SigGearDrive/SigGear-product-docs/data/content/youtube/README.md

# SigGear YouTube content production

The immediate focus is the **micro / miniature / compact planetary gearbox** range (8–42 mm), not an unsupported robot-joint market-positioning claim.

## Prepared, not yet uploaded

- [8–42 mm planetary gearbox series overview — full voiceover, shooting order and metadata](8-42mm-planetary-overview-production-2026-10-14.md)
- [Gearbox Only vs Motor + Gearbox — OEM engineering explainer and follow-on videos](motor-plus-planetary-gearbox-production-2026-10-14.md)

## Truthful release steps

1. Record only real SigGear products, real mechanical details, approved engineering references and genuine manufacturing/inspection footage.
2. Confirm all visible diameter labels against the actual filmed model.
3. Do not imply that a pictured motor has already been validated with a particular gearbox unless the engineering team has confirmed that configuration.
4. Complete the video, subtitles, thumbnail and URL checks; then publish through the actual YouTube channel.
5. Add the **published YouTube video URL** to the production pack and five-channel weekly report. Do not mark scripts as released videos.

Existing GitHub assets and published specifications remain sources of truth; the content packs deliberately do not invent torque values or customer examples.
