SigGearDrive/SigGear-product-docs/data/operations/five-channel-weekly-report-2026-10-14.md

# SigGear five-channel overseas acquisition weekly report — baseline

**Prepared on:** 2026-10-14 · **Reporting week:** 2026-10-05 to 2026-10-11 (Mon–Sun) · **Comparison week:** 2026-09-28 to 2026-10-04 · **Target:** genuine overseas miniature/compact planetary gearbox Design-In inquiries

**Channel scope:** GitHub product docs, Google Search, TraceParts, YouTube, DirectIndustry. Instagram and TikTok have separate operating roles and are not included in this five-channel report.

**Reporting policy:** this channel report follows `data/sales/weekly-attribution-review-sop.yml` and `data/sales/attribution-kpi-schema.yml`. Google search appearance, website sessions, YouTube views, native CAD downloads, and real RFQs are **different funnel stages**. Do not add them as interchangeable 'leads'. Sales qualified projects require a separately verified pipeline record.

## 1. Measured comparison (connected sources)

| Metric | Prior complete week Sep 28–Oct 4 | Complete week Oct 5–11 | Interpretation |
| --- | ---: | ---: | --- |
| Google Search Console impressions (all indexed site pages) | 355 | 32 | The sample is small and site traffic is still strongly influenced by older robot-joint pages; do not infer the effect of recent planetary releases from this short period. |
| Google Search Console clicks | 6 | 4 | Click count did not track the same percentage change as impression count; small data. |
| YouTube video views (whole connected channel) | 6,174 | 821 | Lower channel exposure compared to a week with high-performing robot content; evaluate video/topic differences, not raw volume alone. |
| YouTube subscribers gained | 13 | 2 | Not a proxy for gearbox RFQs. |
| YouTube estimated minutes watched | 681 | 92 | Channel-wide, not planetaries only. |
| GA4 sessions (whole site) | 2 | 1 | Too small to infer a conversion rate. |
| GA4 engaged sessions | 1 | 1 | GA4's engaged-session rules apply; not an inquiry. |

**Source-revision note:** the existing `data/sales/weekly-attribution-review-sop.yml` was captured earlier with **31** impressions for 2026-10-05–11. The **2026-10-14** Search Console connector refresh returned **32** impressions for the same calendar week. This report preserves the latest observed value without rewriting the earlier baseline; Google Search Console can revise recent rows.

**Data connector & accounts:** Windsor.ai `searchconsole`: `https://siggeardrive.github.io/SigGear-product-docs/`; `youtube`: `51467`; `googleanalytics4`: property `547548249` (SigGear Product Documentation). Dates requested explicitly by channel. The latest displayed Search Console/YouTube daily records currently end on 2026-10-11. Data may be revised or delayed by source. The 2026-10-12 to 2026-10-14 activity is therefore not included in the completed-week numerical comparison.

## 2. Five-channel operational scorecard

| Channel | Discovery / usage measured | Acquisition / inquiry evidence | Status as of Oct 14 | Next action |
| --- | --- | --- | --- | --- |
| **GitHub product docs** | GA4 whole-site sessions: **1** in reporting week; **not** a per-product acquisition count | Real qualified gearbox inquiries through the site **not independently verified** | Twelve 8P–42P product pages, datasheets, mechanical reference and public simplified four-stage STEP available; twelve GitHub → exact TraceParts English model links deployed | Keep existing canonical pages stable, fix stale TraceParts wording, and test product-level email/brief CTAs |
| **Google Search** | 32 impressions, 4 clicks in reporting week (whole site) | GSC is discovery, not a received project | 12 planetary model pages indexed/discovered unevenly; brand and legacy robot-intent queries still dominate | Monitor 12 product canonicals and diameter/STEP/gearbox-only search queries; optimize existing pages only after evidence |
| **TraceParts** | 12/12 international English STEP AP203 generation/download **operator QA on Oct 14**, outside reporting-week window | **Native external engineer CAD download volume and identifiable leads unavailable**; do not count operator self-tests as prospects | TraceParts publishing correction email already sent; awaiting staff response for English title taxonomy, outbound GitHub UTM, RFQ/Analytics access | Wait for response, then test actual platform → model GitHub UTM and request native model-level lead report |
| **YouTube** | 821 channel views, 92 minutes and 2 subscribers gained in reporting week | No confirmed YouTube-origin qualified planetary inquiry in available connected data | Authentic gear/robot videos already published; dedicated 8–42 mm overview and motor-matching production packs drafted, **not filmed/uploaded** | Shoot genuine size-lineup overview and one existing-motor selection video; link to specific engineering pages with UTM |
| **DirectIndustry** | No published product pages or listing analytics yet | No DirectIndustry leads because listings not yet launched | Official exhibitor request successfully received Oct 14; waiting for consultant; English drafts for 10P, 20P, 32P, 42P ready | Wait for quote and confirm four-vs-twelve listings, categories, RFQ access and plan terms, without new submission |

## 3. Planetary SEO quality baseline

**Last 28 days queried:** 2026-09-16 to 2026-10-14 (latest Search Console data may lag). The returned GSC `page` rows total 19 pages, with 771 impressions and 19 clicks **among the returned rows**. Exactly three planetary-model URLs appeared in the returned rows:

| Product page | Impressions | Clicks |
| --- | ---: | ---: |
| 42P | 3 | 0 |
| 16P | 1 | 0 |
| 22P | 1 | 0 |

The three returned planetary model pages therefore represent **five observed impressions and zero clicks**. **This does not prove the other nine pages are not indexed.** The query dimension still largely surfaces robotics/joint intent; exact diameter + planetary search terms were not present in the 49 returned query rows. Do not label a missing exact query as a numeric ranking.

## 4. YouTube evidence-based content selection

- In the same 28-day connector window, the real `32mm Planetary Gearbox Internal Structure in Motion` video (`https://www.youtube.com/watch?v=KIzpRMw7r_U`) has **565 views** and **0 reported subscribers gained** in its video row.
- The existing `Inside the SG80-21 Robot Joint Module | Planetary Gear Structure` video (`https://www.youtube.com/watch?v=_gG54yuV28o`) has **3,650 views** and **11 reported subscribers gained**. This is evidence of robot audience attention, **not** evidence those viewers want miniature OEM gearboxes.
- The next video should introduce **8–42 mm miniature/compact planetary gearboxes as an engineering family** with genuine product size reference, public documents, and a clear gearbox-only vs motor-matching route, rather than only promoting a robot joint.
- **Prepared production packs:** `data/content/youtube/8-42mm-planetary-overview-production-2026-10-14.md` and `data/content/youtube/motor-plus-planetary-gearbox-production-2026-10-14.md`. Both are editorial outputs; neither implies a video was actually uploaded.

## 5. Confirmed inquiry and conversion boundaries

- GA4 website sessions, CAD link clicks, `mailto:` preparations and YouTube views **are not confirmed customer requests**.
- TraceParts operator's 12 successful CAD download tests **are not 12 leads**.
- TraceParts native CAD analytics, YouTube external link referrals, and DirectIndustry lead reports remain unverified or unavailable.
- The customer pipeline has not been audited in this report: **qualified leads by these five acquisition channels = not confirmed, not assumed to be zero**.
- Only attribute an inquiry to a channel if platform lead evidence, reliable UTM/referrer, or the customer explicitly confirms how they found SigGear, following `data/sales/attribution-kpi-schema.yml`.

## 6. Next work block (priority)

1. **Film** the real product 8–42 mm overview, prioritizing actual model identification and truthful technical selection; upload with three specified tracked links.
2. **Film** the Motor + Planetary Gearbox existing-motor engineering explainer; link to the canonical motor-matching guide and path-specific inquiry briefs.
3. **Correct** the outdated GitHub series landing-page sentence saying the twelve TraceParts model-specific URL links remain pending; they are now live.
4. **Observe** GSC product-page impressions for the twelve model pages with a consistent date window and latest-data cutoff. No keyword stuffing or duplicate SEO landing pages.
5. **Wait** for TraceParts title/UTM response and DirectIndustry consultant; record their replies once received, without sending duplicate applications.

## Data QA and next reporting run

**Next planned operating review:** after 2026-10-18, compare 2026-10-12–18 to 2026-10-05–11 once platform data has arrived. If GA4 or GSC does not yet expose the full week, mark the partial data explicitly rather than treating zeros as final. The broader formal weekly company meeting summary may use a different user-defined reporting period; this document is specifically for weekly channel metrics.
