SigGearDrive/SigGear-product-docs/docs/applications/optical-imaging-camera-module-gear-motors.md

---
title: Optical, Imaging and Camera Module Gear Motors | SigGear
description: Select compact gear motors for focus, zoom, aperture, filter-wheel, pan-tilt, scanning and sensor-positioning mechanisms by backlash, vibration, noise, speed and feedback requirements.
---

# Optical, Imaging and Camera Module Gear Motors

## Application Overview

Optical, imaging and camera module systems often use compact gear motors and precision transmission components for focus adjustment, zoom movement, aperture control, filter-wheel rotation, shutter mechanisms, pan-and-tilt axes, scanning mechanisms, sensor positioning, lens-cover movement, calibration axes and small inspection-device motion.

These applications usually require compact size, smooth low-speed motion, repeatable positioning, low backlash, low vibration, low acoustic noise and stable operation under intermittent or precision-duty cycles. In many projects, the motor and gearbox must also be reviewed together with optical sensitivity, vibration transfer, cable routing, thermal behavior, dust exposure, outdoor sealing, feedback requirements and production alignment methods.

SigGear can evaluate micro gear motors, compact planetary gearboxes, flat BLDC motors and customized motor/gearbox assemblies for camera modules, imaging instruments, machine-vision devices, inspection equipment, optical readers, sensor modules, security cameras and compact optical mechanisms. Final model selection, optical-system validation, image-quality responsibility and production approval must be confirmed case by case.

## Important Application Boundary

Optical and imaging equipment performance depends on the full optical, mechanical, electronic and software system. This page provides preliminary actuator-selection guidance only.

Unless explicitly confirmed in writing, SigGear does not assume responsibility for:

- Image quality or optical performance
- Autofocus algorithm performance
- Camera calibration accuracy
- Machine-vision inspection accuracy
- Medical imaging validation
- Security-system certification
- Outdoor camera sealing validation
- Full-machine EMC or electrical safety approval
- Full-device environmental qualification
- Final production approval for the customer system

The customer should define the optical performance target, calibration process, vibration sensitivity, operating environment and system-level validation plan before production approval.

## Key Selection Factors

| Requirement | Why it matters |
| --- | --- |
| Motion function | Focus, zoom, aperture, filter wheel, pan-tilt and scanning axes require different torque-speed profiles. |
| Backlash and repeatability | Optical positioning can be sensitive to lost motion and mechanical hysteresis. |
| Vibration and ripple | Motor vibration may affect image stability, focus accuracy or measurement repeatability. |
| Acoustic noise | Camera modules, medical instruments and office devices may require quiet operation. |
| Size and mass | Lens modules, camera heads and compact instruments often have strict envelope limits. |
| Feedback requirement | Encoder, Hall sensor, limit switch, homing switch or current-based detection may be needed. |
| Cable routing | Moving camera heads and gimbals may require controlled cable exit and strain relief. |
| Thermal behavior | Heat near lenses, sensors or optics may affect focus drift or image stability. |
| Dust and environment | Outdoor cameras, inspection stations and optical readers may need dust or moisture review. |
| Production alignment | Custom shafts, mounting tolerances and repeatable assembly affect optical calibration. |

## Common Optical, Imaging and Camera Module Use Cases

### Lens Focus Adjustment

Camera modules, optical readers, microscopes, inspection systems and imaging instruments may use miniature gear motors for lens focus adjustment. Provide lens mass, travel distance, screw pitch or cam geometry, speed, positioning accuracy, backlash target, noise target, vibration sensitivity, homing method and expected duty cycle.

### Zoom Lens Movement

Zoom lenses and variable optical modules may require gear motors to move lens groups, cams, barrels or sliding optical assemblies. Provide lens load, travel range, torque, speed, repeatability target, allowable backlash, operating orientation, cable-routing constraints and whether motion occurs during imaging.

### Aperture, Shutter and Iris Mechanisms

Optical devices may use compact motors for aperture blades, shutter movement, iris control, light blocking, exposure control or protective shutters. Provide rotation angle, required torque, response time, repeatability, noise target, power-off behavior, life-cycle requirement and jam condition.

### Filter Wheel and Optical Selector Mechanisms

Diagnostic readers, imaging instruments, spectrometry devices, inspection systems and optical measurement devices may use gear motors to rotate filter wheels, color wheels, prisms, shutters, mirrors or optical selectors. Provide wheel diameter, inertia, number of positions, indexing accuracy, allowable vibration, speed, homing method and duty cycle.

### Pan, Tilt and Gimbal Axes

Security cameras, machine-vision heads, inspection cameras, sensor pods and compact gimbals may require gearboxes for pan, tilt or limited-angle positioning. Provide camera head mass, center-of-gravity offset, rotation range, speed, acceleration, holding torque, backlash target, cable routing, outdoor exposure and power-off behavior.

### Scanning and Sensor Positioning Mechanisms

Barcode readers, document scanners, laser modules, LiDAR support mechanisms, inspection sensors and positioning devices may use small gear motors to move mirrors, sensors, carriages, sliders or scanning assemblies. Provide travel distance, load, speed profile, repeatability, vibration sensitivity, guide mechanism, feedback method and lifetime cycles.

### Lens Cover, Privacy Shutter and Protective Door Movement

Camera modules, security devices, smart hardware and instruments may use gear motors for lens covers, privacy shutters, protective doors, caps and small service mechanisms. Provide cover weight, hinge geometry, seal force, speed, jam condition, manual override, user safety requirement and power-off position.

## Torque, Speed and Positioning Review

Optical and imaging mechanisms should be reviewed under real assembly conditions. Lens friction, guide preload, cable force, seal friction, tilted operation, shock, transport vibration and temperature changes can affect the required torque and repeatability.

Provide:

- Equipment type and actuator function
- Optical mechanism type
- Required continuous torque
- Required peak torque and peak duration
- Required output speed or motion time
- Stroke length or rotation angle
- Positioning accuracy or repeatability target
- Backlash or lost-motion target
- Load mass and center of gravity
- Screw pitch, cam geometry or gear interface
- Operating orientation
- Jam, stall or end-stop condition
- Motion frequency and duty cycle
- Required lifetime cycles or service hours

When exact load data is not available, provide drawings, CAD models, prototype videos, current curves, manual-force measurements or test data from the existing mechanism.

## Voltage, Current and Control Review

Optical and camera systems may use compact DC power supplies, internal control boards, battery packs or customer-designed drivers. Current limit, position control, noise and thermal behavior should be reviewed together.

Clarify:

- Nominal operating voltage
- Minimum and maximum voltage range
- Peak current limit
- Continuous current limit
- Driver supplied by customer or by SigGear
- Control method
- Required speed control or position control
- Feedback requirement
- Homing or limit-switch method
- Stall or end-stop detection method
- Holding torque or brake requirement
- Cable length and routing limit
- Electrical noise or EMC constraints

Do not assume encoder, brake, closed-loop control, CAN, RS485 or a specific protocol unless it is included in the selected motor and driver configuration.

## Noise, Vibration and Image-Stability Review

Optical systems can be sensitive to motor vibration, torque ripple, gearbox noise, backlash and structural resonance. The acceptable level depends on whether the actuator moves during imaging, before imaging, during calibration or only during service operation.

Define:

- Whether motion occurs during image capture or measurement
- Whether vibration affects image stability or focus accuracy
- Allowable acoustic noise target
- Allowable vibration or motion ripple target
- Required repeatability
- Maximum backlash or lost motion
- Acceleration and deceleration profile
- Whether smooth motion is required
- Mounting stiffness and enclosure resonance
- Heat sensitivity near lens or sensor

Low-noise, low-vibration and image-stability performance should be confirmed by prototype testing in the customer optical system.

## Environment, Dust and Outdoor Exposure Review

Camera and optical devices may operate indoors, outdoors, inside instruments, near dust, near oil mist or in equipment with cleaning requirements. The motor location and enclosure design affect the actuator configuration.

Provide:

- Indoor, outdoor or enclosed-equipment use
- Dust, moisture, condensation or cleaning exposure
- Operating temperature range
- Storage temperature range
- Vibration and shock exposure
- Required ingress protection target
- Cable and connector exposure
- Lens or sensor heat-sensitivity requirement
- Maintenance and replacement plan

The equipment manufacturer should define optical sealing, lens protection, dust control, condensation control, thermal design and environmental validation. SigGear can review motor, gearbox, shaft, cable and connector configuration after the environment is defined.

## Output Shaft, Mounting and Load Support

Optical mechanisms often use custom shafts, pinions, lead screws, worm gears, cams, pulleys, belts, D-cut shafts, miniature flanges and compact brackets. Shaft load, alignment and assembly tolerance should be reviewed early.

Provide:

- Output shaft shape and length
- Gear, pinion, lead screw, worm, cam, pulley, flat, D-cut or custom shaft requirement
- Load direction
- Distance from load point to gearbox face
- Radial and axial load estimates
- Shock, drop or transport-load condition
- Required bearing support
- Flange and mounting hole requirement
- Cable exit direction
- Connector or wire harness requirement
- Assembly tolerance or calibration requirement

External support bearings are recommended when the mechanism creates significant radial load, axial thrust, side load, shock load or belt tension.

## Candidate SigGear Product Families

### Micro Gear Motors

[Micro Gear Motors](../products/micro-gear-motors/index.md) are a starting point for compact focus, zoom, aperture, filter-wheel, shutter, lens-cover and small sensor-positioning mechanisms. SigGear can evaluate miniature planetary gear motors, custom shafts, flanges, cable exits, connectors and optional feedback after engineering review.

### 8-42 mm Planetary Gearboxes

The [8-42 mm planetary gearbox series](../products/planetary-gearboxes/8-42mm-planetary-gear-reducer.md) can be reviewed for compact optical transmission requirements where ratio, torque, size, backlash target and mounting requirements are defined. Final performance depends on frame size, gear stage, material configuration and operating conditions.

### Flat BLDC Motors and Joint Drives

For low-profile camera heads, rotary positioning, compact gimbal axes or limited axial space, [Flat BLDC Motors and Joint Drives](../products/flat-bldc-motors/index.md) may be reviewed together with gearbox or actuator requirements.

## Prototype and Customization Support

Depending on project scope, SigGear can evaluate:

- Gear ratio selection
- Motor and gearbox matching
- Output shaft customization
- Flange and mounting customization
- Cable and connector customization
- Low-voltage motor configuration
- Feedback or sensor integration after review
- Low-noise configuration review
- Low-vibration configuration review
- Low-backlash configuration review
- Customer branding and labeling
- Prototype support before production planning

Optical and imaging projects may require additional review of assembly tolerance, calibration process, vibration transfer, cable routing, production inspection requirements and long-term supply planning.

## Information Needed for Optical, Imaging or Camera Module Review

Please provide one requirement set for each actuator position.

Provide:

- Equipment type and actuator function
- Optical mechanism type
- Prototype, test fixture or production-use target
- Required torque or force
- Peak torque and peak duration
- Required output speed or motion time
- Stroke length or rotation angle
- Positioning accuracy and repeatability target
- Backlash or lost-motion target
- Lens, camera head or sensor load
- Maximum diameter and length
- Operating voltage and current limit
- Driver or control-board responsibility
- Feedback, homing or limit-switch requirement
- Noise and vibration target
- Whether motion occurs during imaging or measurement
- Dust, moisture, outdoor or cleaning exposure
- Operating temperature range
- Shaft, flange and mounting requirements
- Cable exit and connector requirements
- Duty cycle and lifetime target
- Validation, calibration or inspection requirements
- Prototype quantity and estimated annual quantity
- Required customization or OEM branding

## Related Products and Inquiry

[Micro Gear Motors](../products/micro-gear-motors/index.md){ .md-button .md-button--primary }
[8–42 mm Planetary Gearboxes](../products/planetary-gearboxes/8-42mm-planetary-gear-reducer.md){ .md-button }
[Request CAD, Sample and Quote](../request-cad-sample-quote.md){ .md-button }

## Request an Optical, Imaging or Camera Module Gear Motor Review

Send your focus system, zoom module, aperture drive, filter wheel, shutter mechanism, camera pan-tilt axis, sensor-positioning mechanism, scanning assembly, lens-cover device or compact optical actuator requirements to SigGear for preliminary model evaluation. Early requirements can be approximate, but actuator function, torque or force, speed, size, voltage, current limit, precision target, environment, duty cycle, validation boundary and quantity are needed before a meaningful recommendation can be made.

**Wanrong Wang**  
International Sales, SigGear  
[wangwanrong@siggear.com](mailto:wangwanrong@siggear.com)

[Send Optical, Imaging or Camera Module Gear Motor Requirements](../contact.md){ .md-button .md-button--primary }
