SigGearDrive/SigGear-product-docs/docs/applications/semiconductor-electronics-inspection-equipment-gear-motors.md

---
title: Electronics and Inspection Equipment Gear Motors | SigGear
description: Select compact gear motors and planetary gearboxes for electronics manufacturing, inspection, AOI, test fixtures and small positioning mechanisms by torque, speed, backlash, vibration and duty cycle.
---

# Semiconductor, Electronics and Inspection Equipment Gear Motors

Semiconductor, electronics manufacturing and inspection equipment often uses compact gear motors for controlled feeding, indexing, focusing, fixture adjustment and small-axis positioning. These applications usually require stable motion, compact packaging, low vibration and predictable behavior during repeated production cycles.

SigGear supports engineering review for miniature planetary gear motors, precision gearboxes and compact actuator solutions used in electronics production equipment, inspection fixtures, test instruments and automated handling mechanisms. Final motor, gearbox and interface selection should be confirmed based on load, speed, accuracy, duty cycle, environmental conditions and validation requirements.

## Where Gear Motors Are Used

### PCB Handling and Conveyor Adjustment

Electronics production lines may use compact gear motors for PCB edge conveyors, guide-rail width adjustment, board transfer mechanisms, stop pins, gates, lifts and small indexing modules.

Typical selection factors include:

- Board size and weight
- Conveyor speed or transfer cycle time
- Guide-rail adjustment stroke
- Synchronization with sensors or upstream equipment
- Jam behavior during misfeed or board contact
- Duty cycle during production shifts
- Available space around the conveyor frame

For guide-rail and width adjustment, holding torque, backlash, end-stop behavior and manual adjustment requirements should be reviewed together.

### AOI, Vision Inspection and Camera Positioning

Automated optical inspection systems, vision stations and compact inspection cells may use gear motors for camera focus, lens movement, lighting angle adjustment, mirror movement, filter wheels, turntables and small pan-and-tilt axes.

Important factors include:

- Repeatability of the inspection position
- Backlash and lost motion
- Vibration during image capture
- Motor noise in laboratory or office environments
- Position feedback requirements
- Cable routing around camera or light modules
- Thermal influence on optical stability

For image-sensitive systems, the motor and gearbox should be evaluated together with the optical module, mounting stiffness and control profile.

### Probe, Test Fixture and Contact Mechanisms

Electronics test equipment may use small gear motors for fixture movement, probe height adjustment, contact pressure control, connector insertion assistance, tray clamping and test socket actuation.

Selection should consider:

- Contact force or fixture force
- Motion speed before and after contact
- Repeatable stopping behavior
- Peak load during connector engagement
- Risk of over-travel or product damage
- Whether position feedback, current sensing or torque limiting is required
- Service life under repeated test cycles

Gear motors for test fixtures should be validated with the real probe, spring, connector or clamping mechanism.

### Tray, Carrier and Pallet Movement

Compact gear motors can be used in tray loaders, carrier transfer systems, small pallet shuttles, magazine mechanisms, feeder modules and sample holders.

Key factors include:

- Tray mass and center of gravity
- Stroke length or rotation angle
- Acceleration and deceleration profile
- Guide rail friction
- Impact at mechanical stops
- Required holding force
- Position repeatability after each cycle

If the tray or pallet carries valuable parts, the system should include suitable mechanical stops, limit detection and safe recovery logic.

### Wafer, Component and Small-Part Handling Support

Some semiconductor and electronics equipment uses compact motion axes to assist non-critical handling, cover movement, shield adjustment, sensor positioning, small valves, shutters, holders or auxiliary mechanisms.

For semiconductor-adjacent projects, qualification boundaries must be clear. Cleanliness, particle generation, vacuum compatibility, chemical exposure, static electricity control and process validation are application-level responsibilities unless they are specifically defined and reviewed in the engineering specification.

### Laser, Marking and Dispensing Equipment

Laser marking, solder paste dispensing, adhesive dispensing, conformal coating and small production tools may use gear motors for shutter movement, nozzle positioning, platform indexing, cover actuation, focus adjustment and fixture rotation.

Important factors include:

- Motion smoothness during positioning
- Repeatability before process execution
- Heat exposure near the process zone
- Dust, fumes, adhesive or solvent exposure
- Speed required between process stations
- Holding torque during marking or dispensing
- Maintenance access after contamination

### Laboratory Electronics and R&D Fixtures

R&D benches, small test rigs and laboratory fixtures often need compact gear motors for repeatable motion without building a full industrial servo axis.

Typical examples include:

- Small rotary stages
- Sensor positioning fixtures
- Connector durability testers
- Miniature endurance test rigs
- Adjustable camera or light brackets
- Prototype handling mechanisms
- Compact automated measurement tools

For these cases, the first evaluation should focus on load, movement cycle, positional tolerance, required life and available mounting space.

## Gear Motor Selection Priorities

### Smooth Low-Speed Motion

Inspection and test equipment often moves slowly to protect components and improve positioning control. The gearbox ratio, motor speed range and controller profile should support stable low-speed movement without excessive vibration or stall risk.

### Backlash and Repeatability

Backlash directly affects focus adjustment, fixture position, indexing and measurement repeatability. The acceptable backlash depends on mechanism geometry and should be translated into output shaft or end-effector tolerance.

### Low Vibration

Vibration can affect camera images, laser alignment, probe contact and small-part placement. Motor mounting, gearbox precision, load inertia and acceleration profile should be reviewed as a system.

### Low Noise

Inspection equipment, desktop test devices and laboratory instruments may operate near engineers or operators. Noise expectations should be described using the actual working distance, duty cycle and enclosure conditions.

### Compact Packaging

Electronics equipment often has tight internal layouts. Selection should consider motor diameter, gearbox length, wire exit direction, connector location, mounting holes, shaft length and available service space.

### Duty Cycle and Heat

Production equipment may run continuously or with frequent indexing cycles. Thermal review should include load torque, operating speed, ambient temperature, enclosure airflow and stop-hold conditions.

### Stall, Jam and End-Stop Behavior

Small mechanisms may encounter misfed boards, stuck trays, closed covers or incorrect operator loading. The design should define stall current, current limit, timeout, torque limit and recovery behavior.

### Feedback and Control

Depending on the axis, a simple DC gear motor may be sufficient, or the system may need encoder feedback, limit switches, hall sensors, current sensing or closed-loop speed and position control.

## Product Family Mapping

### Micro and Small Planetary Gear Motors

Small planetary gear motors are commonly considered for compact electronics fixtures, inspection modules and small adjustment axes where diameter, output speed and packaging are important.

Possible review points:

- 8 mm to 42 mm gearbox diameter range
- Ratio and output speed target
- Shaft type and mounting interface
- Encoder or sensor requirement
- Expected production quantity

Relevant product pages:

- [8-42 mm planetary gear reducer series](../products/planetary-gearboxes/8-42mm-planetary-gear-reducer.md)
- [8P planetary gearbox](../products/planetary-gearboxes/8p-planetary-gearbox.md)
- [10P planetary gearbox](../products/planetary-gearboxes/10p-planetary-gearbox.md)
- [12P planetary gearbox](../products/planetary-gearboxes/12p-planetary-gearbox.md)
- [16P planetary gearbox](../products/planetary-gearboxes/16p-planetary-gearbox.md)
- [20P planetary gearbox](../products/planetary-gearboxes/20p-planetary-gearbox.md)

### Larger Planetary Gearboxes

For conveyor adjustment, tray handling, pallet movement or heavier fixture actuation, larger planetary gearboxes may be considered when higher torque or stronger shaft support is needed.

Review items include:

- Required continuous torque
- Peak torque during jam or acceleration
- Radial and axial load on the output shaft
- Output speed and duty cycle
- Gearbox mounting orientation
- Manual override or brake requirement

### Precision Gearbox and Custom Interface Options

Some inspection and electronics mechanisms need a custom shaft, flange, gear interface, pulley interface, lead-screw coupling or compact mounting arrangement. Customization should be reviewed with drawings and expected quantity.

Custom review may include:

- Output shaft diameter and flat/D-cut/keyway requirements
- Mounting hole pattern
- Gear, pulley or lead-screw interface
- Encoder mounting
- Wire harness and connector direction
- Material and surface treatment requirements
- Noise and backlash target

## Application Review Checklist

Please provide the following information for engineering review:

- Equipment type and axis function
- Required output torque
- Peak torque and peak duration
- Output speed or motion time
- Rotation angle, stroke or travel range
- Required positioning accuracy and repeatability
- Backlash tolerance at the output or end effector
- Load mass, friction and guide mechanism
- Radial and axial load on the output shaft
- Duty cycle and expected service life
- Operating voltage and available current
- Encoder, sensor or limit switch requirements
- Controller type and communication requirements
- Ambient temperature and enclosure conditions
- Exposure to dust, flux, adhesive, solvent, heat or process fumes
- Maximum motor diameter, length and weight
- Prototype quantity and estimated annual volume

## Semiconductor and Clean-Process Boundary

If the gear motor will be used near semiconductor process equipment, please specify the process location and environmental requirements. Cleanroom grade, particle generation, outgassing, vacuum compatibility, ESD control, chemical resistance and process safety requirements must be reviewed explicitly.

SigGear can support mechanical and transmission selection, but final qualification for semiconductor or clean-process equipment must be completed by the equipment manufacturer according to the full system requirements.

## Common RFQ Examples

### PCB Conveyor Width Adjustment

A customer may need a compact motorized guide-rail adjustment module for different PCB widths. The key information is rail load, screw pitch, required adjustment speed, holding requirement, limit switch design and available motor space.

### AOI Camera Focus Adjustment

A customer may need a small low-vibration gear motor for camera focus or lens positioning. The key information is travel range, repeatability, backlash tolerance, speed, noise target and whether encoder feedback is required.

### Test Fixture Clamp Actuation

A customer may need a motorized clamp or probe contact mechanism. The key information is clamping force, contact stroke, peak load, cycle time, product protection logic and required service life.

### Tray Indexing Module

A customer may need a small gear motor to rotate or move a tray between inspection positions. The key information is tray mass, inertia, indexing angle, position tolerance, acceleration profile and holding torque.

## Related Application Pages

- [Industrial automation servo planetary gearboxes](./industrial-automation-servo-planetary-gearboxes.md)
- [Precision instruments and optical mechanisms](./precision-instruments-optical-mechanisms.md)
- [Optical, imaging and camera module gear motors](./optical-imaging-camera-module-gear-motors.md)
- [Laboratory automation and diagnostic equipment gear motors](./laboratory-automation-diagnostic-equipment-gear-motors.md)
- [Packaging, labeling and conveyor gear motors](./packaging-labeling-conveyor-gear-motors.md)
- [Micro robotics gear motors](./micro-robotics-gear-motors.md)

## Contact

For semiconductor, electronics manufacturing and inspection equipment gear motor selection, please send your drawings, load requirements, target speed, accuracy requirements and expected quantity to [Wanrong Wang](../contact.md).

You can also include the axis function, available space, duty cycle, environmental exposure and validation requirements so that the engineering review can match the motor, gearbox, shaft and mounting interface more accurately.
