SigGearDrive/SigGear-product-docs/docs/applications/precision-instruments-optical-mechanisms.md

---
title: Precision Instrument Gear Motors and Optical Mechanism Drives | SigGear
description: Select gear motors and compact planetary gearboxes for precision instruments and optical mechanisms by torque, speed, backlash, repeatability, vibration, feedback and shaft-load requirements.
---

# Gear Motors for Precision Instruments and Optical Mechanisms

## Application Overview

Precision instruments, optical systems, inspection equipment and laboratory positioning platforms often use compact geared motion for focus adjustment, zoom mechanisms, filter wheels, rotary stages, pan-and-tilt axes, aperture control, sensor positioning and small indexing mechanisms. A precision instrument gearbox or optical adjustment actuator should be selected from the complete motion system, not from torque or size alone.

These applications often require smooth low-speed motion, repeatable positioning, low backlash, low vibration, low acoustic noise and predictable behavior after direction reversal. The completed mechanism depends on the motor, gearbox, encoder, bearings, preload, structure, calibration method and control system working together.

SigGear supplies micro gear motor, miniature planetary gearbox and flat BLDC motor solutions that can be evaluated for precision instrument and optical mechanism projects. Final motor, reduction ratio, shaft, bearing, feedback and mounting configurations are confirmed after engineering review.

This page is intended for early-stage supplier comparison, model shortlisting and engineering communication. Final selection, quotation and technical agreement require confirmation against the approved drawing, selected ratio, load condition, motion profile, feedback architecture and ordered version.

## Key Selection Factors for Precision Motion

| Requirement | Why it matters |
| --- | --- |
| Motion function | Focus, zoom, aperture, filter-wheel and rotary-stage mechanisms have different torque-speed cycles. |
| Travel range and resolution | Defines gear ratio, encoder requirement, limit strategy and control method. |
| Positioning accuracy | Depends on the complete mechanical and control stack, not only gearbox backlash. |
| Repeatability and settling | Important for imaging, inspection, optical alignment and sensor pointing. |
| Backlash and reversal | Direction changes can affect final position, focus repeatability and indexing behavior. |
| Radial, axial and overturning loads | Pulleys, belts, cams, screws and lens groups can overload output bearings. |
| Noise and vibration | Important for imaging stability, laboratory environments and human-facing instruments. |
| Duty cycle and environment | Temperature, humidity, clean conditions and operation frequency affect reliability. |
| Feedback and homing | Encoder location, limit switches and homing strategy determine completed-system behavior. |

## Common Precision Instrument and Optical Use Cases

### Lens Focus Actuators

Lens focusing mechanisms may require smooth low-speed motion, precise position control, low backlash and minimal vibration. Provide lens group mass, guide friction, preload, travel distance, focusing speed, required repeatability and whether motion is one-directional or frequently reversed.

### Zoom and Optical Adjustment Mechanisms

Zoom and optical adjustment mechanisms may use cams, lead screws, belts or gear trains. The motor and gearbox must be reviewed with the complete optical mechanism because preload, friction, sealing and cable forces can change the required torque and speed.

### Filter Wheels and Aperture Drives

Filter wheels, aperture drives and shutter-related mechanisms often require repeatable indexing, compact size, low noise and predictable stopping behavior. Provide the number of positions, indexing angle, inertia, target move time, holding requirement and homing or index detection method.

### Rotary Stages and Small Positioning Axes

Compact rotary stages and small positioning axes may require high repeatability, smooth reversal, low vibration and support for radial or axial loads. If the customer mechanism applies cantilevered load, an external bearing or support structure may be needed.

### Pan-and-Tilt and Sensor Pointing Mechanisms

Pan-and-tilt units, inspection sensors and small pointing mechanisms require a balance between torque, speed, backlash, vibration, cable routing and holding behavior. Provide payload mass, center of gravity, required pointing accuracy, wind or external load if applicable, and whether a brake or holding mode is required.

## Motion Function and Travel Range

Describe the mechanism and required motion, including rotary or linear travel, operating angle, number of turns, indexing positions, end stops and homing method. The transmission should be selected from the complete motion sequence rather than a single speed or torque value.

Useful information includes:

- Rotary angle, stroke or travel distance
- Number of indexing positions
- Required move time
- Required speed range
- Acceleration and deceleration profile
- One-way or bidirectional operation
- End-stop, limit-switch or homing method
- Required position after power cycle

## Torque, Speed and Ratio Selection

Provide continuous torque, peak torque, peak duration, rated speed, maximum speed, acceleration, deceleration and cycle time at the gearbox output. Friction, preload, seals, cable forces and external mechanisms must be included in the load estimate.

A higher reduction ratio may improve available output torque and low-speed controllability, but it can reduce output speed and may affect efficiency, backdrivability, backlash behavior and acoustic noise. Final ratio selection should be based on the complete mechanism and operating profile.

Peak torque and peak current should not be treated as continuous working ratings.

## Positioning Accuracy, Repeatability and Backlash

State the required positioning accuracy, repeatability, angular resolution and settling behavior of the completed mechanism. Gearbox backlash is only one contributor. Encoder location, structural stiffness, bearing clearance, preload, controller tuning and assembly tolerances must also be evaluated.

For direction-reversal applications, specify:

- Whether motion reverses every cycle or mainly moves in one direction
- Allowable lost motion after reversal
- Whether software backlash compensation is acceptable
- Whether the mechanism is preloaded
- Whether the encoder is placed on the motor side or output side
- Required final accuracy at the optical element, sensor or payload

Do not transfer backlash, repeatability or noise values from one gearbox size, ratio or stage configuration to another without confirmation.

## Radial, Axial and Overturning Load Review

Provide pulley, gear, belt, lead-screw, lens-group or platform loads acting on the output shaft. Radial load, axial load and overturning moment must be reviewed separately from output torque.

Important details include:

- Output shaft load direction
- Distance from load point to bearing support
- Belt or pulley tension
- Gear mesh force
- Lead-screw thrust load
- Lens group or platform weight
- Whether external bearings support the mechanism

External bearings may be required when the customer mechanism places significant cantilevered load on the gearbox output.

## Noise, Vibration and Image Stability

For imaging, sensing or laboratory systems, provide the acoustic target and any vibration or image-stability requirement. Noise and vibration depend on the motor, gearbox, ratio, speed, load, mounting structure and controller.

Important review items include:

- Target noise level or comparison reference
- Measurement distance and operating condition
- Allowed vibration or image-shift behavior
- Motor speed and gearbox output speed
- Mounting stiffness and enclosure design
- Controller tuning and current waveform
- Whether motion happens during image capture or only between measurements

Configuration-specific test data is required before a numeric noise, vibration or image-stability claim is made.

## Encoder, Limit and Homing Requirements

Confirm whether the system requires motor commutation feedback, output-position feedback, incremental or absolute position sensing, limit switches, index marks or a homing routine. Feedback options depend on the selected motor and mechanical configuration.

Clarify:

- Open-loop or closed-loop control
- Motor-side or output-side feedback
- Hall sensor, incremental encoder or absolute encoder requirement
- Home position and index requirement
- Limit switch or mechanical stop strategy
- Required behavior after power loss
- Driver or customer-side controller responsibility

Control and communication functions must be confirmed for the selected driver and firmware version when a driver is included.

## Candidate SigGear Product Families

### Micro Gear Motors

SigGear micro gear motor configurations can be evaluated for focus mechanisms, filter wheels, aperture drives, compact rotary stages, sensor positioning and small inspection mechanisms.

[Explore micro gear motors](../products/micro-gear-motors/index.md)

### 8–42 mm Planetary Gearboxes

The [8–42 mm planetary gearbox](../products/planetary-gearboxes/8-42mm-planetary-gear-reducer.md) series provides multiple frame sizes for integration with brushed DC, brushless DC, stepper, servo or customer-specified motors. Final ratios, dimensions and performance values depend on the selected size and configuration.

### Flat BLDC Motors

SigGear flat BLDC motor configurations can be evaluated for compact optical mechanisms, thin rotary stages and customer-designed gearmotor assemblies when the project requires a low-profile motor form factor.

[Explore flat BLDC motors](../products/flat-bldc-motors/index.md)

## Duty Cycle, Environment and Clean Operation

Provide operating time, rest time, start-stop frequency, ambient temperature, contamination exposure, humidity, vacuum or clean-environment requirements and the proposed cooling method.

Do not assume the following unless documented for the selected configuration and project scope:

- Vacuum compatibility
- Cleanroom suitability
- Low-particle performance
- Specific lubricant compatibility
- Special material compatibility
- High-humidity or chemical resistance
- Low-temperature or high-temperature operation outside approved limits

The equipment designer should define whether the drive is inside the sensitive optical path, enclosed in a separate compartment, or isolated from clean or vacuum zones.

## Precision-Performance Boundary

A motor or gearbox component does not by itself establish the positioning accuracy, repeatability, resolution, vibration performance or image stability of the completed instrument. The equipment designer must evaluate the complete mechanical stack, encoder arrangement, bearings, structure, calibration method, control system and operating environment.

Specifications from one gearbox diameter, ratio or stage configuration must not be transferred to another without confirmation. Detailed backlash, noise, life, efficiency and load information is supplied according to the selected configuration and available supporting data.

## Prototype and Customization Support

Depending on project requirements and engineering feasibility, SigGear can evaluate:

- Motor and planetary gearbox matching
- Flat BLDC motor and gearbox integration review
- Reduction-ratio selection
- Output-shaft and mounting-interface customization
- Encoder, brake, cable and connector options
- External-bearing and mechanical-support requirements
- Low-noise configuration review after testing
- Customer branding and labeling
- Prototype support before production planning

Customization availability depends on technical feasibility, prototype quantity, expected annual volume and the level of engineering change required.

## Information Needed for a Precision Motion Selection Review

Please provide one requirement set for each axis or optical mechanism.

Provide:

- Instrument type and target application
- Motion function: focus, zoom, filter wheel, aperture, rotary stage, pan-and-tilt or other
- Travel range, stroke, angle or number of index positions
- Continuous torque, peak torque and peak duration
- Required output speed, acceleration and move time
- Operating voltage and current limit
- Maximum diameter, length and weight
- Shaft, mounting and cable requirements
- Radial load, axial load and overturning moment
- Positioning accuracy, repeatability and resolution targets
- Backlash and reversal requirements
- Encoder, limit switch and homing requirements
- Noise, vibration or image-stability target
- Duty cycle and ambient condition
- Clean, vacuum, humidity or material restrictions
- Prototype quantity and estimated annual quantity

## Related Products and Inquiry

[Micro Gear Motors](../products/micro-gear-motors/index.md){ .md-button .md-button--primary }
[8–42 mm Planetary Gearboxes](../products/planetary-gearboxes/8-42mm-planetary-gear-reducer.md){ .md-button }
[Request CAD, Sample and Quote](../request-cad-sample-quote.md){ .md-button }

## Request a Precision Motion Selection Review

Send your precision instrument or optical mechanism requirements to SigGear for preliminary model evaluation. Early requirements can be approximate, but motion function, travel range, torque, speed, size, feedback, noise or vibration target, environment and quantity are needed before a meaningful recommendation can be made.

**Wanrong Wang**  
International Sales, SigGear  
[wangwanrong@siggear.com](mailto:wangwanrong@siggear.com)

[Send Precision Instrument Requirements](../contact.md){ .md-button .md-button--primary }
