SigGearDrive/SigGear-product-docs/docs/applications/smart-hardware-gear-motors.md

# Smart Hardware Gear Motors and Compact Device Actuators

## Application Overview

Smart hardware products often need compact gear motors for controlled movement, locking, dispensing, adjustment, lifting, rotation, gripping or small automation tasks. Typical examples include smart locks, smart cabinets, compact appliances, vending and dispensing mechanisms, camera or sensor adjustment, smart curtains or blinds, access-control devices, IoT hardware and small mechatronic modules.

A smart hardware gear motor should be selected from the complete device mechanism rather than motor diameter or voltage alone. The actuator, reducer, shaft, linkage, load direction, controller, battery, enclosure, noise requirement, duty cycle and production plan all affect whether a miniature gear motor can be used reliably.

SigGear can evaluate micro gear motors, compact planetary gearboxes, flat BLDC motors and motor-integration options for smart hardware and compact device motion. Final model selection, torque rating, speed range, shaft interface, feedback option, noise level and service-life expectation must be confirmed against the selected configuration and application review.

## Key Selection Factors

| Requirement | Why it matters |
| --- | --- |
| Device function | Locking, lifting, dispensing, rotation and adjustment mechanisms need different torque-speed profiles. |
| Size envelope | Smart devices often have strict limits for motor diameter, length, cable exit and connector space. |
| Output torque | Must be defined at the mechanism output, including friction, spring force, seal load or latch force. |
| Output speed | Determines user experience, cycle time, noise and current draw. |
| Power source | Battery-powered devices require careful voltage, current, standby and peak-load review. |
| Noise and vibration | Home, office, medical and consumer devices often require quieter operation. |
| Holding behavior | Locks, clamps, covers and lifting axes may need holding torque, self-locking design or brake review. |
| Feedback requirement | Encoders, Hall sensors, limit switches or homing sensors may be needed for position confirmation. |
| Duty cycle | Consumer devices may cycle occasionally; dispensing and automation devices may cycle repeatedly. |
| Custom interface | Output shaft, flange, keyway, cable, connector and label requirements affect feasibility and MOQ. |

## Common Smart Hardware Use Cases

### Smart Locks and Access-Control Mechanisms

Smart locks, latch drives and access-control mechanisms require enough torque to overcome latch friction, spring force, misalignment and environmental variation. Provide latch force, stroke or rotation angle, cycle time, power-off behavior, battery voltage, noise target and expected lifetime cycles.

### Smart Cabinets, Doors and Covers

Cabinet locks, electric covers, small doors and sliding mechanisms may require compact gear motors with controlled travel, holding behavior and low noise. Provide load weight, travel distance, linkage geometry, closing force, speed requirement and whether manual override is needed.

### Smart Curtains, Blinds and Adjustment Devices

Curtain, blind, vent and adjustment mechanisms require torque, speed and duty-cycle review based on load weight, friction, pulley diameter and cycle time. Provide moving mass, travel distance, drum or pulley diameter, target speed, installation direction and available voltage.

### Vending, Dispensing and Small Feed Mechanisms

Smart vending, reagent dispensing, capsule feeding, pill handling, sample feeding and small product-release mechanisms require repeatable motion and stall or jam consideration. Provide product weight, friction, feed wheel or screw geometry, required cycle time, jam condition and sensor feedback requirement.

### Camera, Sensor and Optical Adjustment

Smart devices may use small actuators for camera tilt, sensor positioning, shutter movement, lens adjustment or compact pan-and-tilt mechanisms. Backlash, repeatability, vibration and cable routing can be more important than maximum torque.

### Compact Appliances and IoT Hardware

Small household appliances, service devices and IoT hardware may use gear motors for valves, covers, stirrers, locks, lifts, rotation or adjustment axes. Define whether the motion is user-facing, silent, high-cycle, battery-powered or exposed to dust, humidity or cleaning conditions.

## Torque, Speed and Mechanism Review

Smart hardware actuator selection should begin with the mechanism requirement. Motor power alone is not enough because the real load may come from friction, spring force, seals, latch geometry, gravity, cable tension, belt tension or user interaction.

Provide:

- Device type and actuator function
- Required output torque or force
- Peak torque and peak duration
- Required output speed
- Stroke length or rotation angle
- Gear ratio if already specified
- Mechanism drawing or linkage dimensions
- Spring, latch, seal or friction load
- Battery voltage or power supply voltage
- Current limit and standby-power requirement

When torque is not known, provide drawings, estimated forces, measured current data or prototype videos so the requirement can be reviewed.

## Size, Noise and User Experience

Smart hardware often has visible or audible movement. The actuator should be checked together with the device shell, bracket, mounting screws, coupling, shaft, cable, connector, acoustic path and user-touch surface.

Provide:

- Maximum motor plus gearbox diameter
- Maximum motor plus gearbox length
- Maximum weight
- Shaft location and orientation
- Cable exit direction
- Connector size and location
- Mounting hole pattern
- Noise target and measurement distance if available
- Vibration sensitivity
- Expected user interaction distance

Noise depends on motor type, gear ratio, load, speed, mounting structure, enclosure resonance and controller method. Noise targets must be confirmed under the selected configuration and device condition.

## Battery, Current and Thermal Review

Battery-powered smart devices must balance peak torque, startup current, standby behavior, heat and battery life. A motor that can meet torque requirements may still be unsuitable if the current draw is too high for the battery or driver.

Useful information includes:

- Battery voltage and chemistry
- Driver current limit
- Peak current limit
- Allowed operating time per cycle
- Number of cycles per day
- Standby-power requirement
- Enclosed or ventilated installation
- Ambient temperature
- Thermal limit near plastic parts or batteries

Duty cycle and current limits should be reviewed before confirming a model.

## Feedback, Homing and Safety Behavior

Some smart hardware can run open-loop, while others need end-position confirmation, stall detection, position feedback or homing. This should be defined before selecting the motor and electronics.

Clarify:

- Open-loop or closed-loop control
- Encoder or Hall sensor requirement
- Limit switch or homing method
- Stall detection requirement
- Jam recovery requirement
- Power-off behavior
- Manual override requirement
- Position confirmation requirement
- Controller supplied by customer or by SigGear

Do not assume encoder, brake, closed-loop control, CAN, RS485 or another protocol unless it is included in the selected motor and driver configuration.

## Output Shaft, Mounting and Load Support

Small gear motors should not be used as structural bearings unless output-load conditions have been reviewed. Latches, cams, gears, belts, pulleys and levers can create radial load, axial load or overturning moment.

Provide:

- Output shaft shape and length
- D-cut, keyway, flat, spline or gear requirement
- Flange and mounting hole requirement
- Load direction
- Distance from load point to gearbox face
- Gear, pulley, cam or lever geometry
- External bearing or support method
- Shock, jam or impact condition

External support bearings are recommended when the mechanism creates significant radial, axial or cantilevered load.

## Candidate SigGear Product Families

### Micro Gear Motors

[Micro Gear Motors](../products/micro-gear-motors/index.md) are a primary starting point for smart locks, dispensing systems, compact appliances, adjustment devices and IoT hardware actuators. SigGear can evaluate miniature planetary gear motors, compact reduction motors, motor and gearbox integration, custom output shafts, flanges and mounting interfaces, and optional encoder or cable integration after engineering review.

### 8–42 mm Planetary Gearboxes

The [8–42 mm planetary gearbox series](../products/planetary-gearboxes/8-42mm-planetary-gear-reducer.md) provides compact reducer options for different frame sizes. Final ratio, torque, efficiency, backlash and dimensions depend on the selected frame size, gear stage and configuration.

### Flat BLDC Motors and Joint Drives

For low-profile smart devices, thin rotary mechanisms or compact axial packaging, [Flat BLDC Motors and Joint Drives](../products/flat-bldc-motors/index.md) may be reviewed together with gearbox or actuator requirements when the application needs a slim drive envelope.

## Prototype and Customization Support

Depending on the project scope, SigGear can evaluate:

- Gear ratio selection
- Motor and gearbox matching
- Output shaft customization
- Flange and mounting customization
- Cable and connector customization
- Encoder or sensor integration after review
- Low-noise configuration review
- Customer branding and labeling
- Prototype support before production planning

Customization availability depends on engineering feasibility, prototype quantity, estimated annual volume and tooling or process requirements.

## Information Needed for a Smart Hardware Gear Motor Review

Please provide one requirement set for each actuator position.

Provide:

- Device type and actuator function
- Required output torque or force
- Peak torque and peak duration
- Required output speed
- Stroke length or rotation angle
- Gear ratio if known
- Maximum diameter and length
- Operating voltage and current limit
- Battery information if applicable
- Motor type preference
- Shaft, flange and mounting requirements
- Feedback, homing or limit-switch requirements
- Noise and vibration target
- Duty cycle and daily operating time
- Power-off and manual-override requirements
- Prototype quantity and estimated annual quantity
- Required customization or OEM branding

## Request a Smart Hardware Gear Motor Review

Send your smart hardware actuator requirements to SigGear for preliminary model evaluation. Early requirements can be approximate, but torque or force estimate, speed, size, voltage, duty cycle, shaft interface, control requirement, environment and quantity are needed before a meaningful recommendation can be made.

**Wanrong Wang**  
International Sales, SigGear  
[wangwanrong@siggear.com](mailto:wangwanrong@siggear.com)

[Send Smart Hardware Gear Motor Requirements](../contact.md){ .md-button .md-button--primary }
