SigGearDrive/SigGear-product-docs/index.md

## Products

SigGear provides compact precision reducers, planetary gearboxes, cycloidal robotic joint modules, and micro gear motor solutions for robotics, automation, medical devices, lab automation, optical equipment, and compact motion systems.

| Product | Type | Suitable Applications |
| --- | --- | --- |
| [6-42mm Planetary Gear Reducer](6-42mm-planetary-gear-reducer.md) | Miniature and compact planetary gear reducer series | Micro robotics, medical devices, lab automation, optical equipment, servo drives, compact automation |
| [CPM100-25](CPM100-25.md) | Compact cycloidal robotic joint module | Humanoid robot joints, quadruped robot joints, robot arms, high-torque compact actuators |
| [CPM80-25](CPM80-25.md) | Compact cycloidal robotic joint module | Smaller robot joints, quadruped robot joints, compact robotic actuators |
| [SG6010C](SG6010C.md) | Compact precision drive solution | Compact motion systems, robotic mechanisms, automation equipment |
| [SG8021](SG8021.md) | Precision drive solution | Robot joints, automation equipment, compact motion systems |

## Featured Product: 6-42mm Planetary Gear Reducer

SigGear 6-42mm planetary gear reducers are designed for compact motion systems that require small size, stable output torque, low noise, flexible reduction ratios, and easy motor integration.

The series includes miniature and compact planetary gearbox options such as 6P, 8P, 10P, 12P, 14P, 16P, 20P, 22P, 24P, 28P, 32P, 36P, and 42P.

Typical applications include:

* Micro robotics
* Small robotic grippers
* Medical devices
* Laboratory automation
* Optical adjustment systems
* Precision instruments
* Smart hardware
* Compact actuators
* Servo drive modules
* Industrial automation mechanisms

[View 6-42mm Planetary Gear Reducer](6-42mm-planetary-gear-reducer.md)

## Applications

SigGear provides compact precision drive solutions for robotic joints, micro motion systems, mobile robots, and industrial automation.

| Application | Recommended Solutions |
| --- | --- |
| [6mm Micro Gear Motor for Micro Robotics](Applications/micro-robotics-gear-motor.md) | 6-42mm planetary gear reducers, miniature gear motors, compact drive solutions |
| [AGV / AMR Wheel Drive Gearbox](Applications/agv-amr-wheel-drive-gearbox.md) | Planetary gearboxes, compact drive modules, customized wheel drive solutions |
| [Robot Arm Joint Gearbox](Applications/robot-arm-joint-gearbox.md) | Compact cycloidal reducers, robotic joint modules, precision drive solutions |
| [Quadruped Robot Joint Gearbox](Applications/quadruped-robot-joint-gearbox.md) | Compact cycloidal robotic joint modules, high-torque robotic actuators |
| [Cycloidal Reducer for Humanoid Robot Joints](Applications/humanoid-robot-joint-reducer.md) | CPM100-25, CPM80-25, compact robotic joint drive solutions |
- [Micro Gear Motor for Medical Devices](Applications/medical-device-micro-gear-motor.md)
- [Robot Gripper Gear Motor](Applications/robot-gripper-gear-motor.md)
- [Servo Motor Planetary Gearbox](Applications/servo-motor-planetary-gearbox.md)

## Selection Guides

- [Robot Joint Gearbox Selection Guide](Selection-Guides/robot-joint-gearbox-selection-guide.md)
- [Micro Gear Motor Selection Guide](Selection-Guides/micro-gear-motor-selection-guide.md)
- [Planetary Gearbox Selection Guide](Selection-Guides/planetary-gearbox-selection-guide.md)

##  Comparisons:
 - [Cycloidal Reducer vs Harmonic Drive](Comparisons/cycloidal-vs-harmonic-drive.md)

## Engineering Resources

SigGear supports engineers with product documentation, CAD models, and developer resources for faster evaluation and prototype development.

* [CAD Models](https://github.com/SigGearDrive/SigGear-cad-models)
* [Product Documents](https://github.com/SigGearDrive/SigGear-product-docs)
* [Robot Joint SDK](https://github.com/SigGearDrive/SigGear-robot-joint-sdk)
* [ROS2 Resources](https://github.com/SigGearDrive/SigGear-ros2)

## Request CAD, Datasheet, or Sample

If you are developing robotics, automation equipment, compact actuators, medical devices, lab automation systems, or precision motion products, contact SigGear to request drawings, datasheets, CAD models, or sample support.

Please include your application, reducer size, gear ratio, torque, speed, motor type, shaft design, mounting method, and estimated annual quantity.

**Email:** [wangwanrong984@gmail.com](mailto:wangwanrong984@gmail.com)
