SigGearDrive/SigGear-product-docs/SG8021.md

# SG8021 Planetary Robotic Joint Module

SG8021

## Overview

SG8021 is a high-performance robotic joint actuator designed for humanoid robots, quadruped robots and industrial robotic systems.

The module combines:

* Planetary Gear Transmission
* High Torque BLDC Motor
* Integrated Driver
* Absolute Encoder
* Rich Communication Interfaces

---

## Key Specifications

| Parameter | Value |
| --- | --- |
| Transmission Type | Planetary |
| Diameter | 100 mm |
| Thickness | 42.6 mm |
| Reduction Ratio | 9.25:1 |
| Rated Torque | 10 Nm |
| Peak Torque | 30 Nm |
| Rated Speed | 160 rpm |
| Motor Power | 213 W |
| Voltage | 24-48V |
| Weight | 671 g |

---

## Supported Protocols

* CAN Bus
* MIT Protocol
* ODrive Protocol
* USB Communication

---

## Features

* Integrated Driver
* High Torque Density
* Compact Design
* Low Backlash
* Easy Integration

---

## Applications

* Humanoid Robot Arms
* Humanoid Robot Legs
* Quadruped Robot Joints
* Robot Research Platforms

---

## Advantages

✓ Compact

✓ Lightweight

✓ Integrated Electronics

✓ Fast Integration

✓ Suitable for Mass Production

---

## Contact

Website:

https://www.siggear.com

Email:

[wwang109@163.com](mailto:wwang109@163.com)
## Related Applications

- [AGV / AMR Wheel Drive Gearbox](Applications/agv-amr-wheel-drive-gearbox.md)
- [Robot Arm Joint Gearbox](Applications/robot-arm-joint-gearbox.md)
- [Quadruped Robot Joint Gearbox](Applications/quadruped-robot-joint-gearbox.md)
- [Cycloidal Reducer for Humanoid Robot Joints](Applications/humanoid-robot-joint-reducer.md)
