SigGearDrive/SigGear-product-docs/CPM80-25.md

# CPM80-25 Cycloidal Robotic Joint Module

CPM80-25

## Overview

CPM80-25 is a compact cycloidal robotic joint module designed for robotic joints requiring low backlash and high torque density.

The module integrates:

* Cycloidal Reducer
* BLDC Motor
* Encoder Interface
* Driver Integration Option

---

## Key Specifications

| Parameter | Value |
| --- | --- |
| Transmission Type | Cycloidal Pinwheel |
| Diameter | 80 mm |
| Thickness | 29.7 mm |
| Rated Torque | 10 Nm |
| Peak Torque | 50 Nm |
| Rated Speed | 120 rpm |
| Motor Power | 500 W |
| Voltage | 24-48V |

---

## Features

* Compact Design
* High Torque Density
* Impact Resistant
* Low Backlash
* Hollow Structure Support

---

## Applications

* Exoskeleton Systems
* Humanoid Robots
* Robot Arms
* Service Robots

---

## Available Versions

### Standard Version

Reducer + Motor

### Integrated Version

Reducer + Motor + Driver

---

## OEM & ODM

Custom mechanical interfaces and communication protocols are supported.
## Related Application

- [Cycloidal Reducer for Humanoid Robot Joints](Applications/humanoid-robot-joint-reducer.md)
- [Quadruped Robot Joint Gearbox](Applications/quadruped-robot-joint-gearbox.md)
- [Robot Arm Joint Gearbox](Applications/robot-arm-joint-gearbox.md)
