SigGearDrive/SigGear-product-docs/CPM100-25.md

# CPM100-25 Cycloidal Robotic Joint Module

CPM100-25 Cycloidal Robotic Joint Module

## Overview

CPM100-25 is a high-torque cycloidal robotic joint module optimized for humanoid robot hip joints, knee joints and industrial robotic applications.

Designed specifically for robotics, CPM100-25 offers low backlash, compact dimensions and high torque density.

---

## Key Specifications

| Parameter | Value |
| --- | --- |
| Transmission Type | Cycloidal |
| Diameter | 100 mm |
| Thickness | 29.5 mm |
| Rated Torque | 25 Nm |
| Peak Torque | 75 Nm |
| Rated Speed | 60 rpm |
| Voltage | 24-48V |
| Backlash | 0.05° |

---

## Features

* High Torque Density
* Compact Structure
* Low Backlash
* High Shock Resistance
* Robot Ready Design

---

## Applications

### Humanoid Robots

* Hip Joint
* Knee Joint
* Shoulder Joint

### Industrial Robots

* Collaborative Robots
* Service Robots
* Automation Systems

### Research Platforms

* Universities
* Robotics Laboratories
* Robot Startups

---

## Advantages

✓ 25 Nm Rated Torque

✓ 75 Nm Peak Torque

✓ 0.05° Backlash

✓ Compact 100 mm Diameter

✓ Designed for Robotics

---

## Contact

Website:

https://www.siggear.com

Email:

[wwang109@163.com](mailto:wwang109@163.com)
## Related Application

- [Cycloidal Reducer for Humanoid Robot Joints](Applications/humanoid-robot-joint-reducer.md)
- [Quadruped Robot Joint Gearbox](Applications/quadruped-robot-joint-gearbox.md)
- [Robot Arm Joint Gearbox](Applications/robot-arm-joint-gearbox.md)
