SigGearDrive/SigGear-product-docs/SG6010C.md

# SG6010C Planetary Robotic Joint Module

SG6010C

## Overview

SG6010C is a compact planetary robotic joint module designed for humanoid robots, exoskeleton systems and lightweight robotic manipulators.

The module integrates:

* Planetary Reducer
* High Performance BLDC Motor
* Absolute Encoder
* Driver Electronics
* CAN Communication

Compact dimensions and high torque density make it suitable for next-generation robotic systems.

---

## Key Specifications

| Parameter | Value |
| --- | --- |
| Transmission Type | Planetary |
| Outer Diameter | 80 mm |
| Thickness | 34.07 mm |
| Reduction Ratio | 9.67:1 |
| Rated Torque | 6 Nm |
| Peak Torque | 18 Nm |
| Rated Speed | 310 rpm |
| No-load Speed | 400 rpm |
| Motor Power | 328 W |
| Rated Voltage | 24-48V |
| Weight | 377 g |
| Backlash | 15-20 arcmin |

---

## Communication

* CAN Bus
* USB Type-C
* MIT Motion Control
* ODrive Compatible Interface

---

## Features

* Compact Structure
* Integrated Drive Electronics
* Lightweight Design
* Low Power Consumption
* Robot Ready

---

## Typical Applications

* Exoskeleton Joints
* Humanoid Robot Arms
* Service Robots
* Educational Robots
* Research Platforms

---

## OEM & ODM

Custom communication protocols, mechanical interfaces and gear ratios are available.

For customization inquiries:

[wwang109@163.com](mailto:wwang109@163.com)
