SigGearDrive/SigGear-product-docs/docs/contact.md

# Contact SigGear

## Sales Contact

**Wanrong Wang**

International Sales, SigGear

- Email: [wangwanrong@siggear.com](mailto:wangwanrong@siggear.com)

## Social Channels

- YouTube: [@siggeardrive](https://www.youtube.com/@siggeardrive)
- Instagram: [@luffywan.robotics](https://www.instagram.com/luffywan.robotics/)
- TikTok: [@robotactuator.engineer](https://www.tiktok.com/@robotactuator.engineer)

Telephone and WhatsApp details are available upon request.

## Product Inquiry

For miniature and compact planetary gearbox projects, start with the route that matches your project.

### I Already Have a Motor — Gearbox Only

For a first review, send:

- Motor model or drawing
- Motor speed
- Required output speed or ratio
- Maximum gearbox / assembly diameter and length
- Load or torque, if known

[Start Gearbox-Only Review](mailto:wangwanrong@siggear.com?subject=Gearbox%20Only%20Review%20-%20Existing%20Motor&body=Existing%20motor%20model%20%2F%20drawing%3A%20%0AMotor%20speed%3A%20%0ARequired%20output%20speed%20or%20ratio%3A%20%0AMaximum%20gearbox%20%2F%20assembly%20size%3A%20%0ALoad%20or%20torque%20if%20known%3A%20%0APrototype%20quantity%20%2F%20annual%20volume%3A%20){ .md-button .md-button--primary }

### I Need a Complete Motor + Gearbox Assembly

For a first review, send:

- Application / what needs to move
- Required output speed
- Load or torque, if known
- Maximum diameter and total length
- Operating voltage

[Start Motor + Gearbox Review](mailto:wangwanrong@siggear.com?subject=Motor%20%2B%20Gearbox%20Engineering%20Review&body=Application%20%2F%20what%20needs%20to%20move%3A%20%0ARequired%20output%20speed%3A%20%0ALoad%20or%20torque%20if%20known%3A%20%0AMaximum%20diameter%20and%20total%20length%3A%20%0AOperating%20voltage%3A%20%0APrototype%20quantity%20%2F%20annual%20volume%3A%20){ .md-button .md-button--primary }

A complete specification is not required for the first review. If you have a mechanism sketch, motor drawing or CAD screenshot, attach it to the email.

Useful project information when available includes company and country, project stage, prototype quantity, annual volume and delivery destination.

[Browse 8–42 mm Planetary Gearboxes](products/planetary-gearboxes/8-42mm-planetary-gear-reducer.md){ .md-button }
[Request CAD, Sample and Quote](request-cad-sample-quote.md){ .md-button }

## Technical Files Policy

Selected products have public Engineering Packs with released CAD / STEP and interface resources that can be used before contacting SigGear.

[Open the Engineering Center](engineering-center/index.md)

Controlled production drawings, configuration-specific wiring / communication documents, and noise, thermal or service-life information are supplied according to the selected product and application review.
