SigGearDrive/SigGear-product-docs/Comparisons/cycloidal-vs-harmonic-drive.md

---

title: Cycloidal Reducer vs Harmonic Drive
description: Compare cycloidal reducers and harmonic drives for robot joints, humanoid robots, quadruped robots, robot arms, compact actuators, torque density, backlash, shock resistance, and gearbox selection.
------------------------------------------------------------------------------------------------------------------------------------------------------------------------------------------------------------------

# Cycloidal Reducer vs Harmonic Drive

Cycloidal reducers and harmonic drives are both widely used in robotic joints, precision automation, compact actuators, and high-torque motion systems. Both reducer types can provide high reduction ratios in compact spaces, but they have different mechanical structures, load characteristics, stiffness, backlash behavior, shock resistance, lifetime considerations, and application strengths.

For robotics engineers developing humanoid robots, quadruped robots, robot arms, collaborative robots, compact actuators, or precision automation systems, choosing between a cycloidal reducer and a harmonic drive depends on torque requirement, impact load, backlash, size, weight, stiffness, speed, lifetime, and cost target.

SigGear focuses on compact cycloidal robotic joint modules, 6-42mm planetary gear reducers, micro gear motors, and customized precision drive solutions for robotics and automation applications.

## Quick Comparison

| Item | Cycloidal Reducer | Harmonic Drive / Strain Wave Gear |
| --- | --- | --- |
| Basic structure | Cycloidal disc, eccentric bearing, pins, output mechanism | Wave generator, flexspline, circular spline |
| Torque density | High | High |
| Shock resistance | Strong | Moderate to good, depending on design |
| Stiffness | Good for high-load joints | Good precision performance |
| Backlash | Low backlash possible | Very low backlash possible |
| Compactness | Compact, especially for high-torque joints | Very compact, especially for high reduction ratios |
| Typical reduction ratio | Medium to high | High |
| Overload capability | Often strong | Depends on flexspline fatigue and structure |
| Lifetime concern | Bearing, pins, lubrication, load condition | Flexspline fatigue, tooth engagement, load condition |
| Typical applications | Humanoid joints, quadruped joints, robot arms, heavy compact actuators | Precision robot joints, collaborative robots, compact precision mechanisms |
| Selection focus | Torque, shock load, stiffness, durability | Precision, compactness, low backlash, high ratio |

Both technologies can be suitable for robot joints. The best choice depends on the actual application requirements.

## What Is a Cycloidal Reducer?

A cycloidal reducer is a precision gearbox that uses an eccentric motion and cycloidal disc profile to reduce speed and increase torque. The motion is transmitted through rolling or sliding contact between the cycloidal disc, pins, bearings, and output mechanism.

Cycloidal reducers are often used when engineers need:

* High torque density
* Compact high-load transmission
* Good shock resistance
* Strong overload capability
* Stable robotic joint output
* Durable structure for dynamic loads
* Compact actuator design

Cycloidal reducers are commonly used in humanoid robot joints, quadruped robot joints, robot arms, industrial automation, compact actuators, and heavy-duty precision motion systems.

## What Is a Harmonic Drive?

A harmonic drive, also known as a strain wave gear, uses elastic deformation of a flexspline to create gear reduction. It usually includes a wave generator, flexspline, and circular spline.

Harmonic drives are often used when engineers need:

* Very compact gearbox structure
* High reduction ratio
* Very low backlash
* Precision positioning
* Lightweight robotic joint design
* Compact robotic arm joints
* Smooth precision motion

Harmonic drives are commonly used in precision robot joints, collaborative robots, robotic arms, aerospace mechanisms, automation equipment, and compact positioning systems.

## Key Differences Between Cycloidal Reducers and Harmonic Drives

Although both reducer types are used in robotics, their design logic is different.

| Comparison Factor | Cycloidal Reducer | Harmonic Drive |
| --- | --- | --- |
| Torque transmission | Through cycloidal disc and pin engagement | Through elastic flexspline deformation |
| Load handling | Strong for impact and high-load conditions | Strong precision output but sensitive to overload and fatigue conditions |
| Precision | Low backlash design possible | Very low backlash design possible |
| Structural behavior | Rigid mechanical structure | Elastic deformation is part of operation |
| Dynamic robot suitability | Strong for walking robots and high-impact joints | Suitable for precision robotic joints and compact mechanisms |
| Failure risk focus | Bearing load, pin load, lubrication, wear | Flexspline fatigue, tooth stress, overload |
| Application style | High-torque compact robotic joints | Compact precision positioning joints |

## Torque Density

Torque density is critical for robot joints because the actuator must deliver high output torque in limited space.

| Reducer Type | Torque Density Characteristics |
| --- | --- |
| Cycloidal reducer | Strong choice for compact high-torque output and impact-loaded joints |
| Harmonic drive | Strong choice for compact precision joints with high reduction ratio  |

For humanoid robots and quadruped robots, torque density is especially important because the joints must remain compact and lightweight while still supporting walking, balancing, lifting, and impact loads.

## Backlash and Positioning Accuracy

Backlash affects joint positioning accuracy, repeatability, and control performance.

| Reducer Type | Backlash Characteristics |
| --- | --- |
| Cycloidal reducer | Low backlash possible depending on design, manufacturing, preload, and assembly  |
| Harmonic drive | Very low backlash possible and widely used in precision positioning applications |

If the main goal is extremely low backlash in a compact precision joint, harmonic drives are often considered. If the joint also requires strong impact resistance and high overload capacity, cycloidal reducers may be more suitable.

## Shock Resistance and Impact Load

Shock resistance is important for dynamic robots.

| Application | Shock Load Requirement |
| --- | --- |
| Humanoid robot knee or ankle joint | High |
| Quadruped robot hip, knee, or leg joint | High |
| Robot arm shoulder or elbow | Medium to high |
| Collaborative robot joint | Medium |
| Precision positioning system | Low to medium |

Cycloidal reducers are often selected for applications that may experience shock, impact, sudden load changes, or high peak torque. Harmonic drives can perform well in precision systems, but engineers should carefully evaluate overload and fatigue conditions.

## Stiffness and Control Response

Robot joint stiffness affects vibration, control response, and motion stability.

| Reducer Type | Stiffness Consideration |
| --- | --- |
| Cycloidal reducer | Good stiffness for high-load robotic joints when properly designed |
| Harmonic drive | Good precision performance, but elastic deformation is part of the mechanism |

For dynamic robots, stiffness affects how the joint responds during walking, jumping, lifting, or sudden acceleration. For robot arms, stiffness affects path accuracy, vibration, and repeatability.

## Size and Weight

Both cycloidal reducers and harmonic drives can be compact, but their size advantage depends on the specific torque, ratio, and joint design.

| Requirement | Often Considered Option |
| --- | --- |
| Very compact high-ratio precision joint | Harmonic drive |
| Compact high-torque impact-resistant joint | Cycloidal reducer |
| Lightweight small robot arm joint | Harmonic drive or compact cycloidal design |
| Heavy-load compact robotic actuator | Cycloidal reducer |

The final choice should be based on actual torque, speed, ratio, weight, installation space, and duty cycle.

## Lifetime and Reliability

Lifetime depends on design, materials, manufacturing quality, lubrication, load condition, temperature, duty cycle, and overload history.

| Reducer Type | Main Lifetime Considerations |
| --- | --- |
| Cycloidal reducer | Bearing load, pin contact, lubrication, wear, overload, impact load |
| Harmonic drive | Flexspline fatigue, tooth stress, lubrication, overload, repeated elastic deformation |

For robots that face frequent impact or high peak loads, engineers should carefully evaluate the reducer’s allowable torque, momentary overload capacity, shock resistance, and safety factor.

## Efficiency

Efficiency affects motor sizing, heat generation, battery life, and continuous operation.

| Reducer Type | Efficiency Consideration |
| --- | --- |
| Cycloidal reducer | Efficiency depends on ratio, bearing structure, lubrication, load, and design |
| Harmonic drive | Efficiency depends on ratio, flexspline deformation, load, lubrication, and design |

For battery-powered robots, efficiency affects working time and thermal behavior. Engineers should evaluate efficiency under actual load and speed, not only catalog values.

## Noise and Smoothness

Noise and smoothness matter in collaborative robots, service robots, medical devices, lab automation, and indoor automation systems.

| Reducer Type | Noise / Smoothness Consideration |
| --- | --- |
| Cycloidal reducer | Can provide stable output, but design and manufacturing quality affect vibration and noise |
| Harmonic drive | Often used in smooth precision applications, but load and speed still affect noise |

Noise should be tested in the final actuator assembly because motor, gearbox, controller, housing, bearing support, and mechanical load all affect final sound performance.

## Cost and Manufacturing Complexity

Cost depends on reducer size, precision level, material, production process, tolerance requirement, volume, and customization.

| Reducer Type | Cost Consideration |
| --- | --- |
| Cycloidal reducer | Cost depends on precision machining, bearing structure, pins, assembly, and testing |
| Harmonic drive | Cost depends on flexspline manufacturing, precision tooth profile, material, and assembly |

For early-stage robotics projects, sample testing is often more important than choosing only by theoretical comparison.

## Which Reducer Is Better for Humanoid Robot Joints?

Humanoid robot joints require compact size, high torque density, low backlash, impact resistance, stiffness, and reliable repeated operation.

Cycloidal reducers are often considered for humanoid joints where high torque, shock load, and compact high-load transmission are important. Harmonic drives are often considered for compact precision joints where low backlash and high reduction ratio are key requirements.

For humanoid robot development, engineers should compare:

* Joint torque requirement
* Peak torque
* Impact load
* Output speed
* Backlash requirement
* Joint size limit
* Weight target
* Control method
* Duty cycle
* Lifetime target
* Cost target
* Prototype testing results

## Which Reducer Is Better for Quadruped Robot Joints?

Quadruped robot joints experience repeated impact during walking, running, jumping, and landing. Shock resistance, torque density, stiffness, and durability are very important.

Cycloidal reducers can be a strong option for quadruped joints because they can support compact high-torque transmission and impact-loaded applications. Harmonic drives may also be used in certain quadruped designs, but overload and fatigue conditions should be carefully evaluated.

For quadruped robot joints, engineers should focus on:

* Leg joint peak torque
* Landing impact load
* Joint speed
* Weight
* Gearbox stiffness
* Backlash
* Heat generation
* Duty cycle
* Lifetime under repeated impact

## Which Reducer Is Better for Robot Arms?

Robot arms need positioning accuracy, stiffness, smooth motion, and reliable torque output.

| Robot Arm Joint | Common Requirement |
| --- | --- |
| Shoulder joint  | High torque, stiffness, compact size |
| Elbow joint | Torque, repeatability, stable motion |
| Wrist joint | Compact size, low backlash, smooth precision control |
| End effector | Small size, low-speed motion, stable torque |

Cycloidal reducers may be suitable for larger robot arm joints requiring higher torque and stiffness. Harmonic drives may be suitable for compact precision joints, especially wrist joints and lightweight collaborative robot joints.

## Cycloidal Reducer vs Harmonic Drive: Application Guide

| Application | Recommended Evaluation |
| --- | --- |
| Humanoid robot joint | Compare cycloidal reducer and harmonic drive based on torque, shock load, backlash, size, and weight |
| Quadruped robot leg joint | Focus on shock resistance, peak torque, stiffness, and lifetime |
| Robot arm shoulder joint  | Focus on torque, stiffness, backlash, and compactness |
| Robot arm wrist joint | Focus on compactness, low backlash, and smooth precision motion |
| Collaborative robot joint | Focus on low noise, smoothness, safety, backlash, and integration |
| Robotic gripper | Planetary gearbox or micro gear motor may also be practical |
| Micro robot | Miniature planetary gearbox or micro gear motor may be more suitable |
| AGV / AMR wheel drive | Planetary gearbox or custom wheel drive solution may be more practical |

## SigGear Product Recommendations

SigGear focuses on compact robotic drive solutions, including cycloidal robotic joint modules, planetary gear reducers, micro gear motors, and custom actuator solutions.

| Requirement | Recommended SigGear Solution |
| --- | --- |
| Humanoid robot joint | [CPM100-25 Compact Cycloidal Robotic Joint Module](../CPM100-25.md) |
| Compact humanoid or quadruped joint | [CPM80-25 Compact Cycloidal Robotic Joint Module](../CPM80-25.md) |
| Robot arm joint | [CPM100-25](../CPM100-25.md), [CPM80-25](../CPM80-25.md), or custom drive solution |
| Servo motor gearbox | [6-42mm Planetary Gear Reducer](../Applications/6-42mm-planetary-gear-reducer.md) |
| Robotic gripper | [Robot Gripper Gear Motor](../Applications/robot-gripper-gear-motor.md) |
| Micro robotics | [6mm Micro Gear Motor for Micro Robotics](../Applications/micro-robotics-gear-motor.md) |
| Medical or lab automation | [Micro Gear Motor for Medical Devices](../Applications/medical-device-micro-gear-motor.md) |

## When to Choose a Cycloidal Reducer

A cycloidal reducer may be a suitable choice when your application requires:

* High torque density
* Compact high-load transmission
* Strong shock resistance
* High peak torque capability
* Good stiffness
* Robot joint integration
* Humanoid or quadruped robot actuator design
* Robot arm joint drive
* Industrial robotic mechanism
* Custom compact actuator solution

Cycloidal reducers are especially worth evaluating for dynamic robot joints that experience high torque and impact loads.

## When to Choose a Harmonic Drive

A harmonic drive may be a suitable choice when your application requires:

* Very compact size
* Very low backlash
* High reduction ratio
* Precision positioning
* Lightweight robot joint design
* Smooth motion
* Compact robotic arm joint
* Precision automation mechanism

Harmonic drives are especially worth evaluating for compact precision joints where low backlash and high ratio are the main priorities.

## When to Consider a Planetary Gearbox Instead

Not every robotic application needs a cycloidal reducer or harmonic drive. For many compact motor-driven mechanisms, a planetary gearbox may be more practical.

Planetary gearboxes can be suitable for:

* Servo motor integration
* Stepper motor systems
* DC motor gearboxes
* Brushless motor drive systems
* Robotic grippers
* Micro robotics
* Medical devices
* Lab automation
* Optical equipment
* AGV / AMR auxiliary mechanisms
* Compact actuators
* Small automation modules

For these applications, SigGear provides [6-42mm planetary gear reducers](../Applications/6-42mm-planetary-gear-reducer.md) and custom compact gearbox solutions.

## Selection Checklist

Before choosing between a cycloidal reducer and harmonic drive, confirm the following:

| Selection Item | What to Confirm |
| --- | --- |
| Application | Humanoid, quadruped, robot arm, gripper, actuator, automation |
| Output torque  | Continuous torque and peak torque |
| Output speed | Required joint or mechanism speed |
| Gear ratio | Required speed reduction and torque multiplication |
| Backlash | Required positioning accuracy and repeatability |
| Shock load | Impact, landing, collision, sudden load change |
| Size limit | Diameter, length, joint layout, motor space |
| Weight target  | Important for legged robots and robot arms |
| Stiffness | Required for motion stability and control response |
| Duty cycle | Walking, holding, lifting, repeated motion |
| Lifetime | Load profile and expected operating hours |
| Noise | Important for indoor, collaborative, medical, and service robots |
| Cost target | Prototype, small batch, or mass production |
| Customization  | Shaft, flange, motor, encoder, brake, housing, connector |

## Recommended SigGear Resources

Application pages:

* [Cycloidal Reducer for Humanoid Robot Joints](../Applications/humanoid-robot-joint-reducer.md)
* [Quadruped Robot Joint Gearbox](../Applications/quadruped-robot-joint-gearbox.md)
* [Robot Arm Joint Gearbox](../Applications/robot-arm-joint-gearbox.md)
* [Servo Motor Planetary Gearbox](../Applications/servo-motor-planetary-gearbox.md)
* [Robot Gripper Gear Motor](../Applications/robot-gripper-gear-motor.md)
* [6-42mm Planetary Gear Reducer](../Applications/6-42mm-planetary-gear-reducer.md)

Selection guides:

* [Robot Joint Gearbox Selection Guide](../Selection-Guides/robot-joint-gearbox-selection-guide.md)
* [Planetary Gearbox Selection Guide](../Selection-Guides/planetary-gearbox-selection-guide.md)
* [Micro Gear Motor Selection Guide](../Selection-Guides/micro-gear-motor-selection-guide.md)

Related comparison pages:

* [Planetary vs Cycloidal Gearbox](planetary-vs-cycloidal-gearbox.md)
* [Integrated Robot Joint vs Separate Motor Gearbox](integrated-robot-joint-vs-separate-motor-gearbox.md)

## FAQ

### What is the difference between a cycloidal reducer and a harmonic drive?

A cycloidal reducer uses a cycloidal disc and eccentric motion to reduce speed and increase torque. A harmonic drive uses elastic deformation of a flexspline through a wave generator and circular spline. Cycloidal reducers are often considered for high-torque and impact-loaded joints, while harmonic drives are often considered for compact precision joints with very low backlash.

### Which is better for humanoid robot joints?

It depends on the joint torque, speed, backlash, impact load, size, weight, and lifetime requirements. Cycloidal reducers can be strong candidates for high-torque, shock-resistant humanoid joints. Harmonic drives can be strong candidates for compact precision joints with very low backlash.

### Which is better for quadruped robot joints?

Quadruped robot joints often experience impact loads during walking, running, jumping, and landing. Cycloidal reducers are often worth evaluating because of their shock resistance and high torque density. The final choice still depends on torque, speed, size, weight, backlash, and lifetime testing.

### Is a harmonic drive more precise than a cycloidal reducer?

Harmonic drives are widely known for very low backlash and precision positioning. However, precision also depends on design, manufacturing quality, assembly, control system, load, and application conditions. Cycloidal reducers can also be designed for low backlash robotic applications.

### Is a cycloidal reducer stronger than a harmonic drive?

Cycloidal reducers are often selected for high-load and shock-resistant applications. Harmonic drives can also provide high torque density, but flexspline fatigue and overload conditions must be considered carefully. The best choice depends on the actual load profile and design requirements.

### Can a planetary gearbox replace a cycloidal reducer or harmonic drive?

In some applications, yes. Planetary gearboxes can be suitable for servo motor integration, robotic grippers, micro robotics, medical devices, automation equipment, and compact actuators. For high-torque precision robot joints, cycloidal reducers or harmonic drives may be more suitable.

### Can SigGear help choose a reducer for robot joints?

Yes. SigGear can help evaluate compact cycloidal robotic joint modules, 6-42mm planetary gear reducers, micro gear motors, and custom drive solutions based on application, torque, speed, backlash, size, motor type, duty cycle, and expected quantity.

## Request Reducer Selection Support

If you are developing humanoid robot joints, quadruped robot joints, robot arms, robotic grippers, compact actuators, servo drive modules, or precision automation systems, contact SigGear for reducer selection support.

Please include the following information:

* Application
* Required output torque
* Required output speed
* Target gear ratio
* Backlash requirement
* Shock load or impact load
* Installation space
* Weight target
* Motor type
* Encoder or brake requirement
* Duty cycle
* Lifetime requirement
* Estimated annual quantity

**Email:** [wangwanrong984@gmail.com](mailto:wangwanrong984@gmail.com)
**Application:** Humanoid robot / quadruped robot / robot arm / robotic actuator / servo drive / compact automation
**Response:** SigGear can help recommend a suitable cycloidal reducer, planetary gearbox, robotic joint module, or customized drive solution based on your application requirements.
