SigGearDrive/SigGear-product-docs/Applications/medical-device-micro-gear-motor.md

---

title: Micro Gear Motor for Medical Devices
description: SigGear provides miniature gear motors, 6-42mm planetary gear reducers, and compact precision drive solutions for medical devices, diagnostic equipment, lab automation, pumps, valves, and precision instruments.
-------------------------------------------------------------------------------------------------------------------------------------------------------------------------------------------------------------------------------

# Micro Gear Motor for Medical Devices

SigGear provides miniature gear motors, compact planetary gear reducers, and precision drive solutions for medical devices, diagnostic equipment, laboratory automation, optical instruments, pumps, valves, and compact precision mechanisms.

For medical device applications, engineers often need compact drive components that can deliver stable motion, low noise, reliable output torque, and easy integration in limited installation space. SigGear supports micro drive solutions as small as 6mm, as well as 6-42mm planetary gear reducers for compact medical and precision motion systems.

## Why Medical Devices Need Compact Micro Gear Motors

Medical devices often have limited internal space but require reliable and controlled motion. A suitable micro gear motor or miniature planetary gearbox helps engineers reduce device size while maintaining stable torque output, smooth low-speed motion, and repeatable operation.

Micro gear motors and compact gear reducers can be used in medical equipment where the drive system needs to move, adjust, clamp, pump, open, close, rotate, or position small mechanical structures.

A suitable micro drive solution helps improve:

* Compact device design
* Stable low-speed movement
* Controlled output torque
* Low noise operation
* Smooth motion
* Mechanical integration speed
* Precision mechanism performance
* Prototype development efficiency
* Long-term device reliability

## Key Requirements for Medical Device Gear Motors

| Requirement | Why It Matters |
| --- | --- |
| Compact size | Medical devices often have limited internal installation space. |
| Stable output torque | Helps ensure reliable operation of pumps, valves, clamps, and adjustment mechanisms. |
| Smooth low-speed motion | Important for precision movement and controlled medical mechanisms. |
| Low noise | Useful for diagnostic equipment, portable devices, laboratory systems, and indoor medical environments. |
| Reliable transmission | Supports repeated operation and long service life. |
| Custom shaft design | Helps match special medical mechanism interfaces. |
| Flexible gear ratio | Balances speed, torque, efficiency, and control response. |
| Easy integration | Drawings, samples, and engineering support reduce development time. |

## Recommended SigGear Solutions

SigGear supports miniature and compact precision drive solutions for medical and laboratory equipment. For medical device applications, the following solutions can be evaluated:

| Solution | Type | Suitable Applications |
| --- | --- | --- |
| 6mm Micro Gear Motor | Ultra-miniature geared motor solution | Compact medical mechanisms, small pumps, valves, and miniature instruments |
| [6-42mm Planetary Gear Reducer](6-42mm-planetary-gear-reducer.md) | Miniature and compact planetary gearbox series | Medical devices, lab automation, optical equipment, precision instruments  |
| Custom Micro Gear Motor | Customized miniature drive solution | Application-specific medical mechanisms and compact motion modules |
| Compact Planetary Gearbox | Precision compact gearbox | Diagnostic equipment, dosing systems, small automation modules |
| [SG6010C](../SG6010C.md) | Compact precision drive solution | Compact motion systems, robotic mechanisms, and automation applications |
| [SG8021](../SG8021.md) | Precision drive solution | Robot joints, automation equipment, and compact motion systems |

If your medical device has special requirements for size, voltage, output speed, torque, gear ratio, shaft design, mounting interface, noise level, or lifetime, SigGear can help evaluate a suitable standard product or customized drive solution.

## Typical Medical Device Applications

SigGear miniature gear motors and compact planetary gear reducers can be used in:

* Medical pumps
* Small valve control systems
* Diagnostic equipment
* Portable medical devices
* Drug delivery mechanisms
* Sample handling systems
* Laboratory automation equipment
* Optical adjustment systems
* Medical imaging adjustment mechanisms
* Dental equipment
* Surgical tool adjustment mechanisms
* Rehabilitation devices
* Compact linear motion modules
* Precision dosing systems
* Small robotic medical mechanisms
* Medical research instruments

## Selection Parameters

When selecting a micro gear motor or compact planetary gearbox for medical devices, engineers should evaluate both mechanical and electrical requirements.

| Parameter | Notes |
| --- | --- |
| Size limit | Confirm outer diameter, length, wire outlet direction, and installation space. |
| Output torque | Match continuous torque and peak torque requirements. |
| Output speed | Confirm the target motion speed under real working conditions. |
| Gear ratio | Balance speed, torque, efficiency, noise, and response. |
| Voltage | Confirm compatibility with the device power system. |
| Shaft design | Check shaft diameter, length, D-shaft, flat, thread, gear, or custom interface. |
| Mounting method | Check screw holes, bracket, housing, flange, or custom mounting structure. |
| Noise requirement | Important for medical, diagnostic, laboratory, and portable devices. |
| Duty cycle | Evaluate working time, start-stop frequency, load profile, and heat conditions. |
| Lifetime requirement | Consider repeated operation, load, speed, temperature, and working environment. |
| Control method | Confirm DC control, encoder feedback, brushless motor control, or custom control requirements. |
| Quantity plan | Helps evaluate standard sample, custom sample, or production solution. |

## Medical Device Design Considerations

Medical device drive selection is different from general industrial reducer selection. Engineers should consider the complete device structure, expected motion profile, and operating environment.

| Design Factor | Typical Consideration |
| --- | --- |
| Miniaturization | Select a motor or gearbox size that fits the device layout without increasing product volume. |
| Motion stability | Smooth and predictable movement is important for precision medical mechanisms. |
| Noise control | Low-noise operation improves user experience in medical and laboratory environments. |
| Heat generation | Compact devices may have limited heat dissipation space. |
| Material and structure | Confirm whether the gearbox structure matches the device environment and mechanical load. |
| Output interface | Custom shaft or mounting design can reduce extra adapters and simplify assembly. |
| Reliability | Repeated operation requires stable transmission and suitable load margin. |
| Sample validation | Prototype testing is important because compact medical mechanisms are sensitive to friction, alignment, and load changes. |

## 6-42mm Planetary Gear Reducers for Medical Devices

SigGear 6-42mm planetary gear reducers can support different medical and precision motion requirements, from ultra-compact mechanisms to higher torque compact drive systems.

| Diameter Range | Typical Medical Device Use |
| --- | --- |
| 6-10mm | Ultra-compact medical mechanisms, small instruments, micro pumps, and compact valves |
| 12-16mm | Diagnostic equipment, lab automation, optical adjustment, and small dosing mechanisms  |
| 20-24mm | Compact medical modules, portable equipment, and stronger precision motion systems |
| 28-42mm | Higher torque medical automation, laboratory equipment, and industrial medical devices |

The final selection depends on installation space, torque, speed, ratio, duty cycle, noise requirement, motor type, and expected lifetime.

## Engineering Support

SigGear provides engineering support and resources to help customers evaluate medical device drive solutions faster:

* Product consultation
* Sample recommendation
* 2D drawing support
* CAD support when available
* Gear ratio selection support
* Shaft and mounting customization
* Motor matching support
* Noise optimization support
* Application review
* Prototype sample support
* Custom production support

These resources help engineers reduce supplier evaluation time, check installation space, and accelerate medical device prototype development.

## CAD Models and Product Resources

For medical devices and compact precision systems, engineers often need small-size drive components with clear drawings, stable communication, and fast sample support.

Useful resources include:

* [SigGear CAD Models](https://github.com/SigGearDrive/SigGear-cad-models)
* [SigGear Product Documents](https://github.com/SigGearDrive/SigGear-product-docs)
* [6-42mm Planetary Gear Reducer](6-42mm-planetary-gear-reducer.md)
* [6mm Micro Gear Motor for Micro Robotics](micro-robotics-gear-motor.md)

These resources help engineers check installation space, evaluate product compatibility, and reduce prototype development time.

## Customization Options

SigGear can support custom requirements for medical device micro drive applications, including:

* Custom outer diameter
* Custom gear ratio
* Custom output speed
* Custom output torque
* Custom output shaft
* Custom shaft length
* Custom wire length
* Custom connector
* Custom mounting interface
* Custom voltage
* Encoder option
* Brushless motor matching
* Low-noise optimization
* Compact mechanism integration
* Application-specific drive solution
* OEM / ODM production support

If your medical device, diagnostic equipment, laboratory system, or compact precision mechanism has strict size, torque, speed, noise, or lifetime requirements, SigGear can help evaluate a suitable standard or customized drive solution.

## Related Applications

Medical device micro gear motor applications are closely related to compact precision motion systems:

* [6mm Micro Gear Motor for Micro Robotics](micro-robotics-gear-motor.md)
* [6-42mm Planetary Gear Reducer](6-42mm-planetary-gear-reducer.md)
* [Robot Gripper Gear Motor](robot-gripper-gear-motor.md)
* [Servo Motor Planetary Gearbox](servo-motor-planetary-gearbox.md)
* [AGV / AMR Wheel Drive Gearbox](agv-amr-wheel-drive-gearbox.md)
- [Micro Gear Motor for Medical Devices](medical-device-micro-gear-motor.md)
- [Robot Gripper Gear Motor](robot-gripper-gear-motor.md)
## FAQ

### What type of gear motor is used in medical devices?

Medical devices may use micro gear motors, miniature planetary gearboxes, compact DC gear motors, brushless gear motors, or custom drive assemblies depending on size, torque, speed, noise, duty cycle, and lifetime requirements.

### Can SigGear provide small gear motors for medical devices?

Yes. SigGear can support micro gear motor solutions as small as 6mm and compact planetary gear reducers from 6mm to 42mm for medical devices, laboratory automation, optical systems, and precision instruments.

### What information is needed to select a micro gear motor for a medical device?

Typical selection information includes application, size limit, voltage, output speed, output torque, gear ratio, shaft design, mounting method, duty cycle, noise requirement, lifetime requirement, control method, and estimated annual quantity.

### Can SigGear customize micro gear motors for medical equipment?

Yes. SigGear can support custom gear ratio, output shaft, mounting interface, voltage, wire length, connector, encoder option, motor matching, and compact mechanism integration.

### Can SigGear support prototype and sample testing?

Yes. SigGear can support sample evaluation for medical devices, diagnostic equipment, lab automation, optical equipment, compact mechanisms, and precision motion systems.

## Request Drawing, Datasheet, or Sample

If you are developing medical devices, diagnostic equipment, laboratory automation systems, optical instruments, pumps, valves, or compact precision mechanisms, contact SigGear to request drawings, datasheets, and sample support.

Please include the following information when contacting us:

* Application
* Size limit
* Required outer diameter
* Required output torque
* Required output speed
* Target gear ratio
* Voltage
* Motor type
* Shaft design
* Mounting method
* Noise requirement
* Duty cycle
* Lifetime requirement
* Encoder requirement
* Estimated annual quantity

**Email:** [wangwanrong984@gmail.com](mailto:wangwanrong984@gmail.com)
**Application:** Medical device / diagnostic equipment / lab automation / optical equipment / pump / valve / compact precision mechanism
**Response:** SigGear can help recommend a suitable micro gear motor, 6-42mm planetary gear reducer, or customized miniature drive solution based on your application requirements.
