SigGearDrive/SigGear-product-docs/Applications/robot-gripper-gear-motor.md

---

title: Robot Gripper Gear Motor
description: SigGear provides micro gear motors, 6-42mm planetary gear reducers, and compact precision drive solutions for robotic grippers, end effectors, small actuators, automation tools, and compact motion systems.
--------------------------------------------------------------------------------------------------------------------------------------------------------------------------------------------------------------------------

# Robot Gripper Gear Motor

SigGear provides micro gear motors, miniature planetary gear reducers, and compact precision drive solutions for robotic grippers, end effectors, small actuators, automation tools, and compact motion systems.

Robotic grippers require compact size, stable output torque, smooth low-speed motion, low noise, and reliable operation in repeated opening and closing cycles. SigGear supports micro drive solutions as small as 6mm, as well as 6-42mm planetary gear reducers for compact gripper and end-effector applications.

## Why Robotic Grippers Need Compact Gear Motors

A robotic gripper often has limited installation space but needs enough torque to clamp, hold, release, rotate, or position objects reliably. A suitable micro gear motor or compact planetary gearbox helps convert motor speed into usable gripping torque while keeping the gripper structure compact and lightweight.

For automation and robotics engineers, the right gear motor can help improve:

* Gripping force
* Low-speed control
* Compact gripper design
* Repeatable opening and closing motion
* Smooth operation
* Low noise
* Motor matching flexibility
* Prototype development speed
* Long-term reliability

## Key Requirements for Robot Gripper Gear Motors

| Requirement | Why It Matters |
| --- | --- |
| Compact size | Grippers and end effectors often have limited internal space. |
| Stable output torque | Helps the gripper hold objects reliably. |
| Smooth low-speed motion | Supports controlled opening, closing, and positioning. |
| Low backlash | Helps improve repeatability and motion accuracy. |
| Low noise | Useful for collaborative robots, service robots, lab automation, and indoor systems. |
| Lightweight design | Reduces load on the robot arm or actuator module. |
| Custom shaft design | Helps match gripper fingers, gears, pulleys, lead screws, or custom mechanisms. |
| Flexible gear ratio | Balances speed, torque, efficiency, and control response. |
| Easy integration | Drawings, samples, and engineering support reduce development time. |

## Recommended SigGear Solutions

SigGear supports miniature and compact drive solutions for robotic grippers and end effectors.

| Solution | Type | Suitable Applications |
| --- | --- | --- |
| 6mm Micro Gear Motor | Ultra-miniature geared motor solution | Micro grippers, small automation tools, compact end effectors |
| [6-42mm Planetary Gear Reducer](6-42mm-planetary-gear-reducer.md) | Miniature and compact planetary gearbox series | Robotic grippers, small actuators, precision automation, end effectors  |
| Custom Micro Gear Motor | Customized miniature drive solution | Application-specific gripper mechanisms and compact motion modules |
| Compact Planetary Gearbox | Precision compact gearbox | Electric grippers, small robotic arms, automation modules |
| [SG6010C](../SG6010C.md) | Compact precision drive solution | Compact motion systems, robotic mechanisms, and automation applications |
| [SG8021](../SG8021.md) | Precision drive solution | Robot joints, automation equipment, and compact motion systems |

If your robotic gripper has special requirements for size, gripping force, output torque, speed, gear ratio, shaft design, mounting interface, or noise level, SigGear can help evaluate a suitable standard product or customized drive solution.

## Typical Applications

SigGear micro gear motors and compact planetary gear reducers can be used in:

* Robotic grippers
* Electric grippers
* Micro grippers
* Collaborative robot end effectors
* Robot arm end effectors
* Laboratory automation grippers
* Pick-and-place mechanisms
* Small clamping devices
* Compact actuators
* Miniature robotic hands
* Service robot grippers
* Inspection robot tools
* Medical automation grippers
* Packaging automation tools
* Custom automation end effectors

## Selection Parameters

When selecting a gear motor or planetary gearbox for robotic grippers, engineers should evaluate both mechanical and electrical requirements.

| Parameter | Notes |
| --- | --- |
| Gripping force | Determine the required clamping or holding force. |
| Object weight | Check the maximum object weight and safety margin. |
| Output torque | Match continuous torque and peak torque requirements. |
| Output speed | Confirm opening and closing speed. |
| Gear ratio | Balance gripping force, speed, efficiency, and control response. |
| Backlash requirement | Lower backlash helps improve repeatability and positioning. |
| Size limit | Confirm motor diameter, gearbox length, shaft length, and installation space. |
| Shaft design | Check shaft diameter, length, D-shaft, flat, thread, gear, or custom interface. |
| Mounting method | Check screw holes, flange, bracket, housing, or custom mounting structure. |
| Duty cycle | Evaluate repeated opening and closing cycles, holding time, and load profile. |
| Noise requirement | Important for collaborative robots, service robots, laboratories, and indoor systems. |
| Control method | Confirm DC control, encoder feedback, brushless motor control, or custom control needs. |
| Quantity plan | Helps evaluate standard sample, custom sample, or production solution. |

## Gripper Design Considerations

Robotic gripper drive selection depends on the complete mechanism, not only the motor or gearbox size.

| Design Factor | Typical Consideration |
| --- | --- |
| Gripper mechanism | Rack and pinion, lead screw, linkage, belt, worm gear, or custom mechanism. |
| Holding condition | Check whether the gripper needs to hold load continuously. |
| Speed vs force | Higher gear ratio usually increases torque but reduces output speed. |
| Backlash | Important for repeatable gripping position and precise finger movement. |
| Heat generation | Compact grippers may have limited heat dissipation space. |
| Noise | Low-noise operation improves user experience in collaborative and service robot environments. |
| Output interface  | Custom shaft or gear design can reduce extra adapters. |
| Sample testing | Prototype validation is important because gripper friction and alignment affect performance.  |

## 6-42mm Planetary Gear Reducers for Robotic Grippers

SigGear 6-42mm planetary gear reducers can support different gripper sizes and torque requirements.

| Diameter Range | Typical Gripper Use |
| --- | --- |
| 6-10mm | Micro grippers, miniature robotic hands, compact precision mechanisms |
| 12-16mm | Small electric grippers, lab automation grippers, optical or medical automation tools |
| 20-24mm | Compact robotic grippers, collaborative robot end effectors, small automation modules |
| 28-42mm | Higher torque grippers, industrial end effectors, stronger automation tools |

The final selection depends on gripping force, speed, ratio, backlash, installation space, duty cycle, motor type, noise requirement, and expected lifetime.

## Engineering Support

SigGear provides engineering support to help customers evaluate robotic gripper drive solutions faster:

* Product consultation
* Sample recommendation
* 2D drawing support
* CAD support when available
* Gear ratio selection support
* Motor matching support
* Shaft and mounting customization
* Noise optimization support
* Application review
* Prototype sample support
* Custom production support

These resources help engineers reduce supplier evaluation time, check installation space, and accelerate robotic gripper prototype development.

## CAD Models and Product Resources

For robotic grippers and end effectors, engineers often need compact drive components with clear drawings, stable communication, and fast sample support.

Useful resources include:

* [SigGear CAD Models](https://github.com/SigGearDrive/SigGear-cad-models)
* [SigGear Product Documents](https://github.com/SigGearDrive/SigGear-product-docs)
* [6-42mm Planetary Gear Reducer](6-42mm-planetary-gear-reducer.md)
* [6mm Micro Gear Motor for Micro Robotics](micro-robotics-gear-motor.md)
* [Micro Gear Motor for Medical Devices](medical-device-micro-gear-motor.md)

These resources help engineers check installation space, evaluate product compatibility, and reduce prototype development time.

## Customization Options

SigGear can support custom requirements for robotic gripper gear motor applications, including:

* Custom outer diameter
* Custom gear ratio
* Custom output speed
* Custom output torque
* Custom output shaft
* Custom shaft length
* Custom wire length
* Custom connector
* Custom mounting interface
* Custom voltage
* Encoder option
* Brushless motor matching
* Low-noise optimization
* Compact mechanism integration
* Application-specific drive solution
* OEM / ODM production support

If your robotic gripper, end effector, automation tool, or compact actuator has strict size, torque, speed, backlash, noise, or lifetime requirements, SigGear can help evaluate a suitable standard or customized drive solution.

## Related Applications

Robot gripper gear motor applications are closely related to compact robotics and precision automation:

* [6mm Micro Gear Motor for Micro Robotics](micro-robotics-gear-motor.md)
* [Micro Gear Motor for Medical Devices](medical-device-micro-gear-motor.md)
* [6-42mm Planetary Gear Reducer](6-42mm-planetary-gear-reducer.md)
* [Robot Arm Joint Gearbox](robot-arm-joint-gearbox.md)
* [Servo Motor Planetary Gearbox](servo-motor-planetary-gearbox.md)

## FAQ

### What type of gear motor is suitable for robotic grippers?

Robotic grippers may use micro gear motors, miniature planetary gearboxes, compact DC gear motors, brushless gear motors, or customized drive assemblies depending on gripping force, size, speed, backlash, noise, duty cycle, and lifetime requirements.

### Can SigGear provide small gear motors for robotic grippers?

Yes. SigGear can support micro gear motor solutions as small as 6mm and compact planetary gear reducers from 6mm to 42mm for robotic grippers, end effectors, automation tools, and compact actuators.

### What information is needed to select a gear motor for a robotic gripper?

Typical selection information includes gripping force, object weight, size limit, voltage, output speed, output torque, gear ratio, shaft design, mounting method, duty cycle, backlash requirement, noise requirement, lifetime requirement, control method, and estimated annual quantity.

### Can SigGear customize gear motors for gripper mechanisms?

Yes. SigGear can support custom gear ratio, output shaft, mounting interface, voltage, wire length, connector, encoder option, motor matching, and compact mechanism integration.

### Can SigGear support prototype and sample testing?

Yes. SigGear can support sample evaluation for robotic grippers, end effectors, compact actuators, laboratory automation, medical automation, and precision motion systems.

## Request Drawing, Datasheet, or Sample

If you are developing robotic grippers, end effectors, compact actuators, automation tools, laboratory automation systems, or precision motion products, contact SigGear to request drawings, datasheets, and sample support.

Please include the following information when contacting us:

* Application
* Gripper mechanism type
* Required gripping force
* Object weight
* Size limit
* Required outer diameter
* Required output torque
* Required output speed
* Target gear ratio
* Backlash requirement
* Voltage
* Motor type
* Shaft design
* Mounting method
* Noise requirement
* Duty cycle
* Lifetime requirement
* Encoder requirement
* Estimated annual quantity

**Email:** [wangwanrong984@gmail.com](mailto:wangwanrong984@gmail.com)
**Application:** Robotic gripper / end effector / compact actuator / lab automation / medical automation / precision motion system
**Response:** SigGear can help recommend a suitable micro gear motor, 6-42mm planetary gear reducer, or customized miniature drive solution based on your application requirements.
