SigGearDrive/SigGear-product-docs/Applications/agv-amr-wheel-drive-gearbox.md

---

title: AGV / AMR Wheel Drive Gearbox
description: SigGear precision gearboxes and compact drive solutions for AGV, AMR, mobile robots, wheel drive modules, and industrial automation systems.
---------------------------------------------------------------------------------------------------------------------------------------------------------

# AGV / AMR Wheel Drive Gearbox

SigGear provides precision gearboxes and compact drive solutions for AGV, AMR, mobile robots, wheel drive modules, and industrial automation systems.

AGV and AMR wheel drive systems require reliable torque output, compact size, stable motion, long service life, and easy integration with motors, wheels, encoders, brakes, and control systems. SigGear supports robotic and automation customers with precision reducers, CAD models, product documentation, and engineering resources for fast evaluation and prototype development.

## Why AGV and AMR Wheel Drives Need Reliable Gearboxes

AGV and AMR robots are widely used in warehouses, factories, logistics centers, hospitals, laboratories, and automated production lines. The wheel drive gearbox plays an important role in converting motor speed into usable wheel torque while supporting smooth movement, load carrying, acceleration, braking, and repeated operation.

A suitable gearbox helps improve:

* Wheel torque output
* Driving stability
* Low-speed control
* Load carrying capability
* Service life
* Compact drive module design
* Motor matching
* Prototype development speed
* Overall mobile robot reliability

For AGV and AMR applications, the gearbox should be selected according to payload, wheel diameter, speed, torque, duty cycle, installation space, motor type, brake requirement, and operating environment.

## Key Requirements for AGV / AMR Wheel Drive Gearboxes

| Requirement | Why It Matters |
| --- | --- |
| Reliable torque output  | Supports robot movement under load, acceleration, and slope conditions. |
| Compact size | Helps reduce wheel drive module size and improve layout flexibility. |
| High efficiency | Improves energy use and supports longer battery runtime. |
| Stable low-speed motion | Helps AGV and AMR robots move smoothly in warehouses and factories. |
| Long service life | Important for continuous operation in logistics and industrial environments. |
| Low noise | Useful for hospitals, laboratories, commercial spaces, and indoor applications. |
| Easy motor integration  | Reduces design time when matching motors, encoders, brakes, and wheels. |
| Customization | Supports different ratios, shaft types, mounting interfaces, and drive module designs. |

## Recommended SigGear Solutions

SigGear provides precision drive solutions for mobile robots, automation systems, and compact motion modules. For AGV and AMR wheel drive applications, the following products can be evaluated:

| Product | Type | Suitable Applications |
| --- | --- | --- |
| [SG8021](../SG8021.md) | Precision drive solution | AGV, AMR, mobile robots, wheel drive systems, and automation equipment |
| [SG6010C](../SG6010C.md) | Compact precision drive solution | Compact mobile robots, automation modules, and small wheel drive systems |
| [CPM80-25](../CPM80-25.md) | Compact cycloidal robotic joint module | Compact robotic actuators and special mobile robot mechanisms |
| [CPM100-25](../CPM100-25.md) | Compact cycloidal robotic joint module | High-torque robotic mechanisms and custom actuator systems |

If your AGV or AMR project has special requirements for torque, speed, ratio, installation space, wheel interface, motor integration, or brake design, SigGear can help evaluate a suitable standard product or customized drive solution.

## Typical Applications

SigGear precision gearboxes and compact drive solutions can be used in:

* AGV wheel drive modules
* AMR wheel drive modules
* Warehouse mobile robots
* Factory logistics robots
* Autonomous delivery robots
* Indoor service robots
* Hospital transport robots
* Laboratory automation robots
* Industrial mobile platforms
* Compact mobile robot drive systems
* Automated production line transport systems
* Custom wheel drive assemblies

## Selection Parameters

When selecting a gearbox for AGV and AMR wheel drive systems, engineers should evaluate both mechanical and operating requirements.

| Parameter | Notes |
| --- | --- |
| Robot payload | Check the maximum load carried by the AGV or AMR. |
| Wheel diameter | Affects required torque, speed, and drive module layout. |
| Output torque | Match starting torque, continuous torque, and peak torque requirements. |
| Output speed | Confirm target robot speed and wheel speed. |
| Gear ratio | Balance torque, speed, efficiency, and motor operating range. |
| Duty cycle | Evaluate continuous operation, start-stop frequency, and working hours. |
| Slope requirement | Consider ramp climbing, floor conditions, and load changes. |
| Noise requirement | Important for indoor, hospital, laboratory, and commercial environments. |
| Installation space | Check drive module diameter, axial length, and mounting space. |
| Motor compatibility  | Confirm motor size, shaft design, encoder, brake, and integration method. |
| Wheel interface | Confirm output shaft, flange, hub, and wheel mounting design. |
| Lifetime requirement | Consider operating environment, daily working time, and maintenance expectations. |

## AGV / AMR Drive System Considerations

AGV and AMR drive systems may use different structures depending on payload, cost, speed, and space requirements.

| Drive Design | Typical Consideration |
| --- | --- |
| Integrated wheel drive module | Compact design, faster assembly, and easier replacement. |
| Motor + gearbox + wheel assembly | Flexible design for custom mobile robot platforms. |
| Dual-wheel differential drive | Common for AGV and AMR platforms requiring simple steering. |
| Steering wheel drive module | Useful for omnidirectional or advanced mobile robot movement. |
| Low-noise indoor drive | Important for hospitals, offices, laboratories, and commercial environments. |
| Heavy-load AGV drive | Requires higher torque, stronger bearings, and reliable long-term operation. |

## Engineering Resources

SigGear provides engineering resources to help customers evaluate and integrate our drive solutions faster:

* CAD models for mechanical design
* Product datasheets
* 2D installation drawings
* Selection guides
* Gearbox and reducer documentation
* Motor integration support
* Sample testing support
* Custom drive solution support

These resources help AGV and AMR engineers check installation space, compare reducer options, reduce supplier evaluation time, and accelerate prototype development.

## CAD Models and Product Resources

For AGV and AMR development, engineers often need more than a simple product brochure. SigGear provides technical resources to support mechanical design, supplier comparison, and prototype testing.

Useful resources include:

* [SigGear CAD Models](https://github.com/SigGearDrive/SigGear-cad-models)
* [SigGear Product Documents](https://github.com/SigGearDrive/SigGear-product-docs)
* [SigGear Robot Joint SDK](https://github.com/SigGearDrive/SigGear-robot-joint-sdk)
* [SigGear ROS2 Resources](https://github.com/SigGearDrive/SigGear-ros2)

These resources help engineers check installation space, evaluate product compatibility, and reduce AGV / AMR prototype development time.

## Customization Options

SigGear can support custom requirements for AGV and AMR wheel drive applications, including:

* Custom gear ratio
* Custom output shaft
* Custom output flange
* Custom wheel mounting interface
* Compact drive module design
* Motor integration
* Encoder integration
* Brake integration
* Low-noise optimization
* Application-specific gearbox design

If your AGV or AMR wheel drive system has strict requirements for size, torque, speed, noise, lifetime, or mounting interface, SigGear can help evaluate a suitable standard product or customized solution.

## Related Applications

AGV and AMR wheel drive gearboxes are closely related to other robotic and automation motion applications:

* [Robot Arm Joint Gearbox](robot-arm-joint-gearbox.md)
* [Quadruped Robot Joint Gearbox](quadruped-robot-joint-gearbox.md)
* [Cycloidal Reducer for Humanoid Robot Joints](humanoid-robot-joint-reducer.md)
* [SG8021 Precision Drive Solution](../SG8021.md)
* [SG6010C Compact Precision Drive Solution](../SG6010C.md)

## FAQ

### What gearbox is suitable for AGV and AMR wheel drive systems?

AGV and AMR wheel drive systems usually require reliable torque output, compact size, high efficiency, stable low-speed motion, long service life, and easy integration with motors, encoders, brakes, and wheels. The final selection depends on payload, speed, wheel diameter, duty cycle, installation space, and operating environment.

### What is important when selecting an AGV wheel drive gearbox?

Important factors include robot payload, wheel diameter, output torque, output speed, gear ratio, efficiency, noise, duty cycle, slope requirement, motor compatibility, brake requirement, and lifetime requirement.

### Can SigGear support custom wheel drive gearbox designs?

Yes. SigGear can support custom ratio, output shaft, output flange, wheel mounting interface, motor integration, encoder integration, brake integration, and compact drive module design.

### Can SigGear provide CAD models?

Yes. SigGear provides CAD models and mechanical documentation to help engineers evaluate installation space and speed up prototype development.

### Can SigGear support prototype and sample testing?

Yes. SigGear can support sample evaluation for AGV, AMR, mobile robot, automation equipment, and custom wheel drive applications.

## Request CAD, Datasheet, or Sample

If you are developing AGV, AMR, mobile robot drive modules, or industrial automation motion systems, contact SigGear to request CAD models, datasheets, and sample support.

Please include the following information when contacting us:

* Application
* Robot payload
* Wheel diameter
* Required output torque
* Required output speed
* Target gear ratio
* Installation space
* Noise requirement
* Duty cycle
* Slope requirement
* Motor type
* Encoder or brake requirement
* Wheel mounting interface
* Estimated annual quantity

**Email:** [wangwanrong984@gmail.com](mailto:wangwanrong984@gmail.com)
**Application:** AGV / AMR / mobile robot / wheel drive module / automation motion system
**Response:** SigGear can help recommend a suitable gearbox or customized drive solution based on your application requirements.
