SigGearDrive/SigGear-product-docs/Case-Studies/How-SigGear-Reduces-Robot-Development-Time.md

# How SigGear Reduces Robot Development Time

## Overview

Developing a new robot often requires significant engineering effort in mechanical design, actuator selection, integration, testing and optimization.

Many robotics startups spend months developing custom joint systems before reaching a functional prototype.

SigGear helps reduce development time by providing ready-to-integrate robotic transmission and joint module solutions.

---

## Common Development Challenges

### Custom Actuator Development

Many robotics companies initially attempt to develop:

* Custom Gearboxes
* Custom Motors
* Custom Drivers
* Custom Encoders

This approach increases:

* Development Cost
* Engineering Risk
* Time to Market

---

### Mechanical Integration

Engineers often spend considerable time solving:

* Mounting Interface Design
* Packaging Constraints
* Weight Optimization
* Thermal Management

---

### Motion Control Integration

Developers must integrate:

* Communication Protocols
* Motion Control Algorithms
* Position Feedback
* Error Handling

This can significantly extend project timelines.

---

## How SigGear Helps

### Ready-to-Integrate Joint Modules

SigGear robotic joint modules combine:

* Precision Reducer
* Motor
* Encoder
* Drive Electronics

Reducing the number of components required in a robot design.

---

### Standard Communication Interfaces

Supported interfaces include:

* CAN Bus
* MIT Motion Control
* ODrive-Compatible Integration

This allows engineers to begin testing quickly.

---

### Compact Mechanical Design

Benefits include:

* Reduced Packaging Effort
* Faster Mechanical Integration
* Lower System Weight

---

### Custom Development Support

SigGear can assist with:

* Custom Gear Ratios
* Mechanical Interfaces
* Communication Interfaces
* Joint Configuration Optimization

---

## Example Development Workflow

### Traditional Approach

1. Design Reducer
2. Select Motor
3. Design Driver
4. Integrate Encoder
5. Develop Control System
6. Test and Optimize

Typical Timeline:

```text
6-12 Months
```

---

### Using SigGear Joint Modules

1. Select Joint Module
2. Integrate Mechanically
3. Connect Communication Interface
4. Begin Motion Testing

Typical Timeline:

```text
2-8 Weeks
```

---

## Recommended Products

### SG6010C

Suitable for:

* Educational Robots
* Research Platforms
* Lightweight Robotic Systems

---

### SG8021

Suitable for:

* Service Robots
* Collaborative Robots
* Mobile Robots

---

### CPM80-25

Suitable for:

* Exoskeleton Systems
* Robot Arms
* Quadruped Robots

---

### CPM100-25

Suitable for:

* Humanoid Robots
* Industrial Robot Joints
* High Torque Applications

---

## Benefits

* Faster Prototyping
* Reduced Engineering Risk
* Lower Development Cost
* Faster Time to Market
* Scalable Manufacturing Support

---

## Ideal Customers

### Robotics Startups

Reduce development complexity and accelerate product launch.

### Universities & Research Labs

Focus on algorithms and applications instead of hardware development.

### Industrial Automation Companies

Shorten development cycles and improve integration efficiency.

### Humanoid Robot Developers

Access compact, high-torque joint solutions without developing custom actuators.

---

## Contact

Website:

https://www.siggear.com

Email:

[wwang109@163.com](mailto:wwang109@163.com)

---

## Learn More

Explore additional resources:

* Product Documentation
* CAD Models
* SDK Documentation
* Application Guides
* Industry Solutions
