SigGearDrive/SigGear-product-docs/Industries/Service-Robotics.md

# Service Robotics

## Overview

Service robots require lightweight, compact and efficient transmission systems to achieve reliable mobility, interaction and manipulation.

SigGear robotic joint modules help developers reduce system size while maintaining high torque output and precise motion control.

---

## Recommended Products

### SG6010C

Suitable for:

* Service Robot Arms
* Reception Robots
* Educational Robots
* Mobile Service Platforms

Key Advantages:

* Compact Design
* Lightweight Structure
* Integrated Electronics
* Easy Integration

---

### SG8021

Suitable for:

* Heavy-Duty Service Robots
* Delivery Robots
* Autonomous Service Platforms

Key Advantages:

* High Torque Density
* Stable Performance
* Compact Footprint

---

### CPM80-25

Suitable for:

* Robotic Manipulators
* Interactive Robots
* Research Platforms

Key Advantages:

* Low Backlash
* Smooth Motion
* High Torque Output

---

## Benefits for Service Robotics

* Lightweight Design
* Compact Dimensions
* Reliable Motion Control
* CAN Communication Support
* Fast Integration

---

## Typical Applications

### Hospitality Robots

Used in hotels, restaurants and public service environments.

### Delivery Robots

Designed for autonomous indoor and outdoor delivery systems.

### Educational Robots

Supports robotics education, competitions and research projects.

### Reception Robots

Provides interactive services in offices, hospitals and public facilities.

---

## Why Choose SigGear

* Robotics-Focused Product Development
* Flexible Customization
* Fast Prototyping
* Reliable Manufacturing
* Global Delivery Capability

---

## Related Products

| Product  | Recommended Application |
| --- | --- |
| SG6010C  | Reception Robots |
| SG8021 | Delivery Robots |
| CPM80-25 | Robotic Manipulators |

---

## Contact

Website:

https://www.siggear.com

Email:

[wwang109@163.com](mailto:wwang109@163.com)
