SigGearDrive/SigGear-product-docs/Industries/Medical-Robotics.md

Medical Robotics
Overview

Medical robots require compact, precise and reliable motion transmission systems.

SigGear robotic joint modules provide smooth motion, low backlash and compact integration for medical applications.

Recommended Products
SG6010C

Suitable for:

Rehabilitation Robots
Therapy Equipment
Medical Training Systems
CPM80-25

Suitable for:

Assistive Robotics
Wearable Medical Devices
Benefits
Compact Structure
Smooth Motion
Low Noise
High Reliability
Typical Applications
Rehabilitation Robots
Surgical Assistance Systems
Medical Training Equipment
Assistive Robotics
Contact

https://www.siggear.com

wwang109@163.com
