SigGearDrive/SigGear-product-docs/Applications/Robot-Arms.md

# Robotic Arm Solutions

## Overview

Modern robotic arms require compact transmission systems with high positioning accuracy and reliable torque output.

SigGear robotic joint modules provide an integrated solution for collaborative robots and service robots.

---

## Recommended Products

### CPM100-25

Suitable for:

* Shoulder Joint
* Large Payload Robot Arms

### CPM80-25

Suitable for:

* Elbow Joint
* Mid-size Robot Arms

### SG8021

Suitable for:

* Lightweight Collaborative Robots

### SG6010C

Suitable for:

* Educational Robot Arms
* Research Platforms

---

## Features

* Compact Structure
* Low Backlash
* High Torque Density
* Easy Integration

---

## Applications

* Collaborative Robots
* Service Robots
* Educational Robots
* Research Platforms

---

## Contact

https://www.siggear.com

[wwang109@163.com](mailto:wwang109@163.com)
