SigGearDrive/SigGear-product-docs/Applications/Humanoid-Robots.md

# Humanoid Robot Solutions

## Overview

Humanoid robots require compact, lightweight and high-torque transmission systems for joints such as hips, knees, ankles, shoulders and elbows.

SigGear provides planetary and cycloidal robotic joint modules optimized for humanoid robot applications.

---

## Recommended Products

### CPM100-25

High Torque Cycloidal Joint Module

Applications:

* Hip Joint
* Knee Joint
* Shoulder Joint

Key Features:

* 25 Nm Rated Torque
* 75 Nm Peak Torque
* 0.05° Backlash
* Compact Structure

---

### CPM80-25

Compact Cycloidal Joint Module

Applications:

* Elbow Joint
* Wrist Joint
* Upper Body Actuation

---

### SG8021

Planetary Joint Module

Applications:

* Shoulder Joint
* Elbow Joint

---

### SG6010C

Compact Planetary Joint Module

Applications:

* Hand Joint
* Neck Joint
* Small Humanoid Platforms

---

## Why SigGear

* Compact Design
* High Torque Density
* Low Backlash
* OEM & ODM Support
* Fast Prototyping

---

## Contact

https://www.siggear.com

[wwang109@163.com](mailto:wwang109@163.com)
