SigGearDrive/SigGear-product-docs/docs/applications/electric-curtain-blind-window-opener-gear-motors.md

---
title: Planetary Gearheads for Motorized Curtains and Blinds | SigGear
description: "SigGear planetary gearheads for motorized curtains and roller blinds. Compare 16P–28P frames, pulley torque, quiet motion, holding and STEP CAD."
---

# Planetary Gearheads for Motorized Curtains, Blinds and Window Openers

## Application Overview

Electric curtain, blind and window opener systems use compact gear motors and transmission components to move curtains, roller blinds, Venetian blinds, shades, skylights, small windows, ventilation openings, sunshade systems and building-automation mechanisms.

These applications usually require quiet motion, compact packaging, reliable start-up torque, stable holding behavior, controlled end-stop behavior, low current consumption and long service life under repeated open-close cycles. In smart-home and building-automation projects, the motor and gearbox must also be reviewed together with track friction, fabric weight, pulley size, rope or belt tension, window load, wind force, battery current, control board limits, obstacle detection, installation tolerance and safety boundaries.

SigGear's **8–42 mm precision planetary gearheads (planetary gearboxes)** can be evaluated for electric curtain tracks, roller blinds, smart blinds, window openers and other compact building-automation mechanisms. Projects can start with **Gearhead Only** for a selected motor or a reviewed **Motor + Gearhead Assembly**. Other motor technologies may be more suitable where the device architecture calls for them. Final model selection, safety validation, installation approval and product certification remain the responsibility of the equipment manufacturer.

## Motorized Curtain Planetary Gearhead: Fast Engineering Answers

### How do I size a gearhead for a motorized curtain track?

Start from the **installed belt or rail pull force**, drive-pulley radius, required travel speed, start-up friction and obstruction load. For tangential pull force `F_pull` in newtons at the pulley and radius `r` in metres, a first-pass pulley-shaft torque is `T_pulley ≈ F_pull × r` in N·m. Include changing friction, acceleration and losses that have not already been measured in `F_pull`. The result is an **application load**, not a statement of any SigGear model's rated output.

For a belt moving at speed `v` in m/s without slip on a pulley of radius `r` in metres, estimated pulley speed is `n_pulley [rpm] ≈ 60 × v / (2π × r)`. Then screen a published planetary gearhead ratio using **loaded motor rpm / required gearhead output rpm**, followed by a real test at the target noise and cycle time.

### Which SigGear gearhead diameters should a curtain or blind OEM compare?

- **[16P 16 mm](../products/planetary-gearboxes/16p-planetary-gearbox.md):** begin with narrow tilt, latch or compact shade envelopes.
- **[20P 20 mm](../products/planetary-gearboxes/20p-planetary-gearbox.md) and [22P 22 mm](../products/planetary-gearboxes/22p-planetary-gearbox.md):** compare distinct Miniature-class frames for curtain tracks and blind mechanisms requiring a motor-interface review.
- **[28P 28 mm](../products/planetary-gearboxes/28p-planetary-gearbox.md):** compare if the working load and installation envelope point toward a larger frame.

These are **potential OEM starting points only**; actual allowable torque, output bearing load, ratio, stage-dependent length and noise must be confirmed on the selected configuration. An outdoor window or skylight mechanism introduces separate wind, sealing and safety requirements.

### Can a planetary gearhead hold a roller blind without power?

Do **not** assume a planetary gearhead is self-locking. Define whether the load must remain stationary during power loss and whether the device needs a brake, counterbalance, clutch or other complete-system holding arrangement. Consider manual override and pinch-point protection separately.

### How can I make an electric curtain drive quieter?

Measure sound and vibration **with the motor, gearhead, bracket, rail/tube and enclosure assembled**. Loaded speed, ratio, stage count, shaft alignment, resonance and start/stop control can affect perceived noise. SigGear does not publish one guaranteed noise value for every curtain mechanism.

### Where can I download CAD before asking for a quote?

Start with [model-specific datasheets and mechanical interfaces](../engineering-resources/planetary-gearboxes/index.md) and the [8P–42P public simplified STEP CAD library](../engineering-resources/planetary-gearboxes/public-cad-release-v1.md). Public STEP files are **4-stage reference shapes**, not a verified production drawing for another ratio or stage. Provide an existing motor drawing and the installation envelope to request configuration-specific CAD.

[Find a Gearhead for Curtain and Blind Applications](../selection-guides/miniature-planetary-gearbox-selection-guide.md?app=electric_curtain_blind#preliminary-ratio-stage-finder){ .md-button .md-button--primary }
[Send an OEM Curtain / Blind Engineering Brief](../request-cad-sample-quote.md?app=electric_curtain_blind){ .md-button }

## Electric Curtain Drive: Gearhead Only or Motor + Gearhead Assembly?

For OEM electric curtain tracks and compact smart-home mechanisms, **miniature planetary gearhead selection** begins with the motor operating point, curtain mechanism and available installation envelope.

**I already have a motor; I need Gearhead Only.** Provide the motor drawing, loaded shaft speed, shaft and pilot dimensions, mounting-hole pattern, available axial space, curtain travel speed and pulley or belt-drive geometry. SigGear can review the mechanical interface and ratio options.

**I need a Motor + Gearhead Assembly.** Provide the required output motion, curtain track friction or pulling load if known, supply voltage, start/stop cycle, expected acoustic target and maximum motorized-unit dimensions. Motor matching and complete assembly performance are confirmed for the selected configuration.

The approximate ratio may be estimated from **motor operating speed / target gearbox output speed**, then checked against actual available gearbox ratios and pulley travel. Do not assume a planetary gearbox is self-locking: holding torque, manual override, obstacle detection, end stops and user safety must be evaluated as a complete device.

[Find Published Gearhead Candidates](../selection-guides/miniature-planetary-gearbox-selection-guide.md?app=electric_curtain_blind#preliminary-ratio-stage-finder){ .md-button .md-button--primary }
[Compare SigGear 8–42 mm Planetary Gearheads](../products/planetary-gearboxes/8-42mm-planetary-gear-reducer.md){ .md-button .md-button--primary }
[Read the Planetary Gearhead Selection Guide](../selection-guides/miniature-planetary-gearbox-selection-guide.md?app=electric_curtain_blind#preliminary-ratio-stage-finder){ .md-button }
[Download Public 4-Stage STEP References](../engineering-resources/planetary-gearboxes/public-cad-release-v1.md){ .md-button }
[Start Curtain / Blind Project Brief](../request-cad-sample-quote.md?app=electric_curtain_blind){ .md-button }

Public simplified STEP files represent **4-stage reference geometry only**. Confirm the actual ratio, stage length and mechanical interface with a configuration-specific drawing. This guide covers **potential uses**; it does not claim validated SigGear customer installations.

## Compare Published SigGear Gearhead Models

For motorized curtains, roller blinds and window actuators, compare these **published gearhead frames** before committing to a motor-matched assembly. Noise and hold-position behavior require testing on the final mechanism.

| Frame and specification page | Example mechanism for evaluation | Engineering checks |
| --- | --- | --- |
| [16P 16 mm Gearhead](../products/planetary-gearboxes/16p-planetary-gearbox.md) | Slim tilt or compact shade axis | Review track load, installation length and low-noise target |
| [20P 20 mm Gearhead](../products/planetary-gearboxes/20p-planetary-gearbox.md) | Curtain or blind drive candidate | Check loaded speed, belt friction and output torque |
| [22P 22 mm Gearhead](../products/planetary-gearboxes/22p-planetary-gearbox.md) | Alternative miniature motor interface | Check motor shaft fit, allowable load and cycle time |
| [28P 28 mm Gearhead](../products/planetary-gearboxes/28p-planetary-gearbox.md) | Larger window or roller mechanism | Review opening force, shaft support and manual override |

These are **potential candidates for initial engineering comparison**, not claims of suitability, certification or production deployment. Consult each model's rated torque, stage-dependent ratio and length, output load limit, motor interface and simplified 4-stage STEP reference before design freeze.

[Browse All 12 Precision Planetary Gearheads](../products/planetary-gearboxes/index.md){ .md-button }

## Candidate Frame Orientation for Smart Curtain and Blind OEMs

Use this table only to narrow the first mechanical review. Actual selection depends on loaded motor speed, ratio, curtain / blind mechanics, current limit, noise target and duty cycle.

| Starting frame group | Typical mechanism direction | First engineering checks |
| --- | --- | --- |
| **16P-20P** | slim curtain-track drives, blind tilt mechanisms and compact battery-operated mechanisms | installation diameter, low-noise target, motor speed and available length |
| **20P-28P** | curtain tracks, roller blinds, shades, compact window / vent mechanisms and higher-load smart-home actuators | start-up torque, holding behavior, pulley / tube geometry, current and cycle life |
| **32P+** | larger window, skylight or compact building mechanisms only when load requires the larger frame | output load, wind / seal force, duty cycle, shock / stall behavior and packaging |

The commercial goal is not to force one standard gearbox into every curtain product. For OEM projects, SigGear can review **gearbox-only matching around the customer's existing motor**, including input interface, ratio, output shaft and mounting adaptation.

[See the 3 Planetary Application Families](planetary-gearbox-application-families.md){ .md-button }

## Important Application Boundary

Curtain, blind and window opener devices interact with building structures, moving fabric, ropes, rails, glass panels, user access areas and outdoor conditions. This page provides preliminary actuator-selection guidance only.

Unless explicitly confirmed in writing, SigGear does not assume responsibility for:

- Full curtain, blind, window or sunshade system design
- User safety certification
- Pinch-point or anti-entrapment validation
- Fire, building-code or electrical-code compliance
- Smart-home wireless protocol certification
- Weather sealing or window-structure approval
- Battery-pack approval
- Complete control-board design
- Installation-site reliability
- Final production approval for the customer system

The customer should define system-level safety requirements, obstacle detection, manual override, installation tolerance, end-stop logic, environmental exposure and regulatory obligations before production approval.

## Key Selection Factors

| Requirement | Why it matters |
| --- | --- |
| Load and friction | Curtain weight, blind fabric, rail friction, rope tension and window force define the starting torque. |
| Speed and motion time | Opening and closing time affects ratio, motor speed, current and noise. |
| Holding behavior | Curtains, blinds and windows may need to stay in position without slipping. |
| End-stop behavior | Mechanical end stops, current limit and stall protection affect gearbox life and safety. |
| Noise level | Smart-home and office devices usually require quiet operation. |
| Battery current | Battery-powered blinds and shades need low standby current and controlled peak current. |
| Installation tolerance | Track alignment, fabric load and wall or frame tolerance can change torque demand. |
| Obstacle detection | Safety logic may rely on current sensing, encoder feedback or external sensors. |
| Manual override | Some devices require manual pull, clutch, release, or back-driving behavior. |
| Environment | Indoor, outdoor, humid, dusty or sun-exposed environments affect sealing and material choices. |

## Common Electric Curtain, Blind and Window Opener Use Cases

### Electric Curtain Track Drives

Motorized curtain tracks may use gear motors to drive belt, rope or pulley mechanisms for straight or curved curtains. Provide curtain weight, track length, pulley diameter, target opening time, starting torque, track friction, installation orientation, power supply, noise target and expected daily cycles.

### Roller Blind and Shade Drives

Roller blinds, shades, projection screens and fabric rollers may require compact gear motors inside or near a roller tube. Provide tube diameter, fabric width, fabric weight, roller diameter, lift torque, holding requirement, speed, current limit, duty cycle and whether battery power is used.

### Venetian Blind Tilt Mechanisms

Venetian blinds and louver-style shading devices may need low-torque gear motors to rotate slats or adjust light direction. Provide slat size, number of slats, rotation angle, torque requirement, speed, stop positions, backlash tolerance, noise requirement and end-stop method.

### Smart Blind and Smart Shade Battery Systems

Battery-powered smart blinds require careful motor selection because peak current, stall current and standby consumption affect battery life. Provide battery voltage, current limit, controller limit, motor run time per cycle, daily cycle estimate, charging method and acceptable battery replacement interval.

### Window Opener and Skylight Actuators

Small window openers, skylight actuators, ventilation windows and greenhouse-style opening devices may use gear motors with screw, rack, chain or linkage mechanisms. Provide window mass, hinge position, opening angle, wind load, seal force, required push or pull force, speed, self-locking requirement, outdoor exposure and manual override requirement.

### Sunshade and Awning Adjustment Mechanisms

Sunshade devices, small awnings, shading flaps and façade adjustment systems may use gear motors to move fabric, frames or tilt mechanisms. Provide arm geometry, torque, wind load, operating angle, speed, holding requirement, outdoor exposure, ingress protection target and safety stop behavior.

### Air Opening, Vent Cover and Small Building Automation Mechanisms

Compact building devices may use gear motors for vent covers, service flaps, small access doors, grille movement and air-opening mechanisms. Provide door or flap weight, hinge geometry, seal friction, wind or pressure load, speed, end-stop logic, feedback requirement and installation environment.

## Torque, Speed and Holding Review

Curtain, blind and window opener mechanisms should be reviewed under realistic installed conditions. Rail friction, fabric sagging, rope tension, pulley misalignment, dust, frame distortion, seal friction, wind load and temperature changes can significantly increase the required torque.

Provide:

- Product type and actuator function
- Curtain, blind, shade, louver, window or flap mechanism type
- Required continuous torque
- Required peak torque and peak duration
- Required output speed or opening time
- Travel distance or rotation angle
- Load weight and force direction
- Pulley, drum, screw, gear, rack, chain or linkage geometry
- Holding torque or self-locking requirement
- Back-driving or manual override requirement
- End-stop condition and stall protection method
- Noise target
- Duty cycle and daily open-close cycles
- Required lifetime cycles or service hours

When exact torque is not known, provide drawings, prototype photos, rail friction measurements, manual pull-force measurements, current curves, test videos or installation samples.

## Voltage, Current and Control Review

Smart curtains, blinds and window openers may use battery packs, low-voltage DC supplies, smart-home control boards or customer-designed drivers. Current limit and stall behavior should be defined early because end-stop and obstacle detection often depend on current or position monitoring.

Clarify:

- Nominal operating voltage
- Minimum and maximum voltage range
- Battery-powered or wired power supply
- Peak current limit
- Continuous current limit
- Driver supplied by customer or by SigGear
- Control method
- Open-loop or closed-loop requirement
- Encoder, Hall sensor, limit switch or current-sensing requirement
- Homing method
- End-stop detection method
- Obstacle detection method
- Soft-start or speed-ramp requirement
- Communication interface requirement
- Cable length and connector requirement

Do not assume encoder, brake, clutch, CAN, RS485, wireless protocol or a specific closed-loop control method unless it is included in the selected configuration.

## Noise, Smoothness and User Experience

Curtain, blind and window opener products are often used in bedrooms, offices, hotels, meeting rooms and smart-home environments. Acoustic noise, vibration, motion smoothness and end-stop impact strongly affect user experience.

Define:

- Acceptable operating noise target
- Whether the device is used in bedrooms or quiet rooms
- Smooth start and stop requirement
- End-stop impact requirement
- Gearbox whine sensitivity
- Rail, tube or frame resonance risk
- Allowable speed variation
- Low-speed control requirement
- Required repeatable stop position
- User perception of vibration or clicking

Low-noise performance should be confirmed in the complete customer assembly, because rails, tubes, frames, covers, brackets and hollow building structures can amplify noise.

## Safety, End-Stop and Obstacle Review

Curtain, blind and window opener devices can create pinch points, rope movement, fabric movement, glass movement or outdoor-force conditions. Safety logic should be defined by the customer system design.

Review:

- Pinch-point or entrapment risk
- Maximum allowable force
- Obstacle detection strategy
- Current-limit strategy
- Mechanical clutch or release requirement
- Manual override requirement
- Power-off behavior
- End-stop position and mechanical stop strength
- Gearbox stall duration limit
- Restart after obstruction
- Child-safety or user-safety requirements
- Relevant product or building regulations

SigGear can review actuator configuration, but the customer remains responsible for complete safety validation and certification.

## Environment and Installation Review

Curtain and blind systems are often installed indoors, while window openers, skylights, sunshades and façade mechanisms may face humidity, condensation, temperature change, UV exposure, dust or outdoor weather. Installation variation should be considered during selection.

Provide:

- Indoor or outdoor use
- Wall, ceiling, frame, tube or track installation
- Operating temperature range
- Storage temperature range
- Humidity or condensation exposure
- Dust, lint or fabric-fiber exposure
- UV or sunlight exposure
- Rain, splash or cleaning exposure
- Required ingress protection target
- Wind-load condition
- Installation tolerance range
- Maintenance and replacement plan

Outdoor or semi-outdoor systems require additional review of sealing, cable exit, connector type, shaft corrosion risk and customer enclosure design.

## Output Shaft, Mounting and Mechanism Interface

Curtain, blind and window mechanisms may use custom shafts, D-cut shafts, splines, worm gears, pinions, pulleys, drums, lead screws, brackets or compact flanges. Interface design affects torque transfer, noise, wear and installation stability.

Provide:

- Output shaft shape and length
- D-cut, flat, spline, gear, pinion, pulley, worm, drum or lead-screw requirement
- Shaft load direction
- Radial and axial load estimate
- Distance from load point to gearbox face
- Mounting hole pattern
- Flange or bracket requirement
- Cable exit direction
- Connector or wire harness requirement
- Gearbox orientation
- External bearing support requirement
- Assembly tolerance

External support bearings are recommended when the mechanism creates side load, belt tension, rope tension, screw thrust, chain force, shock load or long overhung loads.

## Candidate SigGear Product Families

### Micro Gear Motors

[Micro Gear Motors](../products/micro-gear-motors/index.md) are a starting point for compact curtain tracks, smart blinds, louver tilt mechanisms, small shades, vent covers and compact window-related actuators. SigGear can evaluate gear ratio, motor voltage, output shaft, cable exit, connector and optional feedback after engineering review.

### 8–42 mm Precision Planetary Gearheads

The [8–42 mm precision planetary gearhead series](../products/planetary-gearboxes/8-42mm-planetary-gear-reducer.md) can be reviewed for compact transmission requirements where ratio, torque, size, backlash target, shaft interface and mounting requirements are defined.

### Flat BLDC Motors and Joint Drives

For slim smart-home devices, low-profile sunshade mechanisms, compact rotary axes or limited axial space, [Flat BLDC Motors and Joint Drives](../products/flat-bldc-motors/index.md) may be reviewed together with gearbox or actuator requirements.

## Prototype and Customization Support

Depending on project scope, SigGear can evaluate:

- Gear ratio selection
- Motor and gearbox matching
- Output shaft customization
- Pulley, gear, pinion or D-cut shaft configuration
- Flange and mounting customization
- Cable and connector customization
- Low-voltage motor configuration
- Low-noise configuration review
- Low-current configuration review
- Feedback or limit-sensor integration after review
- Custom labeling and OEM support
- Prototype support before production planning

Curtain, blind and window opener projects may require several prototype iterations because installation friction, fabric load, track design, rail quality, end-stop logic and customer control-board limits strongly affect final performance.

## Information Needed for Electric Curtain, Blind or Window Opener Review

Please provide one requirement set for each actuator position.

Provide:

- Product type and actuator function
- Curtain, blind, shade, louver, window or flap mechanism type
- Prototype, sample or production-use target
- Load weight or required force
- Required continuous torque
- Peak torque and peak duration
- Required output speed or opening time
- Travel distance or rotation angle
- Pulley, drum, screw, gear, chain or linkage geometry
- Holding torque or self-locking requirement
- Manual override or back-driving requirement
- Maximum diameter and length
- Operating voltage and current limit
- Battery-powered or wired-power design
- Driver or control-board responsibility
- Feedback, homing or limit-switch requirement
- End-stop and obstacle-detection method
- Noise target
- Indoor or outdoor environment
- Dust, humidity, condensation or UV exposure
- Shaft, flange and mounting requirements
- Cable exit and connector requirements
- Duty cycle and lifetime target
- Prototype quantity and estimated annual quantity
- Required customization or OEM branding

## Request a Motorized Curtain, Blind or Window Gearhead Review

Send your electric curtain track, smart blind, roller shade, Venetian blind tilt mechanism, skylight actuator, small window opener, sunshade system or building-automation actuator requirements to SigGear for preliminary model evaluation. Early requirements can be approximate, but actuator function, load or torque, speed, size, voltage, current limit, holding requirement, end-stop logic, environment, duty cycle and quantity are needed before a meaningful recommendation can be made.

**Wanrong Wang**  
International Sales / Sales Engineer, SigGear  
[wangwanrong@siggear.com](mailto:wangwanrong@siggear.com)

[Email Electric Curtain / Blind Requirements](mailto:wangwanrong@siggear.com?subject=Electric%20Curtain%20Blind%20Planetary%20Gear%20Motor%20Review&body=Application%3A%20Electric%20curtain%20%2F%20blind%20%2F%20window%20opener%0AExisting%20motor%20or%20complete%20drive%3A%20%0ALoad%20or%20required%20torque%3A%20%0ARequired%20output%20speed%20or%20opening%20time%3A%20%0AMaximum%20diameter%20and%20length%3A%20%0AOperating%20voltage%3A%20%0APrototype%20quantity%20%2F%20annual%20volume%3A%20%0A%0APlease%20attach%20a%20mechanism%20or%20motor%20drawing%20if%20available.){ .md-button .md-button--primary }
[Start Curtain / Blind Project Brief](../request-cad-sample-quote.md?app=electric_curtain_blind){ .md-button }
