SigGearDrive/SigGear-product-docs/docs/applications/medical-device-micro-gear-motors.md

---
title: Medical Device Micro Gear Motors and Planetary Gearboxes | SigGear
description: Select micro gear motors and planetary gearboxes for medical-device mechanisms by torque, speed, size, noise, feedback, duty cycle, cleaning boundary and service-life requirements.
---

# Micro Gear Motors for Medical and Laboratory Equipment

## Application Overview

Medical devices, dental equipment, diagnostic instruments and laboratory automation systems often use compact motor-and-gearbox assemblies for pumps, valves, dosing systems, sample handling, positioning mechanisms, optical adjustment and small automation axes. A medical device micro gear motor should be selected from the complete motion, load, environment, acoustic, service-life and verification requirement, not from diameter or motor power alone.

SigGear supplies micro gear motor and planetary gearbox solutions that can be evaluated as motion components for medical-device development and laboratory automation. Depending on the selected configuration, the solution may include a motor, reducer, shaft, feedback option, cable, connector and mounting interface after engineering review.

This page is intended for early-stage supplier comparison, model shortlisting and engineering communication. Final motor and gearbox selection, quotation and technical agreement require confirmation against the approved drawing, motor matching, shaft load, duty cycle, environmental condition and ordered version.

## Compare Published SigGear Gearhead Models

These Micro-class gearheads are **potential component-level starting points** for diagnostic and small medical mechanisms. The OEM remains responsible for device safety, cleaning, approvals and complete-system validation.

| Frame and specification page | Example mechanism for evaluation | Engineering checks |
| --- | --- | --- |
| [8P 8 mm Gearhead](../products/planetary-gearboxes/8p-planetary-gearbox.md) | Very small instrument adjustment | Check travel, precision and envelope |
| [10P 10 mm Gearhead](../products/planetary-gearboxes/10p-planetary-gearbox.md) | Compact diagnostic positioning | Review noise, duty and motor integration |
| [12P 12 mm Gearhead](../products/planetary-gearboxes/12p-planetary-gearbox.md) | Auxiliary micro dosing or valve mechanism | Check load cycle, cleaning boundary and shaft load |

These are **potential candidates for initial engineering comparison**, not claims of suitability, certification or production deployment. Consult each model's rated torque, stage-dependent ratio and length, output load limit, motor interface and simplified 4-stage STEP reference before design freeze.

[Browse All 12 Precision Planetary Gearheads](../products/planetary-gearboxes/index.md){ .md-button }

## Key Selection Factors for Medical and Laboratory Motion

| Requirement | Why it matters |
| --- | --- |
| Motion function | Pumping, valve actuation, dosing, indexing and positioning create different torque-speed cycles. |
| Output torque and speed | Determines gearbox ratio, motor operating point, current, heat and motion response. |
| Installation envelope | Medical and lab equipment often has strict diameter, length, shaft and cable-routing limits. |
| Noise and vibration | Important for dental devices, bedside equipment, diagnostic instruments and laboratory environments. |
| Positioning and feedback | Affects repeatability, dosing accuracy, sample handling and closed-loop control. |
| Duty cycle and thermal behavior | Determines whether the selected motor can operate repeatedly without overheating. |
| Cleaning and environment | Chemicals, humidity, contamination control and enclosure design affect material and sealing review. |
| Service life and reliability | Cycle count, load spectrum and maintenance concept affect motor and gearbox selection. |
| Compliance boundary | Component selection does not automatically establish medical-device certification. |

## Common Medical and Laboratory Use Cases

### Pumps and Dosing Mechanisms

Pump and dosing applications should define required flow rate, pressure, stroke, torque, speed, duty cycle and expected fluid-path resistance. The motor and gearbox must be reviewed together with the pump mechanism, seals, tubing, valves and controller current limit.

### Valve Actuation

Valve actuation may require short motion, holding torque, precise stop position or high cycle life. Provide valve torque, operating angle, actuation time, holding condition, stall protection strategy and whether position feedback is required.

### Sample Handling and Laboratory Automation

Sample handling systems may use micro gear motors for small linear axes, rotary indexing, rack movement, pipetting mechanisms, carousel motion and compact pick-and-place mechanisms. Positioning accuracy, repeatability, backlash and control method should be defined early.

### Dental and Handheld Instruments

Dental and handheld instruments often prioritize compact size, low noise, low vibration, weight, thermal comfort and service life. Do not evaluate the drive only by rated power. Confirm the actual load, speed, run time, duty cycle, housing, cooling path and user-facing acoustic requirement.

### Optical, Diagnostic and Precision Adjustment Axes

Diagnostic instruments, optical devices and precision adjustment mechanisms may require smooth low-speed motion, repeatable positioning and low vibration. Encoder location, gearbox backlash, structure stiffness and controller tuning all influence final system performance.

## Motion Function and Load Definition

Describe the mechanism and its operating function, such as linear positioning, rotary indexing, valve actuation, pumping, sample transfer, focusing or optical adjustment. Provide:

- Continuous load
- Peak load and peak duration
- Holding requirement
- Friction or preload condition
- Motion angle, stroke or travel distance
- Full motion sequence
- Expected abnormal load or stall condition

A compact motor that works in one mechanism may be unsuitable in another if load direction, friction, duty cycle or heat dissipation changes.

## Output Torque, Speed and Ratio Selection

State the required continuous and peak output torque, rated speed, maximum speed, acceleration and cycle time at the gearbox output. A higher reduction ratio may increase available output torque, but it normally reduces output speed and can affect efficiency, backdrivability, noise and positioning response.

Useful information includes:

- Required output speed under load
- Maximum speed during fast motion
- Acceleration and deceleration profile
- Continuous torque during motion or holding
- Peak torque and allowed duration
- Available voltage and current limit
- Required reduction ratio if already defined

Peak torque and peak current should not be treated as continuous working ratings.

## Installation Envelope and Mechanical Interface

Provide the maximum motor and gearbox diameter, total length, shaft extension, mounting interface, cable-routing space and connector location. Encoders, brakes, connectors, housings, customer-side bearings and covers must be included in the available envelope.

Important mechanical details include:

- Maximum diameter and total length
- Shaft diameter, shaft length and shaft shape
- Output shaft load direction
- Radial load, axial load and distance from bearing support
- Mounting holes, flange or housing interface
- Cable exit direction and connector requirement
- Whether the customer mechanism includes external bearing support

Radial and axial loads must be reviewed separately from output torque, especially when cams, pulleys, belts, screws or offset mechanisms are used.

## Noise, Vibration and Human-Facing Equipment

Provide the acoustic target, measurement distance, operating load, speed and installation condition. Noise and vibration depend on the selected motor, gearbox, ratio, mounting structure, control method, duty cycle and operating point.

Important review items include:

- Target noise level or comparison reference
- Measurement distance and test environment
- Operating speed and load during measurement
- Mounting stiffness and enclosure design
- Required low-vibration behavior
- Whether the equipment is handheld, desktop, bedside or enclosed

Published noise values must not be assumed without configuration-specific test data.

## Positioning, Feedback and Control

Specify positioning accuracy, repeatability, allowable backlash and feedback requirements. Encoder location, gearbox backlash, structural stiffness, controller tuning and assembly tolerance all influence completed-system performance.

Confirm:

- Open-loop or closed-loop control
- Hall sensor, encoder or no feedback
- Motor-side or output-side feedback requirement
- Position, speed or current-control mode
- Homing method and end-stop strategy
- Stall detection or overload protection
- Required communication interface if a driver is included

Driver, encoder and communication functions vary by selected configuration and quotation.

## Cleaning, Materials and Environmental Conditions

State any requirements related to cleaning agents, contamination control, humidity, ingress protection, material restrictions, lubricants or sterilization exposure. Compatibility must be reviewed for the selected configuration.

Do not assume the following unless documented for the selected model and project scope:

- Sterilization compatibility
- Biocompatibility
- Medical-grade material approval
- Specific cleaning-chemical resistance
- Ingress protection rating
- Low-particle or cleanroom suitability
- Food-contact or fluid-contact suitability

If the drive is outside the fluid path or patient-contact area, define the separation boundary clearly.

## Duty Cycle, Thermal Behavior and Service Life

Provide operating time, rest time, start-stop frequency, load spectrum, ambient temperature and cooling method. Medical and laboratory equipment may require long cycle life, quiet operation and stable performance over repeated use.

Useful information includes:

- Cycle time and rest time
- Number of cycles per day
- Expected total service-life cycle count
- Daily operating hours
- Ambient temperature
- Enclosed or ventilated installation
- Load spectrum and worst-case condition
- Maintenance or replacement concept

Service-life estimates are configuration-specific and require an approved load profile and supporting test or calculation data.

## Candidate SigGear Product Families

### Micro Gear Motors

SigGear micro gear motor configurations can be evaluated for compact pumps, valves, sample-handling mechanisms, dosing systems, dental equipment mechanisms, diagnostic instruments and laboratory automation.

[Explore micro gear motors](../products/micro-gear-motors/index.md)

### 8–42 mm Planetary Gearboxes

The [8–42 mm planetary gearbox](../products/planetary-gearboxes/8-42mm-planetary-gear-reducer.md) series provides multiple frame sizes for integration with brushed DC, brushless DC, stepper or servo motors. Final ratios, dimensions and performance values depend on the selected configuration.

## Medical-Device Integration Boundary

SigGear products described on this site are motion components. Selection of a motor or gearbox does not by itself establish compliance of the completed medical or laboratory device.

The equipment manufacturer is responsible for completed-system requirements, including applicable risk management, electrical and mechanical safety, EMC, software and control validation, cleaning or sterilization validation, material and biocompatibility review, traceability, labeling and regulatory approval.

Component documentation is supplied according to the selected model and agreed project scope. Do not infer medical-device certification, sterilization compatibility, cleanroom suitability, fluid-contact suitability or biocompatibility from general company or quality-management certificates.

## Prototype and Customization Support

Depending on project requirements and engineering feasibility, SigGear can evaluate:

- Motor and planetary gearbox matching
- Reduction-ratio selection
- Output-shaft and mounting-interface customization
- Encoder, brake, cable and connector options
- Housing and mechanical-integration requirements
- Low-noise configuration review after testing
- Customer branding and labeling
- Prototype support before production planning

Customization availability depends on technical feasibility, prototype quantity, expected annual volume and the level of engineering change required.

## Information Needed for a Medical or Laboratory Motion Review

Please provide one requirement set for each axis or mechanism.

Provide:

- Equipment type and application
- Motion function: pump, valve, dosing, positioning, sample handling or other
- Required continuous and peak load
- Output torque and speed
- Operating voltage and current limit
- Motion stroke, angle or travel distance
- Maximum diameter and total length
- Shaft, mounting and cable requirements
- Radial and axial load conditions
- Positioning, backlash and feedback requirements
- Noise and vibration target
- Duty cycle and ambient condition
- Cleaning, material, fluid-path or sterilization boundary
- Expected service life or cycle count
- Prototype quantity and estimated annual quantity

## Related Products and Inquiry

[Micro Gear Motors](../products/micro-gear-motors/index.md){ .md-button .md-button--primary }
[8–42 mm Planetary Gearboxes](../products/planetary-gearboxes/8-42mm-planetary-gear-reducer.md){ .md-button }
[Request CAD, Sample and Quote](../request-cad-sample-quote.md){ .md-button }

## Request a Medical or Laboratory Motion Review

Send your medical device or laboratory automation motion requirements to SigGear for preliminary model evaluation. Early requirements can be approximate, but motion function, load, speed, size, voltage, noise target, duty cycle and quantity are needed before a meaningful recommendation can be made.

**Wanrong Wang**  
International Sales, SigGear  
[wangwanrong@siggear.com](mailto:wangwanrong@siggear.com)

[Send Medical or Laboratory Equipment Requirements](../contact.md){ .md-button .md-button--primary }
