SigGearDrive/SigGear-product-docs/docs/applications/robot-gripper-gear-motors.md

---
title: Planetary Gearboxes & Gear Motors for Dexterous Hands and Robot Grippers | SigGear
description: Select 8–42 mm planetary gearboxes and motor-matched gear drives for dexterous hands and robot grippers by finger force, tendon geometry, torque, speed, shaft loads, backlash and packaging.
---

# Planetary Gearboxes and Gear Motors for Dexterous Hands and Robot Grippers

## Application Overview

Dexterous robotic hands, robot grippers and compact end effectors often need small geared drives for finger joints, tendon spools, rotary jaws, lead screws and other precision mechanisms.

For SigGear's current overseas focus, the primary starting point is the **8–42 mm miniature and compact planetary gearbox range**, either as gearbox-only supply for an existing motor or as a motor-matched gearbox assembly after engineering review.

A suitable drive must still be selected from the complete mechanism requirement, including force, speed, geometry, shaft load, backlash, noise, duty cycle, feedback and installation space.

[Find Published Gearbox Candidates](../selection-guides/miniature-planetary-gearbox-selection-guide.md?app=dexterous_hand_gripper#preliminary-ratio-stage-finder){ .md-button .md-button--primary }
[Compare 8–42 mm Planetary Gearboxes](../products/planetary-gearboxes/8-42mm-planetary-gear-reducer.md){ .md-button .md-button--primary }
[Download Public STEP CAD](../engineering-resources/planetary-gearboxes/public-cad-release-v1.md){ .md-button }
[Start Dexterous Hand / Gripper Project Brief](../request-cad-sample-quote.md?app=dexterous_hand_gripper){ .md-button }

## Compare Published SigGear Gearhead Models

Finger joints, tendon spools and rotary grippers require different mechanical calculations. Choose from **published gearhead frame candidates** only after assessing gripping force, geometry, shaft loading and allowable envelope.

| Frame and specification page | Example mechanism for evaluation | Engineering checks |
| --- | --- | --- |
| [8P 8 mm Gearhead](../products/planetary-gearboxes/8p-planetary-gearbox.md) | Very small finger or auxiliary axis | Check tendon load, radial force and overall length |
| [14P 14 mm Gearhead](../products/planetary-gearboxes/14p-planetary-gearbox.md) | Compact finger/tendon integration | Review required ratio, backdrivability and backlash |
| [20P 20 mm Gearhead](../products/planetary-gearboxes/20p-planetary-gearbox.md) | Small gripper rotary mechanism | Check continuous torque and output support |
| [32P 32 mm Gearhead](../products/planetary-gearboxes/32p-planetary-gearbox.md) | Higher-load compact gripper | Verify shock load, diameter and bearing support |

These are **potential candidates for initial engineering comparison**, not claims of suitability, certification or production deployment. Consult each model's rated torque, stage-dependent ratio and length, output load limit, motor interface and simplified 4-stage STEP reference before design freeze.

[Browse All 12 Precision Planetary Gearheads](../products/planetary-gearboxes/index.md){ .md-button }

## Where to Start by Gearbox Size

Use this only as an early packaging filter. Final selection must use the exact model's rated torque, ratio, length, shaft-load and motor-interface data.

| Starting frame group | Typical mechanism direction | What to verify first |
| --- | --- | --- |
| **8P-16P — Micro Precision** | finger joints, tendon spools, miniature auxiliary axes and highly space-constrained mechanisms | torque margin, radial load, gearbox length and motor interface |
| **20P-28P — Compact OEM** | larger finger mechanisms, compact jaws, rotary grippers and end effectors | continuous torque, speed, backlash, spool / jaw geometry and duty cycle |
| **32P-42P — Higher-load grippers** | larger grippers or compact mechanisms with higher torque demand | whether the larger diameter is acceptable, output bearing load, shock / jam load and motor power |

For a dexterous-hand program, the target should normally be the **smallest frame that passes the complete load and life requirement**, not simply the smallest available diameter.

[See the 3 Planetary Application Families](planetary-gearbox-application-families.md){ .md-button }

## Main Selection Factors

### Gripping Force and Mechanism Geometry

Provide fingertip force, jaw force, lever arm, pulley radius, tendon spool radius, screw lead or linkage geometry. The required gearbox output torque depends on the complete mechanical transmission path.

### Output Torque and Speed

Define continuous torque, peak torque, peak duration, closing speed, opening speed and complete motion cycle. A higher reduction ratio can increase torque capability but usually reduces output speed.

### Tendon Spool and Shaft Loads

Tendon-driven hands can generate radial load on the output shaft and bearing system. Provide tendon force, spool diameter, load direction and distance from bearing support. Radial and axial loads must be reviewed separately from output torque.

### Compact Size and Weight

Dexterous hands and small grippers often have strict packaging requirements. Confirm:

- Maximum diameter
- Total length
- Shaft extension
- Mounting interface
- Cable routing
- Encoder and connector space
- Weight limit

### Backdrivability and Manual Motion

If the finger or gripper must move when power is removed, specify the required backdrivability behavior. Backdrivability depends on motor selection, gearbox ratio, friction, mechanism and controller configuration.

### Backlash and Positioning

Specify backlash, repeatability, positioning accuracy and force-control requirements. Complete-system performance depends on gearbox backlash, structure stiffness, tendon elasticity, encoder position and controller tuning.

## Candidate SigGear Product Families

### 8–42 mm Miniature and Compact Planetary Gearboxes

Use the standard planetary series as the first reference when the project needs a compact gearbox-only solution or a motor-matched assembly.

Possible mechanism types include:

- Finger joints
- Tendon spools
- Compact rotary jaws
- Small end effectors
- Sensor or auxiliary positioning axes

Selection still depends on the required torque, speed, ratio, stage count, shaft load and installation envelope.

[Compare 8–42 mm Planetary Gearboxes](../products/planetary-gearboxes/8-42mm-planetary-gear-reducer.md){ .md-button .md-button--primary }
[Planetary Gearbox Selection Guide](../selection-guides/miniature-planetary-gearbox-selection-guide.md?app=dexterous_hand_gripper#preliminary-ratio-stage-finder){ .md-button }

### Micro Gear Motors and Motor-Matched Assemblies

Where the motor has not yet been fixed, SigGear can review a compact motor + planetary gearbox combination.

If a motor is already selected, send its drawing, loaded speed, shaft dimensions and mounting interface for gearbox matching.

[Explore micro gear motors](../products/micro-gear-motors/index.md)

## Dexterous Hand and Gripper Integration Review

For tendon-spool and cantilever-load applications, the output shaft and bearing arrangement must be reviewed carefully. External bearings or additional support structures may be required when radial load is significant.

Important engineering questions:

- Is the mechanism tendon-driven or direct-drive?
- What is the required gripping force?
- What is the tendon or spool diameter?
- Is manual movement required when power is off?
- Is force control required?
- What encoder and driver functions are needed?
- What noise and service-life targets apply?

## Noise and Service Life

Noise performance and service life depend on the selected motor, gearbox ratio, load spectrum, lubrication, assembly condition and operating environment. Use measured data from the selected configuration rather than assuming a product-family value.

## Prototype and Customization Support

SigGear can evaluate:

- Motor and planetary gearbox matching
- Reduction-ratio selection
- Output shaft and spool interface customization
- Mounting structure customization
- Encoder, cable and connector options
- Customer branding and labeling

Customization availability depends on technical feasibility, prototype quantity and production requirements.

## Information Required for Selection Review

Please provide:

- Gripper or hand type
- Required fingertip or jaw force
- Mechanism geometry
- Tendon or spool dimensions
- Continuous and peak output torque
- Output speed
- Operating voltage
- Diameter and length limits
- Radial and axial loads
- Backlash and positioning requirements
- Backdrivability requirement
- Encoder and driver requirements
- Duty cycle
- Prototype quantity and annual forecast

## Related Products and Inquiry

[Micro Gear Motors](../products/micro-gear-motors/index.md){ .md-button .md-button--primary }
[8–42 mm Planetary Gearboxes](../products/planetary-gearboxes/8-42mm-planetary-gear-reducer.md){ .md-button }
[Miniature Planetary Gearbox Selection Guide](../selection-guides/miniature-planetary-gearbox-selection-guide.md?app=dexterous_hand_gripper#preliminary-ratio-stage-finder){ .md-button }
[Micro Robotics Gear Motors](micro-robotics-gear-motors.md){ .md-button }
[Start Dexterous Hand / Gripper Project Brief](../request-cad-sample-quote.md?app=dexterous_hand_gripper){ .md-button }

## Request a Gripper Drive Selection Review

Send your gripper requirements to SigGear for a preliminary model review.

**Wanrong Wang**  
International Sales, SigGear  
[wangwanrong@siggear.com](mailto:wangwanrong@siggear.com)

[Email Dexterous Hand / Gripper Requirements](mailto:wangwanrong@siggear.com?subject=Dexterous%20Hand%20Robot%20Gripper%20Planetary%20Gearbox%20Review&body=Application%3A%20Dexterous%20hand%20%2F%20robot%20gripper%0AMechanism%3A%20finger%20joint%20%2F%20tendon%20spool%20%2F%20rotary%20jaw%20%2F%20other%0ARequired%20gripping%20force%20or%20output%20torque%3A%20%0ARequired%20output%20speed%3A%20%0AMaximum%20diameter%20and%20length%3A%20%0AExisting%20motor%20or%20complete%20drive%3A%20%0APrototype%20quantity%20%2F%20annual%20volume%3A%20%0A%0APlease%20attach%20a%20mechanism%20or%20motor%20drawing%20if%20available.){ .md-button .md-button--primary }
[Start Dexterous Hand / Gripper Project Brief](../request-cad-sample-quote.md?app=dexterous_hand_gripper){ .md-button }
