SigGearDrive/SigGear-product-docs/docs/company/about-siggear.md

---
title: About SigGear | Precision Gear Drives and Robot Joint Actuators
description: Learn about SigGear precision transmission products, in-house machining, assembly, testing and OEM/ODM engineering support for robotics and automation.
---

# About SigGear

Guangdong SigGear Drive Intelligent Technology Co., Ltd. specializes in compact precision gear transmission products and engineering support for robotics, smart hardware, automation and other products that require small motors, gearboxes or integrated drive solutions.

## Company Website and Technical Resources

- [SigGear official commercial website](https://www.siggear.com/) — company profile and general product catalog.
- [8–42 mm micro, miniature and compact planetary gearboxes](../products/planetary-gearboxes/8-42mm-planetary-gear-reducer.md) — published mechanical gearbox models, Datasheets and CAD entry points.
- [Planetary gearbox ratio and stage selector](../selection-guides/miniature-planetary-gearbox-selection-guide.md#preliminary-ratio-stage-finder) — preliminary selection using verified model and stage data.
- [Contact SigGear engineering](../request-cad-sample-quote.md) — send a configuration and manufacturing review request.

The commercial website and the public engineering documentation serve different purposes. The gearbox-only specification, motor-matched assembly and configuration-dependent engineering limits should not be treated as interchangeable.

## Product Categories

- Integrated robot joint actuators
- Cycloidal reducers
- Planetary gearboxes
- Micro planetary gearboxes and gear motors
- Motor + gearbox integration
- Hub gear motors

## Manufacturing Capability

SigGear provides OEM and ODM customization services, including mechanical customization, size customization, logo customization and packaging customization.

The company operates its own production lines covering precision machining, assembly and testing processes.

A separate evidence page publishes reviewed real photographs from SigGear's machining, gear-processing, assembly and quality-inspection environment. These images are used as manufacturing evidence without turning them into unsupported product-performance claims.

[View Manufacturing & Quality Evidence](manufacturing-and-quality-evidence.md){ .md-button .md-button--primary }

## Engineering and Project Support

For applicable projects, SigGear can start from a customer's concept, drawing, existing motor or installation constraints and review the transmission approach with the engineering team.

The review may include motor, reducer, encoder and driver integration, mechanical interfaces, reduction ratios, output shafts, housings, cable arrangements and other configuration details supported by the selected product family.

Prototype manufacturing, testing and design refinement can be used where required before the configuration is prepared for production. Final feasibility and specifications depend on the application requirements, selected structure, quantity and engineering review.

[Prototype to Design-In and Production](../custom-engineering/prototype-to-production.md){ .md-button }

Some custom development projects are confidential and cannot be shown publicly. SigGear therefore uses reviewed standard products, engineering resources, manufacturing information and test data to make its capabilities visible without exposing customer designs.

[Custom Transmission Engineering](../custom-engineering/index.md){ .md-button .md-button--primary }
[View Robot Joint Actuators](../products/robot-joint-actuators/index.md){ .md-button }
[Browse Precision Gearbox Products](../products/index.md){ .md-button }
[Request CAD, Sample and Quote](../request-cad-sample-quote.md){ .md-button }
