SigGearDrive/SigGear-product-docs/docs/applications/laboratory-automation-diagnostic-equipment-gear-motors.md

---
title: Laboratory Automation and Diagnostic Equipment Gear Motors | SigGear
description: Select compact gear motors and planetary gearboxes for laboratory automation and diagnostic equipment by motion function, positioning, noise, vibration, duty cycle and environmental requirements.
---

# Laboratory Automation and Diagnostic Equipment Gear Motors

## Application Overview

Laboratory automation and diagnostic equipment often uses compact gear motors and precision transmission components for sample handling, reagent dispensing, valve movement, pump assistance, tube positioning, carousel rotation, rack movement, tray loading, optical-module adjustment, cap handling, mixing, stirring and small inspection mechanisms.

These systems usually require precise low-speed motion, repeatable positioning, low vibration, controlled current, compact size, stable service life and predictable behavior during frequent start-stop operation. In many projects, the motor and gearbox must also be reviewed together with acoustic noise, contamination control, cleaning conditions, liquid exposure, thermal behavior, cable routing and machine-level validation requirements.

SigGear can evaluate micro gear motors, compact planetary gearboxes, flat BLDC motors and customized motor/gearbox assemblies for laboratory automation, diagnostic analyzers, sample-preparation systems, reagent systems, compact pumps, valve mechanisms and inspection-device motion axes. Final model selection, medical or laboratory compliance boundary, validation responsibility and production approval must be confirmed case by case.

[Find Published Gearbox Candidates](../selection-guides/miniature-planetary-gearbox-selection-guide.md#preliminary-ratio-stage-finder){ .md-button .md-button--primary }
[Compare 8–42 mm Planetary Gearboxes](../products/planetary-gearboxes/8-42mm-planetary-gear-reducer.md){ .md-button .md-button--primary }
[Download Public STEP CAD](../engineering-resources/planetary-gearboxes/public-cad-release-v1.md){ .md-button }
[Start Laboratory Automation Project Brief](../request-cad-sample-quote.md?app=laboratory_automation){ .md-button }

## Planetary Gearbox Starting Point for Laboratory Automation

For many small laboratory mechanisms, the first Design-In question is packaging: how much diameter and axial length are available near the sample, reagent or motion axis?

| Starting frame group | Typical laboratory mechanism direction | First engineering checks |
| --- | --- | --- |
| **8P–16P — Micro Precision** | miniature valves, optical adjustments, small dosing mechanisms, compact covers and micro positioning axes | size, backlash, output load, motor interface, noise and cycle life |
| **20P–24P — Compact OEM** | sample trays, small carousels, reagent mechanisms, cap handling, compact pumps and higher-load axes | continuous torque, cycle time, output shaft support, vibration and thermal behavior |
| **28P+** | use only when the mechanism genuinely requires the larger frame or higher torque | packaging, load support, inertia, duty cycle and whether a smaller mechanism redesign is preferable |

For laboratory and diagnostic equipment, the commercial target is usually **the smallest gearbox that passes the complete load, precision and life requirement**, not simply the largest available torque class.

If the equipment team already has a motor, SigGear can review the gearbox around the existing motor drawing and loaded speed instead of replacing the complete drive.

[See the 3 Planetary Application Families](planetary-gearbox-application-families.md){ .md-button }
[Motor + Gearbox Integration](../custom-engineering/motor-gearbox-integration.md){ .md-button }

## Important Application Boundary

Laboratory automation and diagnostic equipment may be used in regulated environments. The actuator is only one component inside the full machine. This page provides preliminary selection guidance for motor and transmission review only.

Unless explicitly confirmed in writing, SigGear does not assume responsibility for:

- Diagnostic accuracy or clinical performance
- Medical-device certification
- Laboratory-equipment certification
- Biocompatibility approval
- Sterilization validation
- Chemical compatibility validation
- Liquid-path validation
- Sample contamination validation
- Safety interlock design
- Full-machine electrical safety approval
- Final equipment validation or market approval

For diagnostic, laboratory or medical-adjacent projects, the customer should define the equipment-level requirements, applicable standards, validation plan and regulatory responsibilities before production approval.

## Key Selection Factors

| Requirement | Why it matters |
| --- | --- |
| Motion function | Sample racks, valves, pumps, optical modules and reagent mechanisms require different torque-speed profiles. |
| Positioning accuracy | Diagnostic and laboratory equipment often needs repeatable positioning, homing and low backlash. |
| Low vibration | Optical, liquid-handling and measurement systems may be sensitive to vibration and torque ripple. |
| Noise target | Laboratory, hospital and desktop instruments often require quiet operation. |
| Duty cycle | Frequent start-stop cycles require thermal and lifetime review. |
| Liquid exposure | Reagents, cleaning fluids and condensation affect motor, gearbox, cable and connector choices. |
| Chemical exposure | Solvents, disinfectants and cleaning agents may require additional material review. |
| Contamination control | Sample, reagent and powder areas may require separated actuator placement and enclosure design. |
| Feedback requirement | Encoder, limit switch, Hall sensor, homing switch or current feedback may be required. |
| Validation boundary | The customer must define whether the actuator is used in regulated or non-regulated equipment. |

## Common Laboratory and Diagnostic Equipment Use Cases

### Sample Rack and Tray Movement

Sample analyzers, preparation systems and compact automation platforms may use gear motors to move racks, trays, slides, cartridges or small carriers. Provide sample load, travel distance, speed, stopping accuracy, duty cycle, vibration target, homing method, jam condition and available space.

### Reagent Dispensing and Dosing Mechanisms

Diagnostic equipment and lab instruments may use gear motors to drive dosing wheels, reagent pumps, syringe drives, peristaltic mechanisms, plungers, metering cams or compact dispensing mechanisms. Provide volume target, flow rate, pressure, viscosity, speed, torque, duty cycle, cleaning exposure and liquid-path boundary.

### Valve, Diverter and Fluid-Control Motion

Rotary valves, selector valves, pinch valves, diverters and manifold mechanisms may require compact gear motors with controlled torque and repeatable position. Provide rotation angle, required torque, sealing force, fluid pressure, medium type, cleaning method, duty cycle, homing method and fail-safe requirement.

### Carousel, Indexing and Tube Positioning

Sample carousels, reagent carousels, tube holders, cartridge wheels, cuvette systems and indexing platforms may use gearboxes for low-speed rotation and repeatable indexing. Provide inertia, load mass, diameter, speed, acceleration, stop accuracy, backlash target, radial load and expected lifetime cycles.

### Optical Module and Sensor Adjustment

Diagnostic readers, imaging instruments and compact inspection devices may require gear motors for focus adjustment, filter wheels, aperture drives, mirror adjustment, sample-stage movement, camera positioning or sensor-alignment axes. Provide positioning accuracy, backlash target, vibration sensitivity, speed, load, homing method and allowable noise.

### Cap Handling, Door and Cover Mechanisms

Lab automation and diagnostic machines may require compact actuators for cap opening, cap closing, cover movement, reagent-door operation, waste-bin covers, cartridge doors or service doors. Provide required force, hinge geometry, speed, jam condition, safety interlock requirement, manual override and power-off behavior.

### Mixing, Stirring and Agitation

Sample preparation, reagent preparation and compact lab devices may use gear motors for small stirrers, mixers, shakers, agitation mechanisms or magnetic-coupling assistance. Provide fluid viscosity, mixing speed, start torque, continuous duty time, noise target, cleaning method and lifetime target.

## Torque, Speed and Motion Review

Laboratory and diagnostic equipment should be reviewed under realistic load and motion conditions. Short movements, frequent starts, small positioning errors, fluid resistance, cap friction, tube misalignment and jam conditions can affect the actual motor requirement.

Provide:

- Equipment type and actuator location
- Motion function
- Mechanism type
- Required continuous torque
- Required peak torque and peak duration
- Required output speed or cycle time
- Stroke length or rotation angle
- Required positioning accuracy
- Backlash or lost-motion target
- Load mass and mechanism geometry
- Jam, stall or overload condition
- Operating direction and duty cycle
- Required lifetime cycles or service hours

When exact torque data is not available, provide drawings, prototype videos, force measurements, current curves or test data from the existing mechanism.

## Voltage, Current and Control Review

Laboratory instruments may use internal DC power supplies, control boards, motion controllers or customer-designed drivers. Current limit, acoustic noise and thermal behavior should be reviewed together.

Clarify:

- Nominal operating voltage
- Minimum and maximum voltage range
- Peak current limit
- Continuous current limit
- Driver supplied by customer or by SigGear
- Control method
- Required speed control or position control
- Feedback requirement
- Homing or limit-switch method
- Stall detection or jam detection method
- Brake or holding requirement
- Cable length and routing limit
- Electrical noise or EMC constraints

Do not assume encoder, brake, closed-loop control, CAN, RS485 or a specific protocol unless it is included in the selected motor and driver configuration.

## Noise, Vibration and Precision Review

Many laboratory and diagnostic systems are sensitive to audible noise, vibration, motion ripple and backlash. The acceptable level depends on where the actuator is mounted and whether the motion affects optical reading, liquid handling, sample positioning or user experience.

Define:

- Whether the actuator runs during measurement
- Whether vibration affects optical or sensor readings
- Allowable acoustic noise target
- Maximum backlash or lost motion
- Required repeatability
- Acceleration and deceleration profile
- Whether smooth motion is required
- Whether motion is intermittent or continuous
- Mounting stiffness and enclosure resonance

Low-noise and low-vibration performance should be confirmed by prototype testing in the customer mechanism.

## Liquid, Cleaning and Chemical Exposure Review

Motor location is critical. An actuator behind a sealed enclosure has different requirements from a motor near reagents, samples, cleaning fluids or condensation.

Provide:

- Whether the actuator is inside or outside the wet area
- Reagent, sample or cleaning-fluid exposure
- Condensation or humidity condition
- Cleaning method
- Chemical agents or disinfectants used
- Operating temperature range
- Storage temperature range
- Required ingress protection target
- Cable and connector exposure
- Maintenance and replacement plan

The equipment manufacturer should define liquid-path isolation, contamination control, enclosure sealing, cleaning validation and chemical compatibility requirements. SigGear can review motor, gearbox, shaft, cable and connector configuration after the environment is defined.

## Output Shaft, Mounting and Load Support

Laboratory mechanisms often use custom shafts, gears, screws, cams, pulleys, belts, lead-screw couplings, D-cut shafts, miniature flanges and compact brackets. Shaft load and alignment should be reviewed early, especially for small gearboxes.

Provide:

- Output shaft shape and length
- D-cut, keyway, flat, thread, gear, pulley, cam, lead screw or custom shaft requirement
- Load direction
- Distance from load point to gearbox face
- Radial and axial load estimates
- Jam or shock condition
- Required bearing support
- Flange and mounting hole requirement
- Cable exit direction
- Connector or wire harness requirement
- Installation orientation

External support bearings are recommended when the mechanism creates significant radial load, axial thrust, side load, jam load or impact load.

## Candidate SigGear Product Families

### Micro Gear Motors

[Micro Gear Motors](../products/micro-gear-motors/index.md) are a starting point for compact sample handling, reagent mechanisms, small pumps, valves, covers, flaps, tray movement and precision adjustment axes. SigGear can evaluate miniature planetary gear motors, custom shafts, flanges, cable exits, connectors and optional feedback after engineering review.

### 8-42 mm Planetary Gearboxes

The [8-42 mm planetary gearbox series](../products/planetary-gearboxes/8-42mm-planetary-gear-reducer.md) can be reviewed for compact transmission requirements where ratio, torque, size, backlash target and mounting requirements are defined. Final performance depends on frame size, gear stage, material configuration and operating conditions.

### Flat BLDC Motors and Joint Drives

For low-profile rotary positioning, compact indexing, optical adjustment or limited axial space, [Flat BLDC Motors and Joint Drives](../products/flat-bldc-motors/index.md) may be reviewed together with gearbox or actuator requirements.

## Prototype and Customization Support

Depending on project scope, SigGear can evaluate:

- Gear ratio selection
- Motor and gearbox matching
- Output shaft customization
- Flange and mounting customization
- Cable and connector customization
- Low-voltage motor configuration
- Feedback or sensor integration after review
- Low-noise configuration review
- Low-vibration configuration review
- Moisture-aware configuration review
- Customer branding and labeling
- Prototype support before production planning

Laboratory and diagnostic equipment projects may require additional review of validation boundaries, documentation, traceability, material requirements, inspection requirements and long-term supply planning.

## Information Needed for Laboratory or Diagnostic Equipment Review

Please provide one requirement set for each actuator position.

Provide:

- Equipment type and actuator function
- Whether the equipment is diagnostic, laboratory, research or non-regulated use
- Mechanism type
- Prototype, test fixture or production-use target
- Required torque or force
- Peak torque and peak duration
- Required output speed or cycle time
- Stroke length or rotation angle
- Positioning accuracy and repeatability target
- Backlash target if applicable
- Maximum diameter and length
- Operating voltage and current limit
- Driver or control-board responsibility
- Feedback, homing or limit-switch requirement
- Noise and vibration target
- Liquid, reagent, cleaning or chemical exposure
- Operating temperature range
- Shaft, flange and mounting requirements
- Jam or stall-protection requirement
- Duty cycle and lifetime target
- Validation, documentation or inspection requirements
- Prototype quantity and estimated annual quantity
- Required customization or OEM branding

## Related Products and Inquiry

[Micro Gear Motors](../products/micro-gear-motors/index.md){ .md-button .md-button--primary }
[8–42 mm Planetary Gearboxes](../products/planetary-gearboxes/8-42mm-planetary-gear-reducer.md){ .md-button }
[Flat BLDC Motors](../products/flat-bldc-motors/index.md){ .md-button }
[Request CAD, Sample and Quote](../request-cad-sample-quote.md){ .md-button }

## Request a Laboratory Automation or Diagnostic Equipment Gear Motor Review

Send your sample-handling system, reagent mechanism, compact pump, valve mechanism, carousel, optical-adjustment axis, cap-handling mechanism, tray movement system, diagnostic analyzer or laboratory automation actuator requirements to SigGear for preliminary model evaluation. Early requirements can be approximate, but actuator function, torque or force, speed, size, voltage, current limit, precision target, environment, duty cycle, validation boundary and quantity are needed before a meaningful recommendation can be made.

**Wanrong Wang**  
International Sales, SigGear  
[wangwanrong@siggear.com](mailto:wangwanrong@siggear.com)

[Send Laboratory or Diagnostic Equipment Gear Motor Requirements](../contact.md){ .md-button .md-button--primary }
