SigGearDrive/SigGear-product-docs/docs/applications/pump-valve-fluid-control-gear-motors.md

---
title: Miniature Planetary Gear Motors for Pumps, Valves & Dosing | SigGear
description: Engineering guide for compact planetary gearboxes and gear motors in pumps, valve actuators and dosing mechanisms, covering torque, speed, pressure, duty cycle, feedback and integration.
---

# Miniature Planetary Gear Motors for Pumps, Valves and Dosing Systems

[Find Published Gearbox Candidates](../selection-guides/miniature-planetary-gearbox-selection-guide.md#preliminary-ratio-stage-finder){ .md-button .md-button--primary }
[Compare 8–42 mm Planetary Gearboxes](../products/planetary-gearboxes/8-42mm-planetary-gear-reducer.md){ .md-button .md-button--primary }
[Download Public STEP CAD](../engineering-resources/planetary-gearboxes/public-cad-release-v1.md){ .md-button }
[Start Pump / Valve Project Brief](../request-cad-sample-quote.md?app=pump_valve_fluid){ .md-button }

## Where to Start by Gearbox Size

The fluid mechanism determines the torque; the gearbox diameter is only the first packaging filter.

| Starting frame group | Typical mechanism direction | First engineering checks |
| --- | --- | --- |
| **8P–16P — Micro Precision** | miniature selector valves, micro pumps, compact dosing mechanisms and instrument fluid-control axes | seal / tube friction, output speed, shaft load, noise and available length |
| **20P–28P — Compact OEM** | rotary valves, peristaltic pump heads, syringe / plunger drives, pinch mechanisms and commercial dosing equipment | pressure-related torque, duty cycle, holding behavior, motor power and output interface |
| **32P+** | higher-load compact industrial valve or pumping mechanisms only when smaller frames cannot meet the load requirement | rated torque, peak load, bearing support, thermal behavior and installation envelope |

A valve or pump project should be selected from **pressure, friction, mechanism geometry, duty cycle and required motion**, not from valve diameter or flow rate alone.

If the customer already has a qualified motor or pump head, SigGear can evaluate a gearbox-only solution around that existing architecture.

[See the 3 Planetary Application Families](planetary-gearbox-application-families.md){ .md-button }
[Motor + Gearbox Integration](../custom-engineering/motor-gearbox-integration.md){ .md-button }

## Application Overview

Miniature pumps, dosing systems, valve actuators and fluid-control mechanisms often need compact gear motors with controlled speed, repeatable positioning, stable torque, low noise and reliable duty-cycle performance. These systems appear in laboratory automation, medical equipment, diagnostic instruments, cleaning devices, analytical machines, compact industrial equipment and smart hardware.

A pump or valve gear motor should be selected from the complete mechanism and fluid-control requirement. The motor, gearbox, pump head, valve type, sealing friction, fluid viscosity, required flow rate, required pressure, duty cycle, environment and controller all affect whether a compact actuator can perform reliably.

SigGear can evaluate micro gear motors, compact planetary gearboxes and motor-integration options for pump, valve and dosing mechanisms. Final model selection, torque rating, speed range, shaft interface, encoder or driver option, noise level and service-life expectation must be confirmed against the selected configuration and application review.

## Key Selection Factors

| Requirement | Why it matters |
| --- | --- |
| Pump or valve type | Peristaltic pumps, diaphragm pumps, syringe drives, rotary valves and pinch valves require different torque-speed behavior. |
| Required flow or motion | Flow rate, dosing volume, stroke length, opening angle or valve travel defines motor speed and ratio. |
| Pressure and sealing load | Back pressure, seal friction and fluid viscosity can increase required torque. |
| Duty cycle | Continuous pumping and repeated valve actuation create different thermal and wear conditions. |
| Size limit | Medical, laboratory and compact devices often restrict diameter, length, cable exit and connector space. |
| Noise and vibration | Human-facing devices and laboratory equipment may require quieter motion. |
| Feedback requirement | Some dosing or valve systems need encoder, Hall sensor, limit switch or homing reference. |
| Holding behavior | Valves, clamps and syringe mechanisms may require holding torque, brake or self-locking mechanism review. |
| Environment | Fluid exposure, cleaning agents, humidity, temperature and contamination risk must be reviewed. |
| Compliance boundary | Medical, food, laboratory and safety compliance are system-level responsibilities unless explicitly confirmed. |

## Common Fluid-Control Use Cases

### Peristaltic Pump Drives

Peristaltic pump drives require the motor and gearbox to overcome tube compression, roller friction and fluid back pressure. Provide tube material, tube diameter, roller count, pump head diameter, target flow rate, continuous operating time, back pressure and noise requirement.

### Diaphragm and Miniature Pump Mechanisms

Diaphragm and compact pump mechanisms may create cyclic load, vibration and peak torque during each stroke. Provide stroke profile, required flow rate, pressure, cam or crank geometry, operating speed, duty cycle and expected service life.

### Syringe, Plunger and Dosing Systems

Dosing systems often require repeatable linear motion through a screw, cam, rack or plunger mechanism. Provide target volume, dosing accuracy target, screw pitch or mechanism geometry, required force, speed, stroke length, feedback requirement and cleaning condition.

### Rotary Valve Actuators

Rotary valves require controlled angle, repeatable end positions, enough torque to overcome seal friction and sometimes position feedback. Provide valve diameter, rotation angle, seal friction, pressure, fluid type, cycle time, required repeatability and homing method.

### Pinch Valve and Clamp Mechanisms

Pinch valves and tubing clamps may require controlled closing force, holding behavior and compact packaging. Provide tube material, tube size, required closing force, stroke distance, holding time, duty cycle and power-off behavior requirement.

### Laboratory Sample Handling

Laboratory automation systems often combine pumps, valves, sample movement, reagent handling and small positioning axes. Define which axis controls fluid movement and which axis controls mechanical positioning, because each may require a different motor and reducer configuration.

## Torque, Speed, Flow and Pressure Review

Fluid-control mechanisms should not be selected from motor power alone. The required torque depends on pump or valve structure, friction, pressure, viscosity, seal condition and mechanism geometry.

Provide:

- Pump or valve type
- Required flow rate, dose volume or valve motion
- Required pressure or back pressure
- Fluid viscosity and temperature
- Continuous torque or estimated force
- Peak torque and peak duration
- Required motor or output speed
- Gear ratio if already specified
- Stroke length or rotation angle
- Acceleration, deceleration and cycle time

When torque is not known, provide drawings, pump-head dimensions, valve drawings, tube data or force test results so the requirement can be reviewed.

## Size, Noise and Integration Constraints

Compact fluid-control devices often have limited internal space and acoustic requirements. The actuator should be checked with motor length, gearbox length, shaft, coupling, bracket, wiring, connector, pump head and service access included.

Provide:

- Maximum diameter and length
- Maximum weight
- Shaft location and shaft type
- Mounting hole pattern
- Cable exit direction
- Connector size and location
- Available bracket or housing space
- Noise target and measurement distance if available
- Vibration sensitivity

Noise depends on motor type, gearbox ratio, load, speed, mounting structure and controller method. Noise targets must be confirmed under the selected configuration and operating condition.

## Feedback, Homing and Control

Fluid-control mechanisms may require speed control, position control, end-stop detection, homing or closed-loop dosing verification. The required control method should be defined before selecting a motor.

Clarify:

- Speed control or position control
- Encoder or Hall sensor requirement
- Limit switch or homing method
- Open-loop or closed-loop control
- Controller supplied by customer or by SigGear
- Communication interface requirement
- Stall detection or overload response
- Power-off position behavior

Do not assume encoder, brake, closed-loop control, CAN, RS485 or another protocol unless it is included in the selected motor and driver configuration.

## Duty Cycle, Heat and Service Life

Pumps and dosing systems may run continuously, while valves may cycle intermittently but require high starting torque. Both conditions should be reviewed separately.

Useful information includes:

- Continuous operating time
- Cycles per minute or hour
- Daily operating hours
- Rest time between cycles
- Peak load events
- Stall or blockage condition
- Ambient temperature
- Enclosed or ventilated installation
- Expected service-life target
- Maintenance or replacement interval

Service-life estimates are configuration-specific and require confirmed load and cycle data.

## Environment and Compliance Boundary

Fluid systems may involve humidity, cleaning agents, disinfectants, reagents, biological samples, temperature changes or splash risk. State whether the actuator is isolated from fluid or exposed to the environment.

Confirm:

- Fluid type and chemical exposure risk
- Cleaning method
- Humidity and condensation risk
- Operating temperature
- Storage temperature
- Splash or leakage possibility
- Medical, laboratory, food or safety compliance requirements

SigGear can support component-level motor and reducer review, but final equipment compliance, fluid-contact material validation, sterilization validation, dosing accuracy validation and safety certification are system-level responsibilities unless specifically agreed in writing.

## Candidate SigGear Product Families

### Micro Gear Motors

[Micro Gear Motors](../products/micro-gear-motors/index.md) are a primary starting point for miniature pumps, valves, dosing mechanisms and compact fluid-control actuators. SigGear can evaluate miniature planetary gear motors, compact reduction motors, motor and gearbox integration, custom output shafts, flanges and mounting interfaces, and optional encoder or cable integration after engineering review.

### 8–42 mm Planetary Gearboxes

The [8–42 mm planetary gearbox series](../products/planetary-gearboxes/8-42mm-planetary-gear-reducer.md) provides compact reducer options for different frame sizes. Final ratio, torque, efficiency, backlash and dimensions depend on the selected frame size, gear stage and configuration.

### Flat BLDC Motors and Joint Drives

For low-profile fluid-control devices, compact pump drives or thin rotary valve mechanisms, [Flat BLDC Motors and Joint Drives](../products/flat-bldc-motors/index.md) may be reviewed together with gearbox or actuator requirements when the axial packaging is limited.

## Prototype and Customization Support

Depending on the project scope, SigGear can evaluate:

- Gear ratio selection
- Motor and gearbox matching
- Output shaft customization
- Flange and mounting customization
- Cable and connector customization
- Encoder or sensor integration after review
- Low-noise configuration review
- Customer branding and labeling
- Prototype support before production planning

Customization availability depends on engineering feasibility, prototype quantity, estimated annual volume and tooling or process requirements.

## Information Needed for a Pump or Valve Gear Motor Review

Please provide one requirement set for each pump, valve or dosing axis.

Provide:

- Pump, valve or dosing mechanism type
- Required flow rate, volume, pressure or motion angle
- Required output torque, force or estimated load
- Peak torque and peak duration
- Required output speed
- Gear ratio if known
- Maximum diameter and length
- Operating voltage and current limit
- Motor type preference
- Shaft, flange and mounting requirements
- Feedback, homing or limit-switch requirements
- Noise and vibration target
- Duty cycle and daily operating time
- Fluid type and environmental condition
- Prototype quantity and estimated annual quantity
- Required customization or OEM branding

## Request a Pump or Valve Gear Motor Review

Send your pump, valve or dosing mechanism requirements to SigGear for preliminary model evaluation. Early requirements can be approximate, but flow or motion requirement, torque or force estimate, pressure, speed, size, voltage, duty cycle, environment and quantity are needed before a meaningful recommendation can be made.

**Wanrong Wang**  
International Sales, SigGear  
[wangwanrong@siggear.com](mailto:wangwanrong@siggear.com)

[Send Pump or Valve Gear Motor Requirements](../contact.md){ .md-button .md-button--primary }

[Start Pump / Valve Project Brief](../request-cad-sample-quote.md?app=pump_valve_fluid){ .md-button .md-button--primary }
