SigGearDrive/SigGear-product-docs/docs/knowledge-base/product-model-index.md

---
title: SigGear Product Model Reference | 8P–42P Planetary Gearboxes
description: Locate real SigGear 8P–42P micro, miniature and compact planetary gearbox model pages, as well as published robot actuators and other product references.
---

# SigGear Product Model Index

Use this page to locate the canonical public page for a SigGear product model or published series. Specifications must be read from the linked canonical page and confirmed for the quoted configuration.

## Robot Joint Actuators

| Model | Public page |
| --- | --- |
| SG-6010C | [SG-6010C](../products/robot-joint-actuators/sg6010c.md) |
| SG-6010HB | [SG-6010HB](../products/robot-joint-actuators/sg6010hb.md) |
| SG-6010D | [SG-6010D](../products/robot-joint-actuators/sg6010d.md) |
| SG-8021 | [SG-8021](../products/robot-joint-actuators/sg8021.md) |

## Cycloidal Joint Modules

| Model | Public page |
| --- | --- |
| CPM-100-25 | [CPM-100-25](../products/cycloidal-joint-modules/cpm100-25.md) |
| CPM-80-25 | [CPM-80-25](../products/cycloidal-joint-modules/cpm80-25.md) |
| CPM-78-39 | [CPM-78-39](../products/cycloidal-joint-modules/cpm78-39.md) |

## 8P–42P Planetary Gearboxes (8–42 mm)

The 12 published nominal frame sizes cover **Micro (8–16 mm)**, **Miniature (20–32 mm)** and **Compact (36–42 mm)** planetary gearboxes. Follow each model link for its own datasheet, stage/ratio table and simplified four-stage STEP reference; dimensions and motor matching are configuration-dependent.

| Model | Public page |
| --- | --- |
| 8P | [8 mm Micro Planetary Gearbox](../products/planetary-gearboxes/8p-planetary-gearbox.md) |
| 10P | [10 mm Micro Planetary Gearbox](../products/planetary-gearboxes/10p-planetary-gearbox.md) |
| 12P | [12 mm Micro Planetary Gearbox](../products/planetary-gearboxes/12p-planetary-gearbox.md) |
| 14P | [14 mm Micro Planetary Gearbox](../products/planetary-gearboxes/14p-planetary-gearbox.md) |
| 16P | [16 mm Micro Planetary Gearbox](../products/planetary-gearboxes/16p-planetary-gearbox.md) |
| 20P | [20 mm Miniature Planetary Gearbox](../products/planetary-gearboxes/20p-planetary-gearbox.md) |
| 22P | [22 mm Miniature Planetary Gearbox](../products/planetary-gearboxes/22p-planetary-gearbox.md) |
| 24P | [24 mm Miniature Planetary Gearbox](../products/planetary-gearboxes/24p-planetary-gearbox.md) |
| 28P | [28 mm Miniature Planetary Gearbox](../products/planetary-gearboxes/28p-planetary-gearbox.md) |
| 32P | [32 mm Miniature Planetary Gearbox](../products/planetary-gearboxes/32p-planetary-gearbox.md) |
| 36P | [36 mm Compact Planetary Gearbox](../products/planetary-gearboxes/36p-planetary-gearbox.md) |
| 42P | [42 mm Compact Planetary Gearbox](../products/planetary-gearboxes/42p-planetary-gearbox.md) |
| 8–42 mm Series | [Series](../products/planetary-gearboxes/8-42mm-planetary-gear-reducer.md) |

## Hub Gear Motors

| Model | Public page |
| --- | --- |
| SG-2877 | [SG-2877](../products/hub-gear-motors/sg2877.md) |
| SG-2878 | [SG-2878](../products/hub-gear-motors/sg2878.md) |

## Product Families

- [Micro gear motors](../products/micro-gear-motors/index.md)
- [Flat BLDC motors and joint drives](../products/flat-bldc-motors/index.md)

## Model Naming Rules

- Preserve official capitalization and punctuation.
- Do not transfer torque, ratio or interface values between different frame sizes.
- Confirm final configuration against the approved specification.
