SigGearDrive/SigGear-product-docs/docs/applications/index.md

---
title: SigGear Applications | Miniature Planetary Gearboxes, Gear Motors & Precision Drives
description: Explore SigGear engineering application guides for 8–42 mm miniature planetary gearboxes, motor-matched gear drives, dexterous hands, smart hardware, medical equipment and other compact OEM mechanisms.
---

# Applications

SigGear's current overseas focus is **miniature and compact planetary gearboxes from 8 mm to 42 mm**, supplied either as gearbox-only units or reviewed together with a matched motor for an OEM mechanism.

These application pages explain **how to select a drive**, not where SigGear claims to have a completed customer case.

!!! note
    Unless a page explicitly states otherwise, an application is a potential engineering use case rather than a published production reference.

[Compare 8–42 mm Planetary Gearboxes](../products/planetary-gearboxes/8-42mm-planetary-gear-reducer.md){ .md-button .md-button--primary }
[Planetary Gearbox Selection Guide](../selection-guides/miniature-planetary-gearbox-selection-guide.md){ .md-button }
[Download Public STEP CAD](../engineering-resources/planetary-gearboxes/public-cad-release-v1.md){ .md-button }

## Start With an Application Family

Before choosing an exact diameter, use the application-led grouping to decide whether the project is primarily **Micro Precision (8P-16P)**, **Compact OEM (20P-28P)** or **High-Torque Compact (32P-42P)**. This does not replace model-level engineering review; it makes the first search and Design-In step faster.

[Planetary Gearbox Application Families](../products/planetary-gearboxes/application-families.md){ .md-button .md-button--primary }

## Featured Miniature Planetary Gearbox Applications

These are the application paths most closely aligned with the current SigGear overseas focus.

### Electric Pruning Shears

Review blade force, lever geometry, cutting peaks, output speed, motor matching, shaft interface and outdoor duty.

[Electric Pruning Shears Planetary Gearbox Guide](electric-pruning-shears-planetary-gearbox.md){ .md-button .md-button--primary }

### Electric Screwdrivers and Fastening Tools

Review normal fastening torque, peak / jam load, output speed, loaded motor speed, battery or supply limits, shaft interface and repeated fastening duty.

[Powered Screwdriver & Fastening Tool Planetary Gearbox Guide](powered-screwdriver-planetary-gearbox.md){ .md-button }

### Electric Curtains, Blinds and Window Openers

Review loaded motor speed, pulley travel, track friction, low-noise requirements, holding behavior, shaft interface and gearbox-only versus motor + gearbox supply.

[Electric Curtain / Blind Gear Motor Guide](electric-curtain-blind-window-opener-gear-motors.md){ .md-button }

### Smart Toilet and Bidet Mechanisms

Review lid / seat / nozzle / flap mechanisms, compact packaging, low noise, jam behavior, holding, humidity, cleaning exposure and motor matching.

[Smart Toilet & Bidet Planetary Gear Motor Guide](smart-toilet-bidet-planetary-gear-motors.md){ .md-button }

### Dexterous Hands and Robot Grippers

Review finger-joint or tendon-spool geometry, gripping force, output torque, speed, radial load, backdrivability, backlash, feedback and packaging.

[Dexterous Hand & Robot Gripper Gear Motor Guide](robot-gripper-gear-motors.md){ .md-button }

### Precision Instruments and Optical Mechanisms

Review compact motion axes for focus, filter wheels, rotary stages, sensor positioning and similar mechanisms where packaging, repeatability, backlash and vibration matter.

[Precision Instrument Gear Motor Guide](precision-instruments-optical-mechanisms.md){ .md-button }

### Medical and Laboratory Equipment

Review compact pumps, valves, dosing, sample handling and positioning mechanisms with attention to speed, noise, duty cycle, cleaning environment and integration boundaries.

[Medical Device Micro Gear Motor Guide](medical-device-micro-gear-motors.md){ .md-button }
[Laboratory Automation Gear Motor Guide](laboratory-automation-diagnostic-equipment-gear-motors.md){ .md-button }

Laboratory automation is a priority **Micro Precision** Design-In route for 8P–24P when packaging, low vibration and repeatable low-speed motion matter.

### Smart Locks and Access Control

Review bolt, latch, cam and release mechanisms by force, stroke, battery current, jam behavior, holding requirement and compact packaging.

[Smart Lock & Access-Control Gear Motor Guide](access-control-smart-lock-security-gear-motors.md){ .md-button }

### Pump, Valve and Dosing Mechanisms

Review peristaltic pumps, syringe / plunger drives, rotary valves and compact dosing mechanisms by pressure, flow, torque, speed, duty cycle and feedback.

[Pump / Valve / Dosing Gear Motor Guide](pump-valve-fluid-control-gear-motors.md){ .md-button }

Pump, valve and dosing projects are a priority **Micro Precision / Compact OEM** route where the customer may already have a qualified motor or pump / valve mechanism.

### Camera Modules, Focus and Zoom Mechanisms

Review focus, zoom, pan-tilt and sensor-positioning axes by backlash, vibration, speed, feedback, packaging and load support.

[Camera Module & Optical Positioning Gear Motor Guide](optical-imaging-camera-module-gear-motors.md){ .md-button }

### Coffee, Beverage and Dispensing Equipment

Review metering, grinder adjustment, valve movement, dosing, cup handling and compact service mechanisms by load, speed, jam condition, noise and cleaning boundary.

[Coffee / Dosing / Dispensing Gear Motor Guide](food-beverage-coffee-equipment-gear-motors.md){ .md-button }

## Robotics and Joint-Drive Applications

These existing pages remain available for relevant projects, but they are no longer the primary overseas growth path for the site.

- [Humanoid Robot Joint Actuators](humanoid-robot-joint-actuators.md) — shoulder, elbow, wrist, hip, knee and ankle actuator selection.
- [Robotic Arm Joint Actuators](robotic-arm-joint-actuators.md) — payload, reach, inertia, torque, brake and control requirements.
- [Exoskeleton Joint Actuators](exoskeleton-joint-actuators.md) — wearable packaging, torque-speed cycle, mass, thermal and power-off behavior.
- [Quadruped Robot Joint Gearboxes](quadruped-robot-joint-gearboxes.md) — gait cycle, peak loads, packaging and thermal review.
- [AGV / AMR Wheel Drive Gearboxes](agv-amr-wheel-drive-gearboxes.md) — vehicle mass, wheel size, speed, slope, traction and braking.
- [Micro Robotics Gear Motors](micro-robotics-gear-motors.md) — compact joints, small mobile robots and miniature mechanisms.

## Automation and Precision Equipment

- [Industrial Automation Servo Planetary Gearboxes](industrial-automation-servo-planetary-gearboxes.md)
- [Packaging, Labeling and Conveyor Gear Motors](packaging-labeling-conveyor-gear-motors.md)
- [Semiconductor, Electronics and Inspection Equipment](semiconductor-electronics-inspection-equipment-gear-motors.md)
- [Optical, Imaging and Camera Module Gear Motors](optical-imaging-camera-module-gear-motors.md)
- [Pump, Valve and Fluid Control Gear Motors](pump-valve-fluid-control-gear-motors.md)

## Smart Home, Building and Consumer Mechanisms

- [Access Control, Smart Lock and Security Gear Motors](access-control-smart-lock-security-gear-motors.md)
- [Consumer Appliance and Home Device Gear Motors](consumer-appliance-home-device-gear-motors.md)
- [HVAC, Smart Vent and Damper Gear Motors](hvac-smart-vent-damper-gear-motors.md)
- [Furniture, Seating and Adjustable Mechanism Gear Motors](furniture-seating-adjustable-mechanism-gear-motors.md)

## Commercial and Device Mechanisms

- [Office Automation and Business Equipment Gear Motors](office-automation-business-equipment-gear-motors.md)
- [Vending, Dispensing and Kiosk Gear Motors](vending-dispensing-kiosk-gear-motors.md)
- [Food, Beverage and Coffee Equipment Gear Motors](food-beverage-coffee-equipment-gear-motors.md)
- [Stage Lighting, Display and Signage Gear Motors](stage-lighting-display-signage-gear-motors.md)

## Mobility, Energy and Outdoor Equipment

- [Automotive and Vehicle Small-Motion Gear Motors](automotive-vehicle-small-motion-gear-motors.md)
- [Energy, Battery and Charging Equipment Actuators](energy-battery-charging-equipment-actuators.md)
- [Agriculture and Outdoor Equipment Gear Motors](agriculture-outdoor-equipment-gear-motors.md)

## What to Send for an Application Review

You do not need a complete specification to start. Send the information already known:

- Application and mechanism
- Required output speed or motion time
- Continuous torque / force or mechanism geometry
- Peak load, jam or impact event if relevant
- Supply voltage
- Maximum diameter and total length
- Existing motor model / drawing if already selected
- Output shaft and mounting requirements
- Duty cycle and environment
- Prototype quantity and expected annual volume

For a gearbox-only project, a motor drawing is usually the fastest starting point.

[Request CAD, Sample and Quote](../request-cad-sample-quote.md){ .md-button .md-button--primary }
[Open the Engineering Center](../engineering-center/index.md){ .md-button }

## Engineering Contact

**Wanrong Wang**  
International Sales / Sales Engineer, SigGear  
[wangwanrong@siggear.com](mailto:wangwanrong@siggear.com)
