SigGearDrive/SigGear-product-docs/docs/engineering-center/production-release-review.md

---
title: Production Release Review | Pilot Result & Change Control | SigGear
description: A structured production-release readiness review after pilot build, covering pilot result, configuration changes, inspection evidence, deviations, final revisions, packaging, forecast and change control.
---

# Production Release Review

Use this review **after a pilot build has been completed and reviewed by the responsible project / engineering / quality teams**.

This page does not approve a pilot result, Production Release or mass production. It organizes the information needed before a human production-release review.

<div id="sg-production-release" class="siggear-production-release" hidden>
  <p id="sg-production-release-status">Checking the candidate and pilot-preparation handoff...</p>

  <div id="sg-production-release-content" hidden>
    <div class="siggear-production-candidate-summary">
      <strong id="sg-production-candidate-name"></strong>
      <span id="sg-production-candidate-detail"></span>
    </div>

    <form id="sg-production-release-form">
      <div class="siggear-form-grid">
        <label>
          Pilot build / result confirmation
          <select id="sg-production-pilot-confirmation">
            <option value="not_confirmed">Not confirmed</option>
            <option value="confirmed_completed_by_responsible_team">Pilot build completed and result confirmed by responsible team</option>
          </select>
        </label>

        <label>
          Pilot result
          <select id="sg-production-pilot-result">
            <option value="not_recorded">Not recorded</option>
            <option value="accepted">Accepted for production-release review</option>
            <option value="accepted_with_approved_deviations">Accepted with approved deviations / concessions</option>
            <option value="issues_require_revision">Issues require engineering revision / revalidation</option>
          </select>
        </label>

        <label>
          Configuration after pilot
          <select id="sg-production-configuration-change">
            <option value="not_confirmed">Not confirmed</option>
            <option value="unchanged_from_pilot">Unchanged from accepted pilot configuration</option>
            <option value="changed_after_pilot">Changed after pilot — revalidation required</option>
          </select>
        </label>

        <label>
          Final controlled drawing revision
          <input id="sg-production-drawing-revision" type="text" placeholder="Example: DWG-XXXX Rev.C">
        </label>

        <label>
          Final configuration / BOM revision
          <input id="sg-production-bom-revision" type="text" placeholder="Final production configuration or BOM revision">
        </label>

        <label>
          Pilot inspection / acceptance evidence
          <input id="sg-production-inspection-result" type="text" placeholder="Inspection report reference, acceptance result or review record">
        </label>

        <label>
          Approved deviations / concessions
          <input id="sg-production-deviations" type="text" placeholder="Reference approved deviation / concession, or write none">
        </label>

        <label>
          Packaging / labeling freeze
          <select id="sg-production-packaging-freeze">
            <option value="not_confirmed">Not confirmed</option>
            <option value="confirmed">Confirmed / frozen for production review</option>
            <option value="standard_or_not_applicable">Standard packaging / labeling or not applicable</option>
          </select>
        </label>

        <label>
          Forecast / expected annual volume
          <input id="sg-production-forecast" type="text" placeholder="Expected annual volume, forecast range or current demand plan">
        </label>

        <label>
          Production inspection / test plan
          <input id="sg-production-test-plan" type="text" placeholder="Outgoing inspection, functional test, critical characteristics or agreed plan">
        </label>

        <label>
          Change-control agreement
          <input id="sg-production-change-control" type="text" placeholder="What production changes require notification / approval?">
        </label>
      </div>

      <label>
        Remaining risks / open items
        <textarea id="sg-production-open-items" rows="3" placeholder="Write none if all known release-blocking items are closed, or list the remaining issue / owner / next action."></textarea>
      </label>

      <label>
        Production-release documentation / traceability
        <textarea id="sg-production-documentation" rows="3" placeholder="Inspection report, traceability, material / quality documents, packaging record, or write not required."></textarea>
      </label>

      <div id="sg-production-readiness" class="siggear-production-readiness">
        <strong>Production release review status</strong>
        <p id="sg-production-readiness-status">Need Pilot Result Confirmation — the website cannot confirm pilot completion or acceptance on its own.</p>
        <ul id="sg-production-readiness-gates"></ul>
        <p class="siggear-production-note"><strong>Ready to Submit for Production Release Review</strong> means the release package is complete enough for human review. It does not mean Production Released, mass-production approved or manufacturing started.</p>
      </div>

      <div class="siggear-form-actions">
        <button type="button" id="sg-copy-production-summary" class="md-button md-button--primary">Copy Production Release Review Summary</button>
        <button type="button" id="sg-email-production-summary" class="md-button">Prepare Production Release Review Email</button>
        <a id="sg-production-datasheet" class="md-button" href="#">Open Datasheet</a>
        <a id="sg-production-interface" class="md-button" href="#">Open Mechanical Interface</a>
      </div>

    </form>
  </div>
</div>

The drawing / BOM revisions, pilot evidence, deviations, forecast, inspection plan, change-control agreement and other project-specific production details stay in the browser until you copy the summary or open your email client. They are not sent to GA4.

## Production Release Review Gates

A production-release review should be able to identify:

1. **Pilot build / result confirmation** — completed and reviewed by the responsible team, not by the website.
2. **Pilot disposition** — accepted, accepted with approved deviations, or returned for engineering revision.
3. **Configuration continuity** — whether the production-review configuration is unchanged from the accepted pilot configuration.
4. **Final controlled configuration** — final drawing revision and configuration / BOM revision.
5. **Pilot inspection / acceptance evidence** — the evidence supporting the pilot disposition.
6. **Deviation / concession disposition** — explicit approved reference or “none”.
7. **Packaging / labeling freeze** — confirmed, standard, or explicitly not applicable.
8. **Forecast / annual volume** — current demand context for manufacturing planning.
9. **Production inspection / test plan** — what will be checked in recurring production.
10. **Change control** — what production changes require notification / approval.
11. **Remaining release blockers** — explicitly closed or identified for further action.

## Manual Milestone Boundary

**Human confirmation required:** **Production Released** is a manually confirmed project / manufacturing milestone.

The website never automatically sets:

- Pilot Build Accepted
- Production Released
- Mass Production Approved
- Manufacturing Started

If the pilot configuration changes after acceptance, return the affected configuration to engineering review / revalidation before production release.

[Open Pilot Preparation Review](pilot-preparation-review.md){ .md-button }
[Prototype → Design-In → Production](../custom-engineering/prototype-to-production.md){ .md-button }

**Wanrong Wang**  
International Sales / Sales Engineer, SigGear  
[wangwanrong@siggear.com](mailto:wangwanrong@siggear.com)
