SigGearDrive/SigGear-product-docs/docs/applications/access-control-smart-lock-security-gear-motors.md

# Access Control, Smart Lock and Security Gear Motors

## Application Overview

Access-control equipment, smart locks, electronic cabinet locks and compact security mechanisms often use small gear motors to move bolts, latches, cams, hooks, release levers, flap mechanisms, turnstile components, safebox parts, service doors and controlled-access actuators. These applications require compact size, reliable locking or release motion, controlled current, repeatable end-position behavior and predictable operation after many cycles.

An access-control gear motor should be selected from the actual lock or security mechanism. Required force, bolt geometry, friction, spring load, door alignment, latch preload, manual override, power-off behavior, battery current, operating temperature, life cycle and security responsibility all affect whether a micro gear motor or compact planetary gearbox can be used reliably.

SigGear can evaluate micro gear motors, compact planetary gearboxes, flat BLDC motors and customized motor/gearbox assemblies for smart locks, access-control systems, cabinet locks, service-door mechanisms and compact security actuators. Final model selection, electrical integration, safety validation, security validation and production approval must be confirmed case by case.

## Important Security and Safety Boundary

Access-control and lock products may involve security certification, fire safety, emergency egress, anti-tamper design, battery backup, regional electrical safety, ingress protection, customer-specific reliability and regulatory approval. This page provides preliminary actuator-selection guidance only.

Unless explicitly confirmed in writing, SigGear does not assume responsibility for:

- Lock-level security certification
- Anti-tamper or forced-entry validation
- Fire-door, emergency-exit or life-safety approval
- Building-access or access-control system certification
- Full-device IP-rating or outdoor enclosure validation
- Equipment-level electrical safety certification
- Final production approval for the customer device

For lock or access-control projects, share the target standards, validation plan, installation environment, drawings, expected annual volume and approval process before quotation.

## Key Selection Factors

| Requirement | Why it matters |
| --- | --- |
| Locking mechanism | Bolt, latch, cam, hook, worm, rack, screw and lever systems need different torque-speed behavior. |
| Required force | Door preload, seal compression, spring load and friction determine motor torque. |
| Stroke or rotation angle | Defines gear ratio, output shaft design and control strategy. |
| Power-off behavior | Locks may need fail-secure, fail-safe, manual override or holding behavior. |
| Battery current | Smart locks and cabinet locks often require low peak current and low standby current. |
| End-position detection | Limit switches, Hall sensors, encoders or current sensing may be required. |
| Jam condition | Misalignment, door pressure, foreign objects and tampering can create stall loads. |
| Noise | Residential and office devices may require quiet operation. |
| Environment | Outdoor, humidity, dust, temperature and cleaning exposure affect configuration. |
| Custom interface | Shaft, flange, cable, connector and mounting details usually need device-specific review. |

## Common Access Control and Security Use Cases

### Smart Door Locks and Electronic Latches

Smart residential locks, office locks and electronic latch systems may use compact gear motors to move bolts, rotate cams, drive sliders or release spring-loaded mechanisms. Provide required bolt force, stroke, rotation angle, latch preload, manual key override, battery voltage, current limit, noise target and lifetime cycle requirement.

### Cabinet Locks and Smart Storage Doors

Smart lockers, parcel lockers, vending cabinets, retail cabinets, charging cabinets and equipment doors may require compact lock motors for release, locking, hook movement or service-door control. Provide door size, latch geometry, required holding force, release force, open/close cycle, misalignment tolerance and emergency release requirement.

### Safebox, Drawer and Asset-Control Mechanisms

Small safeboxes, drawers, medicine cabinets, tool cabinets and asset-control systems may use gear motors for bolt movement, rotary locking, cam release or controlled access. Provide security responsibility, load path, anti-tamper requirement, bolt support method, required torque or force, feedback requirement and expected lifetime cycles.

### Turnstile, Barrier and Gate Sub-Mechanisms

Access-control gates, turnstiles and compact barrier systems may use small gear motors for latch release, sensor covers, small locks, brake release or auxiliary positioning. Provide mechanism position, duty cycle, load direction, safety relevance, manual override, power-off behavior and environmental exposure.

### Security Camera, Sensor and Cover Movement

Security devices may use compact actuators for camera angle adjustment, sensor covers, shutter movement, privacy covers or small positioning axes. Provide payload, motion range, speed, backlash requirement, noise target, outdoor exposure and feedback requirement.

### Access Panels and Service Door Actuators

Industrial cabinets, kiosks, energy cabinets and medical or laboratory equipment may require controlled access panels or service-door actuators. Provide door size, latch location, required locking force, sealing force, ingress exposure, cleaning requirements and maintenance access method.

## Torque, Force and Mechanism Review

Lock and access-control mechanisms should be reviewed from the actual load path. The motor does not only move the bolt; it may also overcome door preload, seal compression, latch friction, spring force, misalignment and user interaction.

Provide:

- Device type and lock position
- Locking mechanism type
- Required output torque or linear force
- Peak torque and peak duration
- Stroke length or output rotation angle
- Required opening or closing time
- Gear ratio if already specified
- Bolt, latch, cam, screw, rack or lever dimensions
- Door preload, seal force, spring force or friction estimate
- Jam, stall, tamper or misalignment condition
- Required lifetime cycles

When torque or force is not known, provide drawings, test data, estimated forces, prototype videos or measured current curves for review.

## Voltage, Current and Control Review

Smart locks and compact access devices are often battery powered or powered from low-voltage DC electronics. The motor and gearbox should be selected together with the driver and current limit.

Clarify:

- Nominal operating voltage
- Minimum and maximum operating voltage
- Battery type or power supply type
- Peak current limit
- Continuous current limit
- Standby-power requirement
- Driver supplied by customer or by SigGear
- Control method
- End-position detection method
- Stall or jam detection method
- Manual override or emergency release requirement

Do not assume encoder, brake, closed-loop control, CAN, RS485 or another protocol unless it is included in the selected motor and driver configuration.

## Reliability, Noise and Environment Review

Access-control products often operate for many cycles over long service periods. Some are installed outdoors, in cabinets, in public spaces or in controlled environments. Reliability should be validated under representative mounting, preload, temperature and battery conditions.

Provide:

- Expected cycles per day
- Required lifetime cycles
- Operating temperature range
- Indoor or outdoor installation
- Dust, humidity, splash or cleaning exposure
- Noise target and measurement distance
- Battery-low operating requirement
- Maintenance interval
- Replacement or service-access method
- Acceptable failure mode

Noise and service life are configuration-specific and should be confirmed under representative load, speed, mounting and environmental conditions.

## Output Shaft, Mounting and Load Support

Lock mechanisms may apply high radial, axial, impact or stall loads to the gearbox output if the bolt, cam, latch, gear or lever is directly supported by the motor shaft. Output shaft and bearing support should be reviewed early.

Provide:

- Output shaft shape and length
- D-cut, spline, gear, keyway, worm, lead screw or custom shaft requirement
- Flange and mounting hole requirement
- Load direction
- Distance from load point to gearbox face
- Bolt, cam, hook, gear, rack or lever geometry
- External bearing or support method
- Shock, jam or tamper condition

External support bearings are recommended when the lock mechanism creates significant radial, axial, cantilevered or impact load.

## Candidate SigGear Product Families

### Micro Gear Motors

[Micro Gear Motors](../products/micro-gear-motors/index.md) are a starting point for smart locks, cabinet locks, small latches, service-door mechanisms, release cams, privacy covers and compact access-control actuators. SigGear can evaluate miniature planetary gear motors, compact reduction motors, motor and gearbox integration, custom output shafts, flanges and mounting interfaces, and optional encoder or cable integration after engineering review.

### 8-42 mm Planetary Gearboxes

The [8-42 mm planetary gearbox series](../products/planetary-gearboxes/8-42mm-planetary-gear-reducer.md) provides compact reducer options for different frame sizes. Final ratio, torque, efficiency, backlash and dimensions depend on the selected frame size, gear stage and configuration.

### Flat BLDC Motors and Joint Drives

For low-profile access-control modules, thin locks, compact rotary latch mechanisms or limited axial packaging, [Flat BLDC Motors and Joint Drives](../products/flat-bldc-motors/index.md) may be reviewed together with gearbox or actuator requirements when the drive envelope is constrained.

## Prototype and Customization Support

Depending on the project scope, SigGear can evaluate:

- Gear ratio selection
- Motor and gearbox matching
- Output shaft customization
- Flange and mounting customization
- Cable and connector customization
- Encoder or sensor integration after review
- Low-noise configuration review
- Customer branding and labeling
- Prototype support before production planning

Security and access-control projects may require additional review of reliability standards, anti-tamper requirements, documentation, traceability, inspection requirements and customer approval requirements. Confirm these requirements before quotation.

## Information Needed for Access-Control Gear Motor Review

Please provide one requirement set for each actuator position.

Provide:

- Device type and actuator function
- Locking mechanism type
- Prototype, test fixture or production-use target
- Required output torque or force
- Peak torque and peak duration
- Required output speed or opening time
- Stroke length or rotation angle
- Gear ratio if known
- Maximum diameter and length
- Operating voltage and current limit
- Battery or power-supply type
- Indoor, outdoor, dust, moisture or temperature requirements
- Motor type preference
- Shaft, flange and mounting requirements
- Feedback, homing or limit-switch requirements
- Manual override or emergency-release requirement
- Noise and vibration target
- Jam detection or stall-protection requirement
- Duty cycle and lifetime cycle target
- Validation, approval or documentation requirements
- Prototype quantity and estimated annual quantity
- Required customization or OEM branding

## Request an Access-Control Gear Motor Review

Send your smart lock, access-control, cabinet lock or security actuator requirements to SigGear for preliminary model evaluation. Early requirements can be approximate, but locking mechanism, torque or force estimate, stroke, speed, size, voltage, current limit, duty cycle, environment, validation target and quantity are needed before a meaningful recommendation can be made.

**Wanrong Wang**  
International Sales, SigGear  
[wangwanrong@siggear.com](mailto:wangwanrong@siggear.com)

[Send Access-Control Gear Motor Requirements](../contact.md){ .md-button .md-button--primary }
