SigGearDrive/SigGear-product-docs/docs/applications/agriculture-outdoor-equipment-gear-motors.md

# Agriculture and Outdoor Equipment Gear Motors

## Application Overview

Agriculture equipment, outdoor machines and field-service devices often use small gear motors and compact reducers for adjustment, feeding, metering, dispensing, valve actuation, cover movement, sensor positioning, latch movement, small conveyor motion and auxiliary mechanism control. These applications may require compact size, stable torque, low-voltage operation, corrosion-aware materials, dust resistance, moisture consideration and reliable performance under variable outdoor conditions.

Unlike indoor consumer devices, agriculture and outdoor equipment may operate with soil, water, fertilizer, feed, dust, vibration, impact, temperature changes and irregular duty cycles. The correct gear motor should be selected from the actual mechanism load, mounting position, environmental exposure, power supply, control method and service-life target.

SigGear can evaluate micro gear motors, compact planetary gearboxes, flat BLDC motors and customized motor/gearbox assemblies for agriculture, outdoor automation and field-device applications. Final model selection, sealing responsibility, full-device validation, environmental testing and production approval must be confirmed case by case.

## Important Application Boundary

Agriculture and outdoor equipment can involve water ingress, dust exposure, corrosion, chemical exposure, vibration, impact, animal contact, human safety, machinery safety, agricultural-machine regulations, electrical safety and customer-specific reliability standards. This page provides preliminary actuator-selection guidance only.

Unless explicitly confirmed in writing, SigGear does not assume responsibility for:

- Full-machine safety certification
- Agricultural-machine regulatory approval
- Full-device IP-rating certification
- Chemical, fertilizer or pesticide compatibility validation
- Outdoor enclosure, cable gland or connector validation
- Human-contact, animal-contact or public-use safety approval
- Equipment-level electrical safety certification
- Final production approval for the customer device

For outdoor or agriculture projects, share the installation environment, target validation standard, duty cycle, protection level, cable route, enclosure design, load data and annual quantity before quotation.

## Key Selection Factors

| Requirement | Why it matters |
| --- | --- |
| Mechanism type | Feeders, valves, shutters, gates, adjusters, covers and conveyors create different torque-speed profiles. |
| Load and friction | Soil, feed, seed, fertilizer, dust and moisture can increase friction and stall load. |
| Duty cycle | Intermittent adjustment and continuous feeding require different thermal review. |
| Outdoor exposure | Water, dust, sunlight, temperature and corrosion affect motor, gearbox, cable and connector choices. |
| Voltage and current | Battery, solar, vehicle and DC power systems need current-limit review. |
| Jam condition | Blockage, debris, frozen material, overload and mechanical misalignment can stall the actuator. |
| Shaft load | Gates, flaps, cams, screws and direct-mounted gears may create radial or axial load. |
| Feedback requirement | Position, homing, limit detection or current sensing may be required. |
| Noise and vibration | Some livestock, greenhouse and residential outdoor devices may require low-noise operation. |
| Maintenance plan | Field devices may require easy replacement, sealing review and service access. |

## Common Agriculture and Outdoor Equipment Use Cases

### Seed, Feed and Fertilizer Metering

Planters, feeders, fertilizer dispensers and dosing devices may use compact gear motors to rotate augers, metering wheels, gates, small conveyors or dispensing drums. Provide material type, required feed rate, torque, speed, duty cycle, blockage condition, cleaning method and corrosion exposure.

### Greenhouse and Irrigation Mechanisms

Greenhouse vents, shading devices, small valves, dosing pumps, damper mechanisms and irrigation adjustment systems may require compact actuators with controlled motion and environmental resistance. Provide load, travel angle, stroke, speed, voltage, outdoor exposure, humidity, condensation, cleaning and feedback requirement.

### Livestock and Feeding Equipment

Automatic feeders, waterers, gates, dosing systems and small animal-care devices may use gear motors for material release, valve movement, cover motion, latch control or small conveying. Provide feed material, animal-contact condition, cleaning environment, duty cycle, jam risk, noise target and service-life requirement.

### Outdoor Cabinets, Covers and Service Doors

Charging cabinets, battery cabinets, field-control boxes, irrigation controllers, farm equipment covers and outdoor service panels may require compact gear motors for cover movement, latch release, lock assistance or airflow damper control. Provide door size, seal force, wind exposure, latch geometry, ingress exposure and manual override requirement.

### Small Conveyors and Product Handling

Agriculture sorting devices, seed counters, compact grading systems, inspection conveyors and outdoor material-transfer equipment may use gear motors for belt, roller or feeder motion. Provide material weight, belt width, roller diameter, speed, start-stop cycle, slope, contamination exposure and jam condition.

### Sensor, Camera and Sprayer Positioning

Outdoor sensors, agricultural cameras, sprayer nozzles, light devices and monitoring equipment may use gear motors for small-angle adjustment, pan-and-tilt motion, cover movement or calibration axes. Provide payload, motion range, backlash requirement, holding requirement, vibration exposure, weather exposure and feedback need.

### Flaps, Dampers, Gates and Valves

Small outdoor machines often use compact actuators to move flaps, dampers, air-control plates, water valves, small gates, release doors or diverters. Provide torque or force requirement, rotation angle, sealing force, pressure, flow condition, environmental exposure and fail-safe or manual override requirement.

## Torque, Speed and Mechanism Review

Outdoor and agriculture mechanisms should be reviewed under worst-case load, not only under clean indoor test conditions. Soil, feed, grain, dust, moisture, corrosion, cold temperature and debris can increase friction and starting torque.

Provide:

- Equipment type and actuator position
- Mechanism type
- Required continuous torque
- Required peak torque and peak duration
- Required output speed or travel time
- Stroke length or rotation angle
- Gear ratio if already specified
- Load material and estimated resistance
- Jam, blockage or overload condition
- Operating direction and duty cycle
- Required lifetime cycles or service hours

When load data is not available, provide drawings, prototype videos, measured current curves, manual force measurements or test data from the existing mechanism.

## Voltage, Current and Control Review

Agriculture and outdoor equipment may be powered by batteries, solar systems, vehicle power, DC adapters or control cabinets. Current limit and starting torque should be reviewed together.

Clarify:

- Nominal operating voltage
- Minimum and maximum voltage range
- Power source type
- Peak current limit
- Continuous current limit
- Driver supplied by customer or by SigGear
- Control method
- Feedback, limit switch or homing requirement
- Stall or jam detection method
- Reverse operation requirement
- Power-off holding requirement

Do not assume encoder, brake, closed-loop control, CAN, RS485 or another protocol unless it is included in the selected motor and driver configuration.

## Environmental and Reliability Review

Outdoor and agriculture devices need realistic validation. The same motor may perform differently when exposed to dust, moisture, cleaning, fertilizer, vibration, shock, temperature changes or long idle periods.

Provide:

- Indoor, greenhouse, outdoor or vehicle-mounted use
- Dust, soil, sand or feed-powder exposure
- Splash, rain, humidity or condensation exposure
- Cleaning method
- Fertilizer, pesticide, salt, oil or chemical exposure
- Operating temperature range
- Storage temperature range
- Vibration or impact exposure
- Expected cycles per day or operating hours
- Required service life
- Maintenance and replacement plan

Full-device sealing and outdoor validation should be confirmed by the equipment manufacturer. Motor, gearbox, cable and connector configuration can be reviewed after the environment is defined.

## Output Shaft, Mounting and Load Support

Outdoor mechanisms may impose heavy radial, axial or impact loads on a small gearbox if the output shaft directly supports a gate, flap, pulley, sprocket, cam, screw, auger or lever. External support should be considered early.

Provide:

- Output shaft shape and length
- D-cut, spline, keyway, gear, pulley, sprocket, worm, screw or custom shaft requirement
- Load direction
- Distance from load point to gearbox face
- Radial and axial load estimates
- Shock, jam or impact condition
- Flange and mounting hole requirement
- Cable exit direction
- Connector or wire harness requirement
- External bearing or support method

External support bearings are recommended when the mechanism creates significant cantilevered load, shock load, axial thrust or jam load.

## Electric Pruning Shears: Focused Planetary Gearbox Selection

An electric pruning-shear drive must be evaluated from the blade and linkage geometry, movement torque, brief cutting peaks, output speed and duty cycle. **No SigGear frame size is automatically approved for this application.**

[Read the Electric Pruning Shears Planetary Gearbox Guide](electric-pruning-shears-planetary-gearbox.md){ .md-button .md-button--primary }
[Compare 8–42 mm Planetary Gearbox Models](../products/planetary-gearboxes/8-42mm-planetary-gear-reducer.md){ .md-button }

## Candidate SigGear Product Families

### Micro Gear Motors

[Micro Gear Motors](../products/micro-gear-motors/index.md) are a starting point for small agriculture devices, feeders, valves, gates, covers, sensor adjustment, compact conveyors and low-voltage outdoor mechanisms. SigGear can evaluate miniature planetary gear motors, custom shafts, flanges, cable exits, connectors and optional feedback after engineering review.

### 8-42 mm Planetary Gearboxes

The [8-42 mm planetary gearbox series](../products/planetary-gearboxes/8-42mm-planetary-gear-reducer.md) can be reviewed for compact transmission needs when ratio, torque, size and mounting requirements are defined. Final performance depends on frame size, gear stage, material configuration and operating conditions.

### Flat BLDC Motors and Joint Drives

For low-profile equipment, sensor positioning, compact rotary actuators or limited axial space, [Flat BLDC Motors and Joint Drives](../products/flat-bldc-motors/index.md) may be reviewed together with gearbox or actuator requirements.

## Prototype and Customization Support

Depending on project scope, SigGear can evaluate:

- Gear ratio selection
- Motor and gearbox matching
- Output shaft customization
- Flange and mounting customization
- Cable and connector customization
- Low-voltage motor configuration
- Feedback or sensor integration after review
- Low-noise configuration review
- Outdoor-use configuration review
- Customer branding and labeling
- Prototype support before production planning

Outdoor and agriculture projects may require additional review of sealing expectations, materials, cable routing, connector selection, vibration, corrosion, cleaning exposure, inspection requirements and long-term supply planning.

## Information Needed for Agriculture or Outdoor Equipment Review

Please provide one requirement set for each actuator position.

Provide:

- Equipment type and actuator function
- Mechanism type
- Prototype, test fixture or production-use target
- Required torque or force
- Peak torque and peak duration
- Required output speed or travel time
- Stroke length or rotation angle
- Gear ratio if known
- Maximum diameter and length
- Operating voltage and current limit
- Power source type
- Indoor, greenhouse, outdoor or vehicle-mounted environment
- Dust, water, fertilizer, pesticide, salt or cleaning exposure
- Operating temperature range
- Motor type preference
- Shaft, flange and mounting requirements
- Feedback, homing or limit-switch requirement
- Jam or stall-protection requirement
- Duty cycle and lifetime target
- Validation, documentation or inspection requirements
- Prototype quantity and estimated annual quantity
- Required customization or OEM branding

## Request an Agriculture or Outdoor Equipment Gear Motor Review

Send your agriculture, outdoor equipment, feeder, valve, cover, gate, conveyor or sensor-positioning actuator requirements to SigGear for preliminary model evaluation. Early requirements can be approximate, but load, torque or force, speed, size, voltage, current limit, environment, duty cycle, validation target and quantity are needed before a meaningful recommendation can be made.

**Wanrong Wang**  
International Sales, SigGear  
[wangwanrong@siggear.com](mailto:wangwanrong@siggear.com)

[Send Agriculture or Outdoor Equipment Gear Motor Requirements](../contact.md){ .md-button .md-button--primary }
