SigGearDrive/SigGear-product-docs/docs/applications/consumer-appliance-home-device-gear-motors.md

# Consumer Appliance and Home Device Gear Motors

Consumer appliances and smart home devices often need compact gear motors for intermittent movement, quiet operation, low-voltage power and reliable end-stop behavior.

SigGear supports customized micro gear motors, planetary gear motors and compact actuator solutions for consumer appliance mechanisms where the final motor, gearbox, shaft, wiring and mounting design must match the customer's housing and motion structure.

This page gives selection guidance for consumer appliance engineers, smart home product teams and OEM/ODM buyers who need a compact gear motor for household automation, small appliance motion or home device mechanisms.

Final model selection should be confirmed after engineering review of the mechanism, duty cycle, load condition and installation drawings.

## Typical Consumer Appliance Applications

### Pet Feeder and Smart Pet Device Mechanisms

Automatic pet feeders and smart pet devices may use a gear motor for:

- food dispensing wheels
- screw augers
- rotating bowls
- portion-control doors
- anti-jam feeding mechanisms
- camera or sensor angle adjustment
- small locking covers

Important selection factors include low-speed torque, jam behavior, low current, low noise, start-stop reliability and food-dust exposure.

For pet feeder projects, it is helpful to provide the food type, particle size, dispenser geometry, expected portion size and whether the motor must reverse during a jam condition.

### Smart Trash Can and Automatic Lid Mechanisms

Smart trash cans and automatic lid systems may use a gear motor for:

- lid opening and closing
- inner flap movement
- soft-close mechanisms
- bag-sealing assistance
- drawer or cartridge movement
- compact lock or latch movement

The motor should be selected according to lid weight, opening angle, required opening time, holding requirement, noise target, power supply and stall or obstruction behavior.

In battery-powered products, standby current and peak current during lid movement should be reviewed carefully.

### Kitchen Appliance Small Motion Mechanisms

Kitchen appliances may use small gear motors for:

- valve or flap movement
- ingredient dispensing
- cup or tray movement
- door latch assistance
- cleaning mechanism adjustment
- grinder or dosing adjustment
- compact pump or valve drive assistance

For food and beverage equipment with stronger moisture, cleaning or food-contact requirements, also review the more focused page on [food, beverage and coffee equipment gear motors](./food-beverage-coffee-equipment-gear-motors.md).

### Home Cleaning Device Mechanisms

Cleaning products and home service devices may use gear motors for:

- brush height adjustment
- mop plate lifting
- water-valve or liquid-dosing movement
- dust-bin latch movement
- station door movement
- nozzle or flap adjustment
- small lifting or tilting modules

The motor should be checked for dust, hair, water mist, detergent exposure, intermittent load and jam recovery behavior.

### Personal Care and Wellness Device Motion

Personal care and wellness devices may use compact gear motors for:

- massage rollers
- kneading modules
- adjustable heads
- beauty device positioning
- small pump or dosing mechanisms
- sliding, lifting or cover movement

Selection should consider noise, vibration, surface temperature, duty cycle, expected lifetime and user-contact safety boundaries.

Where the application is a medical or laboratory product rather than a consumer wellness device, review the relevant validation boundaries on [medical and laboratory micro gear motors](./medical-device-micro-gear-motors.md).

### Smart Home Accessories and Small Automatic Devices

Smart home products may use gear motors for:

- compact door or lid movement
- dispenser mechanisms
- small drawer movement
- sensor angle adjustment
- curtain accessory modules
- cabinet or storage mechanisms
- smart switch or knob actuation

For electric curtains, blinds and window-opening systems, review the dedicated page on [electric curtain, blind and window opener gear motors](./electric-curtain-blind-window-opener-gear-motors.md).

## Common Mechanism Types

### Rotary Output Mechanisms

Rotary gear motor output is suitable for:

- rotating dispensing wheels
- cams
- flaps
- knobs
- small covers
- indexing discs
- shutter or guide mechanisms

Key information includes output torque, output speed, shaft direction, rotation angle, whether continuous rotation is needed and whether the mechanism hits a hard stop.

### Cam, Crank and Linkage Mechanisms

Many appliance mechanisms convert motor rotation into short linear or angular movement using cams, cranks or linkages.

For these systems, the peak torque may be much higher than the average torque because the load changes across the motion cycle.

Please provide:

- cam radius or linkage geometry
- highest-load angle
- required movement time
- whether the motor must hold position
- expected stop position accuracy
- end-stop or limit-switch method

### Screw, Auger and Dispensing Mechanisms

Screw or auger mechanisms are common in pet feeders, powder dispensers and ingredient-feeding systems.

Important factors include:

- material type
- particle size
- friction condition
- jam risk
- reverse requirement
- output shaft load
- cleaning exposure

A motor that works well in an empty mechanism may stall or overheat when the mechanism is filled with real material, so real-load testing is important.

### Lid, Cover and Flap Movement

Lid and cover movement often requires smooth start, controlled closing and safe stall behavior.

Key questions include:

- lid weight
- hinge geometry
- opening angle
- desired opening time
- soft-close requirement
- obstruction detection
- whether the motor must hold the lid open

The gearbox should be selected to avoid excessive speed, high noise or high impact at the end stop.

### Small Locking, Latching and Release Mechanisms

Appliances and smart home devices may use gear motors for small locking or release actions.

Selection should consider:

- locking force
- release torque
- fail-safe or power-off behavior
- jam condition
- feedback signal
- security boundary
- manual override requirement

For stronger security-related mechanisms, see [access control, smart lock and security gear motors](./access-control-smart-lock-security-gear-motors.md).

## Key Selection Factors

### Torque and Safety Margin

Consumer appliance loads are often small, but friction, dust, material accumulation and mechanical tolerance can increase required torque.

Please provide the normal operating torque and the estimated maximum torque under worst-case conditions.

If the exact torque is unknown, a video, drawing and description of the moving part can help us estimate a starting range for prototype review.

### Output Speed and Motion Time

Many appliance mechanisms do not require high speed. They require controlled motion within a certain time.

Examples:

- lid opens in 1 to 3 seconds
- dispenser rotates one portion per cycle
- flap moves from closed to open within a defined angle
- tray or small lift completes one stroke per command

Please provide the required output speed, movement angle or travel distance, and time per cycle.

### Noise and User Experience

Home products are often used near people, so noise and vibration are important.

Noise depends on motor type, gearbox ratio, load, mounting stiffness, housing resonance and control method.

For low-noise projects, share the target sound level if available and describe where the product will be used, such as bedroom, kitchen, living room, office or pet area.

### Low Current and Battery Operation

Battery-powered appliances need careful current review.

Please provide:

- battery voltage
- maximum allowed peak current
- expected current during normal operation
- standby current requirements
- number of cycles per charge
- battery capacity if available

Gear ratio, motor size and control method should be selected together to balance torque, speed and battery life.

### Jam, Stall and End-Stop Behavior

Consumer appliance mechanisms often hit end stops or experience material jams.

The system should define how the motor behaves when:

- food particles block an auger
- a lid is obstructed
- a flap reaches the end stop
- a drawer is pushed by hand
- a mechanism becomes dirty or misaligned

The motor and controller may need current limiting, reverse motion, time-out logic, position feedback or mechanical protection.

### Duty Cycle and Lifetime

Some appliances move only a few times per day, while others run many cycles.

Please provide:

- cycles per day
- movement time per cycle
- rest time between cycles
- expected product lifetime
- continuous run requirement if any
- ambient temperature range

These details affect motor winding, gear material, lubrication, bearing structure and gearbox ratio.

### Shaft Load and Installation Direction

Small gear motors can be damaged by excessive radial or axial load on the output shaft.

Please provide the shaft load direction and whether the gear motor output shaft directly carries the load, pulley, gear, cam, auger or linkage.

Where external loads are high, additional bearings or mechanical support may be required in the customer's mechanism.

### Feedback and Position Control

Some appliance mechanisms only need open-loop timing, while others need position confirmation.

Possible feedback options include:

- limit switch
- Hall signal
- encoder
- current sensing
- mechanical end-stop detection
- external sensor in the customer's system

Please confirm whether the gear motor only needs to rotate for a set time or whether the control system must know the exact position.

### Environment, Cleaning and Material Exposure

Consumer appliance environments may include:

- food dust
- pet food particles
- hair
- moisture
- detergent
- oil mist
- household dust
- temperature changes

The motor does not automatically meet food-contact, waterproof, cleaning or safety certification requirements. These requirements must be reviewed with the full device structure and the customer's compliance plan.

## Product Mapping Guidance

The final motor depends on torque, speed, voltage, size, noise and interface requirements.

Typical starting points include:

- micro gear motors for compact dispensing, latching, cover and small rotary mechanisms
- small planetary gear motors for higher torque and stronger shaft support
- customized shaft, cable, connector and mounting interface for appliance housings
- feedback versions when position confirmation is required
- low-noise and low-current tuning when user experience is critical

For compact planetary gearbox options, see the [8-42 mm planetary gearbox series](../products/planetary-gearboxes/8-42mm-planetary-gear-reducer.md).

For smart device mechanisms that overlap with cabinets, locks, curtains or dispensing equipment, also review [smart hardware gear motors](./smart-hardware-gear-motors.md).

## RFQ Information to Share

For a faster engineering review, please provide:

- appliance type and moving mechanism
- required output torque or load description
- required output speed or movement time
- movement angle, travel distance or cycle pattern
- operating voltage and power supply type
- maximum motor diameter, length and weight
- noise target if available
- expected cycles per day and lifetime target
- normal and worst-case load condition
- jam or stall behavior requirement
- required shaft type and mounting interface
- feedback or position confirmation requirement
- environmental exposure such as dust, moisture or cleaning
- prototype quantity and estimated annual volume

Drawings, photos, videos and mechanism sketches are especially useful for appliance projects because small changes in friction, alignment and housing structure can change the motor requirement.

## Related Application Pages

- [Smart toilet and bidet planetary gear motor guide](./smart-toilet-bidet-planetary-gear-motors.md)
- [Smart hardware gear motors](./smart-hardware-gear-motors.md)
- [Food, beverage and coffee equipment gear motors](./food-beverage-coffee-equipment-gear-motors.md)
- [Pump, valve and fluid control gear motors](./pump-valve-fluid-control-gear-motors.md)
- [Electric curtain, blind and window opener gear motors](./electric-curtain-blind-window-opener-gear-motors.md)
- [Access control, smart lock and security gear motors](./access-control-smart-lock-security-gear-motors.md)
- [Office automation and business equipment gear motors](./office-automation-business-equipment-gear-motors.md)

## Contact

For consumer appliance and smart home device gear motor selection, please send your mechanism drawings, target torque, speed, voltage, size limit and prototype quantity to [Wanrong Wang](../contact.md).

Email: wangwanrong@siggear.com
