SigGearDrive/SigGear-product-docs/docs/applications/energy-battery-charging-equipment-actuators.md

# Energy, Battery and Charging Equipment Actuators

## Application Overview

Energy storage equipment, battery systems, charging devices and power-management hardware often need compact gear motors or small actuators for locking, latching, opening, closing, positioning, ventilation, valve movement, pump assistance or small mechanical adjustment. These applications may appear in charging stations, battery swap equipment, portable energy devices, battery test fixtures, storage cabinets, smart power equipment and auxiliary mechanisms around renewable-energy systems.

A small actuator for energy, battery or charging equipment should be selected from the complete mechanism and operating environment. Torque, force, speed, voltage, current limit, temperature, humidity, dust, outdoor exposure, vibration, duty cycle, safety boundary and validation responsibility all affect whether a micro gear motor, planetary gearbox or integrated motor assembly can be used reliably.

SigGear can evaluate micro gear motors, compact planetary gearboxes, flat BLDC motors and customized motor/gearbox assemblies for energy-related small motion mechanisms. Final model selection, electrical safety requirements, environmental validation, reliability testing, production approval and equipment-level compliance must be confirmed case by case.

## Important Safety and Compliance Boundary

Battery and charging equipment may involve electrical safety, fire safety, thermal management, ingress protection, regulatory compliance and customer-specific validation. This page provides preliminary actuator-selection guidance only.

Unless explicitly confirmed in writing, SigGear does not assume responsibility for:

- Equipment-level electrical safety validation
- Battery-system safety validation
- Charging-station certification
- Fire-safety or thermal-runaway validation
- Outdoor enclosure or IP-rating validation of the full device
- System-level reliability validation
- Final approval for safety-critical production use

For energy storage, battery or charging equipment projects, share the target standards, validation plan, drawings, installation environment, expected annual volume and approval process before quotation.

## Key Selection Factors

| Requirement | Why it matters |
| --- | --- |
| Equipment function | Locking, latching, valve movement, vent adjustment, cover movement and positioning axes need different torque-speed behavior. |
| Safety relevance | Safety-related interlocks or battery mechanisms require additional customer validation and may be outside standard quotation scope. |
| Torque and force | Springs, seals, door loads, latch friction and cable forces can increase peak torque. |
| Output speed | Affects cycle time, acoustic behavior, current draw and user experience. |
| Voltage and current | Battery-powered and charging equipment require careful voltage range, current limit and protection review. |
| Temperature range | Battery systems and outdoor devices may operate across wider temperature ranges. |
| Dust and moisture exposure | Outdoor cabinets, chargers and storage devices may require enclosure-level protection review. |
| Feedback requirement | Position confirmation, end-stop detection, Hall sensors or encoders may be needed. |
| Duty cycle | Some axes operate rarely; others may cycle frequently in swapping, testing or automated equipment. |
| Validation boundary | Equipment-level safety, IP rating, certification and reliability validation must be defined early. |

## Common Energy and Charging Equipment Use Cases

### Charging Port Locks and Connector Latches

Charging devices and energy equipment may require compact motors for connector locking, charging-port covers, latch release or access control. Provide latch force, travel distance or rotation angle, cycle time, voltage range, manual override requirement, ingress exposure and lifetime cycle target.

### Battery Cabinet Locks and Access Doors

Battery cabinets, energy-storage enclosures and smart power cabinets may use small actuators for door locks, compartment locks, cover movement or inspection access. Provide door or latch geometry, required locking force, spring force, safety relevance, power-off behavior, environment and expected cycle count.

### Battery Swap and Test Fixture Mechanisms

Battery swap equipment, production fixtures and test benches may use gear motors for positioning, clamping, latch release, sliding covers, connector alignment or small auxiliary axes. Provide payload, travel distance, alignment accuracy, speed, cycle frequency, vibration condition and whether external bearings support the load.

### Ventilation, Damper and Thermal-Management Adjustment

Energy storage and power electronics systems may require air-flow flaps, dampers, louvers or ventilation adjustment. Provide flap size, shaft torque, rotation angle, airflow condition, temperature range, cycle time and feedback requirement.

### Small Pump, Valve and Fluid-Control Drives

Some energy or charging systems may include cooling, drainage, fluid-control or auxiliary pump and valve mechanisms. Provide fluid type, pressure, flow or motion requirement, seal friction, duty cycle, temperature, ingress exposure and whether the motor is isolated from fluid.

### Portable Power and Smart Energy Devices

Portable power stations, smart energy devices and compact power-management hardware may use small motors for covers, locks, cable reels, display movement, docking mechanisms or compact user-facing motion. Provide battery voltage, peak current limit, noise target, duty cycle and packaging constraints.

## Torque, Speed and Mechanism Review

Actuator selection should start from the mechanism output requirement. Motor rated power alone is not enough because real loads may come from spring force, sealing friction, latch geometry, cable tension, gravity, environmental resistance or user interaction.

Provide:

- Equipment type and actuator function
- Required output torque or force
- Peak torque and peak duration
- Required output speed
- Stroke length or rotation angle
- Gear ratio if already specified
- Mechanism drawing or linkage dimensions
- Spring, latch, seal, door or friction load
- Shock, jam or obstruction condition
- Required lifetime cycles

When torque is not known, provide drawings, test data, estimated forces, prototype videos or measured current curves for review.

## Voltage, Current and Control Review

Energy and charging equipment may have DC bus voltage, battery voltage, low-voltage auxiliary supply or customer-specific electronics. The motor, gearbox and driver should be reviewed together.

Clarify:

- Nominal operating voltage
- Minimum and maximum operating voltage
- Peak current limit
- Continuous current limit
- Driver supplied by customer or by SigGear
- Control method
- Stall protection method
- Reverse polarity or transient protection responsibility
- Battery or auxiliary power source
- Standby-power requirement if battery powered

Do not assume encoder, brake, closed-loop control, CAN, RS485 or another protocol unless it is included in the selected motor and driver configuration.

## Environment, Ingress and Reliability Review

Energy-related equipment may face outdoor exposure, temperature change, humidity, dust, condensation, vibration, cable strain, cleaning operations or enclosure-level protection requirements. The actuator should be reviewed based on the real installation environment.

Provide:

- Indoor or outdoor installation
- Operating temperature range
- Storage temperature range
- Dust, splash or water exposure
- Humidity and condensation condition
- Vibration and shock requirement
- Enclosure or IP-rating target at equipment level
- Noise target and measurement distance
- Expected lifetime cycles
- Duty cycle and cycles per day
- Maintenance or replacement expectation

Noise and service life are configuration-specific and should be confirmed under representative load, speed, mounting and environmental conditions.

## Output Shaft, Mounting and Load Support

Battery and charging equipment mechanisms may use levers, cams, gears, cables, pulleys, sliding parts, spring-loaded latches or sealed doors. These can generate radial load, axial load, impact load or overturning moment on the gearbox output.

Provide:

- Output shaft shape and length
- D-cut, spline, gear, keyway or custom shaft requirement
- Flange and mounting hole requirement
- Load direction
- Distance from load point to gearbox face
- Gear, pulley, cam, lever or cable geometry
- External bearing or support method
- Shock, vibration, obstruction or jam condition

External support bearings are recommended when the mechanism creates significant radial, axial or cantilevered load.

## Candidate SigGear Product Families

### Micro Gear Motors

[Micro Gear Motors](../products/micro-gear-motors/index.md) are a starting point for small latch, cover, lock, adjustment, valve and auxiliary mechanisms in energy and charging equipment. SigGear can evaluate miniature planetary gear motors, compact reduction motors, motor and gearbox integration, custom output shafts, flanges and mounting interfaces, and optional encoder or cable integration after engineering review.

### 8–42 mm Planetary Gearboxes

The [8–42 mm planetary gearbox series](../products/planetary-gearboxes/8-42mm-planetary-gear-reducer.md) provides compact reducer options for different frame sizes. Final ratio, torque, efficiency, backlash and dimensions depend on the selected frame size, gear stage and configuration.

### Flat BLDC Motors and Joint Drives

For low-profile charging devices, thin covers, compact rotary mechanisms or limited axial packaging, [Flat BLDC Motors and Joint Drives](../products/flat-bldc-motors/index.md) may be reviewed together with gearbox or actuator requirements when the drive envelope is constrained.

## Prototype and Customization Support

Depending on the project scope, SigGear can evaluate:

- Gear ratio selection
- Motor and gearbox matching
- Output shaft customization
- Flange and mounting customization
- Cable and connector customization
- Encoder or sensor integration after review
- Low-noise configuration review
- Customer branding and labeling
- Prototype support before production planning

Energy storage, battery and charging-equipment projects may require additional review of safety standards, environmental requirements, documentation, traceability, inspection requirements or customer approval requirements. Confirm these requirements before quotation.

## Information Needed for Energy or Charging Equipment Review

Please provide one requirement set for each actuator position.

Provide:

- Equipment type and actuator function
- Prototype, test fixture or production-use target
- Safety relevance or non-safety function statement
- Required output torque or force
- Peak torque and peak duration
- Required output speed
- Stroke length or rotation angle
- Gear ratio if known
- Maximum diameter and length
- Operating voltage and current limit
- Indoor, outdoor, dust, moisture and temperature requirements
- Motor type preference
- Shaft, flange and mounting requirements
- Feedback, homing or limit-switch requirements
- Noise and vibration target
- Duty cycle and lifetime cycle target
- Validation, approval or documentation requirements
- Prototype quantity and estimated annual quantity
- Required customization or OEM branding

## Request an Energy Equipment Actuator Review

Send your battery, charging, power-equipment or energy-storage actuator requirements to SigGear for preliminary model evaluation. Early requirements can be approximate, but torque or force estimate, speed, size, voltage, duty cycle, environment, validation target and quantity are needed before a meaningful recommendation can be made.

**Wanrong Wang**  
International Sales, SigGear  
[wangwanrong@siggear.com](mailto:wangwanrong@siggear.com)

[Send Energy Equipment Actuator Requirements](../contact.md){ .md-button .md-button--primary }
