SigGearDrive/SigGear-product-docs/docs/applications/food-beverage-coffee-equipment-gear-motors.md

# Food, Beverage and Coffee Equipment Gear Motors

## Application Overview

Food, beverage and coffee equipment often uses compact gear motors and precision reducers for dosing, dispensing, mixing, valve movement, pump assistance, grinder adjustment, door and flap movement, cup handling, bean or powder metering, small conveyor motion and compact service mechanisms.

These machines usually require stable low-speed torque, compact size, controlled current, repeatable motion, low noise, long service life and reliable operation under frequent start-stop cycles. In many projects, the motor and gearbox must also be reviewed together with cleaning conditions, food-contact boundaries, moisture exposure, powder contamination, temperature, vibration and maintenance requirements.

SigGear can evaluate micro gear motors, compact planetary gearboxes, flat BLDC motors and customized motor/gearbox assemblies for coffee machines, beverage equipment, food dispensing devices, compact kiosks and commercial-service mechanisms. Final product selection, hygiene boundary, food-contact responsibility, electrical safety, cleaning validation and production approval must be confirmed case by case.

## Important Application Boundary

Food and beverage equipment may involve hygiene design, food-contact materials, cleaning agents, hot water, steam, powder contamination, moisture, electrical safety, public-use requirements and market-specific compliance. This page provides preliminary actuator-selection guidance only.

Unless explicitly confirmed in writing, SigGear does not assume responsibility for:

- Food-contact material certification
- Full-machine hygiene approval
- Full-machine electrical safety certification
- Cleaning-agent compatibility validation
- Hot-water, steam or pressure-system validation
- NSF, UL, CE, FDA, LFGB or other equipment-level compliance
- Public-use equipment safety approval
- Final production approval for the customer device

For food, beverage or coffee equipment projects, share the actuator location, whether the motor is near food-contact zones, cleaning method, temperature, moisture exposure, required lifetime cycles and target market before quotation.

## Key Selection Factors

| Requirement | Why it matters |
| --- | --- |
| Actuator function | Dosing, stirring, valve movement, grinder adjustment and cup handling require different torque-speed profiles. |
| Food-contact boundary | Motor and gearbox location must be separated from direct food-contact unless otherwise validated. |
| Moisture and cleaning | Water, steam, cleaning agents and condensation affect motor, gearbox, cable and connector choices. |
| Powder and particles | Coffee powder, milk powder, sugar, tea powder and food particles can increase friction and contamination risk. |
| Duty cycle | Commercial equipment may run frequent start-stop cycles and requires thermal review. |
| Noise target | Coffee, office, hotel and vending devices often require low-noise operation. |
| Jam condition | Powder clogging, stuck cups, blocked valves and product jams can stall the motor. |
| Feedback requirement | Position control, homing, limit switches or current detection may be required. |
| Maintenance plan | Service access, replacement method and expected field life affect the mechanical design. |
| Production quantity | Custom shaft, connector and mounting design should match prototype and annual volume plans. |

## Common Food, Beverage and Coffee Equipment Use Cases

### Coffee Bean and Powder Metering

Coffee machines, bean dispensers and powder dosing devices may use compact gear motors to rotate metering wheels, augers, small drums, gate mechanisms or dosage-control mechanisms. Provide bean type, powder type, dose amount, cycle time, torque, jam risk, cleaning method, noise target and expected daily cycles.

### Grinder Adjustment and Compact Adjustment Axes

Automatic coffee grinders and beverage machines may need small gear motors for burr adjustment, recipe adjustment, valve-position adjustment, nozzle alignment or internal calibration. Provide adjustment range, torque, speed, backlash target, positioning accuracy, homing method, vibration exposure and service-life requirement.

### Beverage Valves, Diverters and Flaps

Beverage dispensers, coffee machines, tea machines, milk systems, syrup equipment and water-control devices may use gear motors for valve rotation, diverter movement, flap movement or cover control. Provide required torque, rotation angle, sealing force, fluid pressure, temperature, moisture exposure, cleaning method and fail-safe requirement.

### Pump and Dosing Assistance

Some machines use gear motors to drive small peristaltic pumps, dosing pumps, syrup pumps, milk-powder dosing mechanisms or liquid-transfer mechanisms. Provide flow rate, pressure, viscosity, temperature, duty cycle, tube or pump geometry, torque, speed and cleaning exposure.

### Cup, Lid and Product Handling

Vending machines, coffee kiosks and food-service devices may use small gear motors to move cups, lids, trays, release mechanisms, small conveyors, pusher systems or dispensing doors. Provide product weight, motion path, speed, duty cycle, jam condition, feedback requirement and available space.

### Mixing, Stirring and Agitation Mechanisms

Beverage, sauce, powder and compact food-preparation devices may use gear motors for small mixers, stirrers, agitators or blending assistance. Provide material viscosity, mixing speed, start torque, duty cycle, temperature, cleaning method and expected service life.

### Door, Cover and Service Mechanisms

Commercial food and beverage machines often require motors for service doors, ingredient-bin covers, waste-bin covers, ice doors, access panels, locks or internal flaps. Provide door size, hinge geometry, seal force, latch force, user safety requirement, manual override and power-off behavior.

## Torque, Speed and Jam Review

Food and beverage equipment should be reviewed under realistic operating conditions. Powder, syrup, milk residue, beans, cups, lids, ice, moisture and cleaning residue can change friction and cause short-term overload.

Provide:

- Equipment type and actuator function
- Mechanism type
- Required continuous torque
- Required peak torque and peak duration
- Required output speed or cycle time
- Stroke length or rotation angle
- Gear ratio if already specified
- Material being moved or controlled
- Jam, clogging or overload condition
- Operating direction and duty cycle
- Required lifetime cycles or service hours

When load data is not available, provide drawings, prototype videos, measured current curves, manual force measurements or test data from the current mechanism.

## Voltage, Current and Control Review

Food and beverage machines may use DC adapters, internal power boards, battery systems or control cabinets. Current limit, noise and thermal behavior should be reviewed together.

Clarify:

- Nominal operating voltage
- Minimum and maximum voltage range
- Power source type
- Peak current limit
- Continuous current limit
- Driver supplied by customer or by SigGear
- Control method
- Feedback, homing or limit-switch requirement
- Stall or jam detection method
- Reverse operation requirement
- Power-off holding requirement

Do not assume encoder, brake, closed-loop control, CAN, RS485 or a specific protocol unless it is included in the selected motor and driver configuration.

## Moisture, Cleaning and Hygiene Review

The motor location matters. A motor installed behind an enclosure wall has different requirements from a motor installed near steam, hot water, powder or cleaning spray.

Provide:

- Whether the actuator is inside or outside the wet area
- Whether there is direct food contact
- Water, steam, humidity or condensation exposure
- Cleaning method
- Cleaning agent exposure
- Coffee powder, milk powder, sugar, tea powder or food-particle exposure
- Operating temperature range
- Storage temperature range
- Required ingress protection target
- Required material or surface requirements
- Maintenance and replacement plan

The equipment manufacturer should define hygiene zoning, food-contact boundaries, sealing design and cleaning validation. SigGear can review motor, gearbox, shaft, cable and connector configuration after the environment is defined.

## Output Shaft, Mounting and Load Support

Food and beverage mechanisms often need customized shafts, gears, screws, cams, auger couplings, D-cut shafts, flats, threads, pulleys or compact flanges. Shaft load should be reviewed early to avoid excessive cantilevered load on small gearboxes.

Provide:

- Output shaft shape and length
- D-cut, spline, keyway, flat, thread, worm, screw, auger, gear, pulley or custom shaft requirement
- Load direction
- Distance from load point to gearbox face
- Radial and axial load estimates
- Jam or shock condition
- Flange and mounting hole requirement
- Cable exit direction
- Connector or wire harness requirement
- External bearing or support method

External support bearings are recommended when the mechanism creates significant radial load, axial thrust, jam load or impact load.

## Candidate SigGear Product Families

### Micro Gear Motors

[Micro Gear Motors](../products/micro-gear-motors/index.md) are a starting point for compact coffee, beverage, dispensing, dosing, valve, cover, flap, cup-handling and service mechanisms. SigGear can evaluate miniature planetary gear motors, custom shafts, flanges, cable exits, connectors and optional feedback after engineering review.

### 8-42 mm Planetary Gearboxes

The [8-42 mm planetary gearbox series](../products/planetary-gearboxes/8-42mm-planetary-gear-reducer.md) can be reviewed for compact transmission requirements when ratio, torque, size and mounting requirements are defined. Final performance depends on frame size, gear stage, material configuration and operating conditions.

### Flat BLDC Motors and Joint Drives

For low-profile dosing, adjustment, rotary positioning or limited axial space, [Flat BLDC Motors and Joint Drives](../products/flat-bldc-motors/index.md) may be reviewed together with gearbox or actuator requirements.

## Prototype and Customization Support

Depending on project scope, SigGear can evaluate:

- Gear ratio selection
- Motor and gearbox matching
- Output shaft customization
- Flange and mounting customization
- Cable and connector customization
- Low-voltage motor configuration
- Feedback or sensor integration after review
- Low-noise configuration review
- Moisture-aware configuration review
- Customer branding and labeling
- Prototype support before production planning

Food and beverage equipment projects may require additional review of cleaning boundaries, enclosure design, cable routing, connector selection, powder protection, inspection requirements and long-term supply planning.

## Information Needed for Food, Beverage or Coffee Equipment Review

Please provide one requirement set for each actuator position.

Provide:

- Equipment type and actuator function
- Mechanism type
- Prototype, test fixture or production-use target
- Required torque or force
- Peak torque and peak duration
- Required output speed or cycle time
- Stroke length or rotation angle
- Gear ratio if known
- Maximum diameter and length
- Operating voltage and current limit
- Power source type
- Food-contact boundary
- Moisture, steam, powder or cleaning exposure
- Operating temperature range
- Motor type preference
- Shaft, flange and mounting requirements
- Feedback, homing or limit-switch requirement
- Jam or stall-protection requirement
- Duty cycle and lifetime target
- Validation, documentation or inspection requirements
- Prototype quantity and estimated annual quantity
- Required customization or OEM branding

## Request a Food, Beverage or Coffee Equipment Gear Motor Review

Send your coffee machine, beverage dispenser, food-service machine, dosing device, valve mechanism, pump mechanism, cup-handling system, vending mechanism or compact food-equipment actuator requirements to SigGear for preliminary model evaluation. Early requirements can be approximate, but actuator function, torque or force, speed, size, voltage, current limit, environment, cleaning exposure, duty cycle, validation target and quantity are needed before a meaningful recommendation can be made.

**Wanrong Wang**  
International Sales, SigGear  
[wangwanrong@siggear.com](mailto:wangwanrong@siggear.com)

[Send Food, Beverage or Coffee Equipment Gear Motor Requirements](../contact.md){ .md-button .md-button--primary }
