SigGearDrive/SigGear-product-docs/docs/applications/hvac-smart-vent-damper-gear-motors.md

# HVAC, Smart Vent and Damper Gear Motors

## Application Overview

HVAC systems, smart vents, dampers and air-control devices often use compact gear motors and precision transmission components for air flap movement, duct damper adjustment, smart vent opening and closing, louver angle control, air-direction adjustment, mixing-door movement, small valve movement and compact thermal-management mechanisms.

These applications usually require low-speed controlled motion, reliable holding torque, quiet operation, compact size, low current consumption, stable operation over many cycles and predictable behavior near end stops. In many projects, the motor and gearbox must also be reviewed together with plastic gear interfaces, lever geometry, airflow resistance, seal friction, temperature, humidity, dust, condensation, fire or building-system boundaries and control-board requirements.

SigGear can evaluate micro gear motors, compact planetary gearboxes, flat BLDC motors and customized motor/gearbox assemblies for smart vents, HVAC air doors, damper actuators, air-control modules, thermal-management devices, indoor air-quality equipment, small fans with positioning mechanisms and compact building-automation actuators. Final model selection, building-system compliance boundary and production approval must be confirmed case by case.

## Important Application Boundary

HVAC and building-system devices may be used inside equipment that has safety, fire, electrical, environmental or building-code requirements. The actuator is only one component inside the full device or system.

Unless explicitly confirmed in writing, SigGear does not assume responsibility for:

- Building-code compliance
- Fire or smoke-control certification
- HVAC system certification
- Appliance certification
- Full-machine electrical safety approval
- EMC approval
- Ingress protection validation
- Condensation or mold-control validation
- Airflow performance validation
- Damper leakage validation
- Final equipment approval or market access

The customer should define the equipment-level requirements, applicable standards, safety boundary, validation plan and production approval responsibility before mass production.

## Key Selection Factors

| Requirement | Why it matters |
| --- | --- |
| Motion function | Smart vents, dampers, louvers, flaps and mixing doors require different torque-speed profiles. |
| Holding torque | Dampers and air doors may need to resist airflow, seal friction, spring force or gravity load. |
| End-stop behavior | Many HVAC mechanisms repeatedly hit mechanical stops, so stall current and gear load must be reviewed. |
| Noise target | Residential and office HVAC devices often require quiet opening and closing. |
| Current consumption | Battery-powered or low-voltage controllers may have strict current limits. |
| Duty cycle | Seasonal operation, frequent automation cycles and long standby periods require lifetime review. |
| Temperature and humidity | HVAC environments can include heat, cold, condensation, dust and airflow changes. |
| Backlash and positioning | Airflow control may require repeatable angle positioning or multi-position control. |
| Output shaft and lever geometry | Small changes in lever arm, cam shape or flap load can significantly change required torque. |
| Validation boundary | Building-system, appliance and safety compliance remain the customer’s system-level responsibility. |

## Common HVAC, Smart Vent and Damper Use Cases

### Smart Vent Opening and Closing

Smart vents, intelligent registers and room-level airflow control devices may use compact gear motors to open, close or partially position vent blades. Provide blade size, number of blades, linkage geometry, seal friction, airflow pressure, required angle range, operating speed, noise target, current limit and feedback requirement.

### Duct Damper and Airflow Control

Duct dampers, air-distribution boxes and small air-control units may require gear motors to rotate dampers or move air doors. Provide damper diameter or blade size, shaft torque, airflow pressure, seal force, spring return requirement, angle range, speed, holding torque and expected lifetime cycles.

### HVAC Mixing Door and Flap Movement

Air conditioners, ventilation modules, small thermal-management units and HVAC subassemblies may use gear motors for mixing doors, recirculation flaps, fresh-air doors and mode-control flaps. Provide flap geometry, lever arm, torque, travel angle, end-stop design, duty cycle, ambient temperature and noise target.

### Louver and Air-Direction Adjustment

Air outlets, purifiers, dehumidifiers, heaters, smart fans and compact appliances may use gear motors to adjust louvers, swing blades or air-direction guides. Provide blade mass, quantity, linkage type, travel angle, speed, smoothness requirement, noise target, current limit and gear interface.

### Thermal-Management Dampers and Small Valves

Battery cabinets, charging equipment, electronics enclosures, energy-storage systems and industrial devices may use compact actuators for airflow dampers, vent covers, bypass flaps or small thermal-management valves. Provide operating environment, required torque, opening angle, sealing force, temperature range, dust or moisture exposure and fail-safe requirement.

### Air Purifier, Humidifier and Dehumidifier Mechanisms

Indoor air-quality devices may use small gear motors for air outlets, water-tank locks, filter doors, flow-control flaps, fragrance doors or service mechanisms. Provide required torque, mechanism geometry, noise target, humidity exposure, duty cycle, current limit and manual override requirement.

### Fireplace, Exhaust and Specialty Vent Devices

Specialty ventilation devices, exhaust controls, compact dampers and appliance-adjacent air-control mechanisms may require additional temperature, sealing, safety and compliance review. Provide heat exposure, airflow pressure, duty cycle, sealing requirement, power-off behavior and certification boundary.

## Torque, Speed and End-Stop Review

HVAC and damper mechanisms should be reviewed under realistic air pressure, seal friction, temperature and end-stop conditions. Required torque can change significantly with blade size, linkage geometry, gasket compression, dust accumulation and operating orientation.

Provide:

- Equipment type and actuator function
- Vent, damper, flap, louver or valve mechanism type
- Required continuous torque
- Required peak torque and peak duration
- Required output speed or opening time
- Rotation angle or travel distance
- Required holding torque
- Seal friction or gasket compression
- Air pressure or airflow resistance
- Spring force if applicable
- Lever arm, cam geometry or gear interface
- End-stop design
- Stall or jam condition
- Operating direction and duty cycle
- Required lifetime cycles or service hours

When exact torque data is not available, provide drawings, CAD models, prototype videos, manual-force measurements, current curves or test data from the existing mechanism.

## Voltage, Current and Control Review

Smart vents and HVAC control devices may use 5 V, 12 V, 24 V or other low-voltage supplies, battery power, thermostat controllers, appliance boards or building automation controllers. Current limit and stall behavior must be reviewed carefully.

Clarify:

- Nominal operating voltage
- Minimum and maximum voltage range
- Peak current limit
- Continuous current limit
- Driver supplied by customer or by SigGear
- Control method
- Required speed control or position control
- Feedback requirement
- Homing or limit-switch method
- Stall detection or end-stop detection method
- Holding current or self-locking requirement
- Brake or power-off holding requirement
- Cable length and routing limit
- Electrical noise or EMC constraints

Do not assume encoder, brake, closed-loop control, CAN, RS485 or a specific protocol unless it is included in the selected motor and driver configuration.

## Noise, Current and User-Experience Review

Residential and office HVAC devices are often sensitive to motor noise, gear noise, vibration and sudden end-stop impact. Smooth motion and controlled current can improve perceived quality and reduce mechanism stress.

Define:

- Whether motion occurs while users are nearby
- Allowable acoustic noise target
- Maximum current during normal movement
- Maximum current at end stop or stall
- Opening and closing time target
- Acceleration and deceleration preference
- Backlash or angle repeatability target
- Whether quiet night operation is required
- Mounting stiffness and enclosure resonance

Low-noise and low-current behavior should be confirmed by prototype testing in the customer mechanism.

## Environment, Temperature and Humidity Review

HVAC applications may face cold air, warm air, condensation, humidity, dust, lint, cleaning exposure and long standby periods. The motor location and enclosure design affect the actuator configuration.

Provide:

- Indoor, outdoor or equipment-internal use
- Operating temperature range
- Storage temperature range
- Humidity and condensation exposure
- Dust, lint or airflow contamination
- Cleaning method or chemical exposure
- Required ingress protection target
- Cable and connector exposure
- Long standby or seasonal operation requirement
- Maintenance and replacement plan

The equipment manufacturer should define condensation control, dust control, thermal design, sealing, safety and environmental validation. SigGear can review motor, gearbox, shaft, cable and connector configuration after the environment is defined.

## Output Shaft, Mounting and Load Support

HVAC and damper mechanisms often use custom shafts, D-cut shafts, splines, pinions, sector gears, cams, levers, crank arms, couplings, brackets and compact flanges. Shaft load and alignment should be reviewed early.

Provide:

- Output shaft shape and length
- D-cut, spline, gear, pinion, cam, lever, crank, coupling or custom shaft requirement
- Load direction
- Distance from load point to gearbox face
- Radial and axial load estimates
- End-stop or shock load condition
- Required bearing support
- Flange and mounting hole requirement
- Cable exit direction
- Connector or wire harness requirement
- Assembly tolerance requirement

External support bearings are recommended when the mechanism creates significant radial load, axial thrust, side load, spring force, shock load or lever load.

## Candidate SigGear Product Families

### Micro Gear Motors

[Micro Gear Motors](../products/micro-gear-motors/index.md) are a starting point for smart vents, louvers, flaps, small dampers, air purifier outlets, small valves, lock mechanisms and compact thermal-management actuators. SigGear can evaluate miniature planetary gear motors, custom shafts, flanges, cable exits, connectors and optional feedback after engineering review.

### 8-42 mm Planetary Gearboxes

The [8-42 mm planetary gearbox series](../products/planetary-gearboxes/8-42mm-planetary-gear-reducer.md) can be reviewed for compact transmission requirements where ratio, torque, size, backlash target and mounting requirements are defined. Final performance depends on frame size, gear stage, material configuration and operating conditions.

### Flat BLDC Motors and Joint Drives

For low-profile rotary positioning, compact air-control modules or limited axial space, [Flat BLDC Motors and Joint Drives](../products/flat-bldc-motors/index.md) may be reviewed together with gearbox or actuator requirements.

## Prototype and Customization Support

Depending on project scope, SigGear can evaluate:

- Gear ratio selection
- Motor and gearbox matching
- Output shaft customization
- Flange and mounting customization
- Cable and connector customization
- Low-voltage motor configuration
- Feedback or sensor integration after review
- Low-noise configuration review
- Low-current configuration review
- End-stop and stall-current review
- Humidity-aware configuration review
- Customer branding and labeling
- Prototype support before production planning

HVAC and smart-vent projects may require additional review of lifetime cycles, current limits, end-stop behavior, noise, environmental exposure, inspection requirements and long-term supply planning.

## Information Needed for HVAC, Smart Vent or Damper Review

Please provide one requirement set for each actuator position.

Provide:

- Equipment type and actuator function
- Vent, damper, louver, flap, valve or air-door mechanism type
- Prototype, test fixture or production-use target
- Required torque or force
- Peak torque and peak duration
- Required output speed or opening time
- Rotation angle or travel distance
- Holding torque requirement
- Seal friction, gasket compression or airflow pressure
- Lever arm, cam, gear or shaft interface
- Maximum diameter and length
- Operating voltage and current limit
- Driver or control-board responsibility
- Feedback, homing or limit-switch requirement
- Noise target
- End-stop and stall condition
- Temperature, humidity, dust or condensation exposure
- Shaft, flange and mounting requirements
- Cable exit and connector requirements
- Duty cycle and lifetime target
- Validation, inspection or compliance boundary
- Prototype quantity and estimated annual quantity
- Required customization or OEM branding

## Request an HVAC, Smart Vent or Damper Gear Motor Review

Send your smart vent, duct damper, HVAC flap, louver, air outlet, thermal-management damper, air purifier mechanism, humidifier mechanism, dehumidifier mechanism or compact air-control actuator requirements to SigGear for preliminary model evaluation. Early requirements can be approximate, but actuator function, torque or force, speed, size, voltage, current limit, noise target, environment, duty cycle, validation boundary and quantity are needed before a meaningful recommendation can be made.

**Wanrong Wang**  
International Sales, SigGear  
[wangwanrong@siggear.com](mailto:wangwanrong@siggear.com)

[Send HVAC, Smart Vent or Damper Gear Motor Requirements](../contact.md){ .md-button .md-button--primary }
