SigGearDrive/SigGear-product-docs/docs/applications/office-automation-business-equipment-gear-motors.md

# Office Automation and Business Equipment Gear Motors

Office automation and business equipment often use compact gear motors for paper movement, card handling, document feeding, compact locking, small lifting, scanning, dispensing and service-door mechanisms.

These applications usually require stable low-speed motion, compact size, quiet operation, controlled current, reliable start-up torque and consistent behavior across many short cycles.

SigGear supports engineering review for office automation and business equipment projects that need compact gear motors, micro planetary gearboxes or customized motor-and-gearbox assemblies.

## Application Overview

Office and business equipment mechanisms often appear simple from the outside, but the internal motion system may need careful matching between motor torque, gearbox ratio, output speed, duty cycle, current limit, noise level, shaft load and installation space.

Typical motion functions include:

- feeding paper or cards
- moving scanner or optical modules
- opening and closing covers
- driving rollers or belts
- shifting small trays
- moving cutter or release mechanisms
- locking or unlocking service doors
- positioning small guide plates
- dispensing tickets, labels or documents
- assisting compact counting or sorting mechanisms

The best gear motor depends on the real load, available voltage, required cycle time, mechanism efficiency, jam condition and expected service life.

## Important Application Boundary

SigGear can support motor and gearbox selection, mechanical customization and prototype review.

The customer or equipment manufacturer remains responsible for the final machine validation, electrical safety, EMC compliance, firmware control logic, user safety, jam detection, regulatory approval and complete equipment certification.

For business equipment used in public or high-duty environments, the complete device should be validated under real operating cycles, dust conditions, paper quality variation, card thickness variation, temperature range and user misuse scenarios.

## Common Office Automation and Business Equipment Use Cases

### Printer, Copier and Paper-Feed Mechanisms

Printers, copiers and multifunction machines often use compact geared motors for paper feed, roller drive, tray lift, guide adjustment and small internal motion axes.

Key selection factors include:

- paper feed force
- roller diameter
- required paper speed
- start-stop frequency
- jam condition
- noise during feed cycles
- gear backlash tolerance
- current limit during blocked rotation
- installation space near rollers or trays
- operating life across repeated short cycles

A gear motor for paper-feed movement should be reviewed together with the roller geometry, friction material, spring preload and paper path design.

### Scanner and Document-Feed Systems

Document scanners, automatic document feeders and compact inspection devices may use gear motors for document movement, carriage movement, tray shifting or small optical-module positioning.

Important review points include:

- smooth low-speed motion
- vibration control
- constant feed speed
- positioning repeatability
- paper thickness variation
- low acoustic noise
- compact gearbox diameter
- shaft alignment with belts, pulleys or rollers
- feedback or sensor requirements

For scanning systems, vibration and speed ripple may directly affect image quality, so the gearbox ratio and motor control method should be confirmed carefully.

### Shredder and Cutter Assistance Mechanisms

Business shredders, small cutters and document destruction devices may require motors or gearboxes for paper feed, cutter assistance, reverse movement or jam recovery.

The selection should consider:

- peak torque during cutting or jam recovery
- continuous torque during normal feed
- reverse rotation requirement
- stall current limitation
- thermal rise during repeated cycles
- overload protection
- gear strength
- noise and vibration
- expected sheet quantity or material thickness

A shredder or cutter mechanism should not be selected only by no-load speed. The blocked or overloaded condition is often the real design boundary.

### Ticket, Label and Receipt Handling Devices

Ticket printers, label dispensers, receipt modules and queue-number machines may use compact gear motors for paper feed, ticket separation, label release, cutter movement or take-up mechanisms.

Important parameters include:

- feed distance per cycle
- feed speed
- roller force
- cutter or release force
- intermittent duty cycle
- required stopping accuracy
- low noise requirement
- jam condition
- operating voltage
- available mounting space

For label and receipt mechanisms, torque margin should be checked with different paper rolls, adhesive labels and environmental humidity.

### Card Handling and Small Media Transport

Card readers, badge printers, ID-card devices, access terminals and service kiosks may use gear motors for card entry, card ejection, roller transport or gate movement.

Review points include:

- card thickness range
- roller grip force
- feed direction and reverse motion
- required card speed
- jam detection method
- current limit during blocked cards
- output shaft support
- noise level at public terminals
- long-term roller wear

The motor should be selected together with the roller, belt, sensor and control logic, especially when reverse movement or jam recovery is required.

### Cash, Coin and Counting Mechanisms

Business equipment such as counters, compact cash-handling modules, coin mechanisms and sorting devices may use gear motors for small transport, counting, diverter, release or gate movement.

Important selection factors include:

- intermittent start-stop torque
- small mechanism inertia
- load variation
- jam or blocked condition
- required motion cycle
- sensor feedback
- duty cycle
- noise level
- compact mounting interface
- gearbox durability

Cash-handling equipment usually requires the complete equipment manufacturer to validate security, counting accuracy, anti-jam behavior and user safety.

### Small Locking, Latching and Service-Door Mechanisms

Office and business equipment may include service doors, paper-tray locks, cartridge locks, cover locks, maintenance access doors and compact cabinet latches.

A gear motor for locking movement should be reviewed for:

- locking force
- release torque
- power-off state
- self-locking or backdrivability requirement
- manual override requirement
- blocked movement current
- sensor confirmation
- security boundary
- plastic or metal latch interface
- expected cycle life

Locking functions should not rely only on gearbox holding torque unless the mechanical design and safety requirements allow it.

### Compact Tray, Drawer and Lift Mechanisms

Small trays, drawers, inspection platforms, feeding shelves and sample-like business equipment modules may require compact gear motors for short-stroke movement through screws, belts, racks, cams or linkages.

Important review information includes:

- moved mass
- stroke length
- cycle time
- screw lead or pulley diameter
- friction load
- vertical or horizontal orientation
- holding requirement
- limit switch position
- output shaft radial load
- installation space

If the load is vertical, holding torque and power-off behavior should be checked carefully.

### Cover, Flap and Guide-Plate Movement

Business machines often use small motors for automatic covers, flaps, guide plates, media gates and diverter movement.

Key selection items include:

- required opening angle
- lever length
- spring preload
- required closing force
- end-stop impact
- low noise requirement
- compact gearbox length
- blocked condition
- user interaction and pinch risk

The customer should provide the mechanism drawing or motion sketch so the torque can be estimated at the output shaft.

## Key Selection Factors

### Torque and Load Margin

Torque should be calculated from the real mechanism geometry, including roller radius, belt tension, screw lead, friction, spring preload, media resistance, cover weight and any jam recovery condition.

For many business equipment devices, peak torque is more important than no-load speed because the motor must start reliably after long idle time or during a partially blocked condition.

### Output Speed and Cycle Time

The required speed depends on the motion function.

Paper-feed, card-feed and label-feed systems usually require a stable feed speed.

Latch, flap and cover mechanisms usually require a controlled motion time with low impact at the end stop.

Tray and drawer mechanisms may require slower, smoother movement to reduce noise and avoid vibration.

### Duty Cycle and Thermal Rise

Many office and business devices run in short intermittent cycles. However, peak usage in public terminals, service equipment or commercial environments can be much higher than normal office use.

Please provide:

- cycle time
- cycles per minute
- expected cycles per day
- continuous run duration
- idle time between cycles
- blocked or jam recovery frequency

Thermal review should include both normal duty and abnormal blocked conditions.

### Noise and Vibration

Office equipment is often used near people, so acoustic noise can be an important selection factor.

Noise is affected by motor type, gear material, gearbox ratio, load, mounting stiffness, housing resonance, motor control method and end-stop impact.

For low-noise projects, the mechanism should reduce hard impacts, excessive gear load, misalignment and resonance.

### Current Limit and Power Supply

Business equipment may use low-voltage DC power systems, battery backup, shared power rails or compact adapters.

The motor should be checked for:

- rated voltage
- no-load current
- loaded current
- start current
- stall current
- allowable controller current
- power supply margin
- protection behavior during jam

A motor that passes no-load testing may still exceed current limits during real paper, card, tray or latch movement.

### End-Stop, Jam and Blocked-Rotation Behavior

Many business equipment mechanisms reach a mechanical end stop or may be blocked by paper, cards, labels, coins, covers or user misuse.

The complete system should define:

- whether the motor can hit a hard stop
- whether current sensing is used
- whether limit switches or sensors are used
- how long stall current may occur
- whether reverse movement is required
- whether the user can manually clear the jam

Blocked-condition testing is important for reliability and safety.

### Output Shaft, Mounting and Load Support

Small gear motors may be connected to rollers, pulleys, cams, gears, racks, screws or custom plastic mechanisms.

The output shaft and gearbox should be reviewed for:

- radial load
- axial load
- shaft diameter
- shaft flat or D-cut requirement
- gear or pulley fixation
- bearing support
- mounting screw pattern
- allowable overhung load
- housing material and support structure

If the mechanism applies high side load, an external bearing or support may be required.

### Feedback and Control

Some office automation mechanisms can use open-loop control with end switches. Others need encoder feedback, current feedback, Hall feedback or position sensors.

Feedback requirements depend on:

- stopping accuracy
- missed-movement risk
- jam detection method
- reverse motion requirement
- safety logic
- repeatability requirement
- host controller capability

The control interface should be confirmed during engineering review.

## Candidate SigGear Product Families

### Micro Gear Motors

[Micro Gear Motors](../products/micro-gear-motors/index.md) are suitable for compact office automation and business equipment mechanisms where small size, light weight and low-voltage operation are important.

Typical uses may include card handling, small locks, guide plates, compact flaps, ticket handling, tray motion and small media transport.

### 8-42 mm Planetary Gearbox Series

The [8-42 mm planetary gearbox series](../products/planetary-gearboxes/8-42mm-planetary-gear-reducer.md) can be reviewed for compact mechanisms that need higher torque density, improved durability or customized ratio and output interface.

Typical uses may include roller drives, small lift modules, tray drives, business-device actuators and compact automation axes.

### Flat BLDC Motors and Joint Drives

[Flat BLDC Motors and Joint Drives](../products/flat-bldc-motors/index.md) may be reviewed when the equipment needs a low-profile motor package, smoother motion or a brushless motor solution.

The final selection depends on available space, torque, speed, control method and required life.

## Customization Support

SigGear can support customization after the application review, including:

- gearbox ratio review
- motor voltage review
- shaft customization
- mounting interface customization
- cable and connector review
- noise-sensitive design review
- prototype sample support
- drawing-based engineering communication

Customization feasibility depends on the target quantity, available tooling, technical requirements and mechanical boundary conditions.

## Information Needed for Selection

Please provide the following information for office automation or business equipment projects:

- equipment type
- motion function
- required output torque or load condition
- required speed or cycle time
- operating voltage
- available motor and gearbox space
- output shaft drawing
- roller, pulley, screw, cam or linkage dimensions
- radial and axial load on the output shaft
- normal duty cycle
- jam or blocked condition
- noise requirement
- feedback or sensor requirement
- first sample quantity
- estimated annual quantity

If drawings are not ready, a mechanism sketch with key dimensions is enough for the first review.

## Contact SigGear

For office automation, business equipment, printer, scanner, card-handling, ticket-handling, compact tray, locking or small actuator projects, please send the motion requirements, drawings and target quantity to SigGear for engineering review.

Email: [wangwanrong@siggear.com](mailto:wangwanrong@siggear.com)

[Send office automation gear motor requirements](../contact.md){ .md-button .md-button--primary }
