SigGearDrive/SigGear-product-docs/docs/applications/vending-dispensing-kiosk-gear-motors.md

# Vending, Dispensing and Kiosk Gear Motors

## Application Overview

Vending machines, dispensing equipment, self-service kiosks and commercial smart cabinets often use compact gear motors for product release, auger rotation, tray movement, cup handling, door locks, flap movement, pump assistance, ticket or card handling and small positioning axes. These mechanisms require reliable motion, controlled speed, repeatable positioning and predictable behavior under frequent cycles.

A vending or dispensing gear motor should be selected from the complete mechanism. Torque, output speed, gear ratio, product load, friction, stall condition, duty cycle, noise, packaging, voltage, current limit, feedback and service access all affect whether a micro gear motor or compact planetary gearbox can be used reliably.

SigGear can evaluate micro gear motors, compact planetary gearboxes, flat BLDC motors and customized motor/gearbox assemblies for vending, dispensing, kiosk and smart cabinet mechanisms. Final selection, electrical integration, equipment validation, hygiene requirements and production approval must be confirmed case by case.

## Important Application Boundary

Commercial equipment may have customer-specific reliability, electrical safety, sanitation, food-contact, payment-security, enclosure and regional compliance requirements. This page provides preliminary actuator-selection guidance only.

Unless explicitly confirmed in writing, SigGear does not assume responsibility for:

- Equipment-level safety certification
- Food-contact or sanitation compliance of the full device
- Payment-system or security validation
- Outdoor enclosure or IP-rating validation of the full device
- System-level reliability validation
- Final production approval for the customer equipment

For vending, kiosk or dispensing equipment projects, share the target standards, validation plan, installation environment, drawings, expected annual volume and approval process before quotation.

## Key Selection Factors

| Requirement | Why it matters |
| --- | --- |
| Dispensing mechanism | Auger, pusher, flap, roller, cam, pump and tray systems need different torque-speed behavior. |
| Product load | Bottle, can, snack, capsule, powder, liquid or ticket handling creates different friction and jam risks. |
| Output torque | Springs, product weight, seal friction and jams can create high peak torque. |
| Output speed | Affects dispense time, noise, current draw and user experience. |
| Duty cycle | Vending and kiosk equipment may require frequent cycles over long service periods. |
| Voltage and current | Battery, DC adapter and cabinet electronics have different current-limit requirements. |
| Feedback requirement | Position confirmation, home sensing, Hall sensors, encoders or limit switches may be needed. |
| Noise | User-facing commercial equipment often requires controlled acoustic behavior. |
| Jam behavior | Stall protection, current limit and manual service access should be defined early. |
| Custom interface | Shaft, flange, cable, connector and mounting details usually need equipment-specific review. |

## Common Vending and Dispensing Use Cases

### Spiral Auger and Product Push Mechanisms

Snack vending, capsule dispensing, parts feeders and packaged-product systems may use gear motors to rotate an auger, drive a pusher or move a release cam. Provide product size, product weight, friction condition, auger pitch, required rotation angle, dispense time, jam condition and cycle frequency.

### Door, Flap and Lock Mechanisms

Smart cabinets, pickup lockers, retail vending machines and self-service terminals may require small gear motors for door locks, release latches, flaps and access-control mechanisms. Provide locking force, latch geometry, travel distance or rotation angle, power-off behavior, manual override requirement and lifetime cycle target.

### Cup, Lid and Tray Handling

Coffee machines, beverage equipment and automated kiosks may use compact actuators for cup release, lid handling, tray movement, stirrer movement, small conveyors or rotary selection. Provide load weight, motion stroke, positioning requirement, hygiene boundary, cleaning exposure and duty cycle.

### Pump, Valve and Liquid Dispensing Assistance

Commercial dispensers may use small motors for pump assistance, valve actuation or dose-control mechanisms. Provide fluid type, pressure, flow or volume requirement, seal friction, duty cycle, cleaning condition and whether the motor is isolated from fluid.

### Ticket, Card, Paper and Label Handling

Ticket kiosks, payment terminals and label or card dispensers may need gear motors for rollers, feed wheels, cutter movement, gates or small sorting axes. Provide paper or card thickness, feed speed, roller diameter, nip force, jam detection method and feedback requirement.

### Kiosk, Display and Small Positioning Axes

Self-service kiosks and commercial smart equipment may use gear motors for display movement, camera adjustment, scanner positioning, cover movement or small service mechanisms. Provide payload, motion range, speed, backlash requirement, noise target and mounting envelope.

## Torque, Speed and Mechanism Review

Dispensing mechanisms should be reviewed from the actual load path. Motor rated power alone is not enough because real loads can come from product friction, product stacking, spring force, seal resistance, roller pressure, misalignment, jam conditions or user interaction.

Provide:

- Equipment type and dispensing function
- Product type, size and weight
- Required output torque or force
- Peak torque and peak duration
- Required output speed
- Rotation angle, stroke length or cycle time
- Gear ratio if already specified
- Mechanism drawing or linkage dimensions
- Friction, spring, seal, latch or roller load
- Jam, stall or obstruction condition
- Required lifetime cycles

When torque is not known, provide drawings, test data, estimated forces, prototype videos or measured current curves for review.

## Voltage, Current and Control Review

Vending, kiosk and commercial equipment may use 12 V, 24 V or other DC supplies depending on the cabinet electronics. The motor, gearbox and driver should be reviewed together to prevent excessive current, overheating or unreliable dispensing.

Clarify:

- Nominal operating voltage
- Minimum and maximum operating voltage
- Peak current limit
- Continuous current limit
- Driver supplied by customer or by SigGear
- Control method
- Stall protection method
- Jam detection method
- Home position or limit switch requirement
- Standby-power requirement if battery powered

Do not assume encoder, brake, closed-loop control, CAN, RS485 or another protocol unless it is included in the selected motor and driver configuration.

## Reliability, Noise and Service Review

Vending and kiosk equipment is often user-facing and may operate for long periods with limited service access. Noise, cycle life, jam recovery and replacement method should be reviewed early.

Provide:

- Expected cycles per day
- Required lifetime cycles
- Operating temperature range
- Indoor or outdoor installation
- Dust, splash, humidity or cleaning exposure
- Noise target and measurement distance
- Maintenance interval
- Replacement or service-access method
- Jam recovery method
- Acceptable failure mode

Noise and service life are configuration-specific and should be confirmed under representative load, speed, mounting and environmental conditions.

## Output Shaft, Mounting and Load Support

Dispensing equipment may use augers, cams, gears, rollers, pulleys, belts, pusher linkages or spring-loaded release mechanisms. These can create radial load, axial load, cantilevered load or shock load on the gearbox output.

Provide:

- Output shaft shape and length
- D-cut, spline, gear, keyway or custom shaft requirement
- Flange and mounting hole requirement
- Load direction
- Distance from load point to gearbox face
- Auger, roller, cam, gear, belt or linkage geometry
- External bearing or support method
- Shock, jam or obstruction condition

External support bearings are recommended when the mechanism creates significant radial, axial or cantilevered load.

## Candidate SigGear Product Families

### Micro Gear Motors

[Micro Gear Motors](../products/micro-gear-motors/index.md) are a starting point for compact dispensing, release, latch, roller, flap, pump-assist and small positioning mechanisms. SigGear can evaluate miniature planetary gear motors, compact reduction motors, motor and gearbox integration, custom output shafts, flanges and mounting interfaces, and optional encoder or cable integration after engineering review.

### 8–42 mm Planetary Gearboxes

The [8–42 mm planetary gearbox series](../products/planetary-gearboxes/8-42mm-planetary-gear-reducer.md) provides compact reducer options for different frame sizes. Final ratio, torque, efficiency, backlash and dimensions depend on the selected frame size, gear stage and configuration.

### Flat BLDC Motors and Joint Drives

For low-profile kiosks, thin covers, compact rotary mechanisms or limited axial packaging, [Flat BLDC Motors and Joint Drives](../products/flat-bldc-motors/index.md) may be reviewed together with gearbox or actuator requirements when the drive envelope is constrained.

## Prototype and Customization Support

Depending on the project scope, SigGear can evaluate:

- Gear ratio selection
- Motor and gearbox matching
- Output shaft customization
- Flange and mounting customization
- Cable and connector customization
- Encoder or sensor integration after review
- Low-noise configuration review
- Customer branding and labeling
- Prototype support before production planning

Commercial equipment projects may require additional review of reliability standards, sanitation or cleaning exposure, documentation, traceability, inspection requirements and customer approval requirements. Confirm these requirements before quotation.

## Information Needed for Vending or Dispensing Gear Motor Review

Please provide one requirement set for each actuator position.

Provide:

- Equipment type and actuator function
- Product being dispensed or handled
- Prototype, test fixture or production-use target
- Required output torque or force
- Peak torque and peak duration
- Required output speed
- Stroke length, rotation angle or cycle time
- Gear ratio if known
- Maximum diameter and length
- Operating voltage and current limit
- Indoor, outdoor, dust, moisture and cleaning requirements
- Motor type preference
- Shaft, flange and mounting requirements
- Feedback, homing or limit-switch requirements
- Noise and vibration target
- Jam detection or stall-protection requirement
- Duty cycle and lifetime cycle target
- Validation, approval or documentation requirements
- Prototype quantity and estimated annual quantity
- Required customization or OEM branding

## Request a Vending or Dispensing Gear Motor Review

Send your vending, dispensing, kiosk or smart cabinet actuator requirements to SigGear for preliminary model evaluation. Early requirements can be approximate, but product load, torque or force estimate, speed, size, voltage, duty cycle, environment, validation target and quantity are needed before a meaningful recommendation can be made.

**Wanrong Wang**  
International Sales, SigGear  
[wangwanrong@siggear.com](mailto:wangwanrong@siggear.com)

[Send Vending or Dispensing Gear Motor Requirements](../contact.md){ .md-button .md-button--primary }
