SigGearDrive/SigGear-product-docs/docs/custom-engineering/robot-joint-actuator-development.md

---
title: Custom Robot Joint Actuator Manufacturer & Engineering | SigGear
description: Custom robot joint actuator engineering and manufacturing for humanoid, quadruped, robot arm and exoskeleton projects using planetary or cycloidal transmissions.
---

# Custom Robot Joint Actuator Development

## Start From the Joint Requirement, Not From an Existing Actuator Model

A robotics project does not need to fit an existing SigGear actuator exactly.

You may already know the joint torque, speed and installation envelope. You may also have only a robot mechanism, link geometry, motor preference, CAD concept or early prototype.

SigGear develops and manufactures robot joint actuators, planetary actuator platforms and cycloidal joint modules for robotics and compact motion systems.

SigGear can review the joint as a system and evaluate the actuator gearbox or reducer, motor, sensing, driver and mechanical interfaces together.

Depending on the project, the engineering path may start from:

- an existing SigGear planetary actuator
- an existing SigGear cycloidal joint module
- a gearbox-centered solution for the customer's own motor and controller
- a motor + gearbox combination
- a modified mechanical interface
- a new compact actuator configuration based on the application requirements

[Send Your Joint Requirement](mailto:wangwanrong@siggear.com?subject=Robot%20Joint%20and%20Compact%20Actuator%20Engineering%20Review){ .md-button .md-button--primary }
[Humanoid and Bipedal Robot Joint Engineering](../applications/humanoid-robot-joint-actuators.md){ .md-button }
[Request Engineering Review](../request-cad-sample-quote.md){ .md-button }

## What Can SigGear Supply?

Depending on the project and engineering feasibility, the supply scope may include:

- gearbox / reducer only
- motor + gearbox assembly
- planetary robot joint actuator
- cycloidal joint module
- actuator with encoder
- actuator with driver where applicable
- modified mechanical interface
- project-specific joint configuration

The exact configuration depends on torque, speed, packaging, motor, sensing, controller and mechanical-interface requirements.

## Project-Specific and OEM Development

For OEM or project-specific robot joint programs, the engineering review can begin from an existing SigGear actuator platform, the customer's motor/controller architecture, or a new mechanical requirement. Final feasibility depends on the complete torque-speed requirement, packaging, interfaces, electronics configuration and production plan.

## What the Engineering Review Starts With

A meaningful robot-joint review normally needs the axis requirement rather than one isolated torque number.

Useful inputs include:

- robot type and joint position
- payload and moving-link mass
- link length and center-of-gravity location
- continuous torque
- peak torque and peak duration
- output speed and motion cycle
- maximum diameter, thickness, length and weight
- radial / axial load and overturning load where relevant
- operating voltage and controller current limits
- encoder and feedback requirement
- driver and control mode
- communication interface
- power-off behavior and brake requirement
- prototype quantity and expected production volume

If some of these are not known yet, send the mechanism, CAD, sketch or the information already available. The engineering review can identify what needs to be calculated, measured or tested before the actuator architecture is fixed.

## Planetary, Cycloidal or Another Joint Architecture?

SigGear publishes both planetary robot joint actuators and cycloidal joint modules.

Neither structure should be selected from a general rule alone.

The choice needs to consider:

- torque-speed requirement
- installation diameter and axial thickness
- motor speed and motor size
- ratio
- efficiency
- backlash
- external loads
- thermal condition
- noise target
- backdrivability or holding requirement
- encoder / driver architecture
- prototype and production constraints

For a project where the transmission structure has not been decided, send the operating requirement first.

[Custom Planetary Gearbox Engineering](custom-planetary-gearbox.md){ .md-button }
[Custom Cycloidal Transmission Engineering](custom-cycloidal-transmission.md){ .md-button }
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
