SigGearDrive/SigGear-product-docs/docs/custom-engineering/custom-cycloidal-transmission.md

---
title: Custom Cycloidal Gearbox & Reducer Engineering | SigGear
description: Custom cycloidal gearbox and reducer engineering for compact robot joints, motor integration, mechanical interfaces, prototypes and design refinement.
---

# Custom Cycloidal Transmission Engineering

## Start From the Joint Requirement, Not the Transmission Assumption

You do not need to decide in advance that the project must use a cycloidal reducer.

For a compact robot joint, actuator or rotary mechanism, the first engineering review should start from the actual requirements:
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
