SigGearDrive/SigGear-product-docs/assets/images/planetary-gearbox/6-42mm-planetary-gear-reducer-series.jpg/22mm/1.png

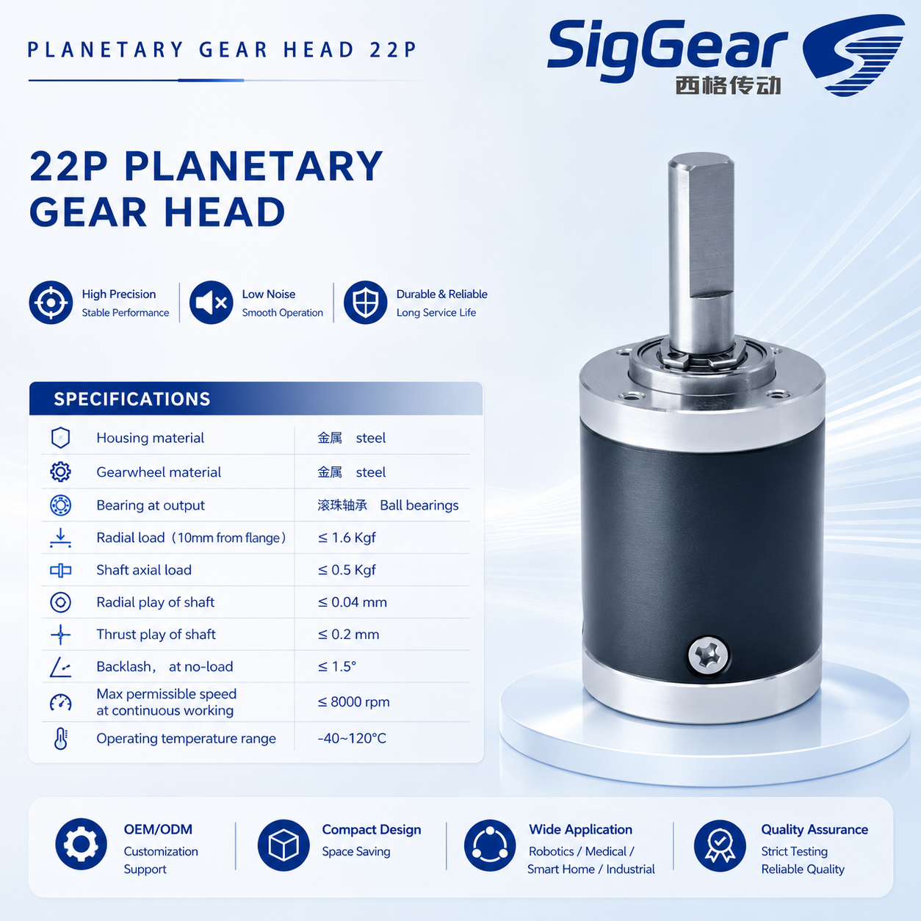
assets/images/planetary-gearbox/6-42mm-planetary-gear-reducer-series.jpg/22mm/1.png
