SigGearDrive/SigGear-product-docs/assets/images/planetary-gearbox/6-42mm-planetary-gear-reducer-series.jpg/24mm/2.png

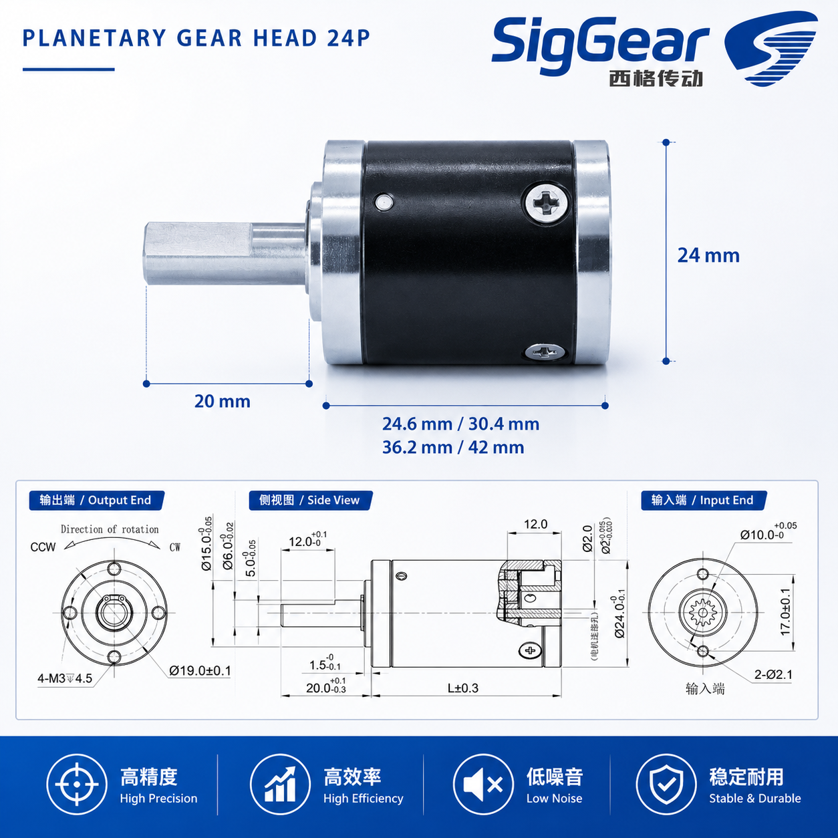
assets/images/planetary-gearbox/6-42mm-planetary-gear-reducer-series.jpg/24mm/2.png
