SigGearDrive/SigGear-product-docs/assets/images/planetary-gearbox/6-42mm-planetary-gear-reducer-series.jpg/42mm/1.jpg

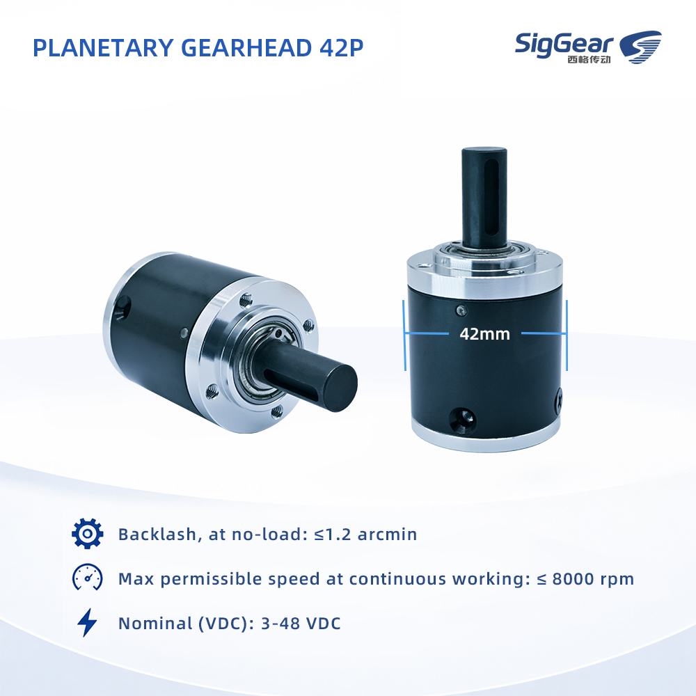
assets/images/planetary-gearbox/6-42mm-planetary-gear-reducer-series.jpg/42mm/1.jpg
