SigGearDrive/SigGear-product-docs/assets/images/planetary-gearbox/6-42mm-series/08mm-planetary-gearbox-04-structure.jpg.png

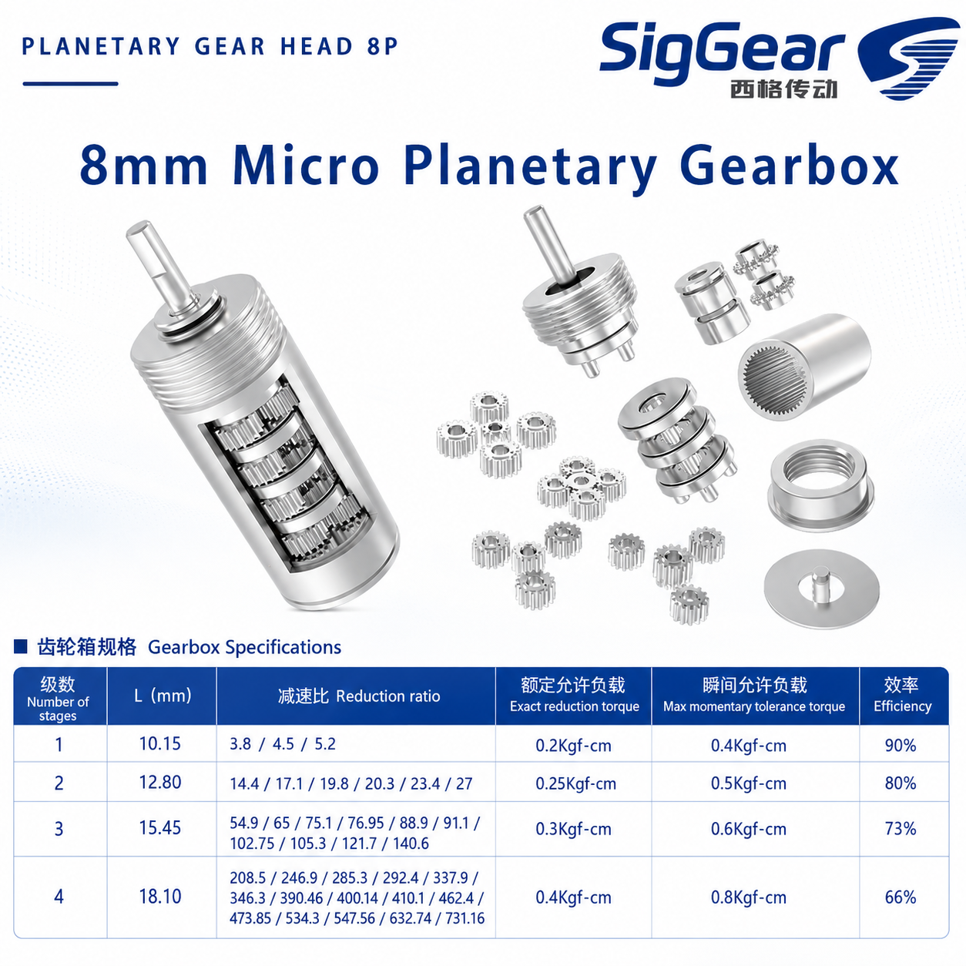
assets/images/planetary-gearbox/6-42mm-series/08mm-planetary-gearbox-04-structure.jpg.png
