SigGearDrive/SigGear-product-docs/assets/images/planetary-gearbox/6-42mm-series/12mm-planetary-gearbox-05-detail.jpg.png

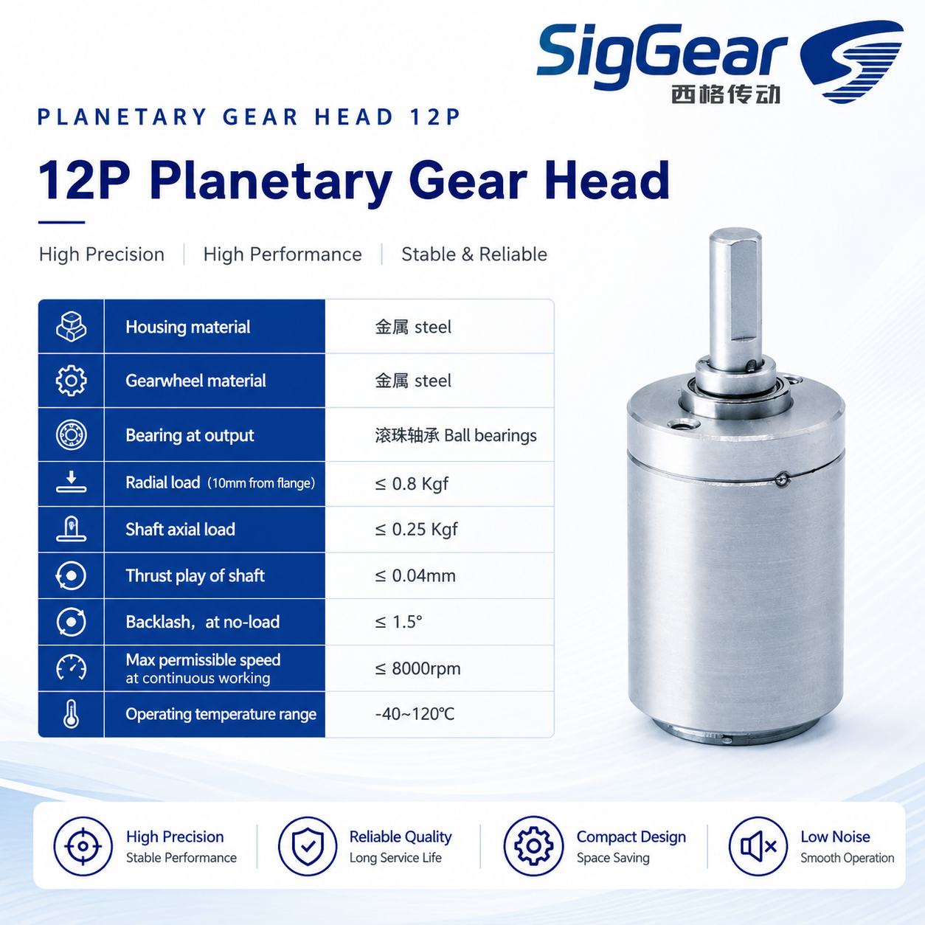
assets/images/planetary-gearbox/6-42mm-series/12mm-planetary-gearbox-05-detail.jpg.png
