SigGearDrive/SigGear-product-docs/assets/images/planetary-gearbox/6-42mm-series/14mm-planetary-gearbox-03-specifications.jpg.png

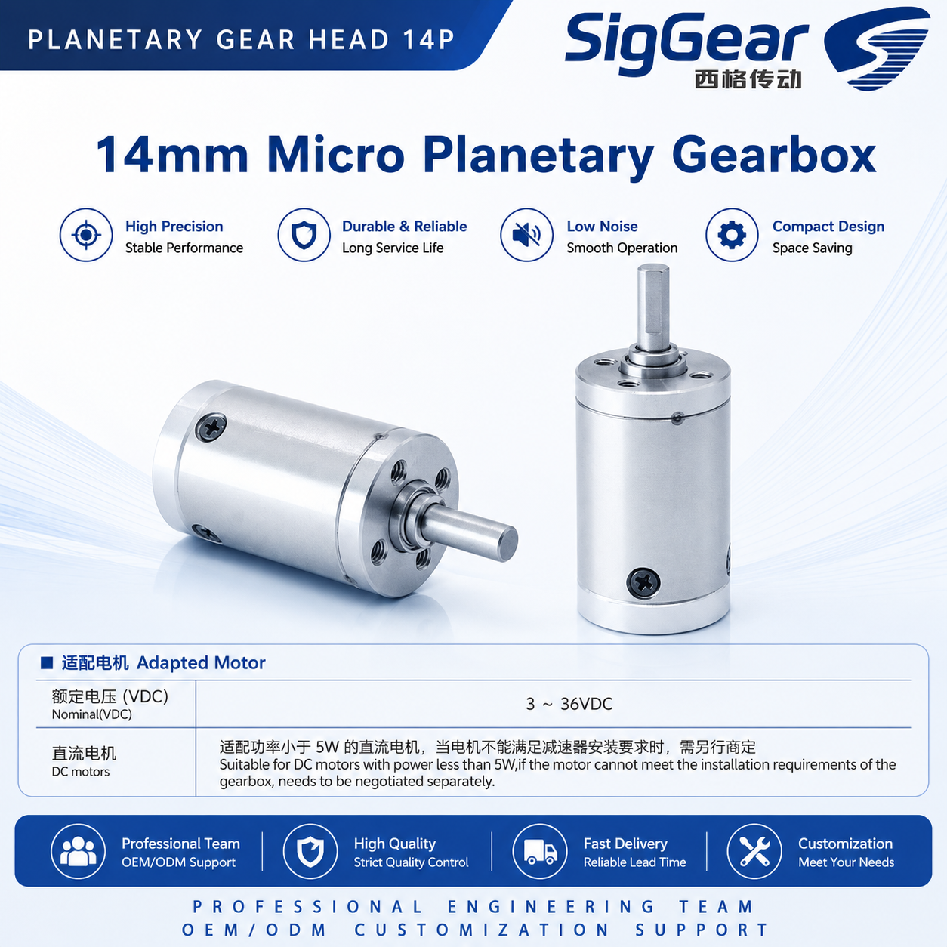
assets/images/planetary-gearbox/6-42mm-series/14mm-planetary-gearbox-03-specifications.jpg.png
