SigGearDrive/SigGear-product-docs/assets/images/planetary-gearbox/6-42mm-series/16mm-planetary-gearbox-02-dimensions.jpg.png

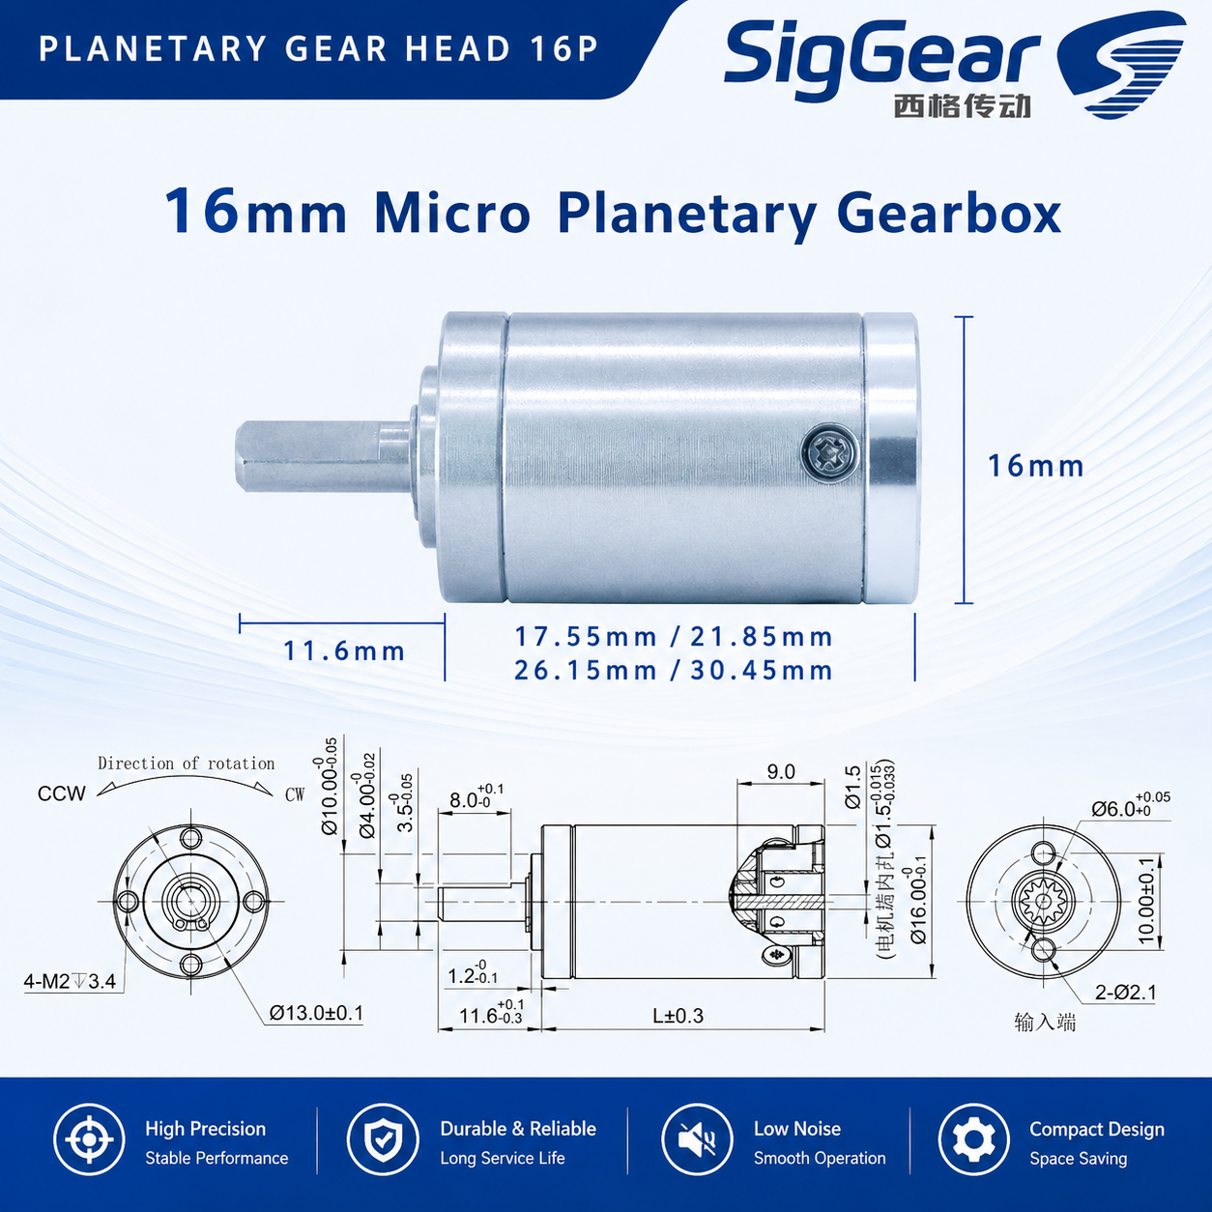
assets/images/planetary-gearbox/6-42mm-series/16mm-planetary-gearbox-02-dimensions.jpg.png
