SigGearDrive/SigGear-product-docs/assets/images/planetary-gearbox/6-42mm-series/20mm-planetary-gearbox-03-specifications.jpg.png

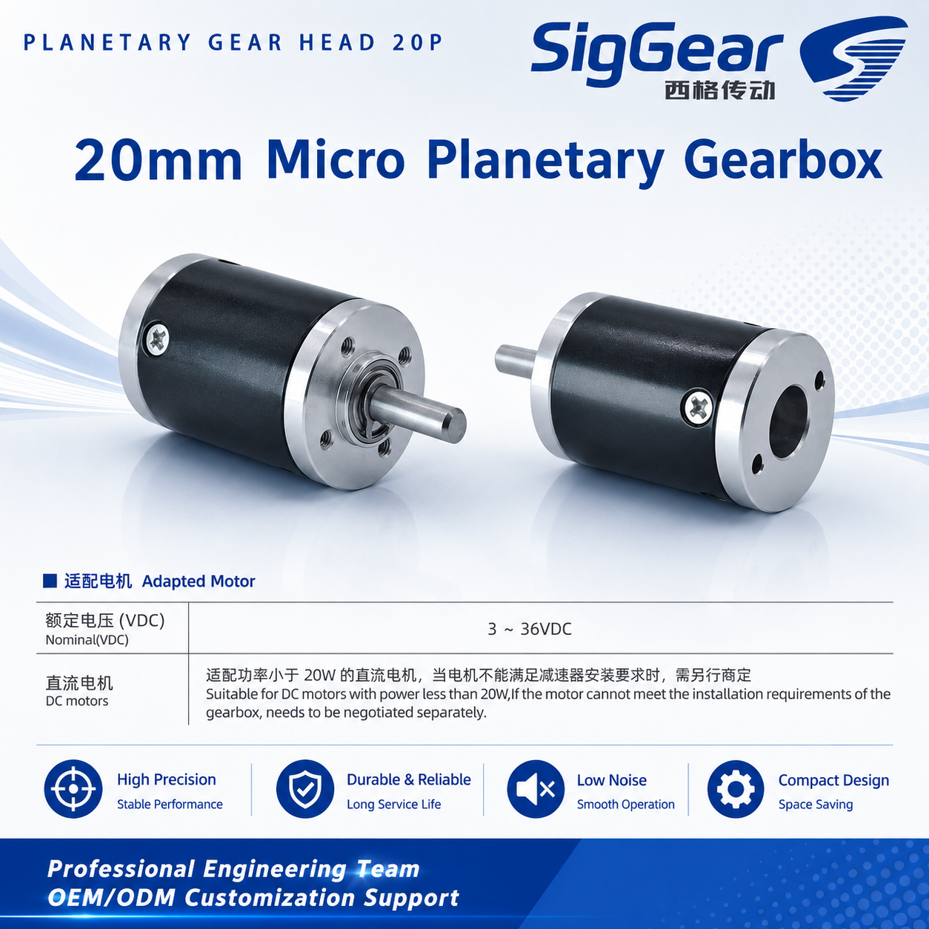
assets/images/planetary-gearbox/6-42mm-series/20mm-planetary-gearbox-03-specifications.jpg.png
