SigGearDrive/SigGear-product-docs/assets/images/planetary-gearbox/6-42mm-series/20mm-planetary-gearbox-05-detail.jpg.png

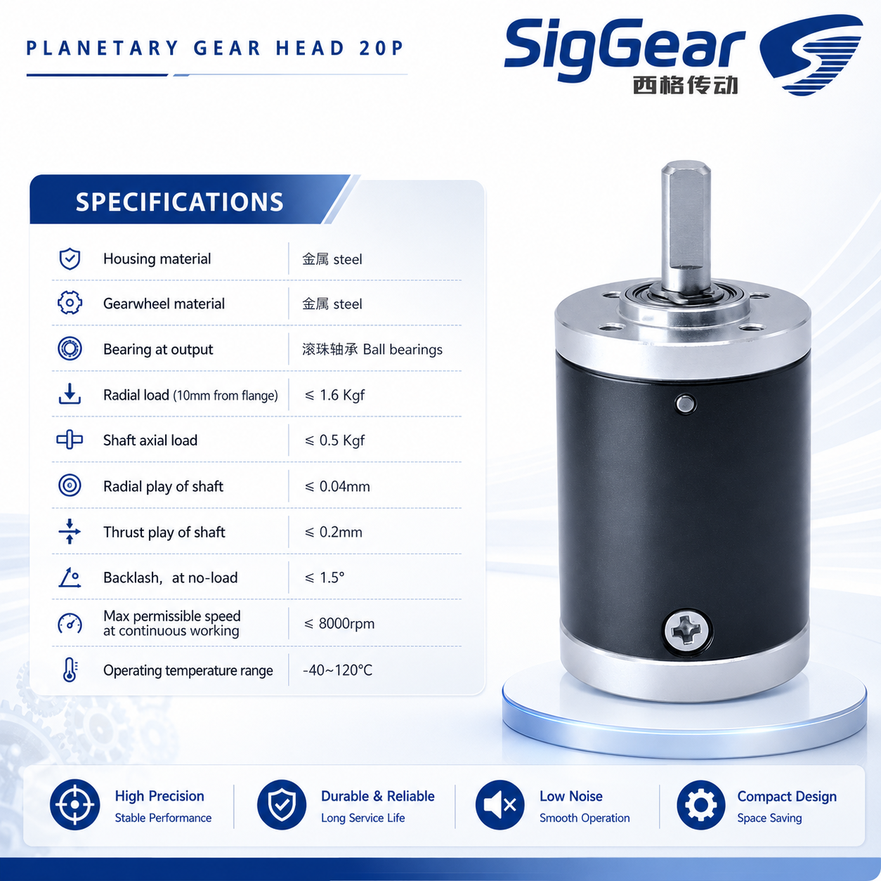
assets/images/planetary-gearbox/6-42mm-series/20mm-planetary-gearbox-05-detail.jpg.png
