SigGearDrive/SigGear-product-docs/docs/assets/images/products/planetary-gearboxes/32p/32p-real-product-main.webp

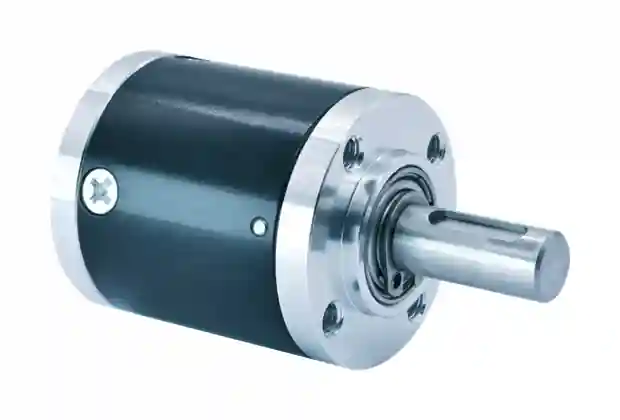
docs/assets/images/products/planetary-gearboxes/32p/32p-real-product-main.webp
