SigGearDrive/SigGear-product-docs/docs/assets/downloads/10p/10P_Public_Simplified_STEP_v1.0_4-Stage.step

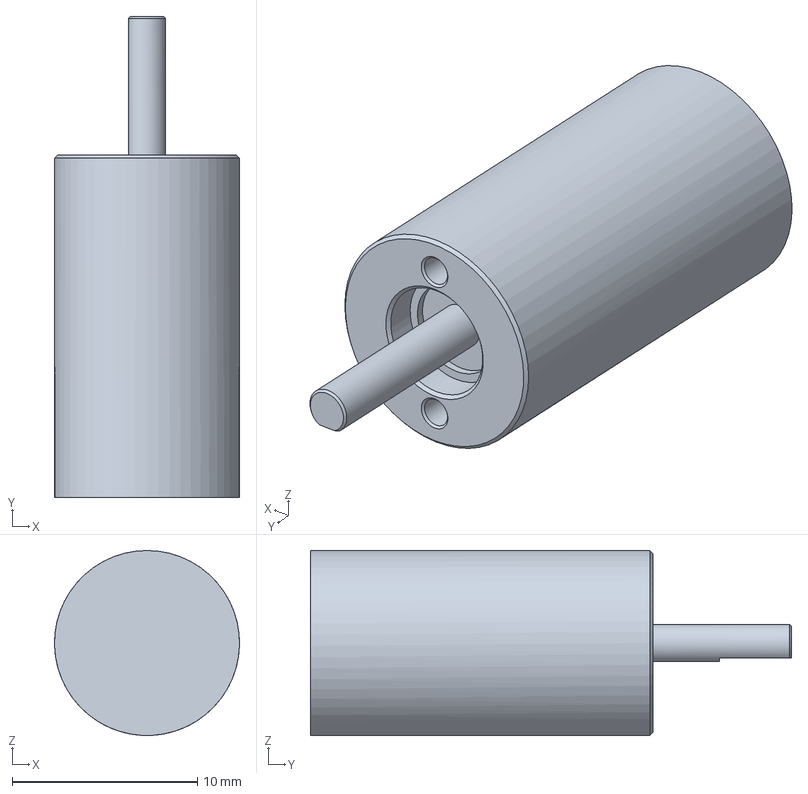
[picture p47: CAD file, 2026-10-08]
docs/assets/downloads/10p/10P_Public_Simplified_STEP_v1.0_4-Stage.step
10.0 x 26.0 x 10.0 mm
