SigGearDrive/SigGear-product-docs/docs/assets/downloads/12p/12P_Public_Simplified_STEP_v1.0_4-Stage.step

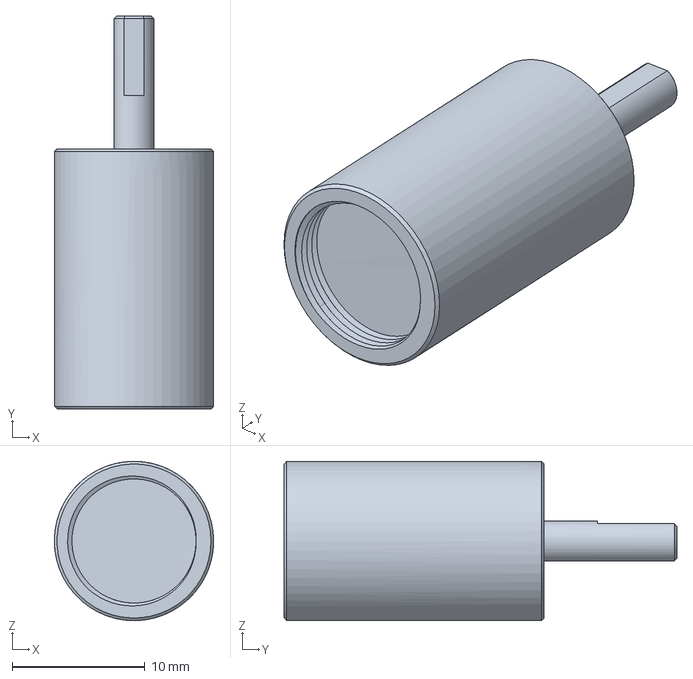
[picture p48: CAD file, 2026-10-08]
docs/assets/downloads/12p/12P_Public_Simplified_STEP_v1.0_4-Stage.step
12.0 x 29.6 x 12.0 mm
