SigGearDrive/SigGear-product-docs/docs/assets/downloads/14p/14P_Public_Simplified_STEP_v1.0_4-Stage.step

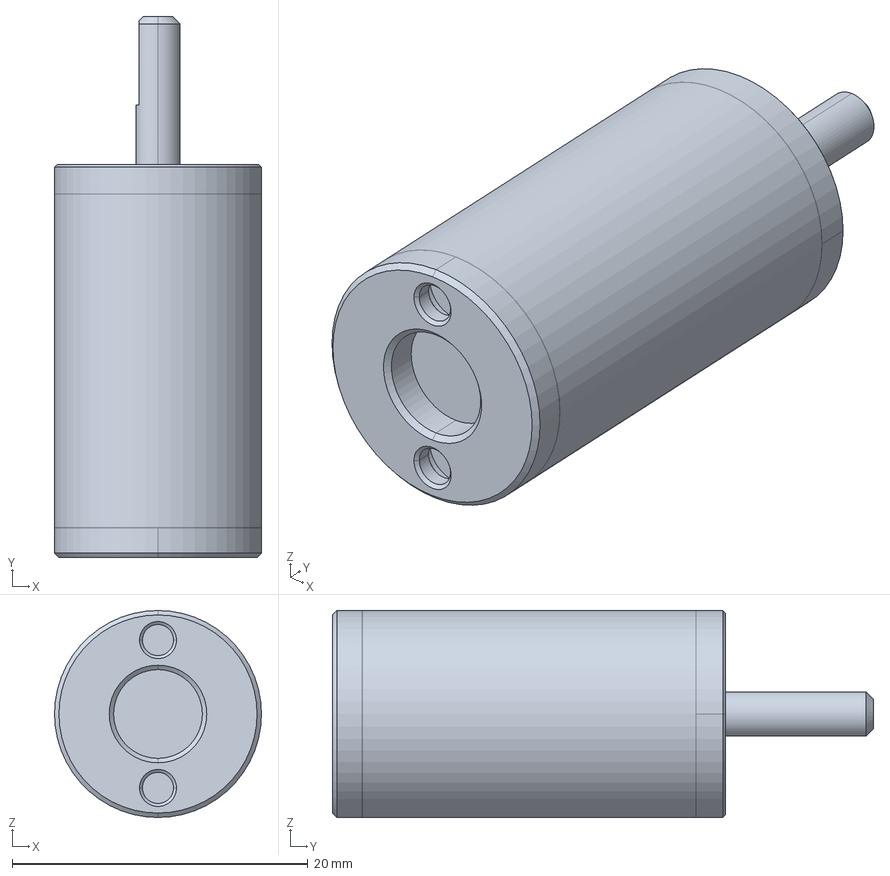
[picture p49: CAD file, 2026-10-08]
docs/assets/downloads/14p/14P_Public_Simplified_STEP_v1.0_4-Stage.step
14.0 x 36.6 x 14.0 mm
