SigGearDrive/SigGear-product-docs/docs/assets/downloads/16p/16P_Public_Simplified_STEP_v1.0_4-Stage.step

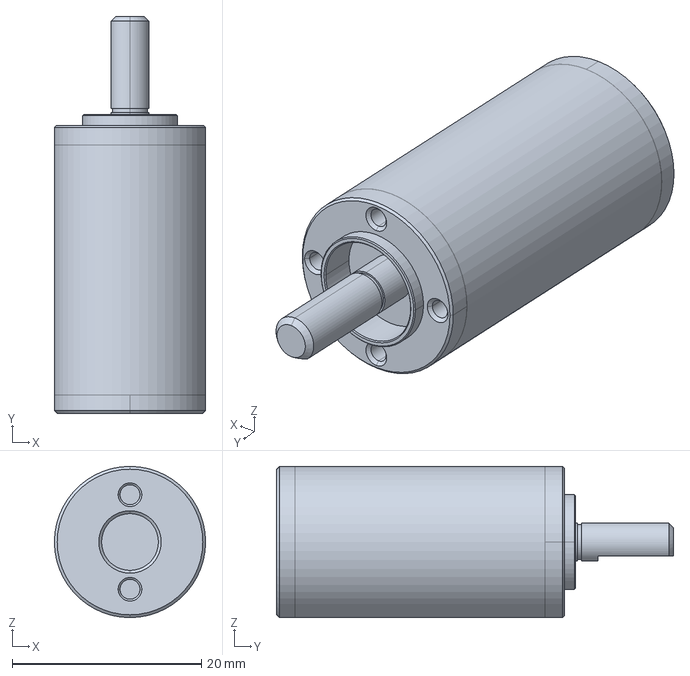
[picture p50: CAD file, 2026-10-08]
docs/assets/downloads/16p/16P_Public_Simplified_STEP_v1.0_4-Stage.step
16.0 x 42.0 x 16.0 mm
