SigGearDrive/SigGear-product-docs/docs/assets/downloads/20p/20P_Public_Simplified_STEP_v1.0_4-Stage.step

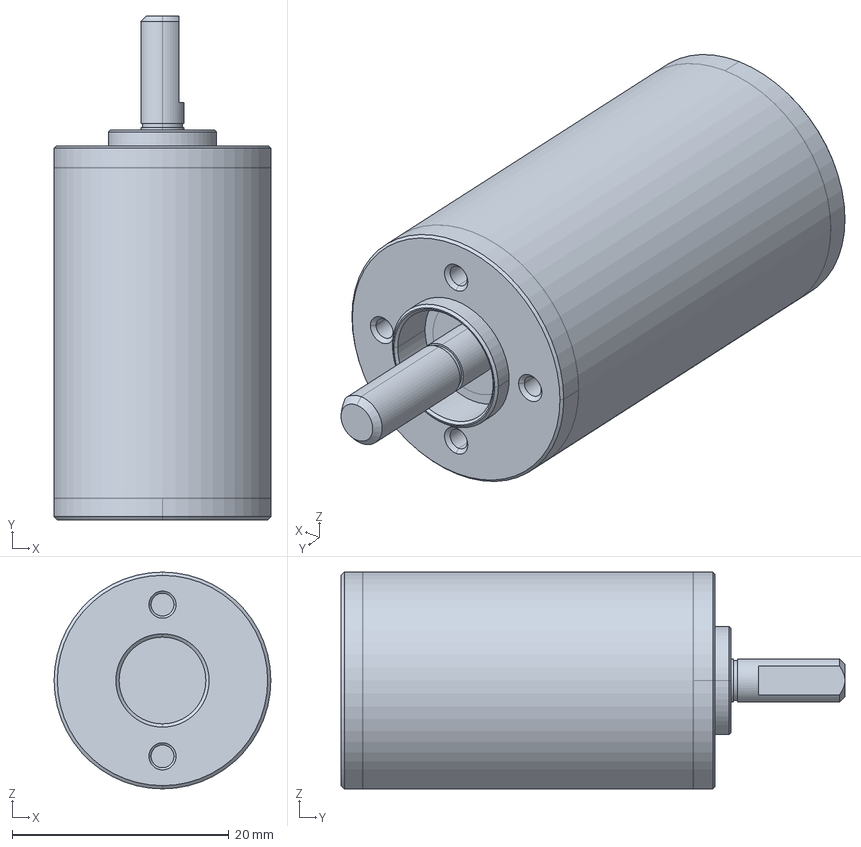
[picture p51: CAD file, 2026-10-08]
docs/assets/downloads/20p/20P_Public_Simplified_STEP_v1.0_4-Stage.step
20.0 x 46.5 x 20.0 mm
