SigGearDrive/SigGear-product-docs/docs/assets/downloads/22p/22P_Public_Simplified_STEP_v1.0_4-Stage.step

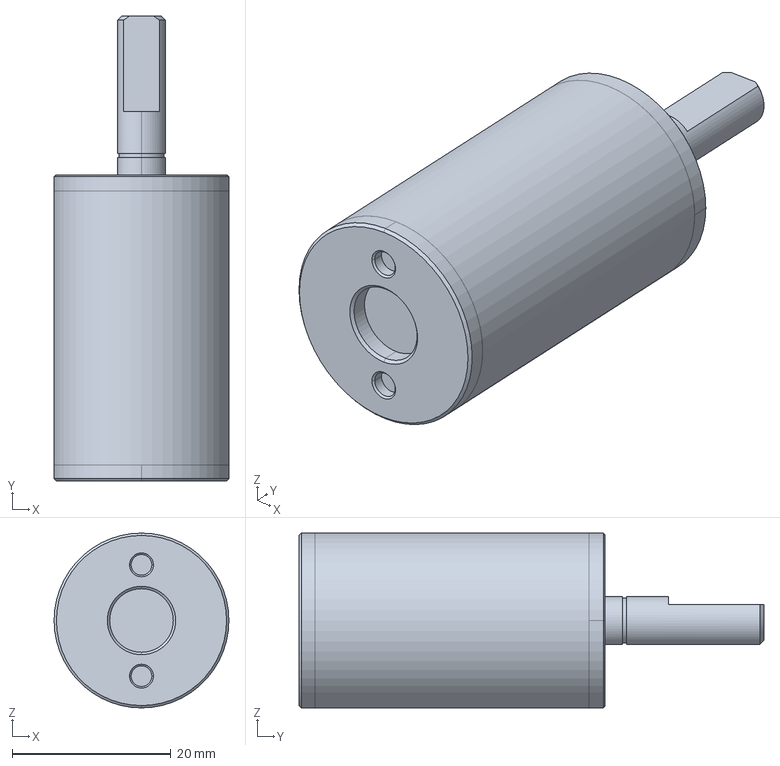
[picture p52: CAD file, 2026-10-08]
docs/assets/downloads/22p/22P_Public_Simplified_STEP_v1.0_4-Stage.step
22.0 x 58.5 x 22.0 mm
