SigGearDrive/SigGear-product-docs/docs/assets/downloads/24p/24P_Public_Simplified_STEP_v1.0_4-Stage.step

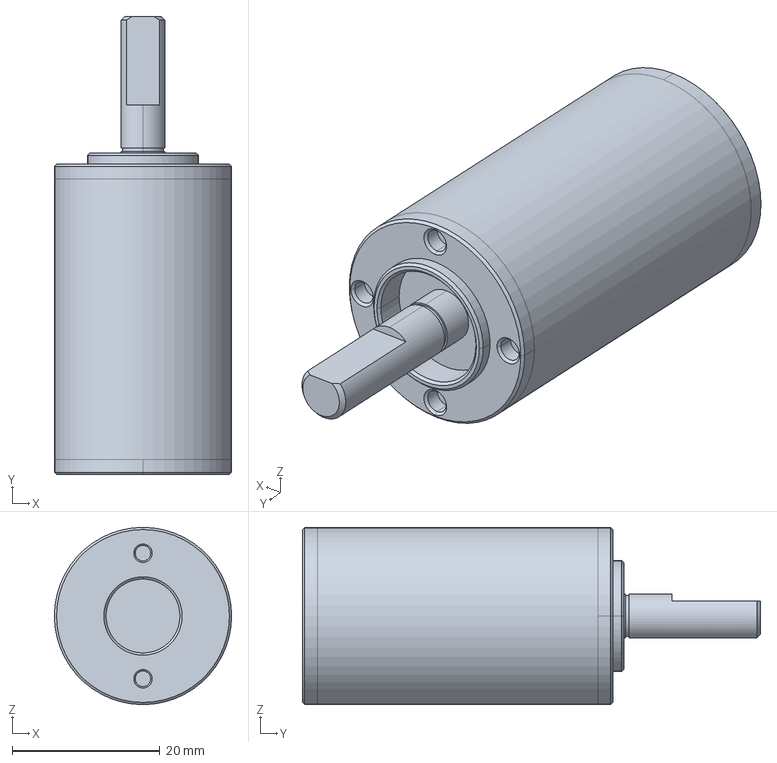
[picture p53: CAD file, 2026-10-08]
docs/assets/downloads/24p/24P_Public_Simplified_STEP_v1.0_4-Stage.step
24.0 x 62.0 x 24.0 mm
