SigGearDrive/SigGear-product-docs/docs/assets/downloads/28p/28P_Public_Simplified_STEP_v1.0_4-Stage.step

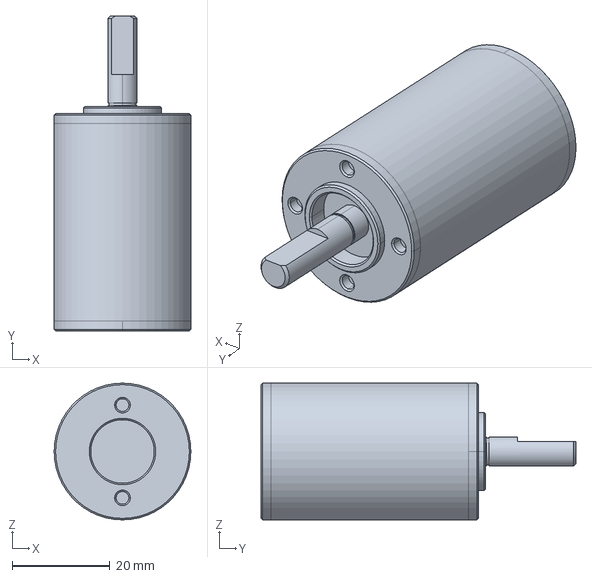
[picture p54: CAD file, 2026-10-08]
docs/assets/downloads/28p/28P_Public_Simplified_STEP_v1.0_4-Stage.step
28.0 x 64.5 x 28.0 mm
