SigGearDrive/SigGear-product-docs/docs/assets/downloads/32p/32P_Public_Simplified_STEP_v1.0_4-Stage.step

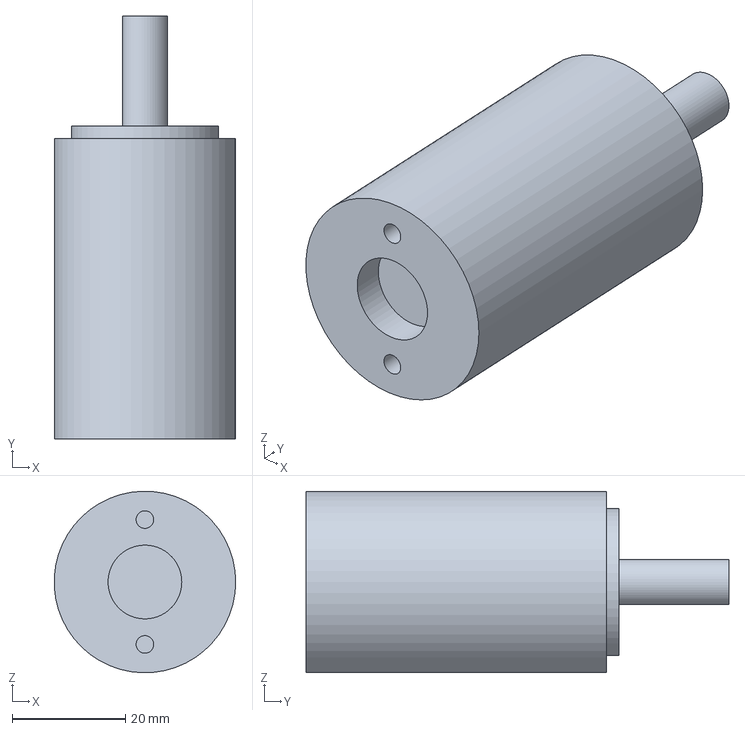
[picture p55: CAD file, 2026-09-28]
docs/assets/downloads/32p/32P_Public_Simplified_STEP_v1.0_4-Stage.step
32.0 x 74.6 x 32.0 mm
