SigGearDrive/SigGear-product-docs/docs/assets/downloads/36p/36P_Public_Simplified_STEP_v1.0_4-Stage.step

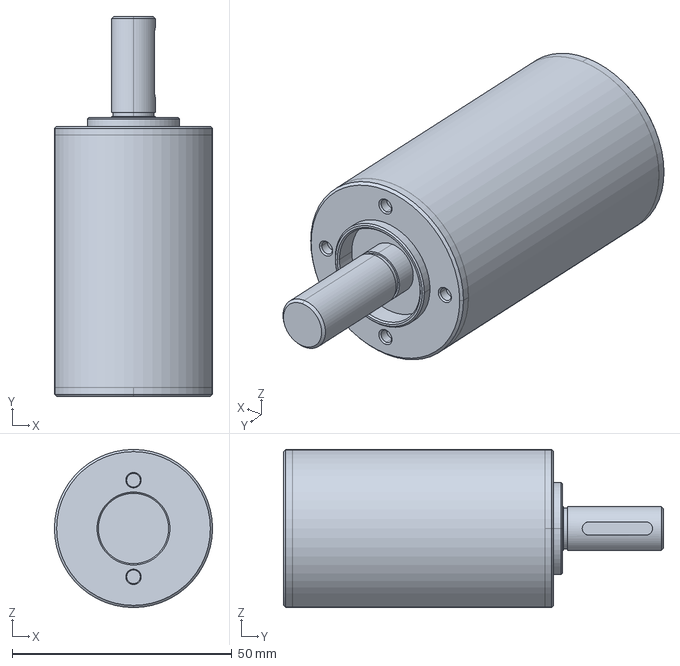
[picture p56: CAD file, 2026-10-08]
docs/assets/downloads/36p/36P_Public_Simplified_STEP_v1.0_4-Stage.step
36.0 x 86.5 x 36.0 mm
