SigGearDrive/SigGear-product-docs/docs/assets/downloads/42p/42P_Public_Simplified_STEP_v1.0_4-Stage.step

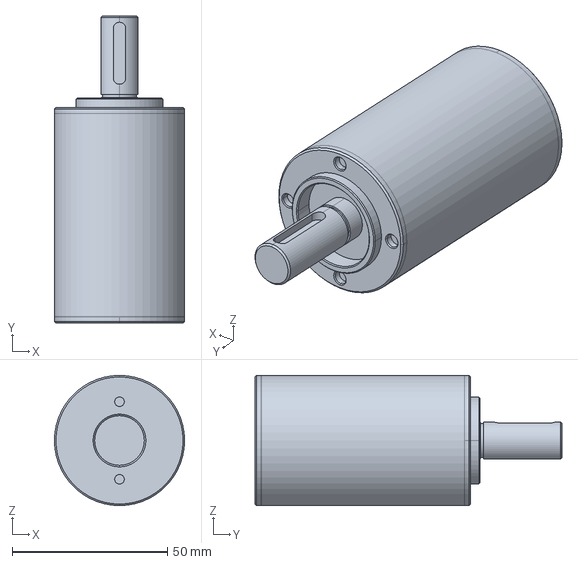
[picture p57: CAD file, 2026-10-08]
docs/assets/downloads/42p/42P_Public_Simplified_STEP_v1.0_4-Stage.step
42.0 x 99.0 x 42.0 mm
