SigGearDrive/SigGear-product-docs/docs/assets/downloads/8p/8P_Public_Simplified_STEP_v1.0_4-Stage.step

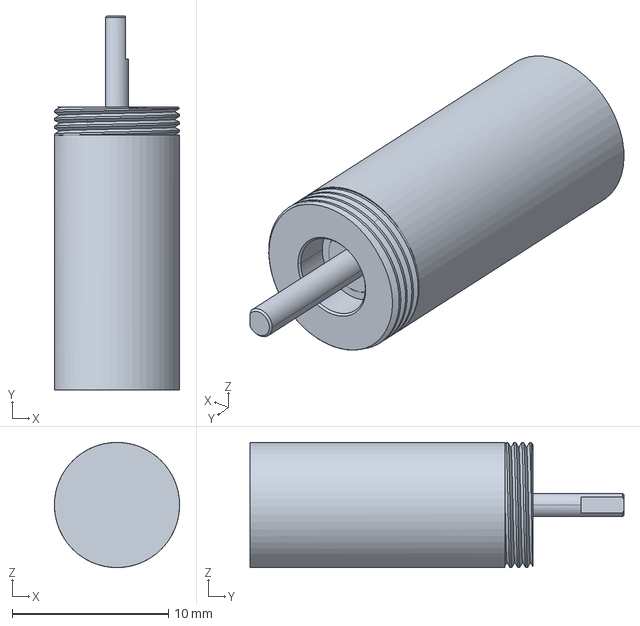
[picture p58: CAD file, 2026-10-08]
docs/assets/downloads/8p/8P_Public_Simplified_STEP_v1.0_4-Stage.step
8.00 x 23.9 x 8.00 mm
