SigGearDrive/SigGear-product-docs/docs/assets/downloads/cpm80-25/CPM-80-25_Public_Simplified_STEP_v1.0_No_Driver.step

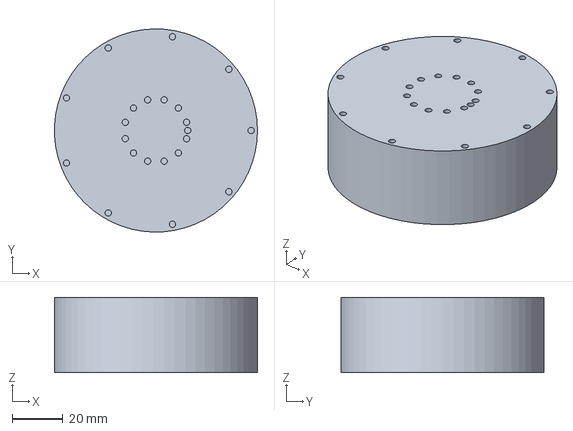
[picture p59: CAD file, 2026-09-28]
docs/assets/downloads/cpm80-25/CPM-80-25_Public_Simplified_STEP_v1.0_No_Driver.step
79.9 x 80.0 x 29.7 mm
