SigGearDrive/SigGear-product-docs/docs/assets/downloads/sg6010c/SG-6010C_Public_Simplified_STEP_v1.0.step

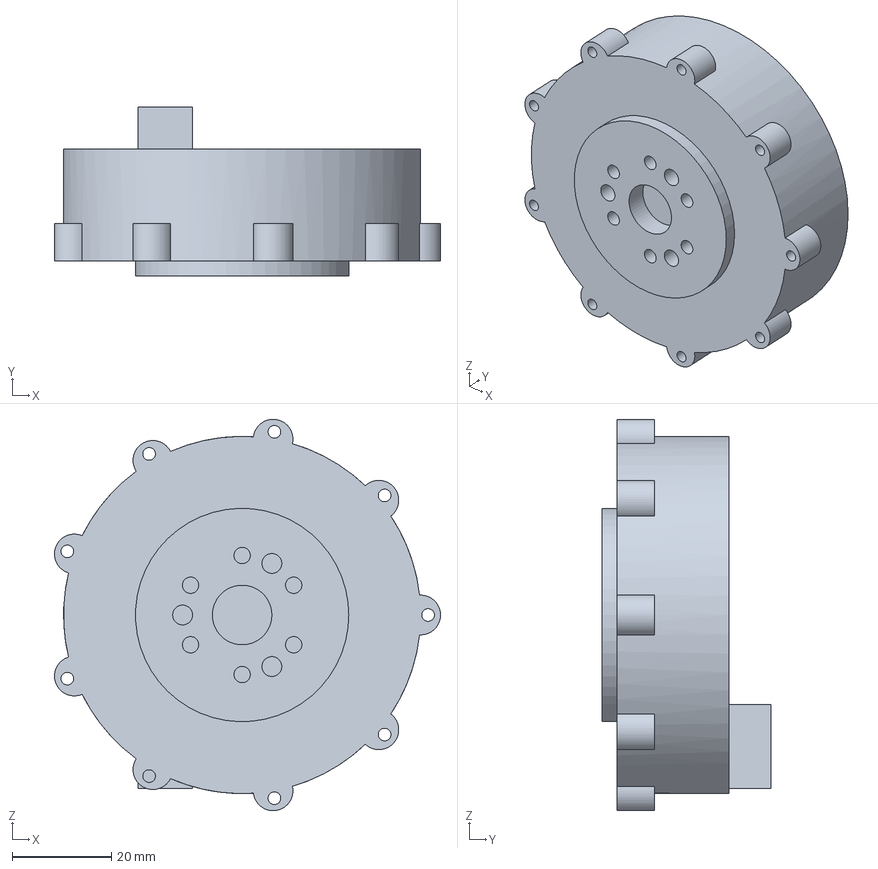
[picture p60: CAD file, 2026-09-28]
docs/assets/downloads/sg6010c/SG-6010C_Public_Simplified_STEP_v1.0.step
77.8 x 34.1 x 78.9 mm
