SigGearDrive/SigGear-product-docs/docs/assets/downloads/cpm80-25/CPM-80-25_Public_Simplified_STEP_v1.0_Integrated_Driver.step

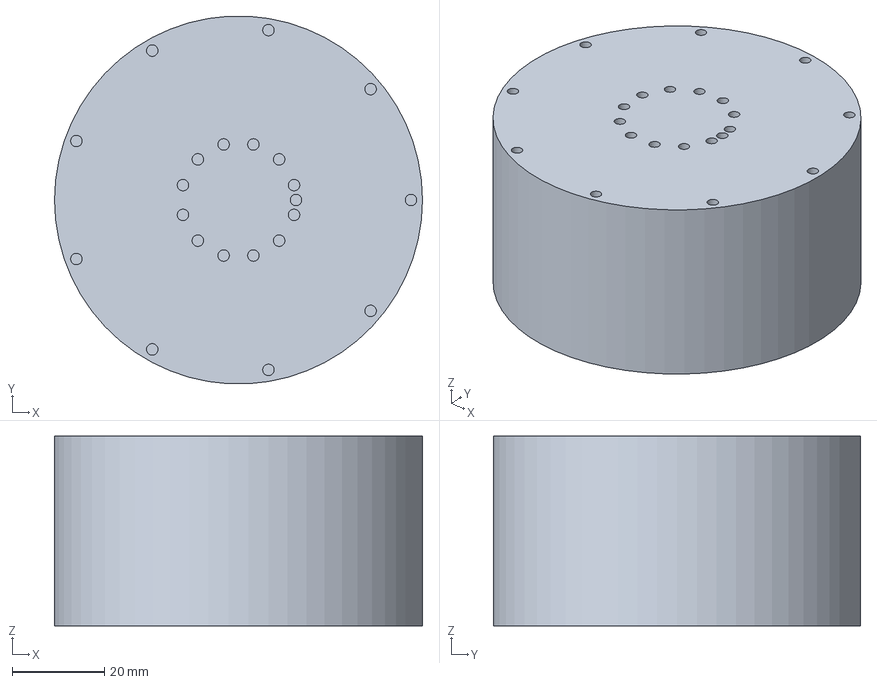
[picture p61: CAD file, 2026-09-28]
docs/assets/downloads/cpm80-25/CPM-80-25_Public_Simplified_STEP_v1.0_Integrated_Driver.step
80.0 x 79.9 x 41.2 mm
