SigGearDrive/SigGear-product-docs/data/operations/README.md

# SigGear five-channel acquisition operations

This directory holds **evidence-based operating reports**, not new marketing pages. It integrates the existing sales/attribution tracking policies instead of creating a separate conversion definition.

- [Most recent completed-week five-channel report (prepared 2026-10-14)](five-channel-weekly-report-2026-10-14.md)
- [Reusable five-channel reporting template](five-channel-weekly-report-template.md)
- [Existing weekly attribution review policy](../sales/weekly-attribution-review-sop.yml)
- [Existing qualified-acquisition evidence definitions](../sales/attribution-kpi-schema.yml)
- [Current multi-platform publication readiness](../external-catalogs/distribution-readiness.yml)

The report's five channels are **GitHub, Google Search, TraceParts, YouTube and DirectIndustry**. Keep the customer acquisition source supported by actual evidence, not inferred from a CAD click or a video view.

**As of 2026-10-14:** DirectIndustry's submitted exhibitor enquiry is waiting for a consultant; the TraceParts Publisher title/UTM request is waiting for platform support. Neither is recorded as a newly published paid catalog.

This dashboard is for a **standard complete Monday–Sunday platform performance week**. The formal management meeting recap may follow the user's different historical-reporting cutoff rule. Never overwrite earlier snapshots when GSC/GA4 revises recent data.
