SigGearDrive/SigGear-product-docs/Selection-Guides/planetary-gearbox-selection-guide.md

---

title: Planetary Gearbox Selection Guide
description: Learn how to select a planetary gearbox or planetary gear reducer for servo motors, DC motors, brushless motors, robotics, medical devices, grippers, automation, and compact motion systems.
----------------------------------------------------------------------------------------------------------------------------------------------------------------------------------------------------------

# Planetary Gearbox Selection Guide

Selecting the right planetary gearbox is important for compact motion systems that require speed reduction, torque increase, stable transmission, and reliable motor integration.

SigGear provides miniature and compact planetary gear reducers from 6mm to 42mm for micro robotics, robotic grippers, medical devices, laboratory automation, optical equipment, servo motors, stepper motors, brushless motors, DC motors, compact actuators, and industrial automation systems.

This guide helps engineers understand how to choose a suitable planetary gearbox based on size, torque, speed, gear ratio, backlash, motor type, shaft design, mounting interface, noise, duty cycle, and customization requirements.

## What Is a Planetary Gearbox?

A planetary gearbox is a compact gear reducer that uses a sun gear, planet gears, and ring gear to reduce motor speed and increase output torque.

Planetary gearboxes are widely used because they offer:

* Compact structure
* Stable torque transmission
* Flexible gear ratio options
* Good torque density
* Motor integration flexibility
* Wide size range
* Suitable structure for automation and robotics
* Custom shaft and mounting options

For compact products, a planetary gearbox helps engineers reduce speed, increase torque, and fit the drive system into limited installation space.

## Common Applications of Planetary Gearboxes

Planetary gearboxes can be used in many compact motion systems.

| Application | Typical Requirement |
| --- | --- |
| Servo motor drive modules  | Torque increase, speed reduction, low backlash |
| Stepper motor systems | Stable low-speed motion and compact integration |
| Brushless motor assemblies | Efficient compact drive and long service life |
| DC motor gearboxes | Simple control and compact mechanical output |
| Robotic grippers | Small size, gripping force, low-speed control |
| Micro robotics | Miniature size, low weight, stable torque |
| Medical devices | Low noise, compact structure, repeated motion |
| Laboratory automation | Smooth motion, repeatability, reliability |
| Optical equipment | Fine adjustment, low vibration, low backlash |
| Smart hardware | Small size, low noise, easy integration |
| AGV / AMR mechanisms | Reliable torque and long working life |
| Industrial automation | Compact torque transmission and durable operation |

## Why Planetary Gearbox Selection Matters

A planetary gearbox affects the entire motion system. If the gearbox is not selected correctly, the final product may have insufficient torque, unstable motion, excessive backlash, overheating, noise, short lifetime, or difficult mechanical integration.

A suitable planetary gearbox helps improve:

* Output torque
* Output speed control
* Low-speed stability
* Motor efficiency
* Positioning repeatability
* Compact product design
* Load capacity
* Service life
* Noise performance
* Prototype development speed

## Key Selection Parameters

When selecting a planetary gearbox, engineers should evaluate the complete motor, gearbox, and load system.

| Parameter | What to Confirm |
| --- | --- |
| Gearbox size | Outer diameter, length, shaft size, and mounting space |
| Output torque | Continuous torque, peak torque, and safety margin |
| Output speed | Required mechanism speed under actual load |
| Gear ratio | Balance torque, speed, efficiency, and control response |
| Backlash | Important for positioning accuracy and repeatability |
| Motor type | DC motor, brushless motor, stepper motor, servo motor, or custom motor |
| Input speed | Motor speed and maximum continuous gearbox input speed |
| Output shaft | Shaft diameter, length, flat, D-shaft, thread, gear, spline, or custom design |
| Mounting interface | Flange, screw holes, housing, bracket, or custom installation |
| Load direction | Radial load, axial load, and possible side load |
| Noise | Important for medical, laboratory, indoor, and service robot applications |
| Duty cycle | Working time, start-stop frequency, holding time, and load profile |
| Lifetime | Load, speed, temperature, lubrication, and operating environment |
| Customization | Ratio, shaft, flange, motor matching, encoder, brake, wire, connector |

## Step-by-Step Planetary Gearbox Selection Process

### Step 1: Define the Application

Start with the actual application.

Useful questions:

* Is it used with a servo motor?
* Is it used with a DC motor?
* Is it used with a brushless motor?
* Is it used with a stepper motor?
* Is it for a robotic gripper?
* Is it for a medical device?
* Is it for a micro robot?
* Is it for automation equipment?
* Is it for prototype testing or mass production?

Different applications may require different gearbox sizes, ratios, backlash levels, shaft designs, and noise requirements.

## Step 2: Confirm Installation Space

Planetary gearbox selection often starts with mechanical space.

Confirm:

* Maximum outer diameter
* Maximum gearbox length
* Total motor gearbox assembly length
* Output shaft length
* Output shaft diameter
* Mounting hole position
* Flange size
* Cable or wire outlet space
* Encoder or brake space
* Allowed weight

SigGear supports 6-42mm miniature and compact planetary gear reducers for different installation spaces.

## Step 3: Confirm Required Output Torque

Output torque determines whether the gearbox can drive the mechanism reliably.

Engineers should confirm:

* Continuous output torque
* Peak output torque
* Starting torque
* Holding torque
* Safety factor
* Friction load
* Load changes during operation
* Shock load or impact load
* Duty cycle

For robotic grippers, output torque affects gripping force.
For medical pumps and valves, output torque affects reliable actuation.
For servo motor systems, output torque affects load handling and motion stability.

## Step 4: Confirm Required Output Speed

The gearbox reduces motor speed to the required output speed.

Confirm:

* Required output speed
* Motor rated speed
* Motor maximum speed
* Motion cycle time
* Start-stop frequency
* Acceleration and deceleration requirements
* Low-speed smoothness requirement

A higher gear ratio usually provides higher output torque but lower output speed.

## Step 5: Choose the Gear Ratio

Gear ratio selection affects torque, speed, efficiency, noise, and control response.

| Gear Ratio Choice | Typical Result |
| --- | --- |
| Lower ratio | Higher output speed, lower torque multiplication |
| Medium ratio | Balanced speed, torque, and efficiency |
| Higher ratio | Higher output torque and lower output speed |
| Very high ratio | More torque but possibly lower efficiency and slower response |

The best gear ratio depends on motor speed, required output speed, required torque, efficiency, backlash, and duty cycle.

## Step 6: Check Backlash Requirement

Backlash is important for positioning and repeatability.

| Application | Backlash Sensitivity |
| --- | --- |
| Servo motor positioning system | High |
| Robotic gripper | Medium to high |
| Medical device mechanism | Medium to high |
| Optical adjustment system | High |
| Laboratory automation | Medium to high |
| Smart hardware | Medium |
| Pump or valve | Low to medium |
| Simple automation mechanism | Low to medium |

Lower backlash is usually better for precision motion, but the final requirement depends on the control method, mechanical structure, cost target, and product application.

## Step 7: Match the Motor Type

Planetary gearboxes can be matched with different motor types.

| Motor Type | Typical Use |
| --- | --- |
| DC motor | Smart hardware, pumps, valves, small mechanisms |
| Brushless motor | Medical devices, lab automation, long-life compact systems |
| Stepper motor | Positioning systems, instruments, automation modules |
| Servo motor | Robotics, automation, precision motion systems |
| Custom motor | Application-specific compact drive solution |

Motor matching should consider input shaft size, motor speed, flange size, mounting holes, motor power, control method, encoder, brake, and total assembly size.

## Step 8: Check Shaft and Mounting Design

The output shaft and mounting interface directly affect mechanical integration.

Common output shaft options include:

* Round shaft
* D-shaft
* Flat shaft
* Threaded shaft
* Gear shaft
* Spline shaft
* Custom shaft diameter
* Custom shaft length
* Custom output gear

Common mounting options include:

* Screw hole mounting
* Flange mounting
* Bracket mounting
* Housing integration
* Custom mounting interface

A custom shaft or custom mounting interface can reduce additional adapters and simplify final product assembly.

## Step 9: Evaluate Noise, Heat, and Lifetime

Noise, heat, and lifetime are especially important in compact products.

Check:

* Gearbox noise under load
* Motor noise
* Vibration
* Heat generation
* Continuous working time
* Repeated start-stop cycles
* Load profile
* Operating temperature
* Lubrication condition
* Required lifetime
* Working environment

Prototype testing is recommended because compact mechanisms are sensitive to friction, alignment, load variation, and assembly tolerance.

## SigGear 6-42mm Planetary Gearbox Size Selection

SigGear provides miniature and compact planetary gear reducers from 6mm to 42mm.

| Diameter Range | Typical Use |
| --- | --- |
| 6-10mm | Ultra-compact devices, micro robotics, small instruments, miniature mechanisms  |
| 12-16mm | Robotic grippers, medical devices, lab automation, optical systems |
| 20-24mm | Compact actuators, servo modules, automation systems, stronger small mechanisms |
| 28-42mm | Higher torque compact automation, robotic mechanisms, industrial equipment |

The final selection depends on installation space, output torque, output speed, gear ratio, backlash, motor type, noise requirement, duty cycle, and lifetime requirement.

## Planetary Gearbox Selection Examples

### Example 1: Micro Robot Drive

For a micro robot, engineers usually need a very small gearbox with low weight and stable torque output.

Recommended evaluation points:

* 6-10mm gearbox size
* Compact DC motor or brushless motor matching
* Custom output shaft
* Low noise
* Low current consumption
* Lightweight structure

### Example 2: Robotic Gripper

For a robotic gripper, the gearbox must support gripping force and repeated opening and closing cycles.

Recommended evaluation points:

* 6-24mm gearbox size depending on gripper size
* Torque and gripping force calculation
* Gear ratio selection for speed and force balance
* Backlash and repeatability
* Custom shaft or gear output
* Duty cycle and lifetime

### Example 3: Medical Device Mechanism

For medical devices, low noise, compact size, and reliable repeated motion are important.

Recommended evaluation points:

* 6-24mm gearbox size
* Low-noise design
* Stable low-speed motion
* Custom shaft and mounting interface
* Brushless or DC motor matching
* Lifetime and duty cycle testing

### Example 4: Servo Motor Automation Module

For servo motor systems, the gearbox must support torque increase and accurate motion control.

Recommended evaluation points:

* 20-42mm gearbox size depending on torque
* Low backlash
* Motor input interface matching
* Output shaft or flange design
* Continuous torque and peak torque
* Acceleration and deceleration conditions

## Common Selection Mistakes

Avoid these common mistakes during planetary gearbox selection:

| Mistake | Possible Result |
| --- | --- |
| Selecting only by outer diameter | Torque, shaft, speed, or lifetime may not match the application |
| Ignoring peak torque | Gearbox may fail under acceleration, impact, or overload |
| Choosing too high a gear ratio | Output speed may be too slow and efficiency may decrease |
| Ignoring backlash | Positioning accuracy and repeatability may be poor |
| Ignoring duty cycle | Heat and wear may reduce service life |
| Ignoring shaft design | Mechanical integration may require extra adapters |
| Ignoring noise requirement | Product may be unsuitable for medical, lab, or indoor use |
| Skipping prototype testing | Real load friction and assembly tolerance may cause performance issues |

## Recommended SigGear Resources

Useful product and application pages:

* [6-42mm Planetary Gear Reducer](../Applications/6-42mm-planetary-gear-reducer.md)
* [Servo Motor Planetary Gearbox](../Applications/servo-motor-planetary-gearbox.md)
* [6mm Micro Gear Motor for Micro Robotics](../Applications/micro-robotics-gear-motor.md)
* [Micro Gear Motor for Medical Devices](../Applications/medical-device-micro-gear-motor.md)
* [Robot Gripper Gear Motor](../Applications/robot-gripper-gear-motor.md)
* [AGV / AMR Wheel Drive Gearbox](../Applications/agv-amr-wheel-drive-gearbox.md)
* [Robot Arm Joint Gearbox](../Applications/robot-arm-joint-gearbox.md)

Related products:

* [SG6010C Compact Precision Drive Solution](../SG6010C.md)
* [SG8021 Precision Drive Solution](../SG8021.md)
* [CPM80-25 Compact Cycloidal Robotic Joint Module](../CPM80-25.md)
* [CPM100-25 Compact Cycloidal Robotic Joint Module](../CPM100-25.md)

Related selection guides:

* [Robot Joint Gearbox Selection Guide](robot-joint-gearbox-selection-guide.md)
* [Micro Gear Motor Selection Guide](micro-gear-motor-selection-guide.md)

## Information Needed for Planetary Gearbox Recommendation

To help SigGear recommend a suitable planetary gearbox, please provide:

| Information | Example |
| --- | --- |
| Application | Servo motor module, gripper, medical device, pump, valve, micro robot |
| Motor type | DC motor, brushless motor, stepper motor, servo motor |
| Motor speed | Rated speed and maximum speed |
| Required output speed  | Target rpm or motion time |
| Required output torque | Continuous torque and peak torque |
| Gear ratio | Known target ratio or motor speed and output speed |
| Size limit | Maximum diameter and length |
| Backlash requirement | Standard or low-backlash requirement |
| Output shaft design | Round shaft, D-shaft, thread, gear, spline, or custom shaft |
| Mounting method | Flange, screw holes, bracket, housing, or custom interface |
| Noise requirement | Standard or low-noise requirement |
| Duty cycle | Working time, repeated cycles, start-stop frequency |
| Lifetime requirement | Target lifetime or test condition |
| Quantity plan | Prototype, small batch, or mass production |

## FAQ

### What is a planetary gearbox used for?

A planetary gearbox is used to reduce motor speed and increase output torque. It is commonly used in robotics, automation, medical devices, laboratory equipment, optical systems, smart hardware, pumps, valves, grippers, and compact actuators.

### How do I choose a planetary gearbox?

Start by confirming application, installation space, motor type, motor speed, required output speed, required output torque, gear ratio, backlash, shaft design, mounting method, duty cycle, noise requirement, lifetime, and expected quantity.

### What gear ratio should I choose for a planetary gearbox?

The gear ratio depends on motor speed, required output speed, and required output torque. A higher ratio increases torque and reduces speed, while a lower ratio provides higher output speed with less torque multiplication.

### Can a planetary gearbox be used with a servo motor?

Yes. Planetary gearboxes can be used with servo motors to reduce speed, increase torque, and improve motion control in robotics, automation, and compact precision systems.

### Can a planetary gearbox be used with a DC motor or brushless motor?

Yes. Planetary gearboxes can be matched with DC motors, brushless motors, stepper motors, servo motors, or custom motor assemblies depending on application requirements.

### What planetary gearbox sizes can SigGear provide?

SigGear can support miniature and compact planetary gear reducer solutions from 6mm to 42mm, including 6P, 8P, 10P, 12P, 14P, 16P, 20P, 22P, 24P, 28P, 32P, 36P, and 42P options.

### Can SigGear customize planetary gearboxes?

Yes. SigGear can support custom gear ratio, output shaft, input interface, mounting flange, housing design, motor matching, encoder option, brake option, wire length, connector, and application-specific drive solutions.

## Request Planetary Gearbox Selection Support

If you are developing servo motor systems, DC motor gearboxes, brushless motor drive modules, robotic grippers, medical devices, laboratory automation systems, optical equipment, pumps, valves, smart hardware, compact actuators, or precision automation equipment, contact SigGear for planetary gearbox selection support.

Please include your application, motor type, motor speed, required output torque, required output speed, gear ratio, size limit, backlash requirement, shaft design, mounting method, noise requirement, duty cycle, lifetime requirement, and expected quantity.

**Email:** [wangwanrong984@gmail.com](mailto:wangwanrong984@gmail.com)
**Application:** Servo motor / DC motor / brushless motor / robotic gripper / medical device / lab automation / compact actuator
**Response:** SigGear can help recommend a suitable 6-42mm planetary gear reducer or customized compact drive solution based on your application requirements.
