SigGearDrive/SigGear-product-docs/docs/knowledge-base/sales-usage-and-technical-review-status.md

# SigGear Sales Usage and Technical Review Status

This page defines how the current public product data may be used in customer communication. It helps sales staff, distributors and AI assistants avoid wrong parameters, unsupported compatibility claims and overpromising.

## Current Review State

All current product records have a complete inventory of the claims on their canonical public pages. The records are suitable for public product summaries and preliminary selection within the boundaries below.

## Product Review Matrix

| Product | Permitted use | Must confirm before quotation or final selection |
| --- | --- | --- |
| [SG-6010HB](../products/robot-joint-actuators/sg6010hb.md) | Preliminary selection and public summary | Peak duration, duty cycle, driver, encoder, communication, brake / power-off behavior, mounting interface and thermal conditions |
| [16P](../products/planetary-gearboxes/16p-planetary-gearbox.md) | Preliminary selection and public summary | Exact ratio, stage count, motor matching, duty cycle, shaft, mounting, noise and service life |
| [20P](../products/planetary-gearboxes/20p-planetary-gearbox.md) | Preliminary selection and public summary | Exact ratio, stage count, motor matching, duty cycle, shaft, mounting, noise and service life |
| [22P](../products/planetary-gearboxes/22p-planetary-gearbox.md) | Preliminary selection and public summary | Exact ratio, stage count, motor matching, duty cycle, shaft, mounting, noise and service life |
| [24P](../products/planetary-gearboxes/24p-planetary-gearbox.md) | Preliminary selection and public summary | Exact ratio, stage count, motor matching, duty cycle, shaft, mounting, noise and service life |
| [28P](../products/planetary-gearboxes/28p-planetary-gearbox.md) | Preliminary selection and public summary | Exact ratio, stage count, motor matching, duty cycle, shaft, mounting, noise and service life |
| [32P](../products/planetary-gearboxes/32p-planetary-gearbox.md) | Preliminary selection and public summary | Exact ratio, stage count, motor matching, duty cycle, shaft, mounting, noise and service life |
| [36P](../products/planetary-gearboxes/36p-planetary-gearbox.md) | Preliminary selection and public summary | Exact ratio, stage count, motor matching, duty cycle, shaft, mounting, noise and service life |
| [42P](../products/planetary-gearboxes/42p-planetary-gearbox.md) | Preliminary selection and public summary | Exact ratio, stage count, motor matching, duty cycle, shaft, mounting, noise and service life |
| [8–42 mm planetary series](../products/planetary-gearboxes/8-42mm-planetary-gear-reducer.md) | Product-family introduction and size shortlisting | Diameter, ratio, stage count, torque, speed, shaft, backlash, noise, life and interfaces |

## Prohibited Sales Shortcuts

Never:

- Treat peak torque as continuous torque.
- Present optional electronics as standard without confirmation.
- Transfer specifications between different planetary gearbox sizes.
- Use a public product page as a substitute for quotation approval or controlled drawings.
