SigGearDrive/SigGear-product-docs/docs/engineering-resources/cpm80-25/performance-test-data.md

---
title: CPM-80-25 Measured Performance Data | 24V 36V 48V Dynamometer Results | SigGear
description: Representative measured CPM-80-25 dynamometer points at 24V, 36V and 48V for engineering evaluation.
---

# CPM-80-25 Measured Performance Data

**Status:** Public engineering reference  
**Source:** SigGear CPM-80-25 catalogue dynamometer data

The data below contains representative measured points from CPM-80-25 dynamometer testing at 24 V, 36 V and 48 V. These are test observations, not guaranteed continuous operating points.

Actual results depend on controller settings, current limit, thermal state, duty cycle, assembly configuration and test setup.

## Test Conditions

| Test | Ambient temperature |
| --- | ---: |
| 24 V data set | 28.4 C |
| 36 V data set | 28.8 C |
| 48 V data set | 28.5 C |

## Representative 24 V Points

| Speed (rpm) | Torque (Nm) | Output power (W) | Voltage (V) | Current (A) | Input power (W) | Efficiency |
| ---: | ---: | ---: | ---: | ---: | ---: | ---: |
| 127.49 | 0.0000 | 0.000 | 24.013 | 0.0000 | 0.000 | 0.00% |
| 112.99 | 1.9027 | 22.511 | 24.011 | 1.3995 | 33.598 | 67.00% |
| 58.241 | 29.385 | 179.21 | 24.002 | 20.852 | 500.56 | 35.80% |
| 0.0000 | 58.622 | 0.000 | 23.993 | 41.547 | 997.32 | 0.00% |

## Representative 36 V Points

| Speed (rpm) | Torque (Nm) | Output power (W) | Voltage (V) | Current (A) | Input power (W) | Efficiency |
| ---: | ---: | ---: | ---: | ---: | ---: | ---: |
| 191.98 | 0.0000 | 0.000 | 36.014 | 0.0000 | 0.000 | 0.00% |
| 167.51 | 2.8982 | 50.835 | 36.009 | 2.2257 | 80.133 | 63.44% |
| 87.701 | 32.946 | 302.55 | 35.991 | 24.354 | 876.73 | 34.51% |
| 0.0000 | 65.965 | 0.000 | 35.971 | 48.671 | 1752.1 | 0.00% |

## Representative 48 V Points

| Speed (rpm) | Torque (Nm) | Output power (W) | Voltage (V) | Current (A) | Input power (W) | Efficiency |
| ---: | ---: | ---: | ---: | ---: | ---: | ---: |
| 174.66 | 0.0000 | 0.000 | 47.980 | 0.0000 | 0.000 | 0.00% |
| 156.39 | 1.9679 | 32.227 | 47.973 | 0.9662 | 46.352 | 69.53% |
| 80.590 | 31.982 | 269.89 | 47.946 | 15.201 | 728.99 | 37.02% |
| 0.0000 | 63.892 | 0.000 | 47.917 | 30.336 | 1454.7 | 0.00% |

## Interpretation

Do not use stall points as continuous operating ratings. The public rated output torque remains **10 Nm** and peak output torque remains **50 Nm** for preliminary product selection. Confirm the required torque-speed cycle and peak duration for the actual project.

[CPM-80-25 Technical Datasheet](datasheet.md){ .md-button }
[Request Engineering Review](../../request-cad-sample-quote.md){ .md-button }
