SigGearDrive/SigGear-product-docs/docs/assets/images/evidence/testing/siggear-testing-inspection-equipment-real.webp

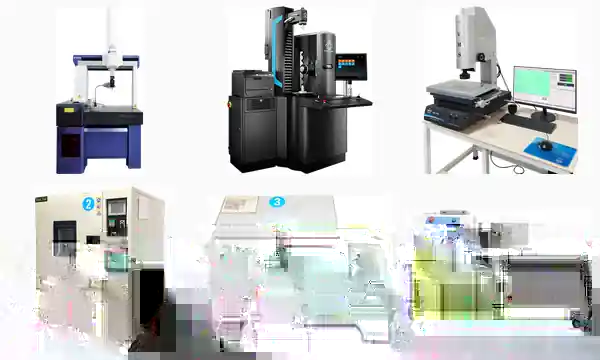
docs/assets/images/evidence/testing/siggear-testing-inspection-equipment-real.webp
