SigGearDrive/SigGear-product-docs/data/external-catalogs/platforms/traceparts-live-validation-2026-10-14.yml

schema_version: 1
checked_on: "2026-10-14"
program: siggear_traceparts_8p_42p_live_validation
latest_user_report:
  date: "2026-10-14"
  international_domain: traceparts.com/en
  tested_cad_format: STEP_AP203
  reported_success_models: [8P, 10P, 12P, 14P, 16P, 20P, 22P, 24P, 28P, 32P, 36P, 42P]
  reported_failed_models: []
  result: operator_confirmed_all_12_STEP_downloads_generated_successfully
  first_attempt_note: user_reported_clicking_before_generation_finished_for_8P_and_42P
  retry_result: 8P_and_42P_both_successful
  root_cause_platform_file_error: not_established
  independent_file_geometry_validation: not_performed
  report_source: SigGear_operator_direct_browser_testing
  english_model_detail_urls_received_from_operator: 12
  model_url_registry: data/external-catalogs/platforms/traceparts-model-urls-2026-10-14.yml
  assistant_link_fetch: not_independently_verified_due_to_interactive_TraceParts_browser
user_test_2026_10_14:
  source: first_party_siggear_operator_confirmation_and_uploaded_browser_screenshot
  testing_site: https://www.traceparts.com/en
  user_reported_downloads_success: 12
  user_reported_downloads_failed: 0
  successful_models: [8P, 10P, 12P, 14P, 16P, 20P, 22P, 24P, 28P, 32P, 36P, 42P]
  initially_incomplete_before_wait_and_retry: [8P, 42P]
  format_visible_in_42p_initial_screenshot: 3D_XML
  final_format_selected: STEP_AP203
  verification_limit: confirms_operator_download_success_not_independent_open_or_geometry_check
  chinese_portal: user_previously_reported_all_12_downloads_worked
public_evidence:
  international_supplier_index:
    page: https://www.traceparts.com/en/search/traceparts-classification-mechanical-components-power-transmission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
    observed_label: SIGGEAR
    observed_supplier_count: 12
    confidence_scope: supplier_filter_count_only_not_model_level_or_download_proof
  chinese_catalog:
    page: https://www.traceparts.cn/zh/search/siggear?CatalogPath=GUANGDONG_1991627740%3AF_SIGGEAR
    previously_observed_product_families: 12
    direct_product_urls_verified: false
    user_reports_chinese_cad_downloads_all_12: true
  interaction_limit:
    reason: TraceParts product details and CAD downloads require interactive browser actions; current search/read access cannot independently complete the CAD workflow
    not_equivalent_to: successful_step_download
validation_definition:
  product_url_verified: open_the_actual_model_detail_url_not_a_catalog_search_result
  preview_verified: load_the_model_preview_and_check_model_diameter_and_geometry
  step_download_verified: select_STEP_download_open_the_file_and_check_correspondence_to_the_selected_model
  english_verified: independently_load_the_English_product_detail_page
  configuration_guard: published_public_CAD_is_simplified_4_stage_reference_not_all_stage_or_ratio_specific_production_geometry
models:
  - model: 8P
    traceparts_en_product_url: "https://www.traceparts.com/en/product/siggear-8p-8-mm-miniature-planetary-gearbox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"
    traceparts_zh_product_url: null
    english_product_detail: user_reported_accessible
    chinese_product_detail: user_reported_accessible
    three_d_preview_this_round: not_separately_tested_by_assistant
    step_download_this_round: user_reported_success_after_generation_completed
    failure_cause_confirmed: not_applicable_after_successful_retry
    test_source: user_browser_test_2026_10_14
    historical_chinese_preview_download: user_reports_success_2026_10_14
  - model: 10P
    traceparts_en_product_url: "https://www.traceparts.com/en/product/siggear-10p-10-mm-miniature-planetary-gearbox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"
    traceparts_zh_product_url: null
    english_product_detail: user_reported_accessible
    chinese_product_detail: user_reported_accessible
    three_d_preview_this_round: not_separately_tested_by_assistant
    step_download_this_round: user_reported_success
    failure_cause_confirmed: not_applicable
    test_source: user_browser_test_2026_10_14
    historical_chinese_preview_download: user_reports_success_2026_10_14
  - model: 12P
    traceparts_en_product_url: "https://www.traceparts.com/en/product/siggear-12p-12-mm-miniature-planetary-gearbox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"
    traceparts_zh_product_url: null
    english_product_detail: user_reported_accessible
    chinese_product_detail: user_reported_accessible
    three_d_preview_this_round: not_separately_tested_by_assistant
    step_download_this_round: user_reported_success
    failure_cause_confirmed: not_applicable
    test_source: user_browser_test_2026_10_14
    historical_chinese_preview_download: user_reports_success_2026_10_14
  - model: 14P
    traceparts_en_product_url: "https://www.traceparts.com/en/product/siggear-14p-14-mm-miniature-planetary-gearbox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"
    traceparts_zh_product_url: null
    english_product_detail: user_reported_accessible
    chinese_product_detail: user_reported_accessible
    three_d_preview_this_round: not_separately_tested_by_assistant
    step_download_this_round: user_reported_success
    failure_cause_confirmed: not_applicable
    test_source: user_browser_test_2026_10_14
    historical_chinese_preview_download: user_reports_success_2026_10_14
  - model: 16P
    traceparts_en_product_url: "https://www.traceparts.com/en/product/siggear-16p-16-mm-miniature-planetary-gearbox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"
    traceparts_zh_product_url: null
    english_product_detail: user_reported_accessible
    chinese_product_detail: user_reported_accessible
    three_d_preview_this_round: not_separately_tested_by_assistant
    step_download_this_round: user_reported_success
    failure_cause_confirmed: not_applicable
    test_source: user_browser_test_2026_10_14
    historical_chinese_preview_download: user_reports_success_2026_10_14
  - model: 20P
    traceparts_en_product_url: "https://www.traceparts.com/en/product/siggear-20p-20-mm-miniature-planetary-gearbox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"
    traceparts_zh_product_url: null
    english_product_detail: user_reported_accessible
    chinese_product_detail: user_reported_accessible
    three_d_preview_this_round: not_separately_tested_by_assistant
    step_download_this_round: user_reported_success
    failure_cause_confirmed: not_applicable
    test_source: user_browser_test_2026_10_14
    historical_chinese_preview_download: user_reports_success_2026_10_14
  - model: 22P
    traceparts_en_product_url: "https://www.traceparts.com/en/product/siggear-22p-22-mm-miniature-planetary-gearbox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"
    traceparts_zh_product_url: null
    english_product_detail: user_reported_accessible
    chinese_product_detail: user_reported_accessible
    three_d_preview_this_round: not_separately_tested_by_assistant
    step_download_this_round: user_reported_success
    failure_cause_confirmed: not_applicable
    test_source: user_browser_test_2026_10_14
    historical_chinese_preview_download: user_reports_success_2026_10_14
  - model: 24P
    traceparts_en_product_url: "https://www.traceparts.com/en/product/siggear-24p-24-mm-miniature-planetary-gearbox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"
    traceparts_zh_product_url: null
    english_product_detail: user_reported_accessible
    chinese_product_detail: user_reported_accessible
    three_d_preview_this_round: not_separately_tested_by_assistant
    step_download_this_round: user_reported_success
    failure_cause_confirmed: not_applicable
    test_source: user_browser_test_2026_10_14
    historical_chinese_preview_download: user_reports_success_2026_10_14
  - model: 28P
    traceparts_en_product_url: "https://www.traceparts.com/en/product/siggear-28p-28-mm-miniature-planetary-gearbox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"
    traceparts_zh_product_url: null
    english_product_detail: user_reported_accessible
    chinese_product_detail: user_reported_accessible
    three_d_preview_this_round: not_separately_tested_by_assistant
    step_download_this_round: user_reported_success
    failure_cause_confirmed: not_applicable
    test_source: user_browser_test_2026_10_14
    historical_chinese_preview_download: user_reports_success_2026_10_14
  - model: 32P
    traceparts_en_product_url: "https://www.traceparts.com/en/product/siggear-32p-32-mm-miniature-planetary-gearbox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"
    traceparts_zh_product_url: null
    english_product_detail: user_reported_accessible
    chinese_product_detail: user_reported_accessible
    three_d_preview_this_round: not_separately_tested_by_assistant
    step_download_this_round: user_reported_success
    failure_cause_confirmed: not_applicable
    test_source: user_browser_test_2026_10_14
    historical_chinese_preview_download: user_reports_success_2026_10_14
  - model: 36P
    traceparts_en_product_url: "https://www.traceparts.com/en/product/siggear-36p-36-mm-miniature-planetary-gearbox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"
    traceparts_zh_product_url: null
    english_product_detail: user_reported_accessible
    chinese_product_detail: user_reported_accessible
    three_d_preview_this_round: not_separately_tested_by_assistant
    step_download_this_round: user_reported_success
    failure_cause_confirmed: not_applicable
    test_source: user_browser_test_2026_10_14
    historical_chinese_preview_download: user_reports_success_2026_10_14
  - model: 42P
    traceparts_en_product_url: "https://www.traceparts.com/en/product/siggear-42p-42-mm-miniature-planetary-gearbox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"
    traceparts_zh_product_url: null
    english_product_detail: user_reported_accessible
    chinese_product_detail: user_reported_accessible
    three_d_preview_this_round: not_separately_tested_by_assistant
    step_download_this_round: user_reported_success_after_generation_completed
    failure_cause_confirmed: not_applicable_after_successful_retry
    test_source: user_browser_test_2026_10_14
    historical_chinese_preview_download: reported_verified_in_prior_work
next_actions:
  - check_all_12_model_level_GitHub_to_TraceParts_links_after_Pages_deploy
  - monitor_links_after_TraceParts_English_product_title_updates_to_ensure_Product_ID_routing_remains_stable
  - confirm_TraceParts_to_GitHub_product_document_links_use_referral_UTM_and_actually_render
  - optionally_open_saved_STEP_files_and_check_model_dimensions_and_4_stage_reference_correspondence
