SigGearDrive/SigGear-product-docs/(commit log)

2026-06-10 Create AGV AMR wheel drive gearbox application page
2026-06-10 Create micro robotics gear motor application page
2026-06-10 Add micro robotics gear motor page to navigation
2026-06-10 Create 6-42mm planetary gear reducer product page
2026-06-10 Update homepage with 6-42mm planetary gear reducer
2026-06-10 Create 6mm
2026-06-12 Create robot gripper gear motor application page
2026-07-28 Complete industrial automation servo planetary gearbox application page
2026-07-28 Add industrial automation servo planetary application index entry
2026-07-28 Add industrial automation servo planetary navigation entry
2026-07-28 Add industrial automation servo planetary gearbox application page
    Add the industrial automation servo planetary gearbox application page with servo motor and gearbox matching, pick-and-place, packaging machines, rotary indexing tables, conveyor adjustment axes, inspection equipment, torque, speed, ratio, inertia matching, backlash, load, duty-cycle and customization review. Also update Applications Index, MkDocs navigation and legacy servo motor planetary redirect.
2026-07-28 Add micro robotics gear motor application page
    Add a dedicated micro robotics gear motor application page covering small robot joints, miniature grippers, sensor positioning, compact mechanisms, torque-speed selection, packaging, backlash, noise, feedback, duty cycle and customization guidance. Also update Applications Index, MkDocs navigation and the legacy micro robotics redirect.
2026-07-28 Add pump valve fluid control gear motor application page
    Add a dedicated pump, valve and fluid-control gear motor application page covering miniature pump drives, valve actuators, dosing systems, syringe and plunger mechanisms, fluid-control selection factors, torque, speed, pressure, duty-cycle review, noise, feedback, environment and compliance boundaries. Also update Applications Index, MkDocs navigation and legacy redirect mapping.
2026-07-28 Add smart hardware gear motor application page
    Add a dedicated smart hardware gear motor application page covering smart locks, access-control mechanisms, smart cabinets, curtains, blinds, vending and dispensing mechanisms, camera and sensor adjustment, compact appliance motion, torque, speed, battery, noise, feedback, shaft-load and customization guidance. Also update Applications Index, MkDocs navigation and legacy redirect mapping.
2026-07-28 Add automotive vehicle small motion gear motor application page
    Add a dedicated automotive and vehicle small-motion gear motor application page covering door lock and latch mechanisms, seat and interior adjustment, HVAC flap movement, small pump and valve drives, sensor and camera positioning, specialty vehicle and mobility applications, torque, current, thermal, vibration, environment and validation boundaries. Also update Applications Index, MkDocs navigation and legacy redirect mapping.
2026-07-28 Add energy battery charging equipment actuator application page
    Add a dedicated energy, battery and charging equipment actuator application page covering charging port locks, connector latches, battery cabinet locks, battery swap and test fixture mechanisms, thermal-management dampers, small pump and valve drives, portable power device motion, voltage, current, environment, ingress, safety and validation boundaries. Also update Applications Index, MkDocs navigation and legacy redirect mapping.
2026-07-28 Add vending dispensing kiosk gear motor application page
    Add a dedicated vending, dispensing and kiosk gear motor application page covering vending machine mechanisms, dispensing systems, auger and product release mechanisms, coffee and beverage equipment, ticket/card handling, kiosk motion systems, torque, speed, load, jam, noise, feedback and customization guidance. Also update Applications Index, MkDocs navigation and legacy redirect mapping.
2026-07-28 Add packaging labeling conveyor gear motor application page
    Add a dedicated packaging, labeling and conveyor gear motor application page covering packaging machine axes, labeling and tape application mechanisms, small belt and roller conveyors, feeders, spacing and release mechanisms, rotary indexing, guide-rail adjustment, tensioning, cutter or sealer assistance, torque, speed, product load, intermittent duty, jam, feedback, shaft load and customization guidance. Also update Applications Index, MkDocs navigation and legacy redirect mapping.
2026-07-28 Add access control smart lock security gear motor application page
    Add a dedicated access control, smart lock and security gear motor application page covering smart locks, electronic latches, cabinet locks, parcel lockers, safebox and drawer lock mechanisms, turnstile and barrier sub-mechanisms, security camera or cover movement, access panels and service-door actuators, torque, locking force, battery current, power-off behavior, jam condition, feedback, shaft load and security validation boundaries. Also update Applications Index, MkDocs navigation and legacy redirect mapping.
2026-07-29 Add agriculture outdoor equipment gear motor application page
    Add a dedicated agriculture and outdoor equipment gear motor application page covering seed, feed and fertilizer metering, greenhouse and irrigation mechanisms, livestock feeding equipment, outdoor cabinets and covers, small conveyors, sensor and sprayer positioning, flaps, dampers, gates and valves, torque, speed, jam condition, dust, water, chemical exposure, low-voltage power, shaft load, duty cycle and field reliability boundaries. Also update Applications Index, MkDocs navigation and legacy redirect mapping.
2026-07-29 Add food beverage coffee equipment gear motor application page
    Add a dedicated food, beverage and coffee equipment gear motor application page covering coffee machine mechanisms, bean and powder metering, grinder adjustment, beverage valves and diverters, pump and dosing assistance, cup and lid handling, mixing, stirring, agitation mechanisms, service-door and cover mechanisms, food-contact boundary, moisture, cleaning exposure, torque, speed, jam condition, low noise, feedback, shaft load and customization requirements. Also update Applications Index, MkDocs navigation and legacy redirect mapping.
2026-07-29 Add laboratory automation diagnostic equipment gear motor application page
    Add a dedicated laboratory automation and diagnostic equipment gear motor application page covering sample handling, reagent dispensing, valve and fluid-control motion, carousel and indexing systems, tube positioning, optical module adjustment, sensor alignment, cap handling, mixing and stirring mechanisms, precision motion, low vibration, low noise, backlash, positioning, liquid and chemical exposure, validation boundaries, shaft load, feedback and control guidance. Also update Applications Index, MkDocs navigation and legacy redirect mapping.
2026-07-29 Add optical imaging camera module gear motor application page
    Add a dedicated optical, imaging and camera module gear motor application page covering lens focus adjustment, zoom lens movement, aperture, iris and shutter mechanisms, filter wheel and optical selector mechanisms, pan, tilt and gimbal axes, scanning and sensor positioning mechanisms, lens cover, privacy shutter and protective door movement, low backlash, low vibration, image stability, repeatability, optical alignment, noise control, shaft load, feedback and environmental review guidance. Also update Applications Index, MkDocs navigation and legacy redirect mapping.
2026-07-29 Add HVAC smart vent damper gear motor application page
    Add a dedicated HVAC, smart vent and damper gear motor application page covering smart vent opening and closing, duct damper and zone-control damper mechanisms, HVAC mixing door and air flap motion, louver and air-direction adjustment, thermal-management damper mechanisms, air purifier, humidifier and dehumidifier mechanisms, specialty vent and exhaust devices, holding torque, end-stop behavior, low noise, low current, temperature, humidity, condensation, dust, shaft geometry and building-system validation guidance. Also update Applications Index, MkDocs navigation and legacy redirect mapping.
2026-07-29 Add electric curtain blind window opener gear motor application page
    Add a dedicated electric curtain, blind and window opener gear motor application page covering electric curtain track drives, roller blind and shade drives, Venetian blind tilt mechanisms, smart blind battery systems, window opener and skylight actuators, sunshade and awning adjustment, vent cover and small building automation mechanisms, quiet motion, holding torque, low current, end-stop behavior, obstacle detection, manual override, shaft interface and indoor/outdoor environment guidance. Also update Applications Index, MkDocs navigation and legacy redirect mapping.
2026-07-29 Add office automation business equipment gear motor application page
    Add a dedicated office automation and business equipment application page and update application index, navigation, and redirect mapping.
2026-07-29 Add furniture seating adjustable mechanism gear motor application page
    Add furniture, seating and adjustable mechanism application guidance.
    Includes electric recliner and sofa adjustment, adjustable office chair mechanisms, height-adjustable desk mechanisms, smart bed and adjustable bed mechanisms, footrest, headrest and lumbar adjustment, drawer, cabinet and hidden panel motion, small lift, tilt and positioning mechanisms.
    Also updates Applications Index, MkDocs navigation and legacy redirect mapping.
2026-07-29 Add CAD sample quote landing page
    Add a dedicated CAD, sample and quotation landing page, connect it from the homepage and navigation, and remove the old redirect to the generic contact page.
2026-07-30 Add stage lighting display signage gear motor application page
    Add a dedicated stage lighting, display and signage gear motor application page.
    Includes moving-head stage lights, beam shutter, iris and filter adjustment, advertising display and signage rotation, digital signage angle adjustment, retail display fixtures, exhibition, museum and showcase motion, and outdoor signage mechanisms.
    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
2026-07-30 Optimize humanoid joint actuator SEO guides
    Optimize humanoid robot joint actuator and robot joint sizing guides for search intent, internal linking and inquiry conversion.
2026-07-30 Add consumer appliance home device gear motor application page
    Add a dedicated consumer appliance and home device gear motor application page.
    Includes pet feeders, smart trash cans, kitchen appliance small-motion mechanisms, home cleaning devices, personal care and wellness devices, smart home accessories, lid, cover, flap, locking and dispensing mechanisms.
    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
2026-07-30 Add semiconductor electronics inspection equipment gear motor application page
    Add semiconductor, electronics and inspection equipment gear motor application guidance and update application index/navigation.
2026-09-17 SEO: add page-specific metadata to core product pages
    * Add SEO metadata to product overview
    * Add SEO metadata to robot joint actuator overview
    * Add SEO metadata to cycloidal joint module overview
    * Add SEO metadata to planetary gearbox overview
    * Add SEO metadata to CPM-80-25 product page
2026-09-17 SEO: add metadata to core robot joint models
    * Add SEO metadata to SG-6010C
    * Add SEO metadata to SG-6010D
    * Add SEO metadata to SG-8021
    * Add SEO metadata to CPM-78-39
    * Add SEO metadata to CPM-100-25
2026-09-17 SEO: add metadata to 8P–20P planetary gearbox models
    * Add SEO metadata to 8P planetary gearbox
    * Add SEO metadata to 10P planetary gearbox
    * Add SEO metadata to 12P planetary gearbox
    * Add SEO metadata to 14P planetary gearbox
    * Add SEO metadata to 16P planetary gearbox
    * Add SEO metadata to 20P and fix contact email
2026-09-17 SEO: add metadata to 22P–42P planetary gearbox models
    * Add SEO metadata and fix contact email for 22P
    * Add SEO metadata and fix contact email for 24P
    * Add SEO metadata and fix contact email for 28P
    * Add SEO metadata and fix contact email for 32P
    * Add SEO metadata and fix contact email for 36P
    * Add SEO metadata and fix contact email for 42P
    * Fix contact email on 8–42 mm planetary gearbox series page
    * Set 32P public backlash value to 1.2 degrees
2026-09-20 SEO: strengthen index migration and crawl signals
    * SEO: add robots.txt for project sitemap
    * SEO: improve custom joint redirect target
    * SEO: validate robots and core redirects
    * SEO: strengthen robot joint internal links
    * SEO: strengthen company manufacturing landing page
    * CI: validate SEO site output in pull requests
2026-09-20 SEO: map core robot joint search intent to canonical pages
    * SEO: align robot joint page with core search intent
    * SEO: align selection guide with actuator and gearbox intent
2026-09-20 SEO: strengthen 8-42 mm planetary gearbox cluster
    * SEO: strengthen 8-42 mm planetary gearbox hub
    * SEO: strengthen planetary gearbox category inquiry path
    * SEO: connect 8P to planetary gearbox cluster
    * SEO: connect 10P to planetary gearbox cluster
    * SEO: connect 12P to planetary gearbox cluster
    * SEO: connect 14P to planetary gearbox cluster
    * SEO: connect 16P to planetary gearbox cluster
    * SEO: connect 20P to planetary gearbox cluster
    * SEO: connect 22P to planetary gearbox cluster
    * SEO: connect 24P to planetary gearbox cluster
    * SEO: connect 28P to planetary gearbox cluster
    * SEO: connect 32P to planetary gearbox cluster
    * SEO: connect 36P to planetary gearbox cluster
    * SE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
2026-09-20 SEO: strengthen micro gear motor and flat BLDC categories
    * SEO: strengthen micro gear motor category
    * SEO: strengthen flat BLDC and joint drive category
2026-09-20 SEO: strengthen hub gear motor and AGV AMR cluster
    * SEO: strengthen hub gear motor family page
    * SEO: strengthen SG2877 AGV AMR landing page
    * SEO: strengthen SG2878 AGV AMR landing page
    * SEO: define AGV AMR application search intent
2026-09-20 SEO: separate industrial automation and conveyor search intent
    * SEO: define industrial automation application intent
    * SEO: define industrial automation application intent
    * SEO: define industrial automation application intent
2026-09-20 SEO: separate robot gripper and micro robotics intent
    * SEO: define gripper and micro robotics intent
    * SEO: define gripper and micro robotics intent
2026-09-20 SEO: close robotics mainline navigation
    * SEO: add main robot application navigation
    * SEO: connect selection guide to core robot applications
    * SEO: close quadruped robot joint inquiry path
    * SEO: close robotic arm inquiry path
2026-09-22 Analytics: add GA4 debug mode switch
2026-09-28 Publish SG-6010C Engineering Resources v1.0
    Publish approved SG-6010C public engineering resources while retaining the existing canonical product URL and request-only integration documentation.
    [SG-6010C_Public_Simplified_STEP_v1.0.step]
2026-09-28 Publish CPM-80-25 Engineering Resources v1.0
    Publish approved CPM-80-25 design-in resources, configuration-specific dimensions, simplified CAD and measured performance data while retaining the existing canonical URL.
    [CPM-80-25_Public_Simplified_STEP_v1.0_Integrated_Driver.step, CPM-80-25_Public_Simplified_STEP_v1.0_No_Driver.step]
2026-09-28 Add planetary gearbox supply configuration
    Clarify across the planetary gearbox family that SigGear can supply gearbox only, motor only, or a matched motor + gearbox assembly.
2026-09-28 Publish 32P Engineering Resources v1.0
    Publish approved 32P design-in resources, 4-stage simplified CAD, mechanical interface data and motor integration guidance while retaining the existing canonical product URL.
    [32P_Public_Simplified_STEP_v1.0_4-Stage.step]
2026-09-28 Build Phase 1 Engineering Discovery and Design-In Path
    Add the Engineering Center, sample validation workflow and Design-In checklist, reduce inquiry friction, surface released Engineering Packs, and align public documentation policies without changing existing product URLs.
2026-09-28 01A-002 Add Custom Planetary Gearbox Engineering
    Publish the custom planetary gearbox engineering page, connect planetary reference products to custom project review, and align public technical-file wording without changing existing product specifications.
2026-09-28 01A-004 Add Motor + Gearbox Integration Engineering
    Publish the motor + gearbox integration engineering page, connect motor and gearbox reference resources to the custom project path, and preserve product-specific technical boundaries without changing existing specifications.
2026-09-28 01A-005 Add Custom Robot Joint & Compact Actuator Development
    Publish the custom robot joint and compact actuator development page, connect robot reference products and selection resources to the custom engineering path, and preserve configuration-specific technical boundaries.
2026-09-28 01A-006 Add Prototype to Design-In and Production Path
    Publish the prototype-to-production engineering path, connect sample validation and Design-In resources, and preserve controlled configuration and production-release boundaries.
2026-09-28 01B-001 Add Engineering Search Intent Architecture
    Add the controlled search-intent map and align high-priority page metadata with engineer terminology such as gearbox, gearhead, gearmotor, cycloidal reducer and robot joint actuator without changing URLs or product specifications.
2026-09-28 01B-002 Align legacy custom robot actuator redirect
    Redirect the legacy custom robot actuator URL to the new custom engineering page that matches its historical Google search intent while preserving the existing URL and redirect relationship.
2026-09-28 01B-003 Align GSC queries with robot joint landing pages
    Use Windsor.ai GSC query signals to improve the existing humanoid, robot-joint selection, and custom actuator pages without adding duplicate landing pages or changing product specifications.
2026-09-28 01B-004 Optimize high-opportunity product landing pages
    Use Windsor.ai GSC page signals to strengthen SG-6010C, SG-6010D and CPM-80-25 as engineering landing pages without changing URLs, specifications or current canonical structure.
2026-10-06 01C-006 Confirm SG-6010D driver platform and CPM-100-25 dual-encoder variant
    * 01C-006: add SG-6010D driver and communication reference
    * 01C-006: add CPM-100-25 dual-encoder variant reference
    * 01C-006: confirm SG-6010D driver platform and protocols
    * 01C-006: reconcile SG-6010D confirmed driver capabilities
    * 01C-006: update SG-6010D structured driver configuration
    * 01C-006: add CPM-100-25 dual-encoder controlled variant
    * 01C-006: distinguish CPM-100-25 dual-encoder variant
    * 01C-006: document CPM-100-25 dual-encoder mechanical envelope
    * 01C-006: record CPM-100-25 dual-encoder variant
    * 01C-006: expose SG-6010D confirmed driver variant fields
    * 01C-006: align SG-6010D variant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
2026-10-06 01C-008 Add 8P-42P planetary gearbox datasheet library
    * 01C-008: add 8P public datasheet
    * 01C-008: add 10P public datasheet
    * 01C-008: add 12P public datasheet
    * 01C-008: add 14P public datasheet
    * 01C-008: add 16P public datasheet
    * 01C-008: add 20P public datasheet
    * 01C-008: add 22P public datasheet
    * 01C-008: add 24P public datasheet
    * 01C-008: add 28P public datasheet
    * 01C-008: add 36P public datasheet
    * 01C-008: add 42P public datasheet
    * 01C-008: link 8P datasheet
    * 01C-008: link 10P datasheet
    * 01C-008: link 12P datasheet
    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
2026-10-06 01C-009 Normalize 8P-42P planetary source-control metadata
    * 01C-009: record 8P controlled drawing and CAD source status
    * 01C-009: record 10P controlled drawing and CAD source status
    * 01C-009: record 12P controlled drawing and CAD source status
    * 01C-009: record 14P controlled drawing and CAD source status
    * 01C-009: record 16P controlled drawing and CAD source status
    * 01C-009: record 20P controlled drawing and CAD source status
    * 01C-009: record 22P controlled drawing and CAD source status
    * 01C-009: record 24P controlled drawing and CAD source status
    * 01C-009: record 28P controlled drawing and CAD source status
    * 01C-009: record 32P controlled drawing and CAD source status
    *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
2026-10-06 01C-010 Add 8P-42P planetary gearbox selection matrix
    * 01C-010: add 8P-42P engineering selection matrix
    * 01C-010: update planetary index for full engineering resource library
2026-10-06 Add official social channel linking
    * Add official social links to site footer
    * Add official social channels to contact page
    * Track outbound social channel clicks in GA4
    * Add SigGear organization sameAs structured data
2026-10-06 Track UTM attribution for social traffic
2026-10-07 Add 32P public CAD Design-In Pack
2026-10-07 Link 32P product page to public CAD Design-In Pack
2026-10-07 Add 42P planetary gearbox Design-In Pack
2026-10-07 Add 42P motor integration guide
2026-10-07 Link 42P motor integration resources
2026-10-07 Add motor integration to 42P Design-In Pack
2026-10-07 Add 42P motor integration guide to navigation
2026-10-07 Record 42P motor integration guide
2026-10-07 Clarify gearbox-only and motor matching options for 8P
2026-10-07 Clarify gearbox-only and motor matching options for 10P
2026-10-07 Clarify gearbox-only and motor matching options for 12P
2026-10-07 Clarify gearbox-only and motor matching options for 14P
2026-10-07 Clarify gearbox-only and motor matching options for 16P
2026-10-07 Clarify gearbox-only and motor matching options for 20P
2026-10-07 Clarify gearbox-only and motor matching options for 22P
2026-10-07 Clarify gearbox-only and motor matching options for 24P
2026-10-07 Clarify gearbox-only and motor matching options for 28P
2026-10-07 Clarify gearbox-only and motor matching options for 32P
2026-10-07 Clarify gearbox-only and motor matching options for 36P
2026-10-07 Clarify gearbox-only and motor matching options for 42P
2026-10-08 Add 10P public simplified 4-stage STEP
    [10P_Public_Simplified_STEP_v1.0_4-Stage.step]
2026-10-08 Fix complete 10P public simplified 4-stage STEP
    [10P_Public_Simplified_STEP_v1.0_4-Stage.step]
2026-10-08 Add 8P public simplified 4-stage STEP
    [8P_Public_Simplified_STEP_v1.0_4-Stage.step]
2026-10-08 Add 12P public simplified 4-stage STEP
    [12P_Public_Simplified_STEP_v1.0_4-Stage.step]
2026-10-08 Add 14P public simplified 4-stage STEP
    [14P_Public_Simplified_STEP_v1.0_4-Stage.step]
2026-10-08 Add 16P public simplified 4-stage STEP
    [16P_Public_Simplified_STEP_v1.0_4-Stage.step]
2026-10-08 Add 20P public simplified 4-stage STEP
    [20P_Public_Simplified_STEP_v1.0_4-Stage.step]
2026-10-08 Add 22P public simplified 4-stage STEP
    [22P_Public_Simplified_STEP_v1.0_4-Stage.step]
2026-10-08 Add 24P public simplified 4-stage STEP
    [24P_Public_Simplified_STEP_v1.0_4-Stage.step]
2026-10-08 Add 28P public simplified 4-stage STEP
    [28P_Public_Simplified_STEP_v1.0_4-Stage.step]
2026-10-08 Add 36P public simplified 4-stage STEP
    [36P_Public_Simplified_STEP_v1.0_4-Stage.step]
2026-10-08 Add 42P public simplified 4-stage STEP
    [42P_Public_Simplified_STEP_v1.0_4-Stage.step]
2026-10-08 Add 8P-42P public CAD release v1.0 page
2026-10-08 Add planetary public CAD release to navigation
2026-10-08 Publish 42P STEP in motor integration guide
2026-10-08 Update Engineering Center for full planetary public CAD release
2026-10-08 Update 8P-42P series page for public CAD release
2026-10-08 Align 42P public CAD status in planetary resource library
2026-10-09 01E-001 Add SG-6010HB exoskeleton joint actuator engineering pack
    * 01E-001: add SG-6010HB canonical product page
    * 01E-001: add SG-6010HB public datasheet
    * 01E-001: add SG-6010HB structured product record
    * 01E-001: add SG-6010HB to robot joint actuator index
    * 01E-001: add SG-6010HB as published exoskeleton reference platform
    * 01E-001: add SG-6010HB to navigation
    * 01E-001: add SG-6010HB to product model index
    * 01E-001: add SG-6010HB sales usage boundary
    * 01E-001: add SG-6010HB engineering resource entry
    * 01E-001: add SG-6010HB to public resource request path
2026-10-09 01E-002 Add SG-6010HB controlled mechanical interface and CAD boundary
    * 01E-002: add SG-6010HB controlled mechanical interface
    * 01E-002: connect SG-6010HB product page to controlled mechanical interface
    * 01E-002: reconcile SG-6010HB datasheet with controlled drawing
    * 01E-002: record SG-6010HB controlled drawing and CAD status
    * 01E-002: add SG-6010HB mechanical interface to navigation
    * 01E-002: surface SG-6010HB mechanical interface in Engineering Center
2026-10-09 01E-004 Add SG-6010HB driver, encoder and communication integration guide
    * 01E-004: add SG-6010HB driver and communication reference
    * 01E-004: document confirmed SG-6010HB driver-equipped configuration
    * 01E-004: add confirmed driver-equipped integration to SG-6010HB datasheet
    * 01E-004: update SG-6010HB integration boundary in master data
    * 01E-004: add SG-6010HB driver guide to navigation
    * 01E-004: surface SG-6010HB driver and communication guide
    * 01E-004: align exoskeleton application page with confirmed SG-6010HB driver configuration
2026-10-10 Align SigGear miniature planetary gearbox positioning and SEO entry points
2026-10-10 Improve five miniature planetary Design-In landing pages and inquiry route
2026-10-10 Publish planetary gearbox selection and pruning shears engineering guides
2026-10-10 Connect pruning and curtain guides to planetary SEO landing pages
2026-10-10 Connect existing robot engineering traffic to miniature gearbox design-in selection
2026-10-10 Track simplified STEP CAD download link clicks in consent-gated GA4
2026-10-10 01F-001 Align site structure with miniature planetary gearbox strategy
    * 01F-001: add smart toilet and bidet planetary gearmotor application guide
    * 01F-001: make applications overview planetary-first
    * 01F-001: promote dexterous-hand planetary gearbox positioning
    * 01F-001: feature current planetary application priorities on homepage
    * 01F-001: add priority planetary applications to selection guide
    * 01F-001: link consumer appliance guide to smart-toilet application
    * 01F-001: reorganize applications navigation around planetary focus
    * 01F-001: align README application focus with planetary strategy
    * 01F-001: normalize applications navigation labels
    * 01F-001: distinguish featured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
2026-10-10 Add gearbox-only and motor-matched inquiry paths
2026-10-10 Split motor integration inquiry into two paths
2026-10-10 Add 8P gearbox-only and motor-matched inquiry CTAs
2026-10-10 Add 10P gearbox-only and motor-matched inquiry CTAs
2026-10-10 Add 12P gearbox-only and motor-matched inquiry CTAs
2026-10-10 Add 14P gearbox-only and motor-matched inquiry CTAs
2026-10-10 Add 16P gearbox-only and motor-matched inquiry CTAs
2026-10-10 Add 20P gearbox-only and motor-matched inquiry CTAs
2026-10-10 Add 22P gearbox-only and motor-matched inquiry CTAs
2026-10-10 Add 24P gearbox-only and motor-matched inquiry CTAs
2026-10-10 Add 28P gearbox-only and motor-matched inquiry CTAs
2026-10-10 Add 32P gearbox-only and motor-matched inquiry CTAs
2026-10-10 Add 36P gearbox-only and motor-matched inquiry CTAs
2026-10-10 Add 42P gearbox-only and motor-matched inquiry CTAs
2026-10-10 Align contact inquiry flow with planetary gearbox strategy
2026-10-10 Link priority OEM applications from planetary landing pages
2026-10-10 Track planetary inquiry and priority application conversion events
2026-10-10 Add structured ItemList for 8-42 mm planetary series
2026-10-10 Differentiate planetary product index from 8-42 mm series landing page
2026-10-10 Document external CAD catalog source-of-truth policy
2026-10-10 Validate external planetary CAD catalog references
2026-10-10 Add TraceParts Smart-Publishing mapping policy
2026-10-10 Document TraceParts submission readiness and boundaries
2026-10-10 Add TraceParts Smart-Publishing field exporter
2026-10-10 Test TraceParts Smart-Publishing mapping in CI
2026-10-12 Mark official SigGear logo ready for TraceParts
2026-10-12 Add real motor gearbox evidence to integration guide
2026-10-12 Add real 8P-42P planetary gearbox family image
2026-10-12 Show real 8P-42P gearbox family on series page
2026-10-12 Link verified public TraceParts catalog from planetary gearbox resources
2026-10-12 Surface verified TraceParts catalog in gearbox indexes and track outbound CAD referrals
2026-10-13 01F-003 | Add inquiry conversion layer for 8P-42P
    Add model-aware project brief routing, structured email inquiry form, and GA4 conversion tracking for the 8P-42P planetary gearbox series.
2026-10-13 01F-003B | Add contextual inquiry routing from CAD and application pages
    Connect CAD resources and priority OEM application pages to model/application-prefilled Engineering Project Brief flows with normalized GA4 context tracking.
2026-10-13 01F-004 | Add inquiry qualification and measurement layer
    Add normalized inquiry measurement, project-stage capture, privacy-safe form completeness metrics, and a public-safe qualification taxonomy.
2026-10-13 01F-006 | Add UTM and source capture layer
    Add canonical UTM taxonomy, tracked TraceParts/3Dfindit document URLs, CI validation, 3Dfindit attribution support, and update the planetary CAD search-intent rule to the current 8P-42P public STEP library.
2026-10-13 01F-009 | Add weekly attribution review loop
    Add the recurring Search Console, GA4, Pipeline and Stage History weekly attribution review operating loop.
2026-10-13 01G-001 | Build planetary demand map and strengthen priority application paths
    Add the planetary demand-capture priority map, align application SEO priorities, and strengthen Smart Lock, Pump/Valve, Camera Module and Coffee equipment inquiry paths without changing existing URLs.
2026-10-13 01G-002 | Build planetary internal demand mesh
    Expand internal links from the planetary series, product index and selection guide to the current priority OEM application paths.
2026-10-13 01G-005 Strengthen motor plus planetary gearbox search intent
    * 01G-005: strengthen motor with planetary gearbox search intent
    * 01G-005: connect planetary product index to motor integration
    * 01G-005: add motor plus planetary gearbox path to series landing
    * 01G-005: connect selection guide to motor plus gearbox integration
    * 01G-005: expose motor planetary integration on homepage
    * 01G-005: assign motor planetary query family to integration canonical
    * 01G-005: add motor planetary system intent to demand map
2026-10-13 01G-006 Strengthen planetary manufacturer and supplier discovery
    * 01G-006: strengthen planetary manufacturer and supplier evaluation intent
    * 01G-006: separate custom planetary intent from standard product discovery
    * 01G-006: map supplier discovery to the 8-42mm series canonical
    * 01G-006: add planetary supplier discovery path
    * 01G-006: connect homepage supplier qualification to planetary series
2026-10-13 01G-004 | Expand planetary engineering search discovery
    Map existing-motor and BLDC matching, custom shaft/mounting/ratio, STEP/CAD and OEM manufacturer/supplier search combinations to existing canonical pages without creating duplicate URLs.
2026-10-13 01G-005 | Seed planetary datasheet and dimensions search intent
    Lead all 12 planetary Datasheets and Mechanical Interface pages with physical-diameter engineering search intent, align the 8–42 mm resource library, and add the exact engineering-resource search map.
2026-10-13 01G-006 | Expand 8P-42P motor matching Design-In workflow
    Add model-aware existing-motor Design-In routing across 8P-42P, collect shaft and mounting inputs in the Project Brief, preserve 32P/42P as the only dedicated public motor-integration guides, and document the public-safe motor-matching workflow.
2026-10-13 01G-007 | Add planetary ratio and stage selection layer
    Add a preliminary 8P-42P ratio/stage selector using only published Datasheet data, privacy-safe analytics, and CI validation that prevents selector data from drifting from the source tables.
2026-10-13 01G-008 | Add torque and packaging candidate comparison
    Upgrade the planetary ratio-stage selector with candidate-frame comparison, transparent exclusion reasons, optional ratio-difference filtering, privacy-safe analytics, and JavaScript syntax validation.
2026-10-13 01G-009 | Hand off validated selection results to Project Brief
    Carry only public candidate model/stage/ratio from the planetary selector into the Project Brief, revalidate the candidate against current published data before email handoff, preserve engineering-input privacy, and add syntax validation for the selector, inquiry form, and analytics scripts.
2026-10-13 01G-010 | Add stage-specific CAD boundary and candidate Design-In Pack
    Add a validated stage-aware Candidate Design-In Pack, clarify the 4-stage-only public STEP boundary across 8P-42P, preserve dedicated 32P/42P packs, and enforce the CAD-stage boundary in CI.
2026-10-13 01G-011 | Add controlled CAD request readiness layer
    Add five-gate CAD review readiness to the Project Brief, collect output interface/duty/shaft-load context, prefill CAD review from Candidate and dedicated Design-In Packs, preserve privacy-safe analytics, and enforce the readiness wiring in CI.
2026-10-13 01G-012 | Carry planetary candidates into sample validation
    Connect validated 8P-42P candidates to the existing Sample Validation Workflow, add structured five-step customer-side validation, preserve Design-In approval boundaries, keep detailed test context out of GA4, and validate the handoff in CI.
2026-10-13 01G-013 | Add Design-In review decision layer
    Route validated planetary sample outcomes into Continue Evaluation, Engineering Revision Required, or Design-In Review Ready while keeping Design Frozen and Pilot Preparation Ready as human-confirmed milestones only.
2026-10-13 01G-014 | Add pilot preparation and change-control layer
    Add a structured pilot-preparation review after Design-In Review Ready, require user-reported human Design Freeze confirmation, organize drawing/BOM revisions, pilot quantity/schedule, inspection, packaging, change control and acceptance planning, and preserve Pilot Preparation Ready and Production Release as manual-only milestones.
2026-10-13 01G-018 | Add post-deployment planetary search review framework
    Add an append-only planetary search review protocol and link it to weekly attribution review, preserving exact-query versus page-signal separation and evidence thresholds before SEO changes.
2026-10-14 Align planetary size taxonomy and TraceParts discovery links
    * Align 20P model label to Miniature taxonomy
    * Align 22P model label to Miniature taxonomy
    * Align 24P model label to Miniature taxonomy
    * Align 28P model label to Miniature taxonomy
    * Align 32P model label to Miniature taxonomy
    * Align 36P model label to Compact taxonomy
    * Align 42P model label to Compact taxonomy
    * Add clearly labeled TraceParts catalog discovery to 8P page
    * Add clearly labeled TraceParts catalog discovery to 10P page
    * Add clearly labeled TraceParts catalog discovery to 12P page
    * Add clearly labeled TraceParts catalog discovery to 14P page
    * Add clearly labeled TraceParts catalog discovery to 16P p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
2026-10-14 Document live TraceParts supplier index and 12-model validation status
    * Record evidence-scoped TraceParts English discovery and 12-model CAD QA statuses
    * Clarify verified English TraceParts supplier indexing versus CAD downloads
    * Clarify verified English TraceParts supplier indexing versus CAD downloads
    * Clarify verified English TraceParts supplier indexing versus CAD downloads
    * Document TraceParts English supplier listing evidence without overstating model downloads
    * Update platform readiness with deployed links and bounded TraceParts 12-model QA status
2026-10-14 Record TraceParts 8P / 42P STEP failures after operator-selected format
    * Record user-tested English TraceParts 10/12 CAD results and 8P/42P failures
    * Prioritize 8P and 42P TraceParts English CAD download incident
    * Record user-verified TraceParts English STEP results: 10 successful, 8P and 42P failed after STEP selection
    * Confirm STEP was selected for failed TraceParts 8P and 42P download attempts
    * Escalate confirmed 8P and 42P STEP failures after format selection
2026-10-14 Confirm all 12 SigGear TraceParts international STEP downloads
    * Confirm all twelve TraceParts English STEP downloads after 8P and 42P successful retry
    * Advance TraceParts readiness to 12 of 12 English STEP downloads confirmed by operator
    * Update TraceParts engineering pages to reflect all 12 English STEP downloads confirmed
    * Update TraceParts engineering pages to reflect all 12 English STEP downloads confirmed
    * Update TraceParts engineering pages to reflect all 12 English STEP downloads confirmed
    * Update TraceParts engineering pages to reflect all 12 English STEP downloads confirmed
    * Reflect confirmed TraceParts English STEP download for 8P
    * Reflect confirmed TraceParts Englis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
2026-10-14 Add English TraceParts discovery and planetary publishing handoff
    * Add TraceParts English supplier discovery to 8P product page
    * Add TraceParts English supplier discovery to 10P product page
    * Add TraceParts English supplier discovery to 12P product page
    * Add TraceParts English supplier discovery to 14P product page
    * Add TraceParts English supplier discovery to 16P product page
    * Add TraceParts English supplier discovery to 20P product page
    * Add TraceParts English supplier discovery to 22P product page
    * Add TraceParts English supplier discovery to 24P product page
    * Add TraceParts English supplier discovery to 28P product page
    * Add TraceParts English supplier discovery to 32P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
2026-10-14 Connect 12 planetary gearboxes to exact TraceParts English CAD pages
    * Record 12 operator-supplied TraceParts English model URLs and product IDs
    * Link 8P product page directly to verified TraceParts English catalog record
    * Link 10P product page directly to verified TraceParts English catalog record
    * Link 12P product page directly to verified TraceParts English catalog record
    * Link 14P product page directly to verified TraceParts English catalog record
    * Link 16P to operator-supplied English TraceParts CAD product record
    * Link 20P to operator-supplied English TraceParts CAD product record
    * Link 22P to operator-supplied English TraceParts CAD product record
    * Link 24P to operator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
2026-10-14 Prepare TraceParts publisher update pack and GA4 referral baseline
    * Prepare TraceParts 12-model publisher correction and UTM/lead-access request
    * Record GA4 referral baseline and TraceParts lead-attribution verification gaps
    * Mark 12 deployed TraceParts links and document pending Publisher UTM/Analytics RFQ actions
    * Link TraceParts Publisher correction pack and GA4 referral QA baseline
2026-10-14 Prepare DirectIndustry exhibitor enquiry and four planetary gearbox listings
    * Prepare four engineering-grounded DirectIndustry planetary listings and tracked product links
    * Prepare official DirectIndustry exhibitor enquiry, first-wave plan and photography/quote checklist
    * Record user TraceParts submission and stage DirectIndustry first-wave onboarding launch
    * Link DirectIndustry four-product launch drafts and onboarding brief from external catalog docs
2026-10-14 Track DirectIndustry exhibitor application acknowledgment
2026-10-14 Prepare genuine planetary YouTube content and five-channel weekly report
    * Prepare genuine-footage YouTube 8-42 mm planetary series overview production pack
    * Draft OEM motor-plus-planetary-gearbox YouTube series with real-footage requirements
    * Record measured five-channel weekly acquisition baseline with real platform statuses
    * Establish reusable five-channel operating report template and evidence standards
    * Correct planetary size taxonomy and TraceParts direct-link status without changing SEO URLs
    * Correct 20P miniature photo labels without changing SEO URLs
    * Document GSC revised 32-impression count versus previous 31-impression snapshot
    * Add five-channel reporting documentati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
2026-10-14 Improve Google discovery of 8–42 mm SigGear planetary gearbox product pages
    * Clarify sitewide 8–42 mm micro/miniature/compact planetary SEO description and navigation
    * Add diameter-specific micro/miniature/compact discovery navigation to SigGear homepage
    * Make product overview clearly identify 8–42 mm OEM gearbox families and direct model links
    * Improve planetary model directory with grouped diameter links and distinct search intent
    * Align planetary manufacturer search landing with micro–compact range and genuine CAD value
    * Tighten 8P model search title and engineering snippet without repeated brand suffix
    * Tighten 10P model search title and engineering snippet without r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
2026-10-14 Replace 36P website and TraceParts images using newly supplied real product photo
    * Replace 36P recovered image with photograph supplied directly by SigGear
    * Use fresh original-photo JPG URL on 36P product page and update caption
    * Temporarily build website and TraceParts JPEGs from newly supplied authentic 36P photo
    * Regenerate 36P website and TraceParts JPGs from user supplied photo
    * Remove temporary 36P JPG generation workflow after verified export
    ---------
2026-10-14 Replace pixelated planetary family photo with truthful real-model gallery
    * Add responsive model-specific photo gallery without enlarging blurry 8–42 mm lineup
    * Replace blurred family-photo section with separate verified SigGear model photographs on series
    * Replace blurred family-photo section with separate verified SigGear model photographs on homepage
    * Change SEO/social preview from blurred lineup to checked real 36P JPG
    * Load genuine planetary product photo grid CSS on GitHub Pages
    * Reject blurry 9KB family image and assert three genuine model photos, meta and source quality
2026-10-14 Add application-led planetary gearbox OEM growth routes
    Add application families plus priority OEM Design-In routes for dexterous hands, curtains, powered fastening tools, laboratory automation, and pump/valve/dosing applications.
2026-10-14 Promote planetary gearbox selector across OEM entry pages
    Promote the existing ratio/stage selector across the homepage, 8-42 mm series, application family hub and six priority OEM application pages without changing engineering data or selector logic.
2026-10-15 Update SigGear 8P–42P continuous speed to 1,000–20,000 rpm and release engineering selector V2
    Engineering-confirmed standard continuous input-speed range 1,000–20,000 rpm. Values outside the interval route to custom feasibility review. Update all 12 product pages, Datasheets, master records, related technical copy, CI and selection behavior while preserving existing URLs.
2026-10-15 Fix SigGear online inquiry activation controls and bust cached JS/CSS
    * fix: hide inactive email fallback reliably and add unambiguous activation test indicator
    * fix: show clear activation indicator and force reliable button visibility in both modes
    * fix: force browser to load latest activation UI CSS and JavaScript after deployment
    * test: catch regression where hidden email button appears but activation controls do not
    * test: validate cache-busted online inquiry assets in generated HTML
    * ci: catch stale inquiry JS/CSS references before publish
    * test: initialize hidden owner-only activation banner to match actual HTML
2026-10-15 Record TraceParts 15 October publisher confirmation and QA checklist
    * Record vendor-reported TraceParts catalog update with independent post-publish QA checklist
    * Advance TraceParts readiness after publisher reports requested catalog updates live
    * Note TraceParts 2026-10-15 publisher update confirmation and QA boundary
    * Note TraceParts 2026-10-15 publisher update confirmation and QA boundary
2026-10-15 Improve planetary search discovery and repair selection deep links
    * Fix planetary selector deep link to published ratio-stage finder
    * Fix planetary selector deep link to published ratio-stage finder
    * Fix planetary selector deep link to published ratio-stage finder
    * Fix planetary selector deep link to published ratio-stage finder
    * Fix planetary selector deep link to published ratio-stage finder
    * Fix planetary selector deep link to published ratio-stage finder
    * Add relevant early navigation from robot engineering content to compact planetary models
    * Add relevant early navigation from robot engineering content to compact planetary models
    * Baseline Google Search Console and prio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
2026-10-15 Record public Search Central sitemap troubleshooting thread
2026-10-16 Improve canonical planetary discovery from README and engineering guides
    * Route repository visitors to live English planetary model and engineering pages
    * Prioritize live planetary selection and CAD routes in engineering navigation
    * Prioritize live planetary selection and CAD routes in engineering navigation
    * Prioritize live planetary selection and CAD routes in engineering navigation
    * Record planetary GSC baseline and canonical README discovery improvements
2026-10-16 Improve miniature planetary selector discovery and application inquiry attribution
    Retain four OEM application categories from existing guides through ratio-stage selection to online engineering request, and improve the original selector's search-facing technical content without creating duplicate pages. All CI and canonical checks pass.
2026-10-16 Record indexed planetary selector and data-based Google-to-CAD acquisition priorities
2026-10-16 Fix 22P mislabeled and duplicated technical graphics; log TraceParts UTM gap
    Remove five identical misleading promotional graphics from 22P technical sections while retaining authenticated photographs, published specs, 4-stage STEP and selector. Add CI and factual TraceParts 22P landing/attribution QA evidence.
2026-10-16 Connect SigGear commercial site identity to verified 8–42 mm technical resources
    Add company-site identity and manufacturer engineering links to existing About/README; publish internal webmaster handoff for contextual company-site links and motor vs gearbox rating correction. No new public SEO pages.
2026-10-23 SEO: expand 8–42 mm planetary gearhead industry application discovery (#218)
    * docs(seo): add OEM smart pet devices planetary gearhead application guide
    * docs(seo): connect planetary gearhead applications with product and CAD discovery
    * docs(seo): connect planetary gearhead applications with product and CAD discovery
    * docs(seo): connect planetary gearhead applications with product and CAD discovery
    * docs(seo): connect planetary gearhead applications with product and CAD discovery
2026-10-23 SEO: differentiate 12 planetary gearhead model pages and connect OEM application journeys (#219)
    * docs(seo): tailor 8P gearhead SEO, applications and CAD inquiry path
    * docs(seo): tailor 10P gearhead SEO, applications and CAD inquiry path
    * docs(seo): tailor 12P gearhead SEO, applications and CAD inquiry path
    * docs(seo): tailor 14P gearhead SEO, applications and CAD inquiry path
    * docs(seo): tailor 16P gearhead SEO, applications and CAD inquiry path
    * docs(seo): tailor 20P gearhead SEO, applications and CAD inquiry path
    * docs(seo): tailor 22P gearhead SEO, applications and CAD inquiry path
    * docs(seo): tailor 24P gearhead SEO, applications and CAD inquiry path
    * docs(seo): tailor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
2026-10-23 SEO: restore unique title and descriptions on planetary gearhead discovery hubs (#220)
    * fix(seo): preserve Gearhead hub title and description in published HTML
    * fix(seo): preserve Gearhead hub title and description in published HTML
    * fix(seo): preserve Gearhead hub title and description in published HTML
    * fix(seo): preserve Gearhead hub title and description in published HTML
    * test(seo): correctly parse line breaks in controlled hub YAML frontmatter
    * test(seo): resolve MkDocs directory index URL paths correctly
2026-10-23 SEO: strengthen pruning, curtain and dexterous-hand planetary gearhead guides (#221)
    * docs(seo): add application-intent answers and design-in pathway for electric pruning gearheads
    * docs(seo): give curtain and blind OEMs actionable gearhead torque, noise and CAD answers
    * docs(seo): connect dexterous-hand force calculations, gearhead CAD and OEM inquiry
    * docs(seo): refine high-intent application snippets for search results
    * docs(seo): refine high-intent application snippets for search results
    * docs(seo): refine high-intent application snippets for search results
    * fix(seo): retain priority OEM application title, meta description and navigation semantics
    * fix(seo): retain priorit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
